Sorin-Jayaweera/Panthalassa-Clinic-Team/review/README.md

# Review notes

Marks and comments that people made on the website. Each one is a GitHub issue; this folder is rebuilt from the
issues by `tools/build_review.py` (GitHub Action "Review notes") every time an issue changes. Do not edit these files by hand.

| File | What | Open |
|---|---|---|
| [validated.md](validated.md) | text a person has checked and confirmed | 0 |
| [under_question.md](under_question.md) | text a person doubts or wants checked | 0 |
| [comments.md](comments.md) | comments | 0 |
| [suggested_changes.md](suggested_changes.md) | wording or numbers a person wants changed | 0 |
| [resolved.md](resolved.md) | closed notes | 0 |

To add one: open https://sorin-jayaweera.github.io/Panthalassa-Clinic-Team/, press Edit, select text, choose a button, and submit
the issue that opens. To withdraw or resolve one, close its issue.
