Sorin-Jayaweera/Panthalassa-Clinic-Team/chaos_scope/BAD_ch2_contains_ch1_packets/chaos_aligned_3s2_125kSps_time_and_spectrum.png

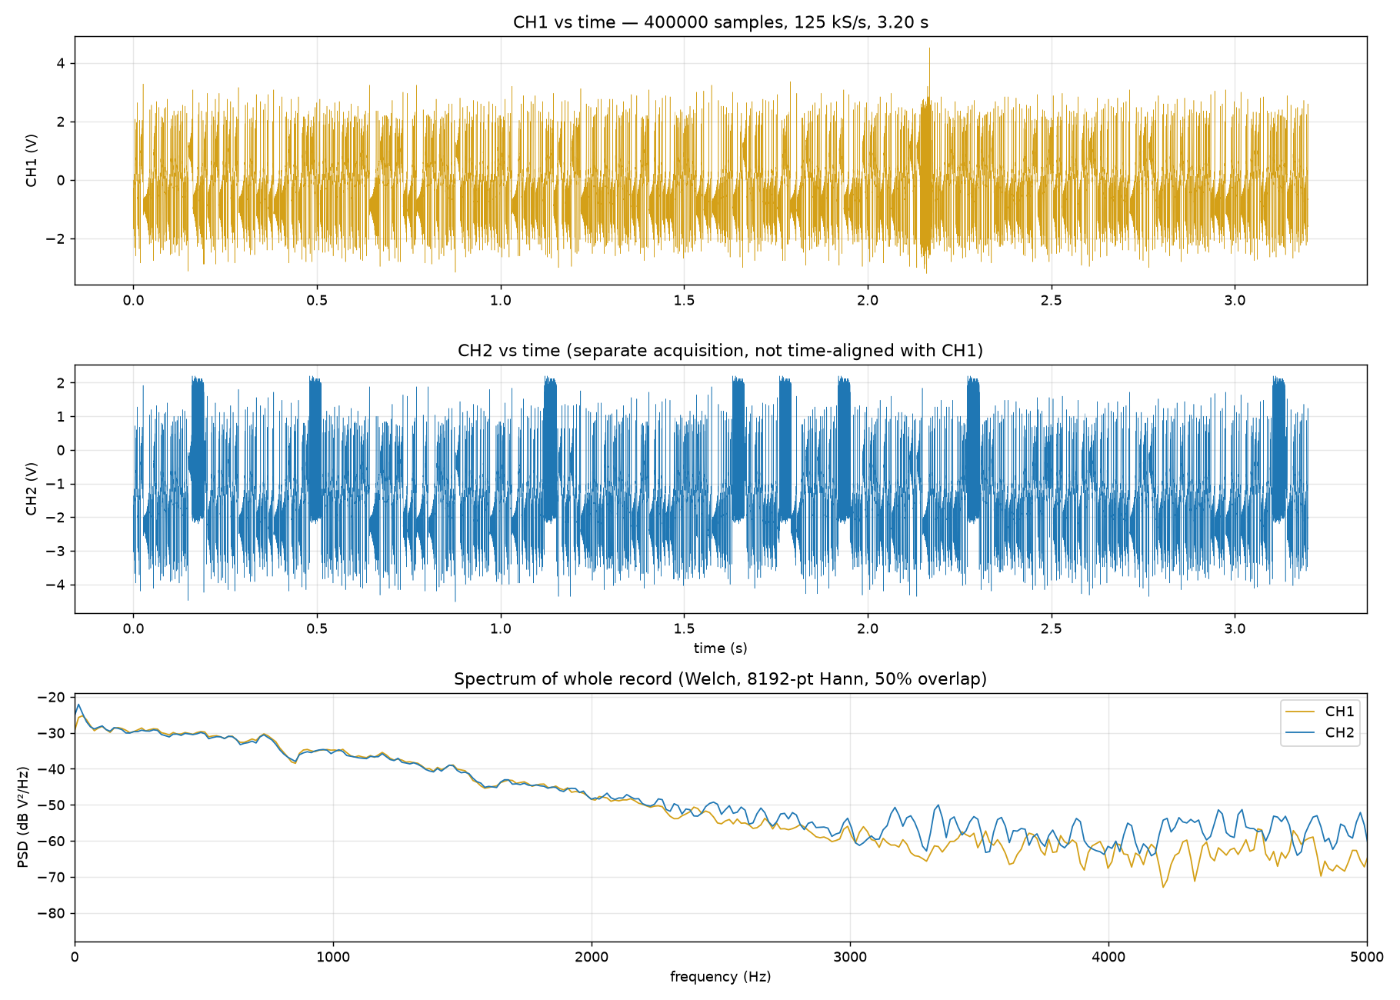
chaos_scope/BAD_ch2_contains_ch1_packets/chaos_aligned_3s2_125kSps_time_and_spectrum.png
