Sorin-Jayaweera/Panthalassa-Clinic-Team/docs/img/pluto_scale_spectra.png

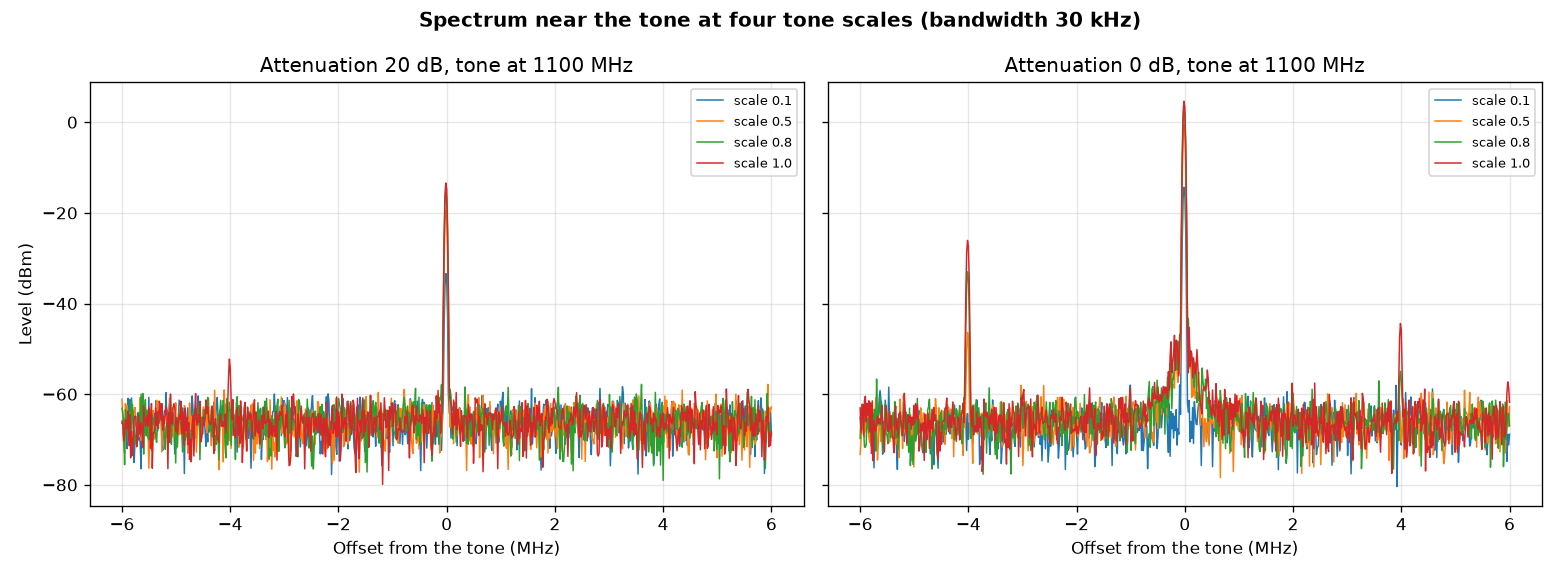
docs/img/pluto_scale_spectra.png
