Sorin-Jayaweera/Panthalassa-Clinic-Team/docs/img/pluto_spectra.png

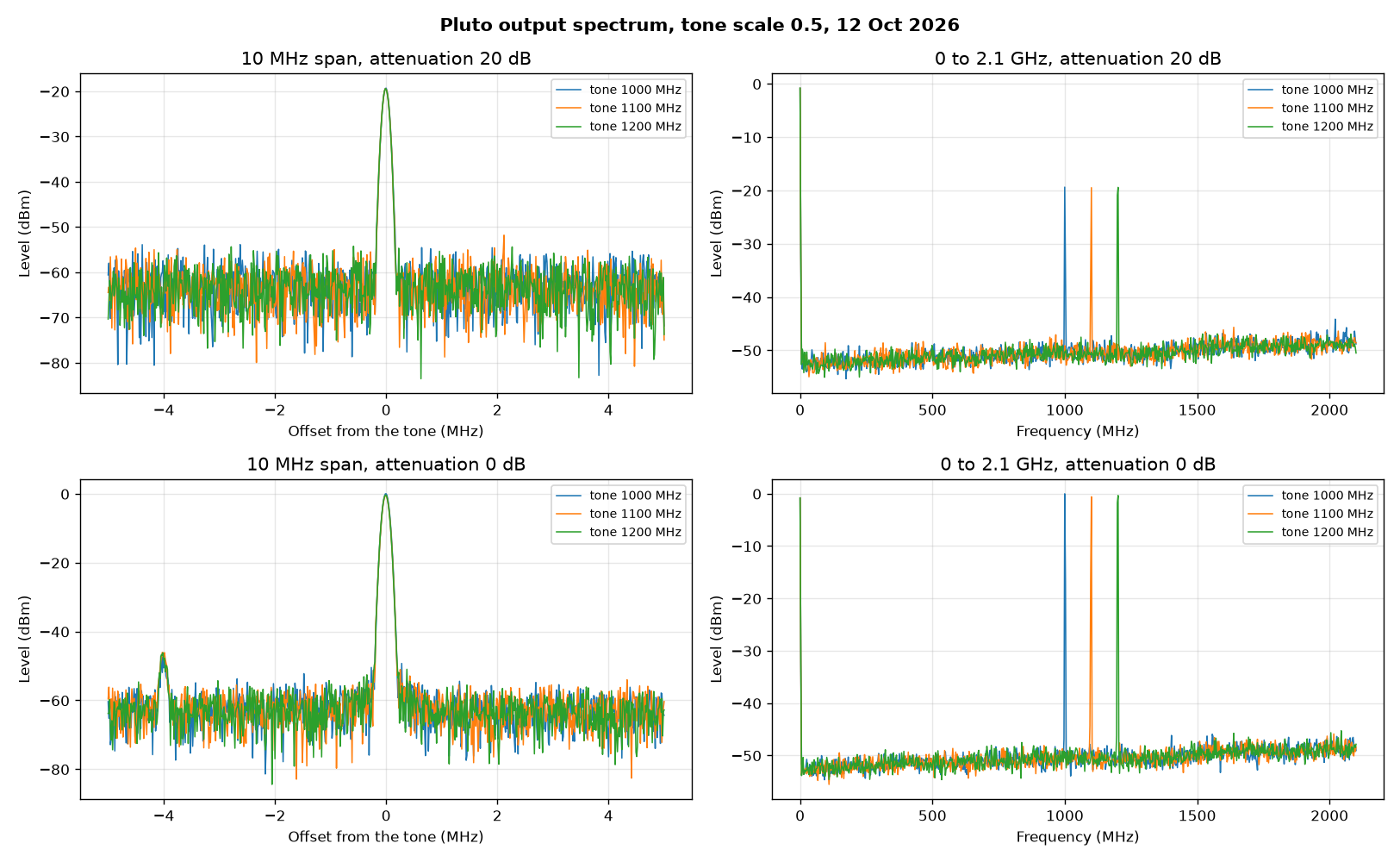
docs/img/pluto_spectra.png
