Sorin-Jayaweera/Panthalassa-Clinic-Team/docs/img/radar_train_spectrogram.png

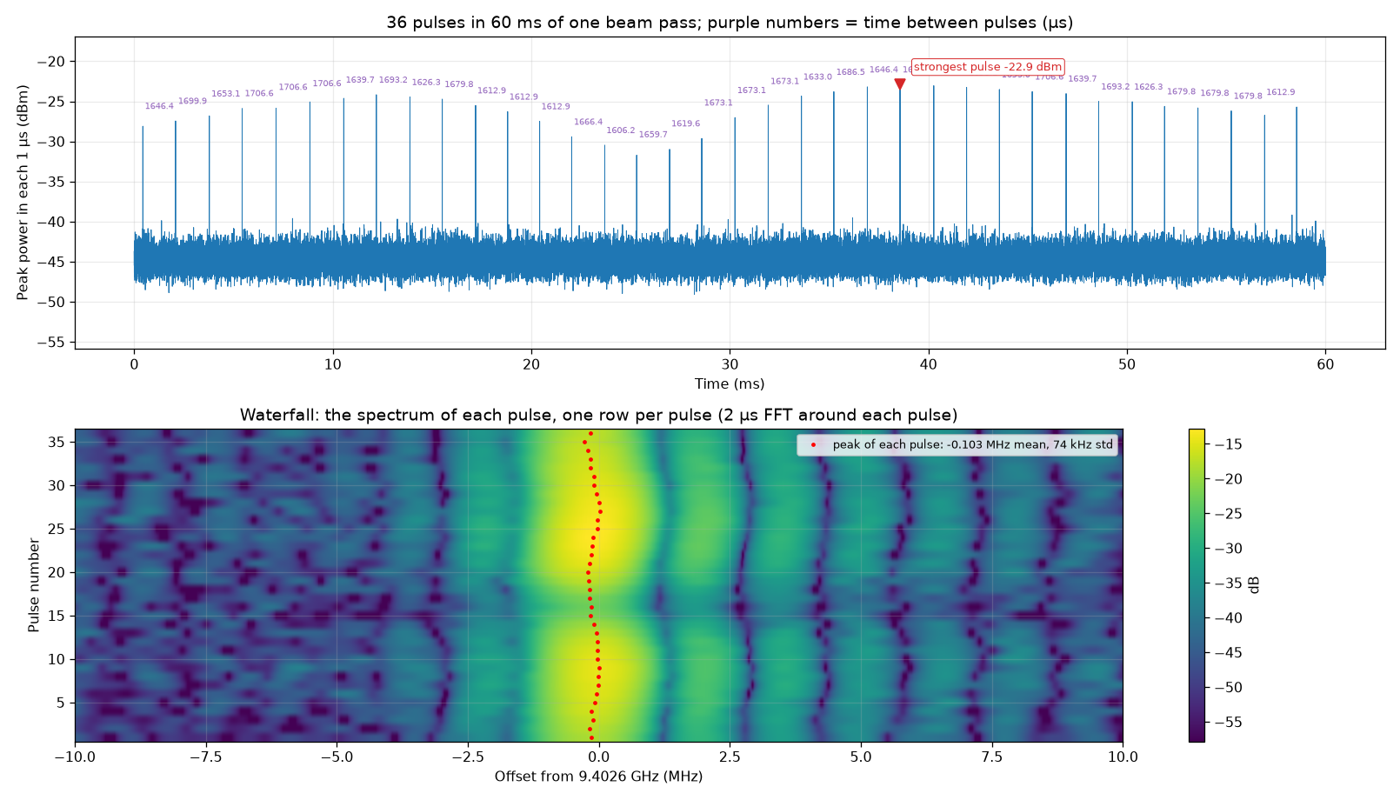
docs/img/radar_train_spectrogram.png
