Sorin-Jayaweera/Panthalassa-Clinic-Team/pluto_characterization/pluto_pulse_spectrum.png

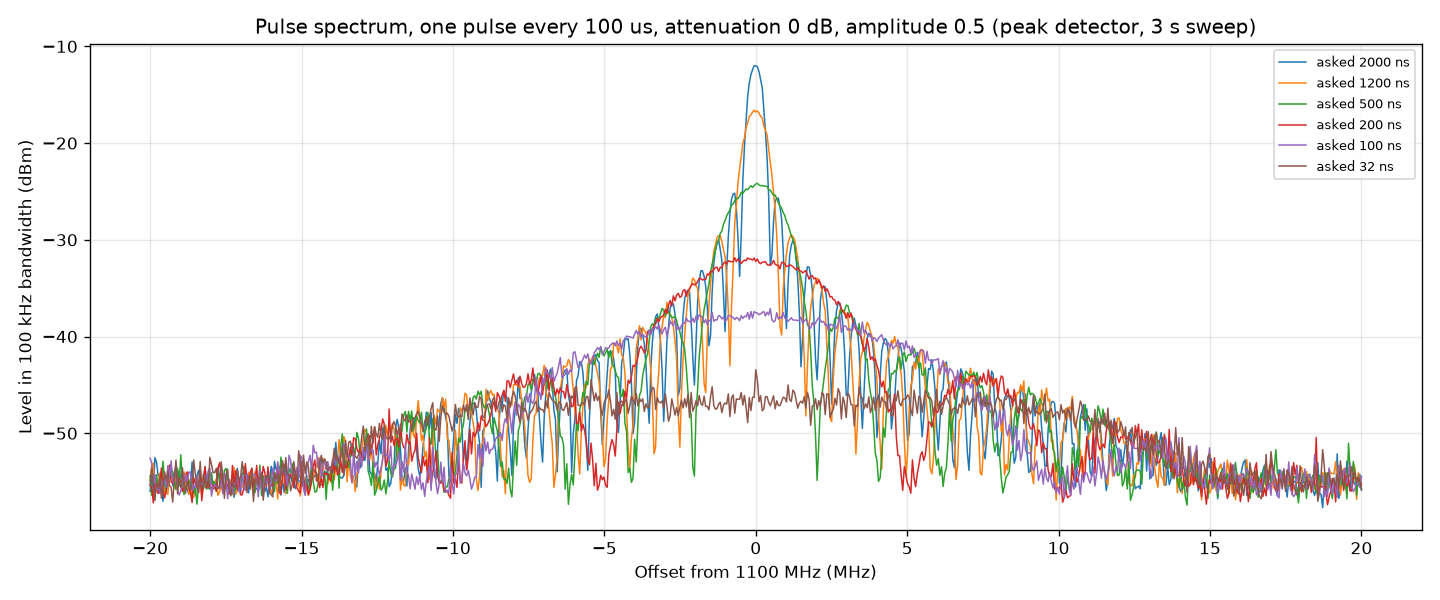
pluto_characterization/pluto_pulse_spectrum.png
