Sorin-Jayaweera/Panthalassa-Clinic-Team/radar_test/plots/pulse_spectrogram.png

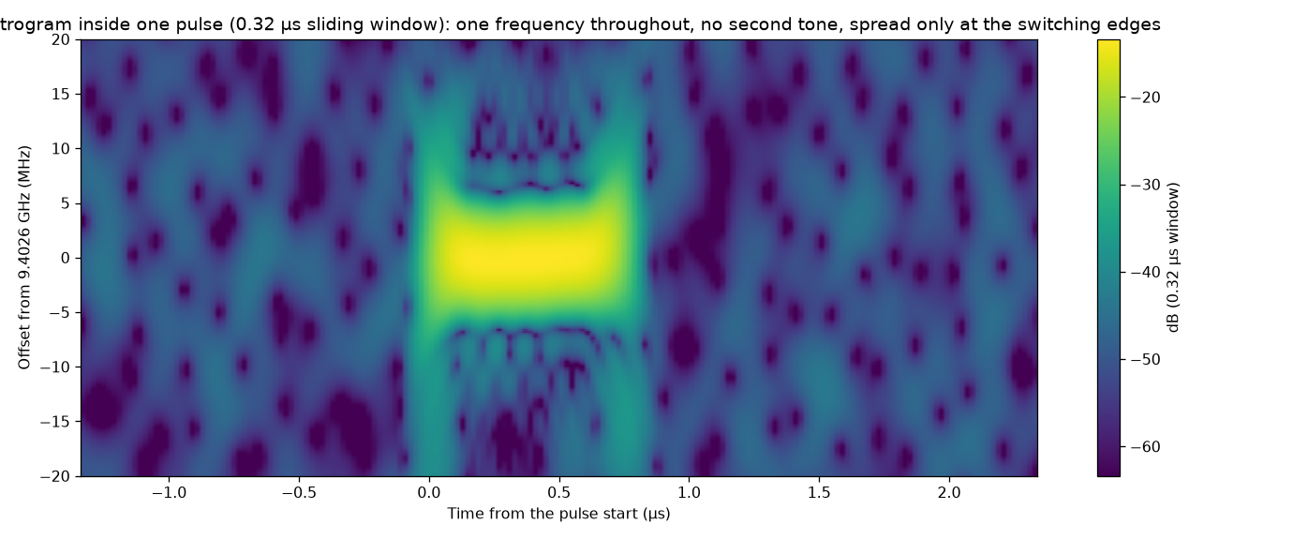
radar_test/plots/pulse_spectrogram.png
