Sorin-Jayaweera/Panthalassa-Clinic-Team/radar_test/spectra_20261025_130335/spectra.png

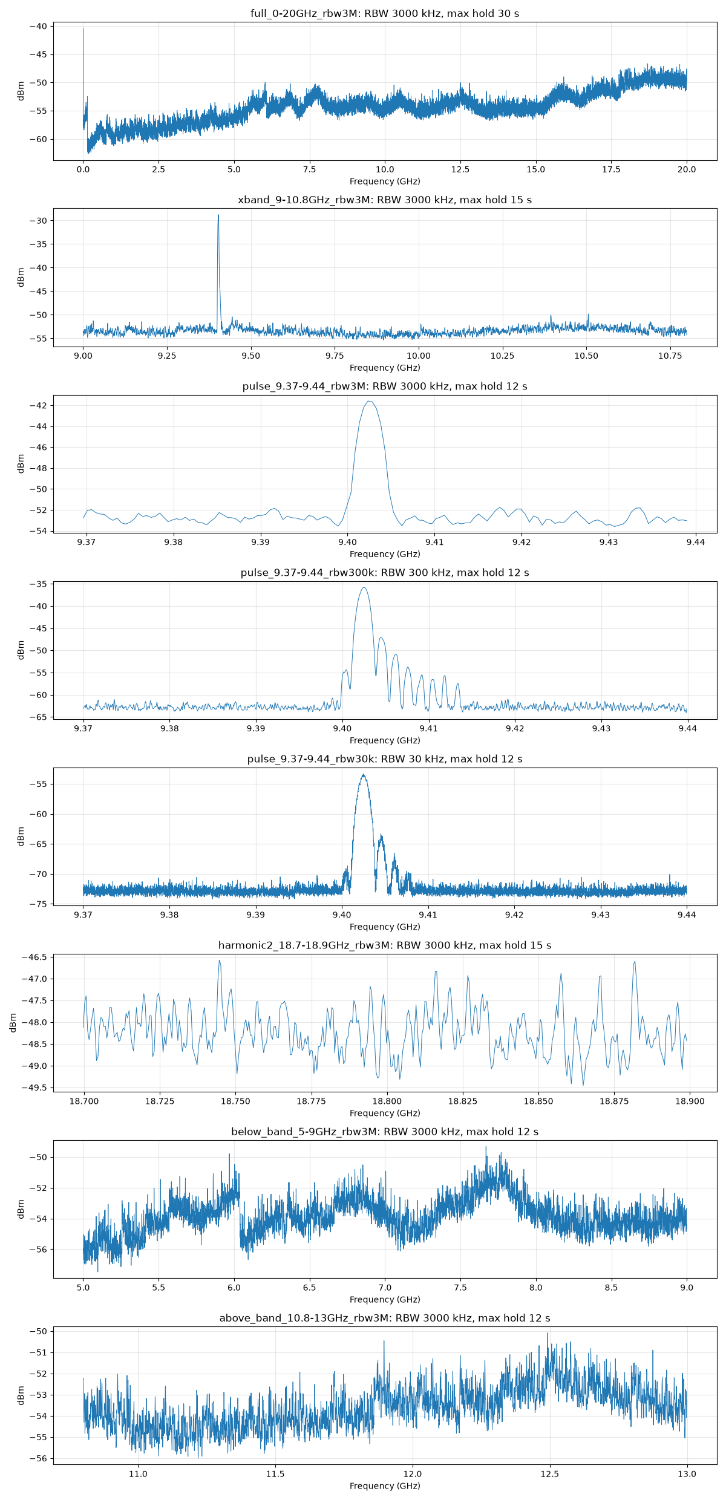
radar_test/spectra_20261025_130335/spectra.png
