Sorin-Jayaweera/Panthalassa-Clinic-Team/simulations/claude/02_delay_line_discriminator/plots/01_sweep_sim_vs_theory.png

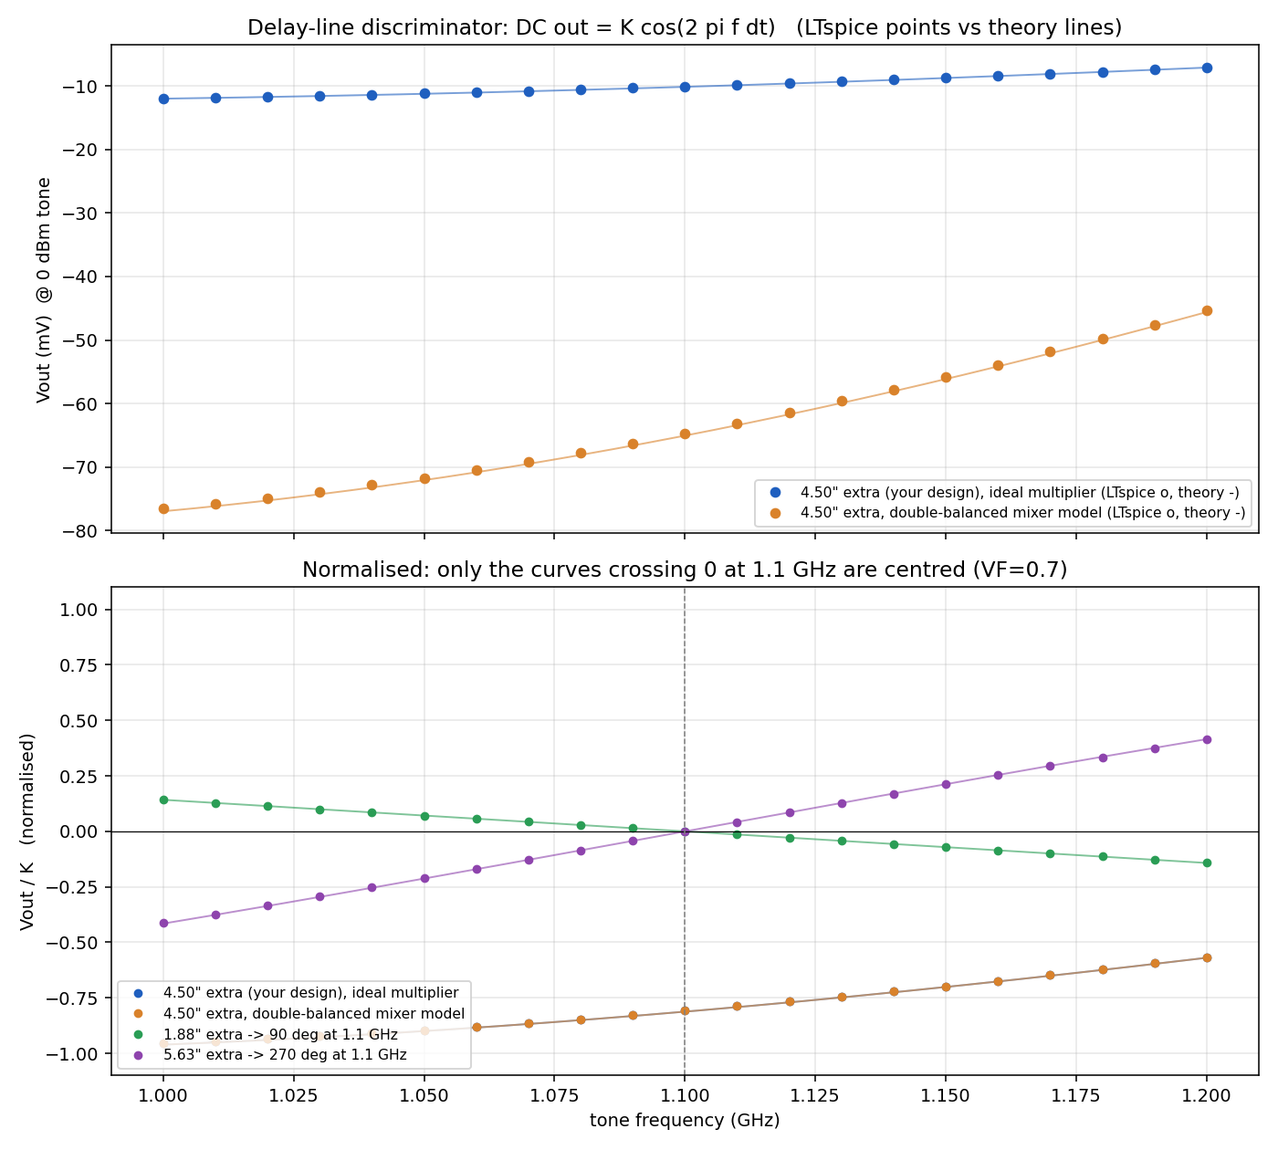
simulations/claude/02_delay_line_discriminator/plots/01_sweep_sim_vs_theory.png
