Sorin-Jayaweera/Panthalassa-Clinic-Team/simulations/claude/02_delay_line_discriminator/plots/04_design_map_cable_length.png

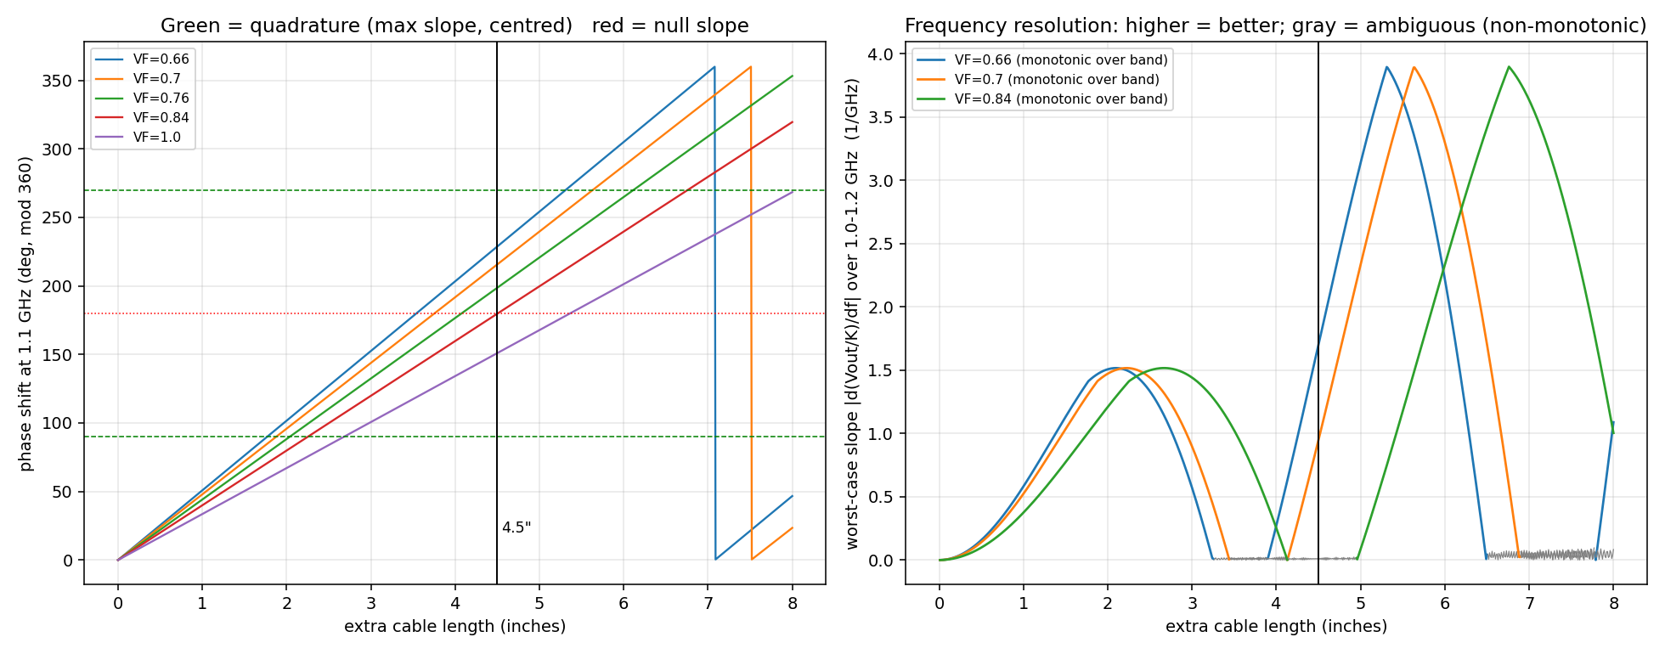
simulations/claude/02_delay_line_discriminator/plots/04_design_map_cable_length.png
