Sorin-Jayaweera/Panthalassa-Clinic-Team/documentation/JACON_component_specs.xlsx

Sheet: Components
Part number | Role | JACON block | Datasheet band | Frequency seen in JACON | Gain / loss at that frequency | Damage limit (as printed on datasheet) | Damage limit (dBm) | Damage limit (mW) | P1dB / compression (dBm) | P1dB (mW) | Notes | Datasheet page | Mini-Circuits PDF | Local PDF copy | Product page | Evidence screenshot
ZX60-5123LN+ | RX LNA | [1] RX front end | 5.5 - 12.5 GHz | 9.3 - 9.5 GHz | +22.0 dB typ (19.0 min), 5.5-12.5 GHz | RF Input Power (CW) +15 dBm | +15.00 | 31.623 | +17.0 | 50.1 | Total power dissipation 1.2 W; DC +12 V | p.3 | ZX60-5123LN+.pdf (https://www.minicircuits.com/pdfs/ZX60-5123LN%2B.pdf) | datasheets/ZX60-5123LN+.pdf | minicircuits.com (https://www.minicircuits.com/WebStore/dashboard.html?model=ZX60-5123LN%2B) | evidence/ZX60-5123LNplus_ratings_p3.png
ZX05-14LH-S+ | RX down-mixer / TX up-mixer | [1] RX mixer, [8] TX mixer | RF+LO 3.7 - 10 GHz, IF DC - 4 GHz | RF 9.3-9.5 GHz, LO 8.3 GHz, IF 1.0-1.2 GHz | conv. loss 7.72 dB typ at RF 9400 MHz (6.7 dB band typ), LO +10 dBm | RF Power 50 mW | +16.99 | 50.003 | +5.0 | 3.2 | Level 10 mixer: LO drive +10 dBm | p.1 | ZX05-14LH-S+.pdf (https://www.minicircuits.com/pdfs/ZX05-14LH-S%2B.pdf) | datasheets/ZX05-14LH-S+.pdf | minicircuits.com (https://www.minicircuits.com/WebStore/dashboard.html?model=ZX05-14LH-S%2B) | evidence/ZX05-14LH-Splus_ratings_p1.png
ZX60-14012L-S+ | LO buffer amplifier | [2] LO chain | 0.3 MHz - 14 GHz | 8.3 GHz | 12.55 dB at 8.0 GHz, 11.85 dB at 9.0 GHz -> approx 12.3 dB at 8.3 GHz | Input Power (no Damage) 10 dBm | +10.00 | 10.000 | +11.0 | 12.6 | Band-wide spec is +12 dB typ / 9 dB min; the page 2 table gives 12.55 dB at 8 GHz. NF 5.35 dB at 8 GHz | p.1 | ZX60-14012L-S+.pdf (https://www.minicircuits.com/pdfs/ZX60-14012L-S%2B.pdf) | datasheets/ZX60-14012L-S+.pdf | minicircuits.com (https://www.minicircuits.com/WebStore/dashboard.html?model=ZX60-14012L-S%2B) | evidence/ZX60-14012L-Splus_ratings_p1.png
ZX10-2-1252-S+ | LO 2-way splitter (DC pass) | [2] LO split to both mixers | 1800 - 12500 MHz | 8.3 GHz | -3.0 dB split + 0.7 dB typ insertion loss | Power Input (as a splitter) 1.85 W | +32.67 | 1849.269 | passive - n/a | n/a | Internal dissipation 0.85 W max; DC current 0.4 A max | p.2 | ZX10-2-1252-S+.pdf (https://www.minicircuits.com/pdfs/ZX10-2-1252-S%2B.pdf) | datasheets/ZX10-2-1252-S+.pdf | minicircuits.com (https://www.minicircuits.com/WebStore/dashboard.html?model=ZX10-2-1252-S%2B) | evidence/ZX10-2-1252-Splus_ratings_p2.png
ZX60-P162LN+ | IF amplifier (preferred for 1.0-1.2 GHz) | [3] IF chain | 0.7 - 1.6 GHz | 1.0 - 1.2 GHz | 21.81 dB at 1.1 GHz (22.49 at 1.0, 21.12 at 1.2 GHz) | Input RF Power (No Damage) VD=+4 V: +25 dBm | +25.00 | 316.228 | +19.9 | 97.7 | Noise figure 0.52 dB typ at 1.0 GHz; power consumption 0.55 W | p.2 | ZX60-P162LN+.pdf (https://www.minicircuits.com/pdfs/ZX60-P162LN%2B.pdf) | datasheets/ZX60-P162LN+.pdf | minicircuits.com (https://www.minicircuits.com/WebStore/dashboard.html?model=ZX60-P162LN%2B) | evidence/ZX60-P162LNplus_ratings_p2.png
ZX60-P103LN+ | IF amplifier (wideband alternate) | [3] IF chain (alternate) | 50 - 3000 MHz | 1.0 - 1.2 GHz | +15.6 dB typ at 1000 MHz (13.5 min) | Input RF Power (no damage): 21 dBm (50-2000 MHz), 26 dBm (2000-3000 MHz) | +21.00 | 125.893 | +22.4 | 173.8 | Noise figure 0.5 dB typ at 1000 MHz; power consumption 0.66 W | p.3 | ZX60-P103LN+.pdf (https://www.minicircuits.com/pdfs/ZX60-P103LN%2B.pdf) | datasheets/ZX60-P103LN+.pdf | minicircuits.com (https://www.minicircuits.com/WebStore/dashboard.html?model=ZX60-P103LN%2B) | evidence/ZX60-P103LNplus_ratings_p3.png
ZX60-2534MA-S+ | IF amplifier (high gain alternate) | [3] IF chain (alternate) | 0.5 - 2.5 GHz | 1.0 - 1.2 GHz | +43.5 dB typ at 1.0 GHz (at VD = 5 V) | Input Power (no damage) -15 dBm | -+15.00 | 0.032 | +19.0 | 79.4 | LOWEST damage limit of any part here. Power dissipation 0.5 W; DC 5 V | p.1 | ZX60-2534MA-S+.pdf (https://www.minicircuits.com/pdfs/ZX60-2534MA-S%2B.pdf) | datasheets/ZX60-2534MA-S+.pdf | minicircuits.com (https://www.minicircuits.com/WebStore/dashboard.html?model=ZX60-2534MA-S%2B) | evidence/ZX60-2534MA-Splus_ratings_p1.png
ZFRSC-42-S+ | Resistive 2-way splitter (IF split and delay-line split) | [3] IF split, [6] delay-line split | DC - 4200 MHz | 1.0 - 1.2 GHz | -6.0 dB total loss (5.99 / 6.02 dB at 1000 MHz) | Power Input (as a splitter) 0.75 W | +28.75 | 749.894 | passive - n/a | n/a | Internal dissipation 0.375 W max. Resistive: isolation equals insertion loss (~6 dB) | p.1 | ZFRSC-42-S+.pdf (https://www.minicircuits.com/pdfs/ZFRSC-42-S%2B.pdf) | datasheets/ZFRSC-42-S+.pdf | minicircuits.com (https://www.minicircuits.com/WebStore/dashboard.html?model=ZFRSC-42-S%2B) | evidence/ZFRSC-42-Splus_ratings_p1.png
ZX05-30W-S+ | Phase detector (delay-line mixer) | [6] phase detector | RF+LO 300 - 4000 MHz, IF DC - 950 MHz | RF+LO 1.0-1.2 GHz, IF = DC | conv. loss 6.22 dB typ at RF 944 MHz (6.8 dB band typ), LO +7 dBm | RF Power 50 mW | +16.99 | 50.003 | +1.0 | 1.3 | Level 7 mixer: LO drive +7 dBm. IF current 40 mA max | p.1 | ZX05-30W-S+.pdf (https://www.minicircuits.com/pdfs/ZX05-30W-S%2B.pdf) | datasheets/ZX05-30W-S+.pdf | minicircuits.com (https://www.minicircuits.com/WebStore/dashboard.html?model=ZX05-30W-S%2B) | evidence/ZX05-30W-Splus_ratings_p1.png
Damage limit = the level that destroys the part (absolute maximum rating). P1dB = where it stops being linear, well below damage. mW columns are formulas: =10^(dBm/10).
Every value was extracted from the PDF in datasheets/ at the page in column M. Orange row = lowest damage limit in the set; see the Headroom tab.

Sheet: Headroom
Part | Expected worst-case input | Expected level (dBm) | Damage limit (dBm) | Margin (dB) | Verdict | Action
ZX60-5123LN+ (LNA) | limiter output while the limiter clamps | +16.3 | +15.0 | -+1.3 | OVER LIMIT | Keep the in-line attenuator the drawing calls for.
ZX05-14LH-S+ (RX mixer) | LNA saturated output at close range | +17.5 | +17.0 | -+0.5 | OVER LIMIT | Marginal at close range; the same pad fixes this.
ZX60-P162LN+ (IF amp) | mixer IF output, worst case | +11.0 | +25.0 | +14.0 | OK | Fine.
ZX60-P103LN+ (IF amp) | mixer IF output, worst case | +11.0 | +21.0 | +10.0 | OK | Fine.
ZX60-2534MA-S+ (IF amp) | mixer IF output, worst case | +11.0 | -+15.0 | -+26.0 | OVER LIMIT | Do not put this straight after the mixer.
ZFRSC-42-S+ (both units) | IF amp output, saturated | +20.0 | +28.8 | +8.8 | OK | Fine.
ZX05-30W-S+ (phase detector) | limiting-amp chain, per port | +8.0 | +17.0 | +9.0 | OK | Above the +1 dBm compression point, which is intended here.
ZX60-14012L-S+ (LO buffer) | PLL output (assumed +3 dBm) | +3.0 | +10.0 | +7.0 | OK | Confirm your ADF5355 output level.
ZX10-2-1252-S+ (LO splitter) | LO buffer output | +14.0 | +32.7 | +18.7 | OK | Fine.
Expected levels are simulated (LTspice, simulations/claude/01_jacon_system), not measured. Margin and verdict are formulas, so edit column C with your own measured levels and the verdicts update.

Sheet: Evidence
Part number | What it proves | Datasheet page | Screenshot file | Source PDF (online) | Local PDF copy
ZX60-5123LN+ | ABSOLUTE MAXIMUM RATINGS: RF Input Power (CW) = +15 dBm | 3 | evidence/ZX60-5123LNplus_ratings_p3.png | ZX60-5123LN+.pdf (https://www.minicircuits.com/pdfs/ZX60-5123LN%2B.pdf) | datasheets/ZX60-5123LN+.pdf
ZX60-5123LN+ | ELECTRICAL SPECIFICATIONS: gain 22.0 dB typ, P1dB +17.0 dBm typ | 1 | evidence/ZX60-5123LNplus_compression_p1.png | ZX60-5123LN+.pdf (https://www.minicircuits.com/pdfs/ZX60-5123LN%2B.pdf) | datasheets/ZX60-5123LN+.pdf
ZX05-14LH-S+ | Maximum Ratings: RF Power = 50 mW | 1 | evidence/ZX05-14LH-Splus_ratings_p1.png | ZX05-14LH-S+.pdf (https://www.minicircuits.com/pdfs/ZX05-14LH-S%2B.pdf) | datasheets/ZX05-14LH-S+.pdf
ZX05-14LH-S+ | 1 dB COMPR.: +5 dBm typ (LO +10 dBm) | 1 | evidence/ZX05-14LH-Splus_compression_p1.png | ZX05-14LH-S+.pdf (https://www.minicircuits.com/pdfs/ZX05-14LH-S%2B.pdf) | datasheets/ZX05-14LH-S+.pdf
ZX05-14LH-S+ | Typical Performance Data: conversion loss 7.72 dB at RF 9400 MHz (band typ is 6.7 dB) | 1 | evidence/ZX05-14LH-Splus_typperf_p1.png | ZX05-14LH-S+.pdf (https://www.minicircuits.com/pdfs/ZX05-14LH-S%2B.pdf) | datasheets/ZX05-14LH-S+.pdf
ZX60-14012L-S+ | Maximum Ratings: Input Power (no Damage) = 10 dBm | 1 | evidence/ZX60-14012L-Splus_ratings_p1.png | ZX60-14012L-S+.pdf (https://www.minicircuits.com/pdfs/ZX60-14012L-S%2B.pdf) | datasheets/ZX60-14012L-S+.pdf
ZX60-14012L-S+ | Electrical Specifications: gain 12 dB typ, output P1dB +11 dBm typ | 1 | evidence/ZX60-14012L-Splus_compression_p1.png | ZX60-14012L-S+.pdf (https://www.minicircuits.com/pdfs/ZX60-14012L-S%2B.pdf) | datasheets/ZX60-14012L-S+.pdf
ZX60-14012L-S+ | Typical Performance Data: 12.55 dB gain at 8000 MHz, 11.85 dB at 9000 MHz (8.3 GHz falls between) | 2 | evidence/ZX60-14012L-Splus_typperf_p2.png | ZX60-14012L-S+.pdf (https://www.minicircuits.com/pdfs/ZX60-14012L-S%2B.pdf) | datasheets/ZX60-14012L-S+.pdf
ZX10-2-1252-S+ | Maximum Ratings: Power Input (as a splitter) = 1.85 W | 2 | evidence/ZX10-2-1252-Splus_ratings_p2.png | ZX10-2-1252-S+.pdf (https://www.minicircuits.com/pdfs/ZX10-2-1252-S%2B.pdf) | datasheets/ZX10-2-1252-S+.pdf
ZX60-P162LN+ | ABSOLUTE MAXIMUM RATINGS: Input RF Power (No Damage) = +25 dBm | 2 | evidence/ZX60-P162LNplus_ratings_p2.png | ZX60-P162LN+.pdf (https://www.minicircuits.com/pdfs/ZX60-P162LN%2B.pdf) | datasheets/ZX60-P162LN+.pdf
ZX60-P162LN+ | ELECTRICAL SPECIFICATIONS: gain and output P1dB vs frequency | 2 | evidence/ZX60-P162LNplus_compression_p2.png | ZX60-P162LN+.pdf (https://www.minicircuits.com/pdfs/ZX60-P162LN%2B.pdf) | datasheets/ZX60-P162LN+.pdf
ZX60-P162LN+ | Typical Performance Data: 21.81 dB gain and +19.9 dBm P1dB at 1100 MHz | 4 | evidence/ZX60-P162LNplus_typperf_p4.png | ZX60-P162LN+.pdf (https://www.minicircuits.com/pdfs/ZX60-P162LN%2B.pdf) | datasheets/ZX60-P162LN+.pdf
ZX60-P103LN+ | ABSOLUTE MAXIMUM RATINGS: Input RF Power (no damage) = 21 dBm at 50-2000 MHz | 3 | evidence/ZX60-P103LNplus_ratings_p3.png | ZX60-P103LN+.pdf (https://www.minicircuits.com/pdfs/ZX60-P103LN%2B.pdf) | datasheets/ZX60-P103LN+.pdf
ZX60-P103LN+ | ELECTRICAL SPECIFICATIONS: gain 15.6 dB typ and P1dB +22.4 dBm typ at 1000 MHz | 2 | evidence/ZX60-P103LNplus_compression_p2.png | ZX60-P103LN+.pdf (https://www.minicircuits.com/pdfs/ZX60-P103LN%2B.pdf) | datasheets/ZX60-P103LN+.pdf
ZX60-2534MA-S+ | Maximum Ratings: Input Power (no damage) = -15 dBm | 1 | evidence/ZX60-2534MA-Splus_ratings_p1.png | ZX60-2534MA-S+.pdf (https://www.minicircuits.com/pdfs/ZX60-2534MA-S%2B.pdf) | datasheets/ZX60-2534MA-S+.pdf
ZX60-2534MA-S+ | Electrical Specifications: gain over frequency, output P1dB | 1 | evidence/ZX60-2534MA-Splus_compression_p1.png | ZX60-2534MA-S+.pdf (https://www.minicircuits.com/pdfs/ZX60-2534MA-S%2B.pdf) | datasheets/ZX60-2534MA-S+.pdf
ZFRSC-42-S+ | Maximum Ratings: Power Input (as a splitter) = 0.75 W, internal dissipation 0.375 W | 1 | evidence/ZFRSC-42-Splus_ratings_p1.png | ZFRSC-42-S+.pdf (https://www.minicircuits.com/pdfs/ZFRSC-42-S%2B.pdf) | datasheets/ZFRSC-42-S+.pdf
ZX05-30W-S+ | Maximum Ratings: RF Power = 50 mW, IF Current = 40 mA | 1 | evidence/ZX05-30W-Splus_ratings_p1.png | ZX05-30W-S+.pdf (https://www.minicircuits.com/pdfs/ZX05-30W-S%2B.pdf) | datasheets/ZX05-30W-S+.pdf
ZX05-30W-S+ | 1 dB COMP.: +1 dBm typ; conversion loss 6.8 dB typ at LO +7 dBm | 1 | evidence/ZX05-30W-Splus_compression_p1.png | ZX05-30W-S+.pdf (https://www.minicircuits.com/pdfs/ZX05-30W-S%2B.pdf) | datasheets/ZX05-30W-S+.pdf
ZX05-30W-S+ | Typical Performance Data: conversion loss 6.22 dB at RF 944 MHz, closest tabulated point to our 1.0-1.2 GHz | 1 | evidence/ZX05-30W-Splus_typperf_p1.png | ZX05-30W-S+.pdf (https://www.minicircuits.com/pdfs/ZX05-30W-S%2B.pdf) | datasheets/ZX05-30W-S+.pdf
Each screenshot was cropped directly from the PDF in datasheets/ at the listed page. Open the PDF at that page to check the value yourself.
