Sorin-Jayaweera/Panthalassa-Clinic-Team/radar_test/racon/plots/seg_radar_20261109_190354_parts.png

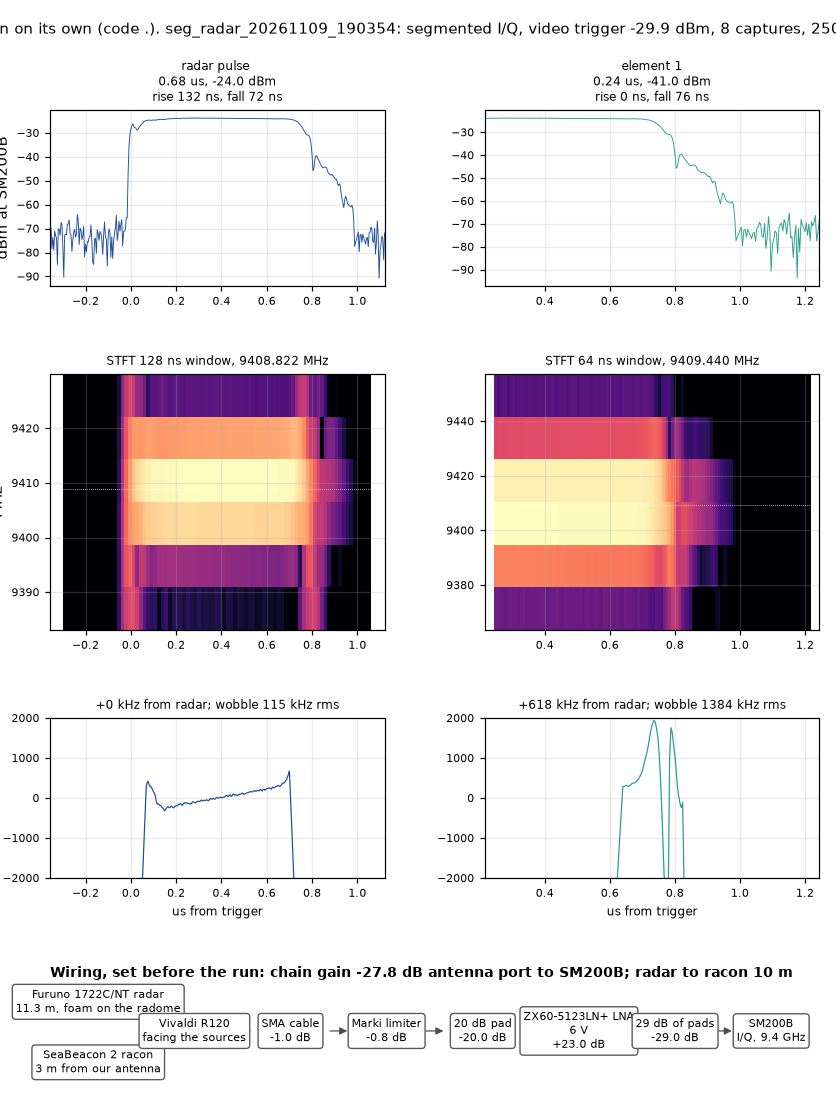
radar_test/racon/plots/seg_radar_20261109_190354_parts.png
