Sorin-Jayaweera/Panthalassa-Clinic-Team/cad/foam_enclosure/foam_enclosure.SLDPRT

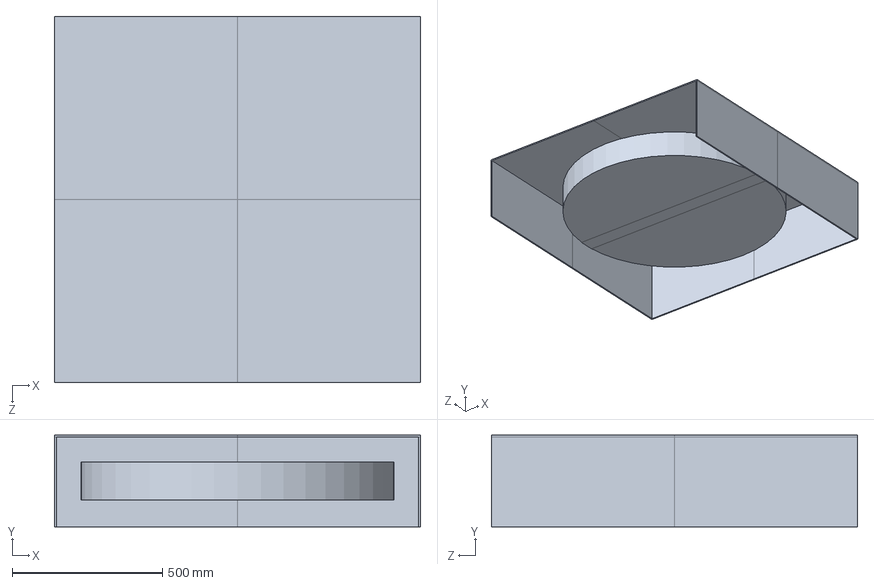
[picture p40: CAD file, 2026-10-25]
cad/foam_enclosure/foam_enclosure.SLDPRT
1219.2 x 304.8 x 1219.2 mm
