Sorin-Jayaweera/Panthalassa-Clinic-Team/phase_detector_calibration/deconvolution/deconvolved_step_response.csv

time_ns | deconvolved_step | ideal_step_through_7MHz_band
-298 | -0.00058757 | -3.6493e-17
-296 | -0.00071437 | -3.6274e-17
-294 | -0.00084246 | -3.6691e-17
-292 | -0.00097034 | -3.6675e-17
-290 | -0.0010964 | -3.6491e-17
-288 | -0.0012189 | -3.6615e-17
-286 | -0.001336 | -3.6837e-17
-284 | -0.001446 | -3.7177e-17
-282 | -0.0015468 | -3.7026e-17
-280 | -0.0016367 | -3.7854e-17
-278 | -0.0017135 | -3.8212e-17
-276 | -0.0017755 | -3.8564e-17
-274 | -0.0018209 | -3.913e-17
-272 | -0.0018477 | -3.9112e-17
-270 | -0.0018545 | -3.8587e-17
-268 | -0.0018396 | -3.8633e-17
-266 | -0.0018019 | -3.9413e-17
-264 | -0.0017403 | -3.902e-17
-262 | -0.0016538 | -3.9443e-17
-260 | -0.0015419 | -3.8863e-17
-258 | -0.0014044 | -3.951e-17
-256 | -0.0012414 | -3.9672e-17
-254 | -0.0010532 | -4.0015e-17
-252 | -0.00084071 | -4.0249e-17
-250 | -0.00060508 | -3.9848e-17
-248 | -0.00034791 | -4.0567e-17
-246 | -7.1179e-05 | -4.0416e-17
-244 | 0.00022272 | -4.0877e-17
-242 | 0.000531 | -4.1314e-17
-240 | 0.00085052 | -4.2271e-17
-238 | 0.0011778 | -4.2655e-17
-236 | 0.0015089 | -4.224e-17
-234 | 0.0018397 | -4.0727e-17
-232 | 0.0021658 | -3.8545e-17
-230 | 0.0024827 | -3.5801e-17
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
