Sorin-Jayaweera/Panthalassa-Clinic-Team/cad/foam_enclosure/sheet2_assembly.png

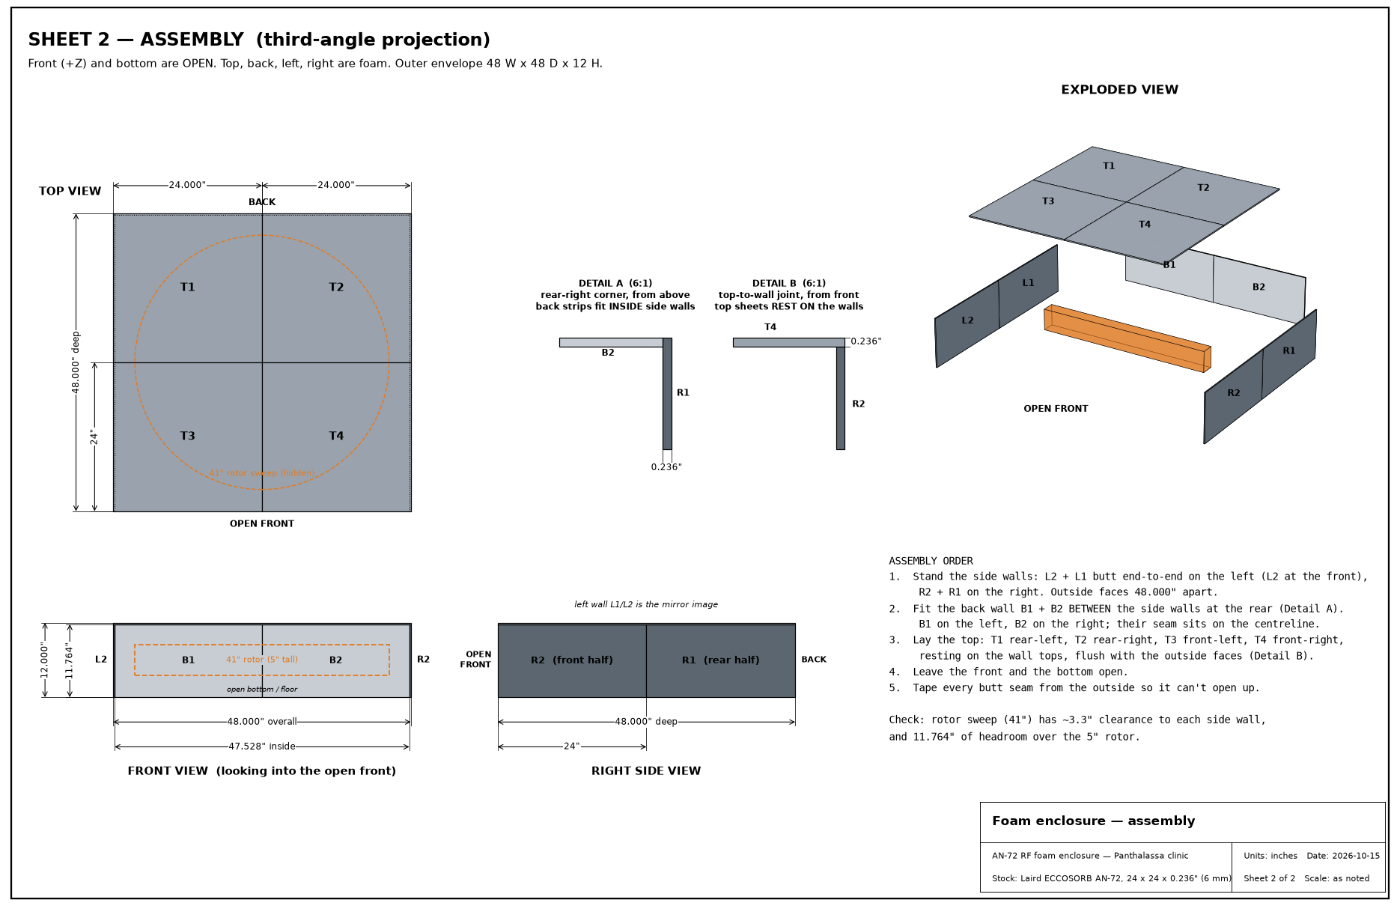
cad/foam_enclosure/sheet2_assembly.png
