Sorin-Jayaweera/Panthalassa-Clinic-Team/docs/img/vna_mixer30W_IFport1_RFport2_LOopen_setup.png

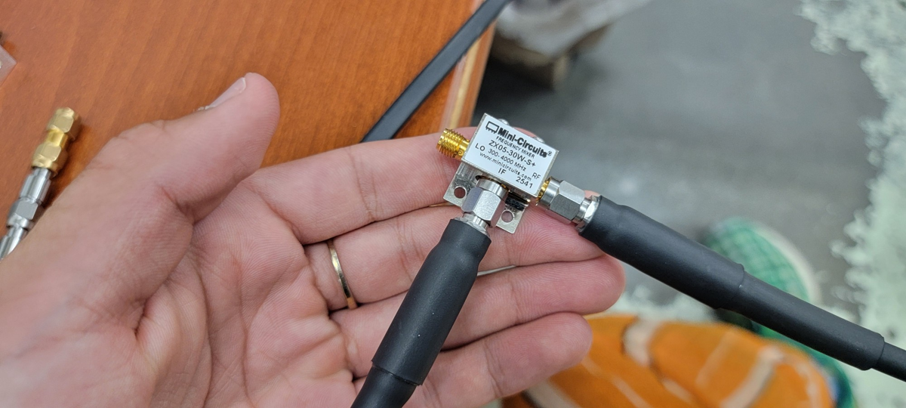
docs/img/vna_mixer30W_IFport1_RFport2_LOopen_setup.png
