Sorin-Jayaweera/Panthalassa-Clinic-Team/docs/img/vna_mixer30W_LOport1_RFport2_setup.png

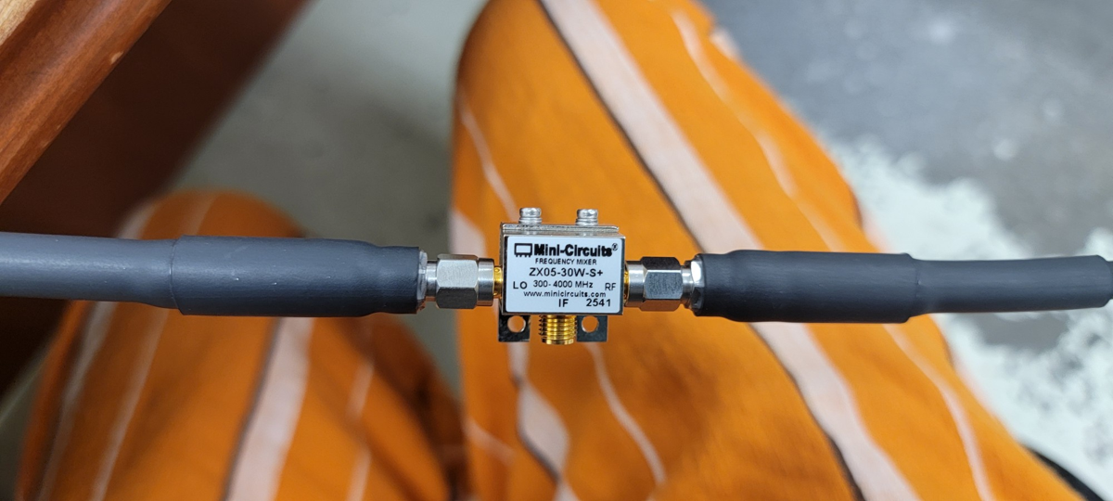
docs/img/vna_mixer30W_LOport1_RFport2_setup.png
