Sorin-Jayaweera/Panthalassa-Clinic-Team/docs/racon_iq/wiring.png

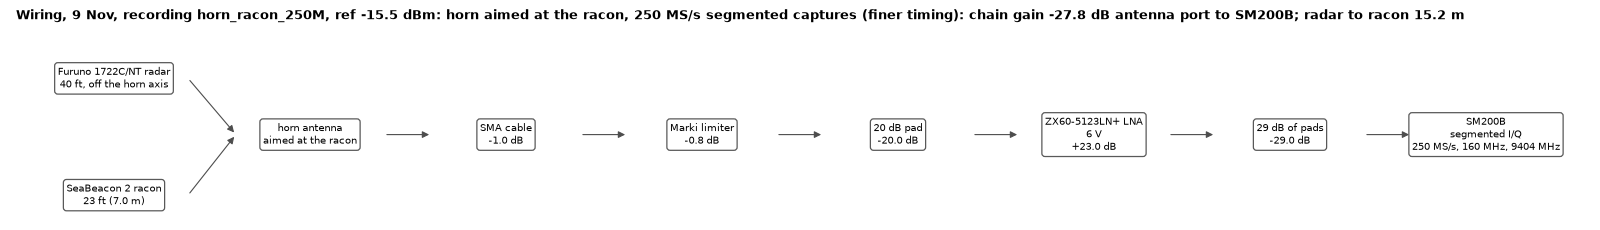
docs/racon_iq/wiring.png
