Sorin-Jayaweera/Panthalassa-Clinic-Team/phase_detector_calibration/COMPARISON_good_vs_bad_setup.png

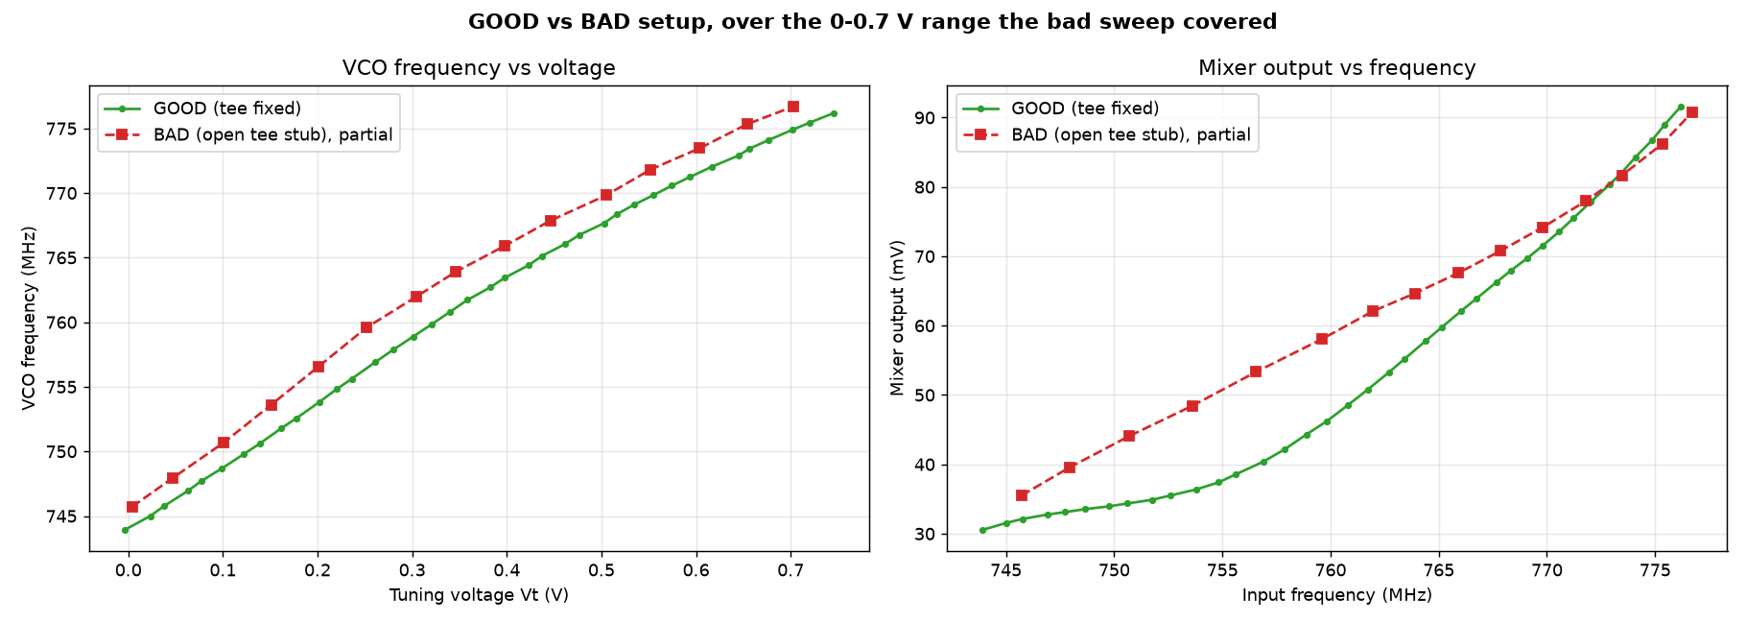
phase_detector_calibration/COMPARISON_good_vs_bad_setup.png
