Sorin-Jayaweera/Panthalassa-Clinic-Team/phase_detector_calibration/step_response/20261010_182707/step_response_fall.png

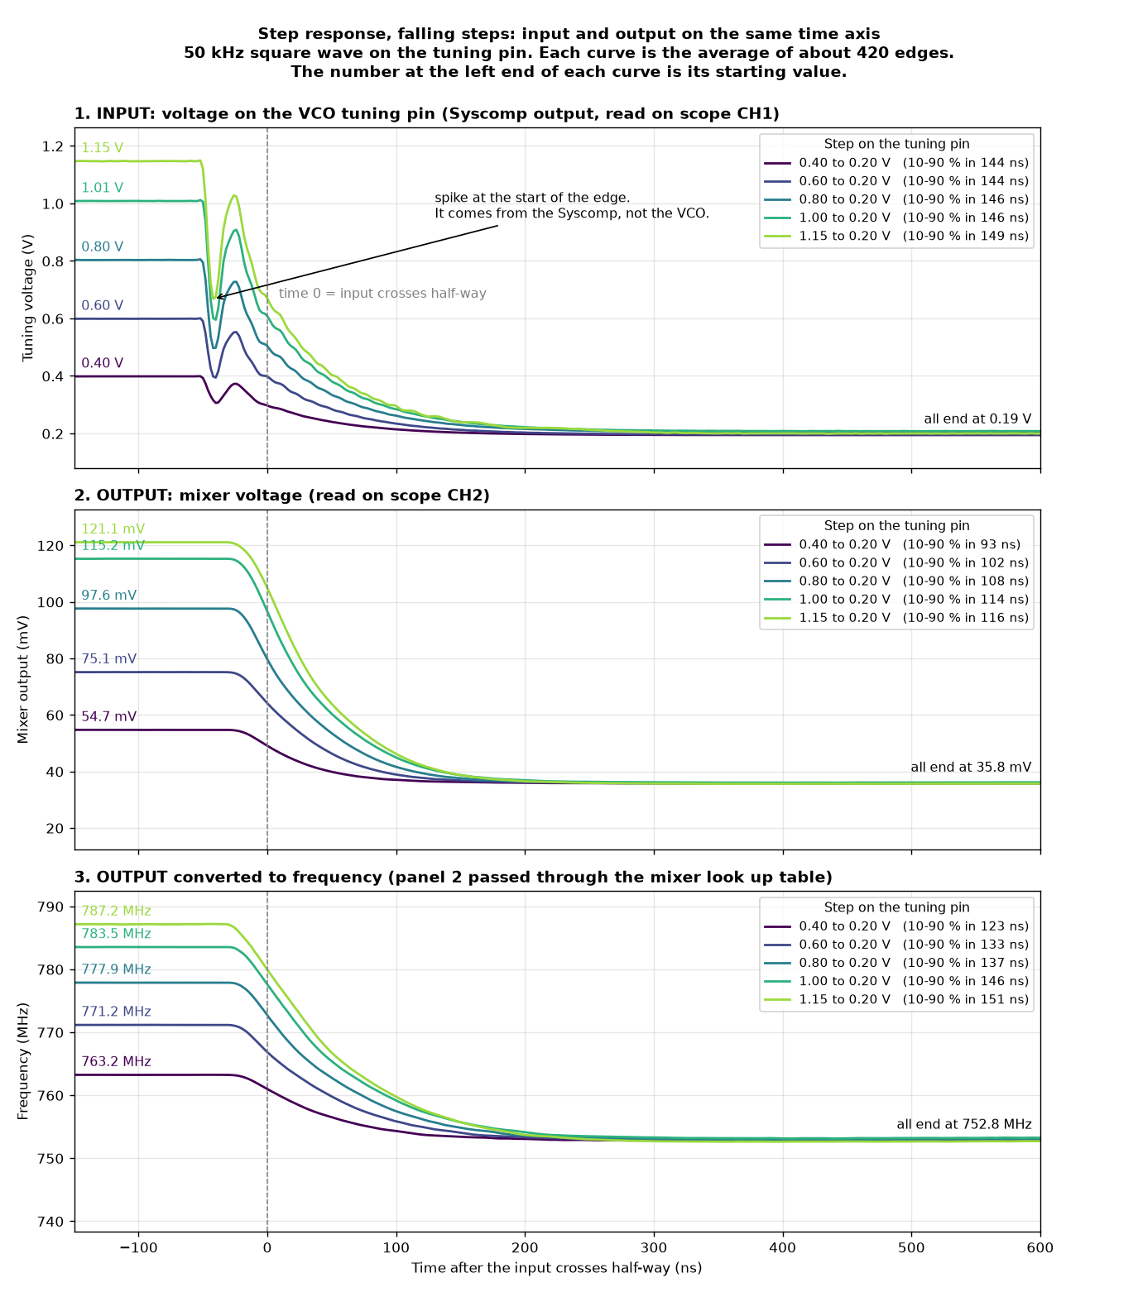
phase_detector_calibration/step_response/20261010_182707/step_response_fall.png
