Sorin-Jayaweera/Panthalassa-Clinic-Team/radar_test/spike_screens/step1_no_limiter_foam_off_29dB_pads_11m_rbw3MHz.jpg

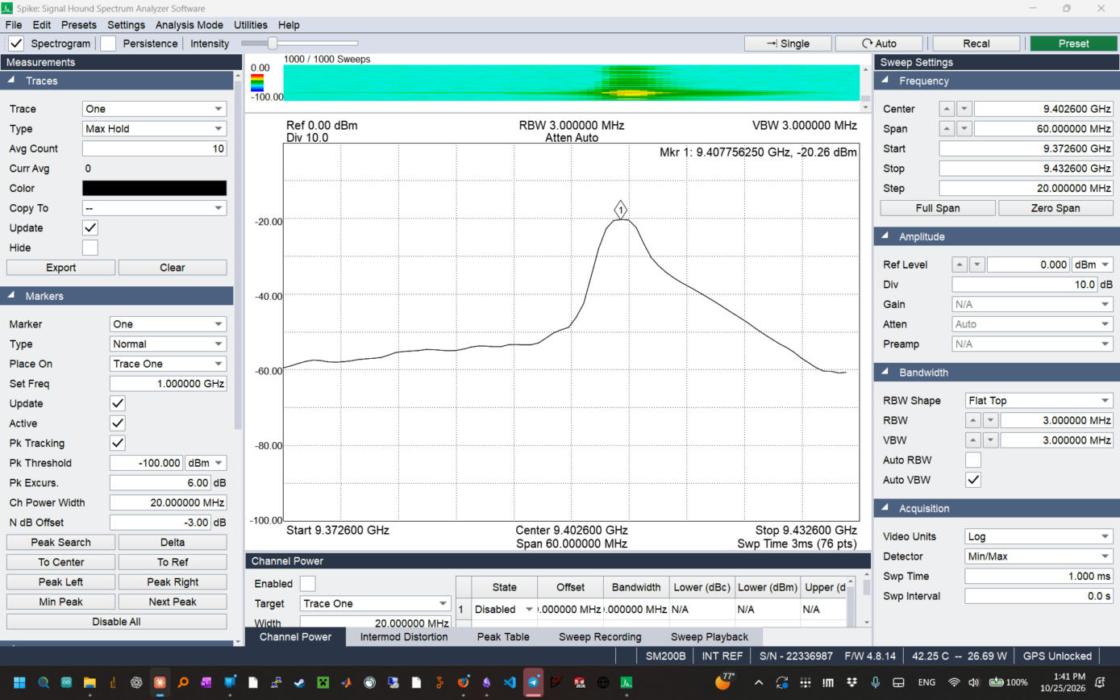
radar_test/spike_screens/step1_no_limiter_foam_off_29dB_pads_11m_rbw3MHz.jpg
