Sorin-Jayaweera/Panthalassa-Clinic-Team/radar_test/test_log.md

# Furuno radar tests: log

Every test run on 25 and 26 Oct 2026, in order. Repeated readings of one setup are one test (old 5 and 6 are in 4, 14 in 13, 19 in 20); numbers were not reused. Readings are the peak at the SM200B input unless stated.
Times are Pacific (UTC−7), taken from the time stamps of Sorin's messages; "≈" means worked out from the messages around it.
"Sorin" = Sorin read it or said it; "Spike" = Claude read a Spike screenshot; "I/Q" = Claude's own Python capture.
The same tests grouped by wiring, with Sorin's exact words: Radar tab → "Power readings by test".
"3 MHz" means Spike or I/Q at a bandwidth wide enough to hold the 0.68 µs pulse (close to the true pulse peak);
"100 kHz" readings are 15 to 25 dB lower than the true peak for this pulse.

Radar: Furuno 1722C, long pulse (24 nm range), 2.2 kW peak rating. Supply 12 V 4.64 A on standby (Sorin, 11:59), 12.15 V 4.5 A setting (Sorin, 13:38), 12.1 V 6.35 A transmitting.
Distances are radar to Vivaldi. 11.3 m = 37 ft (Sorin); on 26 Oct Sorin gave the same spot as 11 to 11.5 m. "Pads" are the fixed 8 GHz attenuators in front of the SM200B.

## 25 Oct

| # | Time | Distance | Path to the SM200B | Pads | Foam on radar | Reading | Notes |
|---|---|---|---|---|---|---|---|
| 1 | 11:44 | — | Vivaldi, radar off (background) | 14 dB + manual 50 dB | — | noise −66 dBm (100 kHz) | safe-start reference |
| 2 | 12:15 | 11.3 m (37 ft) | Vivaldi pointed away, whiteboard between, manual attenuator 50 dB | 14 dB | on | −38.8 dBm (I/Q, 10 MHz, one pulse caught); −47.7 dBm (100 kHz). Sorin on Spike (12:26): peak −80, sometimes −70 on Power/Average; −60 to −50 on Log, Min/Max | first sight of the radar, 9.407 GHz |
| 3 | 12:20 | 11.3 m | Vivaldi facing the radar, whiteboard in | 14 dB + manual 50 dB | on | about −44 dBm (Spike 100 kHz, from the grid) | |
| 4 | 12:45–13:15 | 11.3 m | Whiteboard out, manual attenuator 0 dB (Sorin, 12:44); Sorin: "we're measuring about -20 dBm" | 14 dB | on | −40.7 dBm (Spike 100 kHz); **−21.5 dBm (Spike 3 MHz)**; −22.2 dBm (I/Q, 50 MS/s) | manual attenuator (rated to 2.5 GHz) gives almost nothing at 9.4 GHz; same setup also read as −20.5 dBm (3 MHz) / −44.7 dBm (100 kHz) in your Spike exports, and gave all the pulse and timing figures (I/Q, 12:58–13:10) |
| 7 | 13:41 | 11.3 m | Vivaldi → pads, manual attenuator removed | 29 dB (3+6+10+10) | **off** | **−20.3 dBm** (Spike 3 MHz) at 9.4078 GHz | foam was worth about 17 dB (later shown to be mixed with leakage) |
| 8 | ≈14:15 | 11.3 m | Vivaldi → limiter → pads | 29 dB | off | **−20 dBm (Sorin)**; −22.9 dBm (Spike 3 MHz screenshot); −46.7 dBm (Spike 100 kHz) | limiter output +9 dBm (Sorin) / +6.1 dBm; within 0.3–2.6 dB of test 7 |
| 9 | ≈14:50 | 11.3 m | bare SMA cable, no Vivaldi, no limiter → pads | 29 dB | off | about −17 dBm (your reading) | **first sign of leakage**: the cable alone picked up more than the antenna |
| 10 | ≈14:55 | 11.3 m | cable → LNA ZX60-5123LN+ (6 V, 0.08 A) → pads | 29 dB | off | nothing seen | Spike had lost the SM200B (USB dropout), not a fault in the LNA |
| 11 | 16:29 | 11.3 m | Vivaldi → pads | 29 dB | off | −29.4 dBm (I/Q) | 9 dB below test 7; cause not found |
| 12 | ≈16:35 | 11.3 m | Vivaldi → limiter → pads | 29 dB | off | −30.2 dBm (I/Q) | **limiter loss 0.8 dB** vs test 11 (datasheet 0.5 typ, 1.5 max) |
| 13 | 16:44 | **3.96 m (13 ft)** | Vivaldi → limiter → pads | 29 dB | off | **−12.9 dBm** (I/Q 6 s), −12.6 dBm (I/Q 50 MS/s); −15.27 dBm (your Spike screenshot, ref −20 dBm, may be compressed) | limiter output +16.2 dBm (datasheet flat leakage +13 to +17); no leading-edge spike at 20 ns resolution |
| 15 | 16:49 | 3.96 m | Vivaldi → pads, limiter out | 29 dB | off | −25.9 dBm (Spike 3 MHz) | lower than WITH the limiter: impossible unless something other than the antenna dominates |
| 16 | 16:52 | 3.96 m | **50 Ω load → pads** (no Vivaldi, no cable) | 29 dB | off | **−20.5 dBm** (Spike 3 MHz) | **leak confirmed**: more than with the antenna |
| 17 | 16:55 | 3.96 m | **50 Ω load directly on the SM200B input**, pads removed | 0 | off | **−15.7 dBm** (Spike 3 MHz) | only 5 dB above test 16: most of the leak enters the SM200B itself. Same wiring as test 21 the next day |

## 26 Oct

| # | Time | Distance | Path to the SM200B | Pads | Foam on radar | Reading | Notes |
|---|---|---|---|---|---|---|---|
| 18 | 17:37 | 3.96 m | Vivaldi (short cable) → limiter → LNA **unpowered** → pads | 29 dB | off | about −10 dBm (your reading) | not safe to power the LNA as wired: limiter output up to +17 dBm vs LNA max input +15 dBm; plan: add a 10 dB pad before the LNA |
| 20 | 18:13–18:16 | 3.96 m | 50 Ω load (Mini-Circuits ANNE-50L+, s/n 3-1909) → pads | 29 dB | off | **−22.9 dBm** (Spike 3 MHz, Min/Max, Max Hold) | first read on Spike's Average detector (about −90 / −78 dBm), which hides pulse peaks. Same wiring as test 16 the day before |
| 21 | 18:19 | 3.96 m | **50 Ω load directly on the SM200B input** | 0 | off | **−22.5 dBm** | leak enters the SM200B itself, not only the pads |
| 22 | 18:22 | 3.96 m | load directly on input, **SM200B wrapped in AN-72** (front exposed) | 0 | off | −25.7 dBm (Spike Max Hold); "around -30" (Sorin, live trace) | foam on the box helps about 3 dB |
| 23 | 18:26 | 3.96 m | load directly on input, wrapped, **whiteboard between radar and SM200B** | 0 | off | −19.43 dBm (Sorin) | metal sheet in a reflective room does not shadow reliably |
| 24 | 18:33 | 3.96 m | test 23's setup with the **29 dB pads put back**: load → pads → SM200B, SM200B wrapped, whiteboard between | 29 dB | off | **−25 dBm** (your reading; −19 dBm without the pads = test 23) | adding 29 dB took off only 6 dB: about −25 dBm enters the SM200B whatever is on its input |
| 25a | 18:40 | **11.5 m** | 50 Ω load → pads (no antenna), whiteboard between | 29 dB | off | −34 to −32 dBm (your reading) | leak floor at the long distance, whiteboard in |
| 25b | 18:40 | 11.5 m | 50 Ω load → pads, **whiteboard out** | 29 dB | off | **−31.2 dBm** (Spike 3 MHz, Min/Max, Max Hold) | whiteboard changes the leak by only about 1–3 dB here. Test 7 (−20.3) was 11 dB above this; tests 11 (−29.4) and 12 (−30.2) were AT it, so the 0.8 dB limiter loss is not trustworthy |
| 26a | 18:43 | 11.5 m | 50 Ω load → limiter → 10 dB pad → LNA **unpowered** → 29 dB pads (10+10+6+3), whiteboard out | 10 before LNA + 29 after | off | **about −31 dBm** (your reading) | same as the load alone (25b): the limiter and LNA add no pickup of their own |
| 26b | 18:43 | 11.5 m | same, LNA **powered** (6 V) | 10 + 29 dB | off | **−28 dBm** (your reading) | +3 dB over 26a: pickup between the load and the LNA input (limiter, 10 dB pad, joints), amplified 22 dB, about equals the leak entering after the LNA. Leak floor for test 27 is −28 dBm |
| 26c | 18:48 | 11.5 m | 50 Ω load → limiter → 20 dB (10+10) → LNA powered → 19 dB (10+6+3) | 20 + 19 dB | off | **−24.06 dBm** (your reading) | leak floor for the test-27 wiring; 4 dB above 26b because 10 dB less padding after the LNA |
| 27 | 18:50 | 11.5 m | Vivaldi → limiter → 20 dB → LNA (6 V) → 19 dB → SM200B, whiteboard out | 20 + 19 dB | off | **−7.94 dBm** at 9.4047 GHz (Spike 3 MHz, Min/Max, Max Hold 20 s, ref +10 dBm); −11.4 dBm at ref −20 was clipped | 16 dB above the 26c floor (−24.06). LNA output about +11.1 dBm; with the input estimated from test 7 (+8.7 − 0.8 − 20 = −12.1 dBm) the LNA gain is about 23 dB (datasheet about 22) |
| 28 | 18:52 | 11.5 m | same as 27, LNA **unpowered** | 20 + 19 dB | off | **−25.85 dBm** at 9.4047 GHz (Spike 3 MHz, ref +10) | 17.9 dB below 27. This is near the leak floor (−24 to −31), so it is leak plus whatever leaks through the off LNA, not a clean off-state loss; on/off difference is a lower bound on the gain |
| 29 | 31 Oct | not stated | Vivaldi → limiter → 10+10 → LNA **unpowered** (Sorin forgot the amp power) → 10+6+3 → SM200B (same pads as 28) | 20 + 19 dB | off | **−19.12 dBm** at 9.408594 GHz (Spike 3 MHz, Min/Max, Max Hold, ref 0; Sorin's screenshot) | Not an LNA-on reading, so not comparable to test 27. 6.7 dB above test 28 (LNA off, −25.85) and 4.9 dB above the 26c floor (−24.06). Hold time, position and aim not recorded |
| 30 | 31 Oct | not stated | Furuno → limiter → 20 dB → LNA powered on → 10+6+3+10 → SM200B | 20 + 29 dB | off | **−32.83 dBm** at 9.40625 GHz (Spike 3 MHz, Min/Max, Max Hold, ref +10; Sorin's screenshot) | About 15 dB below the −18 dBm expected from test 27 plus 10 dB. Scaled to 19 dB after the LNA it is −22.83, which is 3.7 dB below test 29 with the LNA off, so the LNA shows no gain here. Cause not known; supply current not recorded |
| 30b | 31 Oct | not stated | same as 30, ref −20 dBm | 20 + 29 dB | off | about **−33 dBm** near 9.405 GHz, read by eye from the trace (marker was off the peak at 9.385156 GHz, −65.48 dBm) | Same peak as 30. Floor about −82 dBm instead of −50, about 30 dB lower, which shows the skirts that ref +10 hid. The lower ref did not change the peak level, so the low reading stands |
| 31 | 31 Oct | not stated | same as 30, ref −20 dBm, RBW 100 kHz | 20 + 29 dB | off | **−49.46 dBm** at 9.405664 GHz (Max Hold screenshot). Sorin: 6 V supply off to on moves it from −54 to −52 | Only 2 dB on/off change, where test 27/28 showed 17.9 dB. Either the LNA is not amplifying or this signal bypasses it. Sinc lobes about 1.5 MHz apart by eye, about 0.65 µs pulse |
| 32 | 31 Oct | not stated | 50 Ω load directly on limiter input (antenna had been on a meter of cable) → 20 dB → LNA on, 0.08 A (Sorin) → 29 dB → SM200B | 20 + 29 dB | off | **−23.15 dBm** at 9.40625 GHz at 3 MHz RBW; **−45.04 dBm** at 100 kHz RBW (ref −20, Max Hold) | Load reads higher than the antenna (tests 30, 31) by 9.7 and 4.4 dB, so those readings are leak, not signal through the chain. LNA gain not shown by them. The antenna path gave well under the −18 dBm expected; cause not known |
| 33 | 31 Oct | not stated | Vivaldi directly on limiter (no meter of cable) → 20 dB → LNA on → 29 dB → SM200B | 20 + 29 dB | off | **−18.94 dBm** at 9.405469 GHz at 3 MHz RBW (ref −20, Max Hold) | Near the −18 dBm expected. 13.9 dB above test 30 with the meter of cable, which points at that cable or its connection. Only 4.2 dB above the test 32 load reading. Peak is above the −20 dBm ref, so it may read low; recheck at a higher ref |
| 34 | 31 Oct | not stated | Vivaldi → limiter → 20 dB → amp (LNA) → 29 dB → SM200B; no PLL, no mixer | 20 + 29 dB | off | **−16.46 dBm with amp on, −27.39 dBm with amp off** (Sorin's readings; no screenshot; Spike settings not stated) | 10.93 dB on/off difference, under the 22 to 23 dB gain, so a lower bound. On is 6.69 dB above the test 32 load reading (−23.15), if the settings match |
| 35 | 31 Oct | not stated | Radar **off**. Vivaldi → limiter → 20 dB → LNA (6 V) → 6+10 → ZX05-14LH-S+ RF; ADF 8.3 GHz → buffer (12 V) → ZX10 S, port 2 on 50 Ω, port 1 → mixer LO; IF → 3 dB → SM200B | 20 + 16 + 3 dB | n/a | LO at the IF port: **−30.62 dBm** at 8.300002 GHz (full span, RBW 300 kHz, ref +10). By eye, about −32 dBm near 4.15 GHz and −52 dBm near 16.6 GHz | Baseline before radar on. Nothing else stands out above the noise (−60 dBm or so) |
| 36 | 31 Oct | not stated | Same as 35, screenshots taken with radar on (radar state not stated by Sorin; a signal shows at 9.4 GHz) | 20 + 16 + 3 dB | n/a | **IF about −37.5 dBm near 1.1058 GHz**, by eye, RBW 3 MHz, no marker. RF feedthrough about −39 dBm near 9.4055 GHz, by eye, RBW 200 kHz. LO feedthrough −30.19 dBm at 8.299951 GHz, RBW 100 kHz | 9.4055 − 8.3 = 1.1055 GHz matches the IF peak. About 20 dB above the IF floor. Apparent conversion loss about 30 dB (RF about −4 dBm from test 34; IF −34.5 dBm before the 3 dB pad), against 7.72 dB datasheet at +10 dBm LO; LO is about −6 dBm. No LO-off control yet |
| 36b | 31 Oct | not stated | Same as 36, second look: power on, splitter in, PLL on (Sorin) | 20 + 16 + 3 dB | n/a | **IF −38.57 dBm at 1.105469 GHz; −19.82 dBm at 9.404688 GHz**, both RBW 3 MHz, ref +10, Max Hold | Same RBW, so 18.75 dB apart. The 9.4 GHz reading is close to the test 32 leak (−23.15), so it is not a clean mixer feedthrough number. IF frequency is one sweep bin (0.78 MHz) from 9.404688 − 8.3. Apparent conversion loss about 31.6 dB with RF about −4 dBm from test 34 |
| 36c | 31 Oct | not stated | Same as 36b, PLL off | 20 + 16 + 3 dB | n/a | **No 1.1 GHz signal seen** (Sorin; no screenshot) | Control passes: the 1.1 GHz peak depends on the PLL, so it is the mixing product |
| 37 | 31 Oct | not stated | Vivaldi/limiter/LNA/mixer chain as 36, IF → SDS1104X-E and SSA3021X; how they are joined not stated; radar and PLL state not stated | 20 + 16 dB | n/a | SSA at 1.105 GHz: swept 100 MHz span, RBW 1 MHz, atten 20 dB, 30 s Max Hold: no peak, −55.79 dBm max, median −58.2. Zero span, RBW 1 MHz, atten 0, 30 s Max Hold: **max −50.86 dBm, median −66.06 dBm**. Scope: flat trace, RMS 2.41 mV at CH1 120 mV/div, 1 ms/div | Not confirmed as the IF; needs a PLL-off control. SSA RBW tops out at 1 MHz, which is narrow for this pulse and swept mode can miss it. The SDS1104X-E is a 1 MΩ, 100 MHz scope, so it cannot show 1.1 GHz |
| 38 | 31 Oct | not stated | Same chain as 37, IF → 3 dB → SM200B; nothing else changed (Sorin) | 20 + 16 + 3 dB | n/a | **IF about −37 dBm near 1.104 GHz**, by eye, no marker (Spike RBW 3 MHz, ref −20, Max Hold) | Agrees with 36b (−38.57), so the chain still works and test 37's weak reading comes from the scope/SSA path or the SSA's narrower RBW |
| 39 | 31 Oct | not stated | Same chain, IF directly → SSA3021X, no pad, no scope (Sorin) | 20 + 16 dB | n/a | Zero span 1.105 GHz, RBW 1 MHz, atten 0, 30 s Max Hold: **−50.88 and −54.76 dBm max** (medians −62.92, −64.83). Swept 100 MHz, 1 s sweep, 60 s Max Hold: **−61.54 dBm at 1.1056 GHz** (median −77.24). `radar_test/vna/ssa3021x_IF_direct_31oct.csv` | Frequency agrees with Spike. Same as test 37 with the scope in, so the scope was not the loss. About 15 dB below the −35.6 dBm Spike implies without the pad. The SSA's 1 MHz RBW against a 0.65 µs pulse should explain about 9.5 dB (from 3 MHz); the rest is not explained. No PLL-off control on the SSA |
| 39b | 31 Oct | not stated | Retake of 39, radar and PLL on (Sorin) | 20 + 16 dB | n/a | Zero span 1.105 GHz, 30 s: **−54.73 dBm max**, median −66.23. Swept 100 MHz, 60 s: **−58.52 dBm at 1.1031 GHz**, median −77.2. Traces and screens in `radar_test/spike_screens/ssa3021x_IF_*` | Swept peak is sparse spikes: the sweep catches pulses only now and then, so the peak moved 2.5 MHz from test 39 and the level varies. Screen markers are not on the peak; the numbers come from the trace data |
| 40 | 31 Oct | not stated | Mixer IF → ZFRSC-42-S+ → two cables (one 4.5 in longer) → ZX05-30W-S+ LO and RF; its IF → SDS1104X-E; radar on (Sorin) | 20 + 16 dB | n/a | Scope flat at its old settings: CH1 120 mV/div, 1 ms/div, 5 MSa/s, RMS 3.84 mV; channel used not stated | Not a valid test of the detector yet. Each detector port gets about −42 dBm (−35.6 less 6 dB; the ZFRSC-42-S+ is resistive), about 49 dB under its +7 dBm LO spec, so expect little or no output until the limiting amp is in. 1 ms/div at 5 MSa/s can also miss a 0.65 µs pulse |
| 41 | 1 Nov | bench | Pluto −36 dBm (table) → 3 × ZX60-P103LN+ → ZFRSC-42-S+ → two cables, one 4.5 in longer → ZX05-30W-S+; IF → scope CH1 and SSA3021X (Sorin). 1000–1200 MHz, 1 MHz steps, two runs. `phase_detector_calibration/pluto_calibration_1nov_-36dBm*.csv` | none | n/a | Run 2: **about 187 mV at 1008 MHz, rising to about 250 mV at 1080 MHz, about 235 mV at 1134 MHz, about 244 mV at 1184 MHz, 242 mV at 1200 MHz. 243.2 mV at 1105 MHz** | Single-valued only from about 1010 to 1080 MHz, about 0.9 mV/MHz. At 1105 MHz the slope is about −0.7 mV/MHz and 243 mV recurs above 1170 MHz. Runs agree from 1014 MHz up: mean 0.31 mV, max 2.8 mV. Run 1 was bad below 1014 MHz, cause not known. Tone-off offset before these runs about 43 mV with 12 mV rms, cause not known; oscillation not ruled out. Not yet tested against other levels |
| 41b | 1 Nov | bench | Same as 41, 800–999 MHz, Pluto −36 dBm from the map table. Scope is 1 MΩ, the only input it has | none | n/a | **191 mV at 800 MHz, falling to 99.4 mV near 886 MHz, rising to about 190 mV near 990 MHz.** `phase_detector_calibration/pluto_calibration_1nov_-36dBm_800to999.csv`, joined plot `..._800to1200.png` | Steepest long run about 950–985 MHz, about 1.6 mV/MHz by eye. Valid only for this load: a 50 Ω load at DC would change the voltages |
| 42 | 1 Nov | not stated | Full chain, Furuno as source, PLL on: Vivaldi → limiter → 20 dB → LNA → 16 dB → ZX05-14LH-S+; IF → 3 × P103LN → ZFRSC-42-S+ → 4.5 in delay → ZX05-30W-S+ → scope and SSA. Single shots, 1 µs/div | none | on | **Pulses with a flat top near 195 mV (peaks 200–204), about 0.8 µs wide**, baseline 8–15 mV. `phase_detector_calibration/furuno_detector_1nov_pll_on` | Below the 243 mV expected from the Pluto curve. Triggered at 200 mV; none at 250 mV in 12 s. An earlier PLL-off capture is marked bad by Sorin (`BAD_furuno_detector_1nov_pll_off`). SSA: up to about −2 dBm near DC, rolling off by about 2 MHz, nothing clear above about −48 dBm floor to 2.1 GHz (RBW 1 MHz, 30 dB atten) |
| 43 | 1 Nov | not stated | Same, detector output → 23 dB → SM200B | none + 23 dB | on | **−68.06 dBm at 1.104688 GHz** (Sorin's Spike screenshot, RBW 3 MHz, ref −20), about −45 dBm before the pad | Detector was Power/Average, so a pulsed signal reads low; not a peak level. Frequency matches the IF |
| 44 | 1 Nov | not stated | Same as 43, raw I/Q, Spike closed, 50 MS/s, 41.5 MHz bandwidth, 4 s stream, centres 21 MHz and 1.105 GHz, PLL on | none + 23 dB | on | Before the pad: **+3.07 dBm near DC (centre 21 MHz), −15.92 dBm at 1104.27 MHz**. Width within 10 dB 0.74 and 0.64 µs; pulse spacing about 1650 and 1680 µs. `iq_*.npz` in `furuno_detector_1nov_pll_on` | Near-DC pulse about 19 dB above the leftover 1.1 GHz. Near-DC capture shows a slow tail after each pulse (about −8 to −14 dBm over 2.5 µs) that the scope did not show; cause not known |
| 45 | 1 Nov | not stated | Same as 44, PLL off deliberately (Sorin). Then scope single shots at triggers 400 down to 100 mV, 12 s each | none + 23 dB | on | Before the pad: **−7.90 dBm near DC (centre 21 MHz), −29.47 dBm in the 1.105 GHz capture.** Scope: no trigger at any level down to 100 mV (0 captures). `furuno_detector_1nov_pll_off_deliberate` | 11 dB and 13.6 dB below PLL on. Whether the scope was still connected during this run was not stated. Some radar output still reaches the detector with the PLL off; path not known. Antenna hand-held in the same orientation for PLL on and off (Sorin). No line at 1105 MHz with the PLL off: spectrum of the strongest pulse peaks at −73.8 dB at 1111.35 MHz, against −59.4 dB at 1104.27 MHz with the PLL on. In the saved 60 ms the PLL on near DC capture has 37 pulses 1.6 to 1.7 ms apart, while PLL off has no train at that spacing, only 20 to 80 ns spikes (highest −7.9 dBm) with the strongest clusters about 6 ms apart. Weaker spikes of about −14 dBm also appear between pulses with the PLL on, so the PLL does not create them; cause unknown, and a radar off capture has not been taken |
| 46 | 1 Nov | bench | Pluto 1105 MHz, −36 dBm (table) → 3 × ZX60-P103LN+ → ZFRSC-42-S+ → 4.5 in delay → ZX05-30W-S+ IF → SM200B, I/Q 0.2 s each at centres 21 MHz and 1.105 GHz, tone off then on. 23 dB pads assumed still in place, not restated. `phase_detector_calibration/capture_pluto_leak.py`, `pluto_leak_1nov.npz` | none | n/a | **Pluto leaks through the detector: −30.2 dBm at 1105 MHz tone on; strongest line −90.2 dBm tone off** (before pads). Near DC no change (−37.7 to −38.9 dBm at 0 MHz); this SM200B capture does not show the detector's DC voltage | Calibration read DC on the 100 MHz scope, so could not show the leak. Radar leak of −15.9 dBm is 14 dB higher, although earlier levels estimate both near +5 dBm at the detector ports; not explained. Radar is pulsed, Pluto is CW |
| 47 | 1 Nov | bench | Pluto → 3 × ZX60-P103LN+ → ZFRSC-42-S+ → 4.5 in delay → ZX05-30W-S+ IF → scope CH1 (1 MΩ, DC, BW limit) and SM200B (Sorin). 50–2890 MHz, 10 MHz steps; Pluto set for about +2.7 dBm at the detector from datasheet gain, limited to −28 dBm with a 31 dB attenuation floor, 39 dB outside the table above 2090 MHz. `phase_detector_calibration/run_pluto_full_range.py`, `pluto_full_range_1nov.csv/.png` | none | n/a | **Stopped at 2890 MHz when the scope left USB; 2900–6000 MHz not measured.** 1105 MHz check 169 mV against 243.2 mV in the 1 MΩ calibration. Peak 189.5 mV near 1250 MHz. Long smooth falling run 1450–1650 MHz; about 4 mV and flat above 2100 MHz | Level is not constant above about 1250 MHz (attenuation floor) or above 2090 MHz, so slopes there include power change. Shape differs from test 41: peak moved from about 1080 to about 1250 MHz. Cause not tested; level and the SM200B load both changed. Tone confirmed off |
| 47b | 1 Nov | bench | Same as 47, retaken from scratch (Sorin asked). `phase_detector_calibration/pluto_full_range_1nov_run2.csv`, both runs in `pluto_full_range_1nov.png` | none | n/a | **Stopped at 2850 MHz, scope left USB again; above that not measured.** Agrees with run 1 within 4.2 mV, mean 2.3 mV higher 300–2090 MHz. 1105 MHz check 164 mV. Tone off 3.8 mV. Rising 950–1090 MHz: 82 to 170 mV; falling 1400–1700 MHz: 172 to 4 mV | Above 2100 MHz reads about 4 mV, same as tone off, so drive was too low to show the detector's response. Scope dropped both runs near 2.9 GHz at different elapsed times (about 7.6 and 6.4 min); link to frequency not tested. Chosen so far: PLL 8.35 GHz, Furuno near 1054 MHz |
| 48 | 1 Nov | bench | Pluto → 3 × P103 → ZFRSC-42-S+ → 4.5 in delay → ZX05-30W-S+ → scope and SM200B through 23 dB (Sorin). Fine map 900–1200 MHz, levels at five frequencies, 1400–1700 MHz. `pluto_map_runs_1nov.csv/.png` | none | n/a | **Voltage depends strongly on power: about 15 mV/dB near −36 dBm at 1054 MHz.** 1400–1700 MHz fall is real at fixed −36 dBm | A 1 dB change looks like about 30 MHz on the 950–1090 MHz slope |
| 49 | 1 Nov | bench | Same wiring. 400–1700 MHz, 10 MHz steps, −31 to −61 dBm, one curve per level; detector input capped at +12.8 dBm from datasheet gain, so curves start at different frequencies. `pluto_explore_1nov.csv`, `pluto_power_freq_map_1nov.png`, SM200B leak `pluto_leak_during_map_1nov.csv` | none | n/a | Power changes both height and shape of the curves. Negative output below about 600 MHz. Curves bunch near 880–920 MHz | −61 dBm stopped at 1390 MHz for the amp swap. SM200B USB dropped several times; one program ended by it, restarted without her in the loop |
| 50 | 1 Nov | bench | Amps swapped to 4 × ZX60-P162LN+ at 4.01 V, 0.216 A (Sorin). Tone off check, power ramp at 1054, 1000, 1090 MHz, then 700–1600 MHz, 5 MHz steps, −45 to −85 dBm. `p162x4_ramp_1nov.csv`, `tone_off_p162x4.csv`, `p162x4_map_1nov.csv`, `p162x4_power_freq_map_1nov.png` | none | n/a | **No oscillation line (strongest −48.8 dBm, tone off). Tone off about 77 mV, 15 mV rms from chain noise. 900 to about 1020 MHz: curves nearly overlap from −70 to −45 dBm, about 80 to 230 mV.** At 1054 MHz flat 287 mV from −68 dBm up | About 54 mA per amp, datasheet max 52 mA. Above about 1060 MHz weak levels show sharp dips, cause not known. −60 dBm and −50 dBm to 1395 MHz at 100 mV/div, rest 200 mV/div. Laptop standby 17:48–19:32. 1320 MHz at −65 dBm hit by my tone off command, left out of the plot, not yet remeasured. Not yet tested with the radar |
| 51 | 1 Nov, 20:09 to 20:56 | bench | 4 x ZX60-P162LN+, amps moved at about 20:08 to the Agilent E3630A, 3.94 V, about 0.25 A (KUAIQU 4.01 V, 0.216 A before). Tone off, 1054 MHz hold, top levels, repeat sweeps at -60 dBm | none | n/a | Tone off 113 mV just after the swap, back to 79 mV by 20:17, 77.5 mV sd 1.3 at 20:37. Hold 1054 MHz -60 dBm 284.2 mV sd 0.5 over 5 min. Repeats match the KUAIQU map to about 3 mV rms. Top levels -40 to -30 dBm added, points under the 31 dB floor left out. SM200B on the dongle dropped about every 20 s; Pluto and scope stayed. |  |
| 52 | 1 Nov, 21:36 to 22:21 | bench | Same chain, Agilent supply, 900 to 1200 MHz, 1 MHz steps, -50, -40, -70, -65, -36, -60 dBm. `p162x4_fine_1nov.csv` | none | n/a | 960 to 1010 MHz: -65 to -36 dBm differ by 10.8 mV mean, 16.7 mV max (about 4 and 6.5 MHz). -70 dBm has left the rail from about 985 MHz. Last -60 dBm sweep 1.8 mV above the first repeat. p162x4_fine_1nov.csv |  |
| 53 | 9 Nov, 21:19 to 21:23 | radar 15 m, racon about 18 m | Vivaldi → SMA → Marki limiter → 20 dB → ZX60-5123LN+ 6 V → 29 dB → SM200B, raw I/Q every sample, 50 MS/s, 9408.5 MHz (`C:\racon_raw\20261109_2119*`, `_2120*`, `_2121*`) | 49 dB | not stated | radar about −22 to −27 dBm | Racon on but no replies picked up at this spot; 0.1 MHz RBW sweep 9–10 GHz at 21:23 |
| 54 | 9 Nov, 21:32 to 21:47 | triangle: radar 12.2 m, racon 7.0 m, radar to racon 15.2 m | Same chain, ref 0 then −25 dBm (`20261109_213227`, `_213542`, `_213625`, `_213716`, `_214452`) | 49 dB | not stated | radar −16 dBm; racon about −67 to −73 dBm | **Racon Morse R decoded thousands of times.** Ref 0 hid it; −25 dBm shows it. See the Racon tab |
| 55 | 9 Nov, 21:51 to 21:56 | triangle | Horn aimed at the radar, racon off; partway through 21:51 the horn was turned to the right polarisation (SMA to the right) (`20261109_215120`, `_215332`) | 49 dB | not stated | radar −12.6 dBm at the SM200B | Polarisation matters: about 14 dB jump when turned |
| 56 | 9 Nov, 21:57 to 22:00 | triangle | Horn aimed at the racon, SMA to the right, both on, 179 s (`20261109_215716`) | 49 dB | not stated | racon about −52 dBm | **3934 complete R: long R (dot 8.50, gap 8.57, dash 25.65 us) and short R (x 0.75).** Statistics on the Racon tab |
| 57 | 9 Nov, 22:10 to 22:21 | triangle | Horn at the radar, then at the racon, both on: sweeps 9–10 GHz, 18.6–19.0 GHz, 0.1–20 GHz, 60 s each, 100 kHz RBW | 49 dB | not stated | 2nd harmonic 18806.8 MHz −63.0 dBm (horn at radar) | Chain loss at 18.8 GHz unknown. Wide sweep finds only phones and Wi-Fi besides the radar |
| 58 | 9 Nov, 22:24 to 22:28 | triangle | Horn at the racon, SM200B segmented I/Q 250 MS/s, 160 MHz wide, 9404 MHz, 11 captures (`racon/data/seg_horn_racon_250M_20261109_222441`) | 49 dB | not stated | racon about −58 dBm in 160 MHz | 468 complete R; racon edges about 30 ns 10–90 % |

## What the tests show

1. **Radar signal (test 4):** fully characterized; leakage does not change these figures.
2. **SM200B safety:** the highest reading in any test was −7.94 dBm (test 27), 28 dB under the +20 dBm limit.
3. **Leakage (tests 9, 15–24):** the radar gets into the SM200B directly at about −20 to −25 dBm at 13 ft. Power levels in tests 8–18 are mixed with it and are not reliable as antenna levels; test 7 is 11 dB above the 11.5 m floor and mostly signal.
4. **Limiter:** the 0.8 dB loss from tests 11–12 was measured at the leak floor (test 25b) and is not trustworthy. Output +16.2 dBm at 13 ft (test 13), within its rated clamping level, but the input level for that test is not known, so clamping is not yet shown.
5. **Leak floor at 11.5 m (tests 25–26):** −31 dBm with a load on the pads, whiteboard in or out; −28 dBm with the LNA powered and a load on the limiter input; −24 dBm with 20 dB before and 19 dB after the LNA.
6. **LNA (tests 27–28):** Vivaldi → limiter → 20 dB → LNA → 19 dB read −7.94 dBm with the LNA on, 16 dB above the floor, and −25.85 dBm with it off. With the LNA input estimated from test 7 (about −12 dBm), the gain is about 23 dB (datasheet about 22). The on/off difference (17.9 dB) is limited by the leak.

## Lessons

- The JFW manual attenuator is rated DC–2.5 GHz and does almost nothing at 9.4 GHz.
- Spike's Average detector reads far below a radar pulse peak; use Min/Max, Log, 3 MHz RBW, Max Hold.
- Spike resets to defaults after every SM200B reconnect; check settings each time.
- Only one Spike window at a time.
- Repeat the load test at the start of every setup: the leak must be 20 dB below the reading being trusted.
