Sorin-Jayaweera/Panthalassa-Clinic-Team/radar_test/user_messages_log.md

# Sorin's messages during the radar tests

Every message Sorin sends during bench work, in order, so each test can be worked out from the instructions.
Entries before 26 Oct 18:35 are rebuilt from the session summary and are close paraphrases, not exact quotes; entries after that are verbatim.

## 25 Oct (paraphrased)

- Radar setup questions: draw the setup; is it safe; tee removal; foam; power supply 12 V at 4.64 A; range settings; 37 ft; added 2 dB; Spike usage; RBW; "How much time is between each of the pulses?"; "How do I place a trace in a delta trace?"
- "spike is closed, measure this all yourself"; "also check temperature"; "take all the data and measurements you can, and write them to the github page"
- Asked for spectrograms, FFT slices, marker labels, what each pulse looks like, what to expect for the limiter, LNA and mix-down.
- Asked for the power table: dBm and mW, whiteboard in/out, minus 14 dB, EIRP, centre frequency, span, pulses per second, revolutions per second, pulses per cycle, peak and average, as CSV.
- "plot my furino CSVs and put them on the radar tab."
- "I put a 10, 10, and 3 dB 8G attenuator." Foam off, 3 + 10 + 10 to the Vivaldi. Later: "I made it 3 dB, then 6 dB, and then 2 10 dBs." "I turned on persistance".
- Limiter connected (3, 6, 10, 10 dB, then limiter, long cable to the Vivaldi). "I'm turning on the radar. Give me the go/nogo." "transmitting". "the sm200b disconnected, I just reconnected".
- About −20 dBm; about −17 dBm from just the SMA cable; plugged in the LNA at 6 V, 0.08 A, no longer read anything. "Help me debug this. I am scared."
- "right now I only have the vivaldi to the 10+10+3+6 db attenuators. Turning on the radar"; "radar is on"; "try again, radar is on and transmitting".
- "radar on standby, i put in just the power limiter. Is the EVAL HLM 20 P directional?"; "radar is back on with the power limiter in"; "it should be around 30 dBm".
- "the radar is 13 feet from the antenna, and about 26 from me." "I moved it closer to test the power limiter like you said. Can I turn on the radar?" "on".
- Spike at −15.27 dBm. "can I turn off the radar? Do we have enough close range data?" "so I should remove the limiter and just have the vivaldi into the attenuators, right?" "it is connected. Transmitting now."
- "I unplugged the vivaldi and long cable... put a 50 ohm termination." "terminator is on the signal hound input now, no pads..."

## 26 Oct (paraphrased up to 18:35)

- "I have -10 dBm measured (vivaldi with much less cable, close distance, power limiter, amplifier but not powered on, 29 db)... is it safe to power on the amplifier?" "I'll just add in another 10..."
- "I don't really see an effect from having the antenna plugged in versus not... test where we just have the SM200B capped off." "I'll put a 50 ohm termination?"
- "spike is open, radar is on. Look at the screen. This is with the 29 dB attenuators and then the 50 ohm load."
- "Is the 50 ohm load going directly into the +20 dBm max port? Is it okay for me to turn on the radar?" "I just turned it off."
- "I just wrapped most of the outside of the signal hound in the AN72 foam board..." "Radar is now on. It is at around -30."
- "I put the whiteboard in between... -19.43 dBm... Is the whiteboard acting like a transmitting antenna?" "I forgot that we don't have the attenuators on right now." "when I put in the attenuators, I go from -19 dBm to -25 dBm..."
- "My main goal with this was to understand the quality of the power limiter and the amplifier, and also just what the spectrum of the radar actually looked like."
- "I'm going to move the radar back to the original position. That's about 11.3 meters. And then leaving the 50 ohm and then the 29 dB attenuators, I'll measure, and then I'll add on the antenna."

## 26 Oct (verbatim from here)

- ~18:38 "The radar is now 11 meters away. The whiteboard is still in the way. It's just the 50 ohm and then attenuators. I'm turning it on."
- ~18:39 "Also keep a list of every message that I send so that you can figure out any test that I do from my instructions to you."
- ~18:40 "Right now it's transmitting the direct path from radar at 11.5 meters away to the SM200B with just the 50 ohm load and attenuators."
- ~18:43 "I measure a background of negative 34 to negative 32 dBm. I'm now moving the whiteboard out of the way to measure."
- ~18:46 "with the whiteboard out of hte way I got the -31.2 dBm"
- ~18:48 "And now adding on to the end, instead of the 50 ohm load, I'm going to have the amplifier and the power limiter. So it's power limiter, then amplifier, then attenuators. And I think I'm going to put the 50 ohm load at the end of the power amplifier, just so that we see what we read here for random coupling stuff."
- ~18:52 "Okay, it's now 50 ohm load, then power limiter, then the amplifier, which is currently turned off, and then the attenuators to the signal mount. I'm going to turn on the radar with the amplifier off. We'll take data, and then we'll turn the amplifier on, and then we can go to having the antenna."
- ~18:53 "Yes, you can. Bye. Bye."
- ~18:56 "We got the same negative 31 dBm. I'm going to turn on the amplifier. Amplifier is on."
- ~18:58 "With the amplifier on, we get -28 dBm."
- ~19:00 "I forgot to say, for this setup, it is the power limiter, then 10 dB of HE attenuation, then the amplifier, and then the rest of the attenuators. This is how it has been every time in the past couple of messages that I've tested with the amplifier."
- ~19:01 "You don't need to give such long responses. Just say okay or next test or suggest something or say something is wrong."
- ~19:02 "The setup as it is right now is power limiter, then 10 dB, then amplifier, and then 10 dB, then 10 dB, then 6 dB, then 3 dB attenuators. This is how it has been"
- ~19:04 "Instead of this now, the 50 ohm load, then the power limiter, then 2 10 dB attenuators, then the amplifier, and then 10 dB, 6 dB, 3 dB, then signal hound."
- ~19:06 "I'm turning on the amplifier and turning on the radar. I read -24.06 dBm at the peak."
- ~19:08 "Vivaldi is in, radar transmitting"
- ~19:10 "look at the screen yourself, I'm holding the radar. Give me a \"done\" message when you are done collecting data"
- ~19:12 "amplifier is off now, radar transmitting"
- ~19:14 "radar is off, update the github page"
- ~19:20 (with racon_draft_design01b_drawing.pdf) "look at the JCon specs. What is the next thing that I should test? We've seen that we can receive, we know the frequency spectrum, we know the pulses, we know characterizations of the radar itself, we know the amplification from this amplifier and the power limiter. I'm assuming that you have good data from. I want you to explain that to me. We've used the signal spectrum analyzer. I'm curious about using the spectrum analyzer as a SDR, but I think maybe we can go to PLL and shifting down frequency and then doing frequency identification at the same time."
- ~19:25 "the LNA has 6V in on the datasheet"
- ~19:30 "I have plugged you into the ADF5355 through the USB port and I've applied power. I want you to teach me how I would normally program and use the ADF5355."
- ~19:08 PC clock "I have connected out B, which is 6.8 to 13.6 gigahertz through an SMA cable to the attenuators. I right now have a 10 dB attenuator, a 6 dB attenuator, and a 3 dB attenuator. Is this safe? Show me documentation."
- ~19:20 PC clock: asked to reorganise the Radar section: power levels by condition, grouped 50 ohm load vs antenna, then by signal chain; each test a one-sentence summary that expands; top line = max power at the spectrum analyzer and the power at the farthest point of the chain; every number Sorin said must appear; other analysis hidden as "AI analysis"; amplifier results under ZX60-5123LN+, limiter results under its part; documented for a year from now.
- ~19:30 PC clock "I have plugged in the ADF five-three-five-five only and not the spectrum analyzer. It is not plugged in. It's just what you have, so make sure you don't transmit because it would destroy the thing. But you can program it."
- ~19:33 PC clock "keep writing the documentation at the same time that you're working on this ADF 5355."
- ~19:34 PC clock "I just plugged in the spectrum analyzer in addition to the ADF."
- ~19:36 PC clock "it's connected to the SignalHound SM200B."
- ~19:40 PC clock "It is a black box with three output ports, out A plus, out A minus, out B, from AliExpress."
- ~19:44 PC clock "try this: https://github.com/analogdevicesinc/no-OS/blob/main/drivers/frequency/adf5355/adf5355.c. I also just plugged the ADF 5355 into the 10+6+3 db attenuators in the SM200B."
- ~19:50 PC clock "the sticker is hand written from someone in my lab, it says 2021-05 microwave synthesizer 5+MHZ - 13.66 Hz, 180 bucks ali express with the Out A+ and out A- at 54 M-6.8 GHz, and out B at 13.smth GHz"
- ~19:55 PC clock "check https://github.com/gallicchio/"
- ~19:58 PC clock "the SM200B is plugged in"
- ~20:05 PC clock "the spectrum analyzer was getting hot, I just unplugged it. Do what you can with the ADF5355."
- ~20:20 PC clock "The adf and signal hound are both pluggedin."
- (reading) ADF5355 Out B at power-up: 8.000002 GHz, -26.98 dBm at the SM200B through 19 dB
- ~20:30 PC clock "you can program it, just show me what you are doing"
- ~20:45 PC clock "I see an 8 GHz signal?"
- ~20:47 PC clock "https://github.com/analogdevicesinc/no-OS/blob/main/drivers/frequency/adf5355/adf5355.h https://www.analog.com/en/products/adf5355.html#software-resources Keep trying"
- ~20:58 PC clock "spike is open"
- ~21:00 PC clock "spike opening" + photo of the ADF5355 box (saved as adf5355/box_photo_2026-10-26.jpg)
- ~21:15 PC clock asked for numbers and a chart: SM200B reading with the 50 ohm load directly on the SM200B, the load into the attenuators, and the antenna into the attenuators
- ~21:25 PC clock "the tests sometimes show two of the same thing. Also, I never had just the load in a cable into the SM200B. Reread over the messages to figure out what each of the tests were."
- ~21:30 PC clock "also put that chart on the github pages."
- ~21:45 PC clock "I'm measuring the attenuators on a VNA before I go back to the PLL mix down thing (which because I can manually push buttons to set the frequency, we don't need to care about usb control). I have the Agilent 8720ES S-Parameter network analyzer. +30 dBm RF 40 VDC MAX. Walk me through calibrating it and then measuring the S parameters of the 3 dB 8G attenuator."
- 27 Oct "how many dB per division?"
- 27 Oct four 8720ES photos (S22, S12, S11, S21, 10 dB/div, REF 0 dB, 50 MHz-20.05 GHz, 3 dB "8G" pad in) "put these on the website, and read them" (saved in radar_test/vna/)
- 29 Oct four 8720ES photos with markers (S22, S12, S21, S11; markers at 50 MHz, 880 MHz, 9.502, 10.284, 20.05 GHz), no text (saved as radar_test/vna/pad3dB_sweep2_*)
- 31 Oct four 8720ES photos with markers (saved as radar_test/vna/pad3dB_sweep3_*) "I remeasured the 3 dB attenuator using a different cable that is much better. This is for 8G."
- 31 Oct four 8720ES photos (saved as radar_test/vna/pad6dB_*) "YES I recalibrated the data, all I'm asking you to do right now is to just read these four photographs and write down the numbers for each of my markers that I have it in a good table. Here are photos for, instead of the 3 dB, this is now for a 6 dB attenuator."
- 31 Oct "yes, record this data as we go. Do you have the 3db and 6db done?"
- 31 Oct four 8720ES photos (saved as radar_test/vna/pad10dB_delta_*, screens in delta-marker mode) "This is for 10dB. Next I want to measure the vivaldi antenna - it only has one port. Walk me through how to measure this on the S parameter network analyzer"
- 31 Oct two 8720ES photos (saved as radar_test/vna/vivaldi_S11_*) "With the vivaldi plugged in to port 1, I measured S11. I see minor change if i turn it around. I don't have the broadband load on port 2, because it isn't measured at all for S11, which is the only thing that makes sense here. I also just changed number of points to 1601. It was at 201 or something low like that."
- 31 Oct four 8720ES photos (saved as radar_test/vna/limiter_delta_*, delta markers, C2-delta) "next I'm measuring the power limiter:"
- 31 Oct "The vivaldi antenna photo does have numbers: 13.436 dB at -19.998 GHz (what is that negative sign?), 8.770 dB at -10.6479 GHz, 5.5430 dB at -10.0479 GHz, and 5.705 dB at -12.0399 GHz, and 5 measures 8.6880 dB although the top shows 0.0 GHz when located at the very far right end - i think that i'm showing a delta frequency from the top 20 GHz. I just turned that off, and now I see marker 5 at 20.046 GHz so it should be good now."
- 31 Oct one 8720ES photo (saved as radar_test/vna/vivaldi_S11_absolute.jpg) "This is the remeasured Vivaldi."
- 31 Oct four 8720ES photos (saved as radar_test/vna/limiter_abs_*) "This is from the remeasured power limiter"
- 31 Oct "Now I want to measure the ZX05-30W-S+ frequency mixer. This has three ports. Can I measure each combination of two ports? i.e. RF + LO, RF + IF, and LO + RF for all 4 s parameters to get the parameters for this 3 port network?"
- 31 Oct five photos (saved as radar_test/vna/mixer30W_*: S22, S12, S21, S11, setup) "I want to measure everything about this mixer, and then everything about the other mixer. Port 1 is LO, Port 2 is RF:"
- 31 Oct "the next is LO port 1 IF port 2" + five photos (S22, S12, S21, S11, setup with RF open). Photos were not saved to disk by the app, only values transcribed.
- 31 Oct five photos (saved as radar_test/vna/mixer30W_IFport1_RFport2_LOopen_*) "now it is  IF (port 1) and RF (port 2). I didn't have the load on. I'm redoing them."
- 31 Oct "the numbers look the same when I put the broadband load on the LO port while having the RF and IF ports connected."
- 31 Oct "I also want to measure the IF amplifier ZX60-2534MA-S+. I want to go step by step through each of these components. I am worried about puttin the amplifier onto the S parameter network powered though. I can put attenuators and recalibrate?"
- 31 Oct "is it worth actually doing this?"
- 31 Oct "I want to move to testing how well we can mix down from 9.4 GHz to 1-1.2 GHz. It'll be the Vivaldi, power limiter, the LNA, and then 10+10 + 10+10 +6+3 dB of 8G attenuators. I will turn on the furuno and measure through the antenna what we have on this setup in spike (with the SM200B - nickname kitty). Then I will put in the PLL oscillator at 8.3 (or 8.4? what?) GHz (to make our range 1-1.2 GHz), and measure what we read from that through an LO Buffer Amp, then a splitter (where one side has a 50 ohm load, and the other goes to the mixer which is right after the LNA on the RX antenna side). What do you think of this plan?"
- 31 Oct "the LO amplifier (ZX60-14012L-S+) has 10 dBm max at the input. Shouldn't I do ADF5355 -> 10 dB attenuator -> the LO buffer amp -> kitty to see what we see out, and then I'll put in the mixer and cap an end, see what we see, and then put it aside and measure the antenna stuff and then put in the mixer and measure after that?"
- 31 Oct "step 1: ADF out B to 10 db to buffer to 20 db to kitty. Good?"
- 31 Oct "This has LO buffer amp has + 12 VDC. Is it safe? Show me the datasheet with max amplificatoin"
- 31 Oct "The ADF5355 has 5 buttons - I can easily control FA to set its frequency, but I can't figure out how to change FB from 8 GHz. Help."
- 31 Oct "I have 8.3 GHz on OUT B, to 10 db to the amp to 20 db to kitty. Open spike and measure"
- 31 Oct Spike screenshot, -33.57 dBm at 8.29995 GHz: "This picture is without the splitter. I'm now putting in the splitter at the end. There are three sides - S, 1, and 2. I'm putting S to come from the amplifier, capping 2, and measuring at 1."
- 31 Oct Spike screenshot, -59.92 dBm at 8.29995 GHz: "And this is with the splitter"
- 31 Oct "The splitter is the ZFRSC-42-S+"
- 31 Oct "I'm going to change it to the ZX10-2-1252-S+"
- 31 Oct Spike screenshot, -53.96 dBm at 8.29995 GHz: "Now I measure with the ZX10-1252-S+ in"
- 31 Oct "The setup for that measurement was ADF to 10 dB to ZX60-14012L-S+ to 20 dB attenuators to the splitter to kitty."
- 31 Oct "With the splitter in I measured -57 dB, and with it out I measure -53 dB. I had forgotten to turn on the amplifier. With it on, I now measure -31 dB without the splitter and -36 with it. Now on to the radar. I have 10 + 6 + 3 + 10 dB to the ZX60-5123LN+ (6V dc in) to the power limiter to the vivaldi, with the furuno. Am I good to turn the furuno on?"
- 31 Oct "it is my goal for the LNA to saturate - that way i have a constant voltage for the frequency mixer (phase detector circuit later)."
- 31 Oct "I have on off keying from the envelope, and phase detection. will the lna break? or will it just rail out?"
- 31 Oct "I forgot about the RF limiting amp, that is where I actually want to saturate."
- 31 Oct "I'm going to measure with Vivaldi -> limiter -> 10 + 10 -> LNA -> 10 + 6 + 3 -> kitty. Turning on the radar now, I'll send you a screenshot."
- 31 Oct Spike screenshot (noise only) "are these settings good?"
- 31 Oct "take control to fix this measurement"
- 31 Oct Spike screenshot, no text (radar at 9.408594 GHz, -19.12 dBm, ref 0, RBW 3 MHz)
- 31 Oct "why does this look so different than before?"
- 31 Oct "I forgot to turn on the poewr for the amp."
- 31 Oct "Look at my screen. You don't have to open a new spike, doing so will crash the usb port. I can also close and let you open the only one. Only one instance of spike can be running. The setup is furuno (currently active) to the power limiter, 20 db, amplifier poewred on, 10+6+3+10 db to kitty"
- 31 Oct Spike screenshot, no text (9.40625 GHz, -32.83 dBm, ref +10, RBW 3 MHz, span 100 MHz)
- 31 Oct Spike screenshot (ref -20) "with ref -20 it looks much closer to what we used to see"
- 31 Oct Spike screenshot (RBW 100 kHz) "it goes from -54 to -52 when I turn on the 6V power supply when looking at smaller RBW"
- 31 Oct two Spike screenshots "1: yes 0.08 A. 2: I put the load directly on the power limiter (not after a meter of cable)."
- 31 Oct Spike screenshot "vivaldi directly on the limiter"
- 31 Oct "I can leave this as it is, I want to test the frequency mixing with the PLL. That is my end goal. As long as I have that frequency content going in, I'm happy."
- 31 Oct "-16.46 with amp on, -27.39 with amp off."
- 31 Oct "you misread. I hadn't put in the PLL yet. This is with vivaldi to power limiter to 20 db to amp to 29 db to kitty. "-16.46 with amp on, -27.39 with amp off.""
- 31 Oct "I have the ZX05-14LH-S+ mixer. The antenna to power limiter to 20 db to 10+6 db to the mixer RF. on the LO port I have the 8.3 GHz to 10 db the 12 v buffer to the splitter s. One side of the S is capped, the other (port 1) goes to mixer LO. The IF port is going to a 3 dB attenuator into kitty. Good setup?"
- 31 Oct "side 1: vivaldi to power limiter to 20 db to the 6v amp to 6 + 10 db to the RF of the mixer. Side 2: adf to the 12 v amplifier to S of the splitter, port 2 capped at 50 and port 1 to the LO port of the mixer. IF of the mixer goes to 3db to kitty."
- 31 Oct Spike screenshot "I have the 12V and 6 V amp powered. furuno is off. the PLL is driving at 8.3 Ghz, and I see it. is it safe to turn on the furuno?"
- 31 Oct three Spike screenshots, no text (IF near 1.1 GHz, 9.4 GHz, 8.3 GHz)
- 31 Oct two Spike screenshots "-38 at the lower when -19 at the higher frequencies. This is with power on, the splitter still there, and pll still on. I was just looking a second time."
- 31 Oct "with the PLL off I don't see the lower frequency (1.1 GHz) at all."
- 31 Oct "I'm leaving the splitter, since it'll need to be there for the other half (transmit convert up in frequency).,"
- 31 Oct "why would I need that? I can tune the envelope detector reference voltage and have the RF limiting amplifier on the frequency part."
- 31 Oct "in simple words. Are you saying that there is not enough power coming out of the PLL, so the mixer isn't working properly?"
- 31 Oct "so you want a second ZX60-14912L-S+ after the PLL. y/n"
- 31 Oct "save all this to the website. Now that we have a low frequency, I'm going to measure it on the oscilloscope and the SSA 3021X spectrum analyzer to compare. Then I'll put in the frequency identification."
- 31 Oct "The setup: I have the furuno to the power limiter to 20 db to the 6v amp to 16 db to the RF port of the mixer. I have the 8.3 GHz adf to the 12v amp to the splitter (one side 50 ohm) to the LO port. The IF port goes to the oscope (yippie)  and then to the SSA 3021x ( call it  maxxie). You are plugged in to the usb of maxxie and yippie."
- 31 Oct Spike screenshot "I plugged it back into kitty with the 3db as the only new thing (if to 3db to kitty). Nothing else changed."
- 31 Oct "it's connected to maxxie, I took out the 3db attenuator but that is it."
- 31 Oct "show me what you saw on maxxie?"
- 31 Oct "USB is back, radar and PLL are on, retake it."
- 31 Oct "The peak is at 1.103 GHz at -58.52 dBm."
- 31 Oct "I'm putting in the mini circuits splitter ZFRSC-42-S plus, going through two lengths of cable, one which has an extra 4.5 inches that we already tested before, going to the ZX05-30W-S plus with LO and RF connected to the both sides of the splitter so that IF out is just a voltage. the output of the splitter, or the IF out of the mixer, is going to the oscilloscope. Radar is on"
- 31 Oct "nothing is plugged in to the SSA 3021X and yet it is still showing the frequency spectrum from before"
- 31 Oct "I have the ZX60-P103LN+ (three of them)."
- 1 Nov "I have the pluto sdr plugged in to the three amplifiers to the splitter and mixer to get a voltage out. I want to do the calibration from 1 GHz to 1.2 GHz. Then I'll take out the pluto and put in the rest of the chain that we built to see the voltage from the furuno mixed down as the source."
- 1 Nov "you are plgged in to maxxie and yippee"
- 1 Nov "I don't expect to see any frequency spectrum on maxxie, since we just have a steady voltage out of the phase detector. The signal is going in to it and it is on though."
- 1 Nov "the system right now is the pluto to three of the 5V amplifiers zx60-P103LN+ to the ZFRSC-42-S+ splitter to two lengths of cabel to the ZX05-30W-S+ mixer, with the IF port going to the oscilloscope and the SSA 3021. Because the frequency is the same on both RF and LO ports of the mixer, we should just see a voltage that depends on the phase difference between the signals - one side has 4.5 in longer than the other. We tested this before, look at the calibration curves on the website to re familiarize with it."
- 1 Nov "make a plot of frequency from the pluto vs voltage out on the phase detector"
- 1 Nov "take data again from scratch, 1 - 1.2 GHz."
- 1 Nov "show me the plot of the new run"
- 1 Nov "status"
- 1 Nov "look over a wider range, go down to 800 Mhz"
- 1 Nov "so 800 Mhz to 1 Ghz, and add it to the plot"
- 1 Nov "I just realized - should I set the oscilloscope to 50 ohms?"
- 1 Nov "the chain is back in with the furuno on, read yippie"
- 1 Nov "I had forgotten to turn on the PLL. try again"
- 1 Nov "the pll and furuno are on"
- 1 Nov "save the oscope data and plot"
- 1 Nov "time and frequency - use the SSA only use the PLL on data"
- 1 Nov "I can turn off the PLL and deliberately see that, but call the PLL off data from before bad"
- 1 Nov "show me the time and frequency plots. I can also use kitty. should i"
- 1 Nov "I'm put 23 dB attenuators on kitty. You are plugged in. Take data with kitty. The PLL and radar are on."
- 1 Nov "give me settings. Frequency span"
- 1 Nov Spike screenshot (detector output 1.104688 GHz, -68.06 dBm)
- 1 Nov "don't use spike, record the IQ data yourself"
- 1 Nov "spike is closed"
- 1 Nov "now I'll turn off the PLL. After this, save everything to the website. PLL is off."
- 1 Nov "say done when done for any test where you are recording data"
- 1 Nov "and an eta"
- 1 Nov "status"
- 1 Nov "do i need to keep holding the antenna up?"
- 1 Nov "and we don't expect to have any 1 Ghz with the PLL off. Show me the plots from all this data we just took. the main thing I want is the voltage out of the phase detector over time (as the radar is spinning at about 1 rev / 2 seconds)."
- 1 Nov "it was hand held in the same orientation."
- 1 Nov "label PLL off for ones where it is off. Why would we see anything when the PLL is off?"
- 1 Nov "are you applying a filter around 1.105 GHz and then showing what that looks like? I don't understand the 1st vs 3rd row, and second vs 4th row."
- 1 Nov "why did we not see this leaking through with the pluto? I'm plugging it back in for you to control. it is before the three amplifiers and then the phase detector. go"
- 1 Nov "The Pluto's plugged in."
- 1 Nov "Kitty and the Pluto are both on the same USB dongle."
- 1 Nov "moved the pluto, kitty power cycled, go"
- 1 Nov "kitty plugged directly into USB 3, go"
- 1 Nov "try to do this yourself, you have 10 minutes"
- 1 Nov "The Pluto's in. I can see it as drive D, and I can open the kitty in spike."
- 1 Nov "show me plots"
- 1 Nov "what frequency would the VCO spit out if we put in the 240 (what was it?) mV what we read when it was the whole chain from the furuno?"
- 1 Nov "I probably need an FPGA with a look up table of voltage in to voltage out to control the FPGA to reproduce the tone from after the mix down."
- 1 Nov "because of this I want to put the PLL to get our map between 900 Mhz to 1100 MHz, instead of 1 Ghz to 1.2 GHz. What freq for the PLL?" (with screenshot of the 800 to 1200 MHz Pluto calibration plot)
- 1 Nov "Right now, you are plugged into the Pluto, which is going into the three amplifiers and the phase detector, which is going to the digital oscilloscope and to Kitty. You are plugged into the Pluto, Kitty, and the oscilloscope, although the USB connections keep joining and disconnecting. I want to test over the entire range of the Pluto what we get out as a voltage from the phase detector so that I can find the best range that we should map onto using the PLL."
- 1 Nov "I unplugged, continue where you left off"
- 1 Nov "it is plugged in now"
- 1 Nov "retake all data"
- 1 Nov "status update"
- 1 Nov "I just came back"
- 1 Nov "the pluto is plugged in to the amps -> detector. Do you need any more data?"
- 1 Nov "both are in"
- 1 Nov "do you have anything from kitty? she is plugged in"
- 1 Nov "while this test is running, check if you can read from kitty."
- 1 Nov "I want to be able to leave for a while while you take data and explore"
- 1 Nov "kitty replugged into USB 3, go ahead"
- 1 Nov "take two hours to measure what you want"
- 1 Nov "checking in"
- 1 Nov "show plots as you get them, and upload them to the website"
- 1 Nov "I want the plot of input power and frequency vs output voltage from the phase detector mainly."
- 1 Nov "kitty is back in"
- 1 Nov "i accidentally very briefly unplugged the oscilloscope when I did kitty, but only for a second. Did it cause any problems? this was a minute or so ago"
- 1 Nov "the bottom color plot here is meaningless. Just have curves for each power level, with output mv and input frequency as the axis."
- 1 Nov "are there different allowed frequency ranges that the pluto can transmit depending on the power? Why are the frequency axis different?"
- 1 Nov "also send only when the whole plot is done."
- 1 Nov "also make sure that you are staying safe with Kitty's allowed power in"
- 1 Nov "knowing that we have the attenuators. What attenuators do I have on there?"
- 1 Nov "it is 23 db on kitty"
- 1 Nov "show the plot so far"
- 1 Nov "what are your other tests"
- 1 Nov "kitty is plugged in right now, try reading again"
- 1 Nov "I can put in a zx60-P162LN+ amplifier (i have four). Would that help the power input dependence?"
- 1 Nov "What if i replaced the three amplifiers that are currently in (the P103) with these P162?"
- 1 Nov "and I think I should be safe with four of them. What is the +12.8 dB, cap? is that the recieved power at kitty, or the power before the attenuators?"
- 1 Nov "explain again, where is the cap from?"
- 1 Nov "I want to put in four amplifiers as long as I won't damage any circuitry. The pluto is driving them and won't be damaged. Recalculate, measure, and then adjust and measure - stay safe to not damage anything but explore the space as well as you can. Y/N should I put in the 4 amps?"
- 1 Nov "i just unplugged stuff, turn off the pluto"
- 1 Nov "four amps are in at 4 V, everything plugged back in, go"
- 1 Nov "the oscilloscope is turning on. Give it 5 seconds"
- 1 Nov "its on"
- 1 Nov "drawing 0.216 A at 4.01 V for the amplifiers"
- 1 Nov "You have an hour. I am about to leave again. Do you need anything physical?"
- 1 Nov "The supply is right now 4.01 V, 2.17 (but fluctuating to 2.83 rarely - mostly staying at 2.16 - 2.23 ish amps). This is a the KUAIQU dc power supply."
- 1 Nov "0.216"
- 1 Nov "dont stop working and taking data until i tell you or there is nothing else feasibly useful to measure with the super expensive equipment you have"
- 1 Nov "status upsate"
- 1 Nov "the computer turned off, check what is good and working. kitty is unplugged, but plugging back in"
- 1 Nov "she is connected"
- 1 Nov "i unplugged since I can't have power and enough USB cabels at once. Keep going. I know about the charge"
- 1 Nov "show the plot so far"
- 1 Nov "kitty is plugged in and working"
- 1 Nov "at higher power levels, things would break - yes? what is the maximum power that we are allowed to put in to the splitter and the mixer? am I allowed to put in a 5th amplifier?"
- 1 Nov "so if we were getting power from the furuno, what dBm range would we expect it to land at? We are amplifying and mixing it down. If we are railing out the signal no matter the power, shouldn't we be on a single dBm curve? What is the maximum power that we could receive through the vivaldi before something breaks? What distance from the radar would that correspond to?"
- 1 Nov "whoops, I had turned off the amps for a second."
- 1 Nov "now try"
- 1 Nov "i see 0.22 amps"
- 1 Nov "I changed to a new power supply when I had turned off the amps, this is an Agilent E3630A at 3.94V and about 0.25A. Maybe the better / less noisy power supply did it?"
- 1 Nov "the computer is getting to low battery. I am going to move kitty to the dongle."
- 1 Nov "still all good?"
- 1 Nov "it is plugged in. Kitty is in. something keeps connecting and disconnecting, making a sound on the computer. Why?"
- 1 Nov "I accidentally briefly unplugged the oscilloscope when I meant to unplug kitty"
- 1 Nov "it is all good now though"
- 1 Nov "show me plots"
- 1 Nov "also put a zoomed in plot with pluto level from 900 to 1200"
- 1 Nov "actually from wherever the minimum around 900 is -  850 or 900 or smth"
