Sorin-Jayaweera/Panthalassa-Clinic-Team/phase_detector_calibration/site/index.html

# JACON engineering notes

Read onlyEdit Expand all Collapse all Download backup (.html) validated under question Loading

SchematicPart infoLimiterLNARX mixerIF ampLO bufferImage filterSplitterPhase detectorEnvelope detectorComparatorVCOPlutoRadarRaconTest gearLook up tablesTests to runErrorsReview notes

## Schematic

Click a block to open that part.

Green, every test in its plan done: 0Yellow, some tests done: 12Grey, on hand, not tested: 7Dashed, not on hand or not chosen: 4

Show in each block:SpecsData taken

### What has been tested

Block | Part | Status | Done | Not done
RX antenna | Vivaldi R120 on test | Some tests done | Vivaldi: S11 on the VNA, and over the air from the Furuno | Antenna gain (8 dBi is assumed). The horn
Power limiter | HLM-20PSM | Some tests done | VNA sweep: 1.7 dB loss at 9.4 GHz. Over the air: +16.1 dBm out at 3.96 m | Clamp curve with a clean leak floor, leading edge
LNA | ZX60-5123LN+ | Some tests done | Supply current. Gain about 23 dB at 9.4 GHz, over the air | Gain vs frequency, compression, noise figure, stray signals
RX mixer | ZX05-14LH-S+ | Some tests done | Mix-down of the radar to about 1.105 GHz, IF about -36 dBm, with about -6 dBm of LO | Conversion loss vs frequency and LO power, compression, leakage, image
RF limiting amp | 4 x ZX60-P162LN+ on test | Some tests done | 3 x ZX60-P103LN+ and 4 x ZX60-P162LN+ with the Pluto: detector voltage vs frequency and power, 700 to 1600 MHz. 3 x P103 with the radar | 4 x P162 with the radar, pulses rather than a steady tone. Part not chosen
Delay-line splitter | ZFRSC-42-S+ | Some tests done | Loss 6.70 and 6.72 dB at 1.04 GHz. In the detector chain in every test above | Loss vs frequency, isolation
Phase detector | ZX05-30W-S+ | Some tests done | Voltage vs frequency alone and after the amps, step response, noise, drift, VNA of the ports | Different delay cables, 4 x P162 chain with the radar, one sweep on its own from 900 to 1200 MHz
Envelope detector | ADL5511 | Some tests done | Voltage vs input power at 1.0, 1.1 and 1.2 GHz (flat within 0.1 dB). Pulse height at 10 and 100 us equals CW within 1-3 % | Its 4 ns rise and 50 ns-1.2 us pulses (needs the scope). Absolute power check of the Pluto on the spectrum analyzer
LO splitter | ZX10-2-1252-S+ | Some tests done | In the LO path for the radar mix-down, tests 35 to 42 | Its own loss
LO buffer amp | ZX60-14012L-S+ | Some tests done | Gain and compression at 1.0 to 1.2 GHz. In the LO path for the mix-down | Gain and compression at 8.3 GHz, power at the mixers, harmonics
PLL LO | ADF5355 | Some tests done | Set to 8.3 GHz. 8.300 GHz seen at the mixer IF port | Power at the mixers (about -6 dBm against +10 wanted), control from the FPGA
VCO | CVCO55BE-0800-1600 | Some tests done | Frequency vs voltage, output power, step response, drift | Computer-run sweep over 4.8 to 7.8 V
IF amp | P103LN / 2534MA | Not tested | Nothing in this position. The ZX60-P103LN+ was tested as the limiting amp | All tests in the plan. ZX60-2534MA-S+ not used
IF splitter | ZFRSC-42-S+ | Not tested | Nothing in this position. Same part as the delay-line splitter | All tests in the plan
Comparator | ADCMP604 | Not tested | Nothing | All tests in the plan
FPGA | Icepi Zero (ECP5) | Not tested | Nothing | All of it
TX antenna | horn | Not tested | Nothing | All of it
Image filter | VHF-8400+ | Not tested | Nothing | All tests in the plan
TX mixer | ZX05-14LH-S+ | Not tested | Nothing in this position. Same part as the RX mixer | All tests in the plan
Sample and hold | ADG1211 + ADA4622 | Not on hand | Nothing | Not on hand
DAC | nanoDAC | Not on hand | Nothing | Not on hand. CGR-201 output for now
Power amp | not chosen | Not on hand | Nothing | Not chosen
Keying switch | ADG901 | Not on hand | Nothing | Not on hand

## Part info

One row per part. The datasheet link is under the part name. V rms is into 50 Ω. “Band” for the worst case is 1.0–1.2 GHz for IF parts and 9.3–9.5 GHz for RF parts. Negative dB is loss, positive is gain. “Not looked up” means the number is in the datasheet but has not been copied here yet.

Part | Band | Max in dBm | Max in mW | Max in V rms | Typical dB | Worst dB in band | Measured | Other specs | Source
VCO Crystek CVCO55BE-0800-1600 DigiKey (https://www.digikey.com/en/products/detail/crystek-corporation/CVCO55BE-0800-1600/1643988) | 800–1600 MHz | no RF input | — | tuning 0.5–19 V | output +6 dBm (4.0 mW, 0.45 V rms) | output +4 dBm (2.5 mW, 0.35 V rms) | +4.8 to +7.4 dBm, 1.0–1.2 GHz | Vcc 11.5 V used; 30 mA max; pushing 2 MHz/V; 2nd harmonic −10 dBc | DigiKey listing
Splitter (delay line, and IF) Mini-Circuits ZFRSC-42-S+ PDF (https://sorin-jayaweera.github.io/Panthalassa-Clinic-Team/datasheets/ZFRSC-42.pdf) | DC–4200 MHz | 28.8 | 750 | 6.12 | −6.0 per output | −6.5 per output | −6.7 at 1.04 GHz, with connectors | isolation 6.5 dB typ; amplitude unbalance 0.2 dB max; phase unbalance 3° max; internal dissipation 0.375 W max | datasheet
Mixer (phase detector), RF port Mini-Circuits ZX05-30W-S+ PDF (https://sorin-jayaweera.github.io/Panthalassa-Clinic-Team/datasheets/ZX05-30W-S.pdf) | 300–4000 MHz, IF DC–950 MHz | 17.0 | 50 | 1.58 | −6.4 conversion loss at 1.1 GHz | −9.0 conversion loss | as phase detector: 30 to 146 mV DC out | LO level +7 dBm (5.0 mW, 0.50 V rms); IF current 40 mA max; LO–RF isolation 35 typ / 17 min; LO–IF isolation 16 typ / 7 min; 1 dB compression +1 dBm; RF VSWR 2.8–3.5 near 1 GHz | datasheet
SMA cables — | — | — | — | — | — | — | −0.04, −0.09, −0.21 at 1.04 GHz | extra delay cable 4.5 in = 0.55 ns | measured 6 Oct
Pluto SDR (test source) ADALM-PLUTO ADI wiki (https://wiki.analog.com/university/tools/pluto/users/transmit) | used at 1.0–1.2 GHz | no RF input used | — | — | output max +11 dBm (12.6 mW, 0.79 V rms) | — | — | — | team notes
RX antenna horn planned; Vivaldi R120 (5–13 GHz) used for tests | 8.2–12.4 GHz | — | — | — | +10 to +15 dBi | — | horn not tested; Vivaldi S11 and over the air on the Radar tab | — | design drawing
Power limiter Marki EVAL-HLM-20P (HLM-20PSM chip) Marki datasheet (https://markimicrowave.com/products/surface-mount/limiters/hlm-20psm/datasheet/) | DC–20 GHz | +37.0 (5 W average; 50 W peak) | 5000 | 15.8 | −0.5 loss (0.7 at 10 GHz) | −1.5 loss (max) | partly: over the air, 25 Oct (Limiter tab) | flat leakage +17 dBm at 1 GHz, +13 dBm at 20 GHz; input P1dB +15 dBm; recovery 8 ns; spike leakage 0.1 erg; return loss 15 dB. Input side faces the antenna | datasheet
LNA Mini-Circuits ZX60-5123LN+ PDF (https://sorin-jayaweera.github.io/Panthalassa-Clinic-Team/datasheets/ZX60-5123LN.pdf) | 5.5–12.5 GHz | 15.0 | 31.6 | 1.26 | +22.0 | +19.0 (min gain) | partly: 0.08 A at 6 V; ≈ 23 dB over the air (LNA tab) | supply 6 V typ (5–10 V; 12 V abs max), 80 mA (95 max); noise figure 1.4 dB; P1dB out +17 dBm; OIP3 +29.5 dBm | datasheet
RX mixer and TX mixer Mini-Circuits ZX05-14LH-S+ PDF (https://sorin-jayaweera.github.io/Panthalassa-Clinic-Team/datasheets/ZX05-14LH-S.pdf) | RF/LO 3.7–10 GHz, IF DC–4 GHz | 17.0 | 50 | 1.58 | −6.7 conversion loss (−7.7 at 9.4 GHz) | −9.5 conversion loss | not tested | LO level +10 dBm (10 mW, 0.71 V rms); 1 dB compression +5 dBm in; LO–RF isolation 35 typ / 25 min; LO–IF 17 typ / 9 min; RF VSWR 4.0 at 9.4 GHz | datasheet
IF amp Mini-Circuits ZX60-P103LN+ PDF (https://sorin-jayaweera.github.io/Panthalassa-Clinic-Team/datasheets/ZX60-P103LN.pdf) | 50–3000 MHz | 21.0 | 126 | 2.51 | +15.6 at 1 GHz | +13.5 (min gain at 1 GHz) | not tested | supply 5.0 V (5.5 V abs max), 95 mA (120 max); noise figure 0.5 dB; P1dB out +22.4 dBm | datasheet
IF amp (alternative) Mini-Circuits ZX60-2534MA-S+ PDF (https://sorin-jayaweera.github.io/Panthalassa-Clinic-Team/datasheets/ZX60-2534MA.pdf) | 500–2500 MHz | −15.0 | 0.032 | 0.040 | +43.5 at 1 GHz | +38 (min gain at 2 GHz) | not tested | supply 5.0 V (7 V abs max), 170 mA (190 max); noise figure 2.3 dB; P1dB out +19.2 dBm | datasheet
IF amp (alternative) Mini-Circuits ZX60-P162LN+ PDF (https://sorin-jayaweera.github.io/Panthalassa-Clinic-Team/datasheets/ZX60-P162LN.pdf) | 700–1600 MHz | 25.0 | 316 | 3.98 | +22.5 at 1 GHz | +20.9 (min gain at 1 GHz) | not tested | supply 4.0 V (3.8–4.2; 5.5 V abs max), 52 mA; noise figure 0.52 dB; P1dB out +19.9 dBm | datasheet
RF limiting amp not chosen; 3 x ZX60-P103LN+ and 4 x ZX60-P162LN+ tried | 1.0–1.2 GHz | — | — | — | — | — | partly: Radar tab and Look up tables | output must stay under +23.5 dBm (mixer limit +17 dBm plus 6.5 dB splitter loss) | design drawing
Envelope detector Analog Devices ADL5511 (ADL5511-EVALZ) PDF (https://www.analog.com/media/en/technical-documentation/data-sheets/adl5511.pdf) | DC–6 GHz | +19 (+17 top of the ±1 dB range) | 79 | 2.0 | VENV 1.47 V per V rms at 1.1 GHz | — | 1.47–1.51 V/V at 1.1 GHz; floor −30 dBm; flat 1.0–1.2 GHz within 0.1 dB; pulse height = CW within 1–3 %; 26 Oct and 1 Nov (Envelope detector tab) | supply 5 V (4.75–5.25; 5.5 abs max), 21.5 mA; EREF 1.1 V; VENV load ≥ 500 Ω, ≤ 10 pF, never 50 Ω; 130 MHz, 4 ns rise; VRMS 1.91 V/V | datasheet
Comparator Analog Devices ADCMP604 on hand (EVAL-ADCMP604BKSZ); the drawing says ADCMP600 PDF (https://www.analog.com/media/en/technical-documentation/data-sheets/ADCMP604_605.pdf) | DC input, 500 MHz input bandwidth | — | — | VCC + 0.5 V (DC) | — | — | not tested | supply 2.5–5.0 V, 15 mA; inputs −0.5 to VCC + 0.5 V; 1.6 ns delay; hysteresis under 0.1 mV; LVDS output, 350 mV into 100 Ω | datasheet
DAC Analog Devices nanoDAC | — | — | — | — | — | — | not tested | sets the comparator threshold; for now the CGR-201 output (DC) through 1 kΩ | design drawing
FPGA PYNQ-Z2 or ECP5; Icepi Zero (ECP5) on hand, with an AD9280/AD9708 ADC/DAC board | — | — | — | — | — | — | not tested | comparator LVDS output needs an ECP5 differential input or an LVDS receiver | design drawing
Sample and hold ADG1211 switch, 100 pF, ADA4622-1 op-amp | — | — | — | — | — | — | not tested | must output 4.8–7.8 V for the VCO | design drawing
PLL local oscillator Analog Devices ADF5355 module | set to 8.3 GHz | — | — | — | — | — | partly: used for the mix-down, Radar tab tests 35 to 42 | — | design drawing
LO buffer amp Mini-Circuits ZX60-14012L-S+ PDF (https://sorin-jayaweera.github.io/Panthalassa-Clinic-Team/datasheets/ZX60-14012L-S.pdf) | 0.3 MHz–14 GHz | 10.0 | 10 | 0.71 | +12 (+12.5 at 8 GHz) | +9 (min gain) | not tested | supply 12 V (10.5–20 V), 62 mA (68 max); P1dB out +11 dBm (+12.2 at 8 GHz); noise figure 5.5 dB | datasheet
LO splitter Mini-Circuits ZX10-2-1252-S+ PDF (https://sorin-jayaweera.github.io/Panthalassa-Clinic-Team/datasheets/ZX10-2-1252-S.pdf) | 1.8–12.5 GHz | 32.7 | 1850 | 9.62 | −4.1 per output at 8.3 GHz (3.0 split + 1.1) | −4.4 per output (3.0 + 1.4) | partly: in the LO path, Radar tab tests 35 to 42; own loss not measured | isolation 19.9 dB typ, 13 min; phase unbalance 8.1° typ; passes DC up to 0.4 A; the 0.7 dB on the drawing is the 1.8–3.8 GHz value | datasheet
Keying switch Analog Devices ADG901 (EVAL-ADG901EBZ) PDF (https://www.analog.com/media/en/technical-documentation/data-sheets/ADG901_902.pdf) | DC–2.5 GHz (−1 dB), −3 dB at 4.5 GHz | +7 at 0 V DC bias (+16 with 0.5 V bias; +18 abs max) | 5.0 | 0.50 | −0.8 loss at 1 GHz; isolation 37–40 dB | −1.25 loss at 1 GHz | not tested | supply 1.65–2.75 V (4 V abs max); CTRL must stay at or under VDD, so 3.3 V and 5 V logic need a divider; on 3.6 ns, off 5.8 ns; ESD 1 kV | datasheet
Image reject filter Mini-Circuits VHF-8400+ PDF (https://sorin-jayaweera.github.io/Panthalassa-Clinic-Team/datasheets/VHF-8400.pdf) | passband 9.0–13.0 GHz | 38.5 | 7000 | 18.7 | −1.4 to −1.6 at 9.3–9.5 GHz (drawing estimate) | −3.0 at 9.0–9.5 GHz | not tested | 3 dB point 8.4 GHz; rejection 30 dB typ below 5.7 GHz, 20 dB min below 6.0 GHz; not specified at 7.1–7.3 GHz (drawing estimate 24–28 dB) | datasheet
Power amp not chosen | 9.3–9.5 GHz | — | — | — | — | — | not tested | output about 1 W (30 dBm, 1000 mW, 7.07 V rms) | design drawing
TX antenna horn, same as RX | 8.2–12.4 GHz | — | — | — | +10 to +15 dBi | — | not tested | — | design drawing

Power measured on the bench

Point | dBm | mW | V rms (50 Ω) | Note
VCO output at 1.04 GHz | +7.3 | 5.4 | 0.52 | measured 6 Oct
Each splitter output | +0.6 | 1.15 | 0.24 | measured 6 Oct
Mixer RF damage limit | +17.0 | 50 | 1.58 | margin 16.4 dB
Mixer LO level wanted | +7.0 | 5.0 | 0.50 | bench level was 6.4 dB lower

The largest power the mixer has received is about 3 mW (Pluto at 12.6 mW, minus 6 dB in the splitter). Its limit is 50 mW.

Expected power through the RX chain

After | Gain or loss (dB) | Weak radar (dBm) | Strong radar (dBm) | Limit at this point
Antenna | — | −50 | −10
LNA ZX60-5123LN+ | +22 | −28 | +12 | LNA input max +15 dBm; output compresses at +17 dBm
RX mixer ZX05-14LH-S+ | −7.7 | −35.7 | +4.3 or less | mixer input max +17 dBm; compresses above +5 dBm in. +12 dBm in is compressed
IF amp ZX60-P103LN+ | +15.6 | −20.1 | +19.9 or less | amp input max +21 dBm; output compresses at +22.4 dBm
IF splitter ZFRSC-42-S+ | −6.0 | −26.1 | +13.9 or less | splitter input max +28.8 dBm

Antenna levels are from the design drawing. Limiter loss is not included because no limiter is chosen. Gains are datasheet typical values at 9.4 GHz and 1 GHz.

With the ZX60-2534MA-S+ in place of the P103LN the strong-radar input of +4 dBm is 19 dB over its −15 dBm damage limit.

Unit conversions used

\[ P_\text{dBm} = 10\log_{10}\!\left(\frac{P_\text{mW}}{1\ \text{mW}}\right) \qquad P_\text{mW} = 10^{P_\text{dBm}/10} \qquad V_\text{rms} = \sqrt{P \times 50\ \Omega} \]

Example: 50 mW = 0.050 W. V rms = √(0.050 × 50) = 1.58 V. In dBm: 10 log10(50) = 17.0 dBm.

Worst case for the splitter: 6.0 dB split loss + 0.5 dB maximum insertion loss (100–2100 MHz) = 6.5 dB.

Numbers still missing

- Filter rejection at 7.1–7.3 GHz. The datasheet does not give it. It has to be measured.
- PLL output power at 8.3 GHz.
- Crystek’s own datasheet for the VCO. The listed VCO numbers are from the DigiKey page.
- All rows marked “design drawing” are copied from the JACON drawing and have not been checked against datasheets.

Other documents

- Marki mixer basics primer (https://markimicrowave.com/technical-resources/white-papers/mixer-basics-primer/)
- RF Wireless World mixer basics (https://www.rfwireless-world.com/tutorials/rf-mixer-basics)
- Syscomp CGR-201 datasheet (https://sorin-jayaweera.github.io/Panthalassa-Clinic-Team/datasheets/CGR201-Datasheet.pdf)
- Furuno radar installation manual (https://www.psicompany.com/man-prod-info/furuno/Gp1920C/18X4C_19X4C_GP1920C%20Installation%20Manual%20K.pdf)
- Furuno radar operator manual (https://www.instructionsmanuals.com/sites/default/files/2019-06/Furuno-1944CBB-en.pdf)
- Signal Hound SM API documentation (https://signalhound.com/sigdownloads/SDK/online_docs/sm_api/index.html)

Racon requirements: reply within 0.7 µs. Reply frequency within ±3.5 MHz of the radar for pulses shorter than 0.2 µs, ±1.5 MHz for longer pulses. No reply for 100 µs after the previous reply ends.

## Limiter

Marki Microwave EVAL-HLM-20P: the HLM-20PSM limiter chip on an SMA evaluation board. Between the RX antenna and the LNA. Keeps strong radar pulses from damaging the LNA.

Specs

Quantity | Min | Typical | Max | Unit
Frequency range | DC | — | 20 | GHz
Insertion loss, DC–20 GHz | — | 0.5 | 1.5 | dB
Insertion loss at 10 GHz (features list) | — | 0.7 | — | dB
Return loss | — | 15 | — | dB
Input power at 1 dB compression | — | +15 | — | dBm
Flat leakage (output while clamping), at 1 GHz | — | +17 | — | dBm
Flat leakage, at 20 GHz | — | +13 | — | dBm
Flat leakage at 9.4 GHz (straight line between the two) | — | ≈ +15 | — | dBm
Spike leakage (energy let through at a pulse’s leading edge) | — | 0.1 | — | erg
Recovery time after a pulse | — | 8 | — | ns
RF power, average, absolute max | — | — | 5 (+37.0 dBm) | W
RF power, peak (pulsed), absolute max | — | — | 50 (+47.0 dBm) | W

Source: HLM-20PSM datasheet, Rev A (https://markimicrowave.com/products/surface-mount/limiters/hlm-20psm/datasheet/) (electrical specifications, page 4; absolute maximum ratings, page 3) and the EVAL-HLM-20P page (https://markimicrowave.com/products/evaluation-board/limiters/eval-hlm-20p/). No local PDF: Marki’s site refuses scripted downloads, so open the link in a browser.

The board is marked with an input and an output side. The input side goes toward the antenna. Passive: no power supply.

Expected behavior

- Below about +10 dBm in, it is a short piece of line: about 0.5–0.7 dB loss at 9.4 GHz.
- Around +15 dBm in, its diodes start to conduct and the output stops following the input (1 dB compression at +15 dBm in).
- Well above that, the output stays near the flat leakage, about +15 dBm at 9.4 GHz (+13 to +17 dBm across its band), whatever the input, up to 5 W average and 50 W peak.
- For each pulse the leading edge gets through before the diodes turn on (spike leakage, 0.1 erg). After the pulse it recovers in about 8 ns.
- What this means for the LNA (ZX60-5123LN+, absolute max input +15 dBm): the limiter alone does not keep the LNA safe. Put at least 10 dB of pad between them for testing.

\[ P_\text{out} \approx P_\text{in} - 0.5\ \text{dB} \quad (P_\text{in} \ll +15\ \text{dBm}) \qquad P_\text{out} \approx +15\ \text{dBm} \quad (P_\text{in} \gg +15\ \text{dBm at 9.4 GHz}) \]

Test plan

Every step starts with a leak check: the same wiring with a 50 Ω load in place of the antenna. A reading only counts if it is at least 20 dB above that.

# | Test | Wiring | You do | Computer does | Expected | Pass if

1 | Leak floor | 50 Ω load → limiter → pads → SM200B, radar at the test distance | transmit | read the Max Hold peak | below −45 dBm | 20 dB under the readings in 2–4
2 | Loss at low level | Vivaldi → pads → SM200B, then Vivaldi → limiter → pads, radar at 11.3 m | swap the limiter in and out without moving the cable | difference of the two peaks | 0.5–0.7 dB | under 1.5 dB
3 | Clamp curve | same as 2, radar at 11.3, 8, 6, 4, 3 m (or more pads in front of the limiter at one distance) | move the radar or change the front pads | limiter output (reading + pads) vs input (reading without the limiter) | follows the input to about +10 dBm, then flattens near +15 dBm | never above +17 dBm out
4 | Leading edge | as 3 at the closest distance | transmit | I/Q capture at 50 MS/s or faster; look at the first 50 ns of each pulse | a short overshoot | overshoot under the LNA’s +15 dBm

Keep 29 dB of pads after the limiter whenever the SM200B is on it: the limiter can pass up to +17 dBm, and the SM200B’s limit is +20 dBm.

Results

Test (Radar tab number) | Setup | Result | Expected | Trust | Date
Direction | board markings | input side faces the antenna | — | yes | 25 Oct
Radar 8: low level | Vivaldi → limiter → 29 dB, 11.3 m, foam off | −20 dBm (Sorin) / −22.9 dBm (Spike) at the SM200B → +9 / +6.1 dBm out of the limiter | passes, under 1.5 dB loss | fair: about 10 dB above the leak | 25 Oct
Radar 12 vs 11: loss | same, with and without the limiter, 11.3 m | −30.2 vs −29.4 dBm: 0.8 dB | 0.5–0.7 dB | no: both at the leak floor (−31.2 dBm) | 25 Oct
Radar 13: strong signal | same, radar at 3.96 m (13 ft) | −12.9 dBm at the SM200B → +16.1 dBm out of the limiter; no leading-edge spike at 20 ns resolution | +13 to +17 dBm when clamping | partly: the input was not measured, and the leak (−21 to −23 dBm) is only 8–10 dB below | 25 Oct
Radar 14: strong signal, Spike | same as 13 | −15.27 dBm (Sorin’s Spike screenshot; reference level −20 dBm, may be compressed) → +13.7 dBm out | as 13 | low | 25 Oct
Radar 26a: pickup | 50 Ω load → limiter → 10 dB → LNA (off) → 29 dB, 11.5 m | −31 dBm, same as the load alone | — | yes | 26 Oct
Radar 27: in the chain | Vivaldi → limiter → 20 dB → LNA → 19 dB, 11.5 m | chain consistent with 0.8 dB limiter loss and 22–23 dB LNA gain | — | fair | 26 Oct

#### VNA small-signal sweep (8720ES, 31 Oct): EVAL-HLM-20P board, use these

Delta markers off, cal not interpolated (C2 on screen). Includes the evaluation board’s connectors and traces.

Marker | Frequency | S21 (loss) | S12 | S11 (in match) | S22 (out match)
1 | 50 MHz | −0.099 dB | −0.067 dB | −36.16 dB | −39.13 dB
4 | 8.008 GHz | −1.617 dB | −1.166 dB | −12.29 dB | −15.04 dB
2 | 9.400 GHz (radar band) | −1.759 dB | −1.670 dB | −14.40 dB | −13.14 dB
3 | 10.000 GHz | −1.697 dB | −1.943 dB | −13.40 dB | −11.36 dB
5 | 20.046 GHz | −2.237 dB | −2.216 dB | −18.05 dB | −23.64 dB

- Loss at 9.4 GHz is about 1.7 dB, against the datasheet’s 0.5 dB typical, 0.7 dB at 10 GHz and 1.5 dB max. The datasheet figures are for the limiter; how much of the extra is the evaluation board was not measured. This replaces the over-the-air 0.8 dB, which was already marked untrustworthy.
- Match at 9.4 GHz is 13–14 dB return loss (datasheet 15 dB typical).
- S21 and S12 agree within 0.09 dB at 9.4 GHz, but differ by up to 0.45 dB at 8 GHz. The S11 trace is noticeably noisier than S22, so the port 1 connection is worth checking.
- This is a low-level measurement. It says nothing about clamping.

8720ES: limiter S21, absolute markers

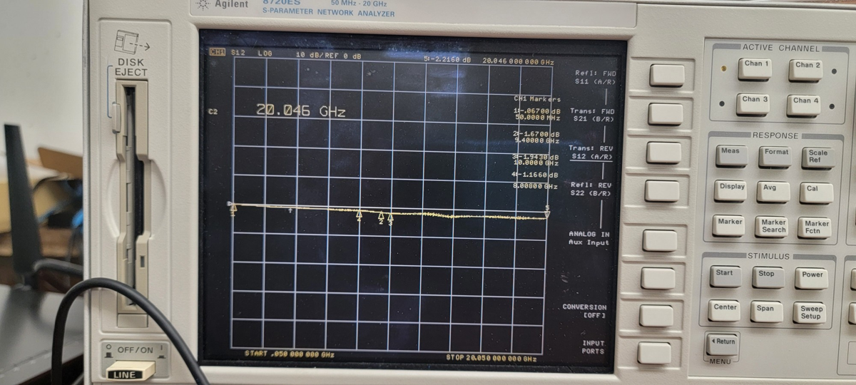
[picture p60: phase_detector_calibration/site/img/vna_limiter_abs_S12.png]
8720ES: limiter S12, absolute markers


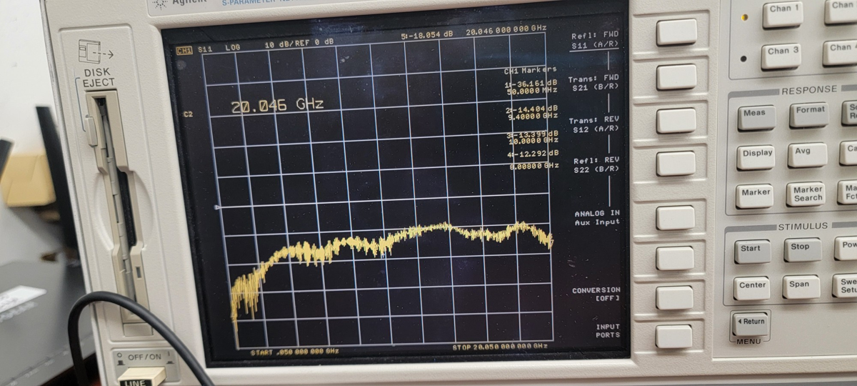
[picture p61: phase_detector_calibration/site/img/vna_limiter_abs_S11.png]
8720ES: limiter S11, absolute markers


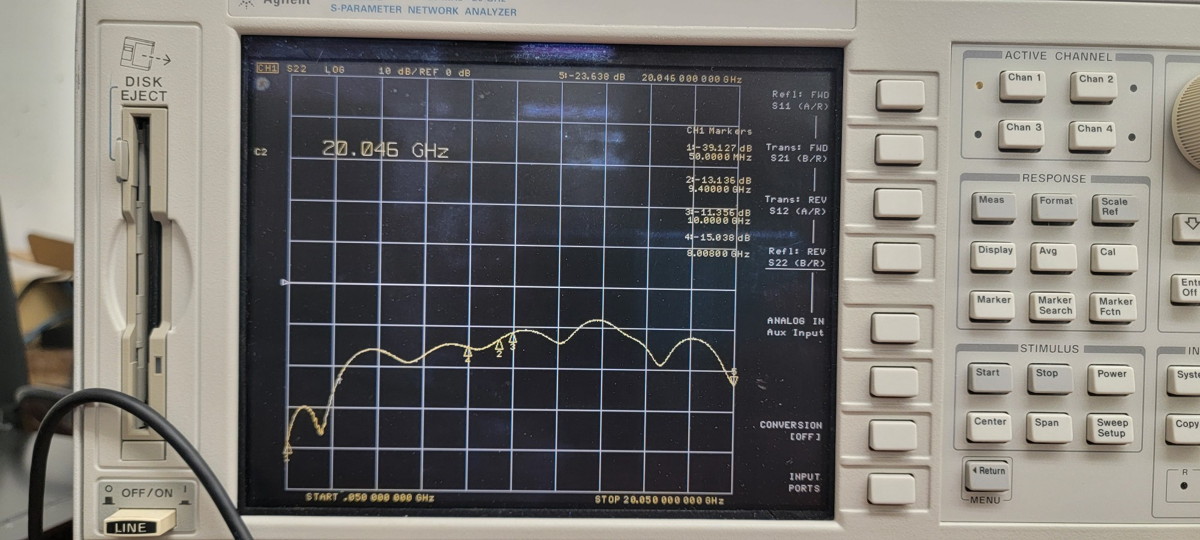
[picture p62: phase_detector_calibration/site/img/vna_limiter_abs_S22.png]
8720ES: limiter S22, absolute markers


#### Earlier VNA sweep: relative readings, superseded

Screens were in delta-marker mode with an interpolated cal (C2Δ, 1601 points), so these are dB relative to a fixed marker whose value is not on screen. Do not read them as loss. Differences within a column are valid: S21 falls 1.7 dB from 50 MHz to 9.4 GHz. S21 and S12 differ by 0.6–1.1 dB at every marker, more than a reciprocal part should; the 10 dB pad, taken on the same setup, shows the same offset, so suspect the setup. This low-level sweep says nothing about clamping.

Marker | Frequency | S21 rel. | S12 rel. | S11 rel. | S22 rel.
1 | 50 MHz | +14.025 | +13.259 | −22.463 | −26.329
4 | 8.008 GHz | +12.646 | +11.839 | +0.181 | −0.705
2 | 9.400 GHz | +12.329 | +11.742 | −1.191 | +4.604
3 | 10.000 GHz | +12.428 | +11.709 | +1.582 | −1.274
5 | 20.048 GHz | +11.860 | +10.800 | −3.543 | −0.131

8720ES: limiter S21, delta markers

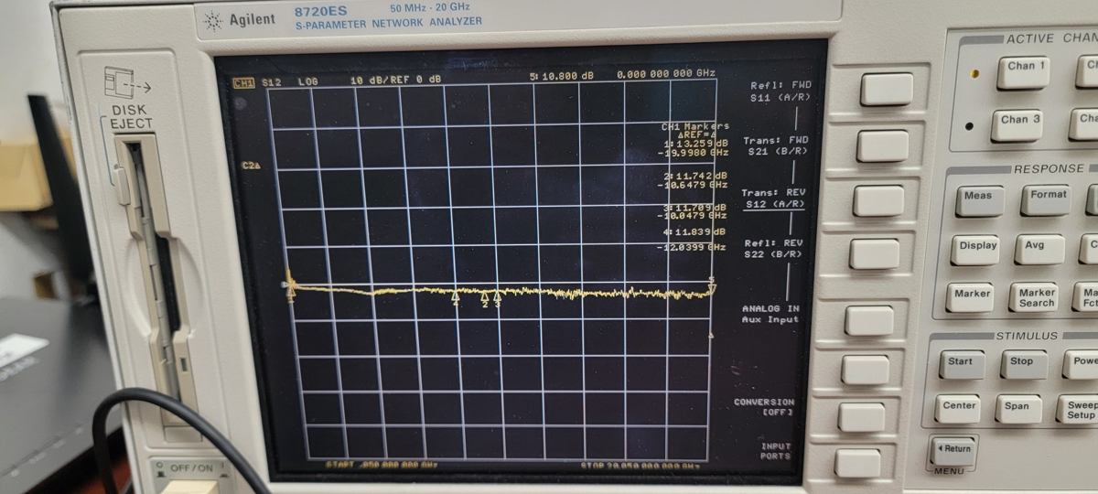
[picture p63: phase_detector_calibration/site/img/vna_limiter_delta_S12.png]
8720ES: limiter S12, delta markers


8720ES: limiter S11, delta markers

8720ES: limiter S22, delta markers

Not yet shown: that it clamps. That needs test 3 with a leak floor at least 20 dB below the readings. Every reading is on the Radar tab, section “Power readings by test”.

## LNA

Mini-Circuits ZX60-5123LN+. First amplifier after the antenna and limiter. 9.3–9.5 GHz.

Specs

Quantity | Min | Typical | Max | Unit
Frequency range | 5.5 | — | 12.5 | GHz
Gain | 19.0 | 22.0 | — | dB
Gain flatness | — | ±0.6 | — | dB
Noise figure | — | 1.4 | — | dB
Output power at 1 dB compression | — | +17.0 | — | dBm
Output IP3 | — | +29.5 | — | dBm
Input return loss | — | 10.5 | — | dB
Output return loss | — | 14.0 | — | dB
Supply voltage | +5 | +6 | +10 | V
Supply current | — | 80 | 95 | mA
RF input power, absolute max | — | — | +15 (31.6 mW, 1.26 V rms) | dBm
Supply voltage, absolute max | — | — | +12.0 | V
Power dissipation, absolute max | — | — | 1.2 | W

The design drawing says “12 V DC operating voltage”. The datasheet operating range is 5 to 10 V, typical 6 V. 12 V is the absolute maximum. Run it at 6 V.

Datasheet (https://sorin-jayaweera.github.io/Panthalassa-Clinic-Team/datasheets/ZX60-5123LN.pdf). Connectors: SMA female in and out. Internal regulator, reverse-voltage protected.

Expected behavior

- Draws about 80 mA at 6 V.
- Adds 22 dB at 9.3–9.5 GHz, flat within ±0.6 dB.
- Weak radar: −50 dBm in gives −28 dBm out.
- Strong radar: −10 dBm in gives +12 dBm out. This is below the +17 dBm compression point.
- Gain starts to drop when the output reaches +17 dBm, which is an input of about −4 dBm.
- With the input terminated in 50 Ω, output noise is about −150.6 dBm/Hz.

\[ P_\text{out} = P_\text{in} + G \qquad N_\text{out} = -174\ \text{dBm/Hz} + NF + G = -174 + 1.4 + 22 = -150.6\ \text{dBm/Hz} \]

Test plan

Needs a 9.3–9.5 GHz source, the SM200B, fixed attenuators good to 10 GHz, and a supply set to 6.0 V with a 120 mA current limit.

# | Test | Wiring | You do | Computer does | Expected | Pass if

1 | Supply current | LNA powered, input and output on 50 Ω loads | set 6.0 V; read the current | nothing | 80 mA | under 95 mA
2 | Gain vs frequency | source → attenuators (so input is −30 dBm) → LNA → 20 dB attenuator → SM200B | connect; then remove the LNA for the reference run | sweep 9.3–9.5 GHz with and without the LNA; subtract | 22 dB | 19 dB or more; flat within ±1 dB
3 | Compression | same | swap attenuators so the input steps from −30 to −2 dBm | read output at each step; find where gain is 1 dB below its low-power value | +17 dBm out | +15 dBm or more
4 | Noise figure | 50 Ω load → LNA → SM200B, no attenuator | connect | read noise density at 9.4 GHz with the LNA on and off | 1.4 dB (−150.6 dBm/Hz out) | under 2.5 dB. Only valid if the SM200B floor is well below −150 dBm/Hz
5 | Stray signals | same as 4 | nothing | sweep 1–20 GHz | noise only | no lines above the noise

Never put more than +15 dBm into the LNA. In test 3 stop at 0 dBm input. Keep the 20 dB attenuator on the output whenever the SM200B is connected.

Results

Test | Result | Expected | Pass? | Date
1. Supply current | 0.08 A at 6.0 V | 80 mA, max 95 mA | pass | 12 Oct
2. Gain vs frequency | partial: one frequency (9.4047 GHz), over the air from the radar: ≈ 23 dB (±2 dB) | 22 dB | pass at 9.4 GHz | 26 Oct
3. Compression | not run | +17 dBm out
4. Noise figure | not run | 1.4 dB
5. Stray signals | not run | none

Test 1: read from the display of an Agilent E3630A supply, 6 V output. Input and output each had a 50 Ω termination. The display reads to 0.01 A, so the current is between 75 and 85 mA.

#### Over the air with the Furuno radar, 25 and 26 Oct (Radar tab test numbers)

Test | Chain | Distance | SM200B (max) | Result | Date
10 | open cable → LNA (6 V, 0.08 A) → 29 dB | 11.3 m | nothing on screen | USB dropout of the SM200B, not the LNA. Current 0.08 A matched the datasheet. No damage. | 25 Oct
18 | Vivaldi → limiter → LNA unpowered → 29 dB | 3.96 m | −10 dBm (Sorin) | Not powered: the limiter can pass +17 dBm, above the LNA’s +15 dBm absolute max input. A 10 dB pad was added before the LNA. | 26 Oct
26a | 50 Ω load → limiter → 10 dB → LNA off → 29 dB | 11.5 m | −31 dBm (Sorin) | leak floor, same as the load alone | 26 Oct
26b | same, LNA on | 11.5 m | −28 dBm (Sorin) | +3 dB: radar pickup before the LNA, amplified, about equals the leak after it. No oscillation. | 26 Oct
26c | 50 Ω load → limiter → 20 dB → LNA on → 19 dB | 11.5 m | −24.06 dBm (Sorin) | leak floor for tests 27 and 28 | 26 Oct
27 | Vivaldi → limiter → 20 dB → LNA on → 19 dB | 11.5 m | −7.94 dBm (Spike) | LNA output +11.1 dBm. Input ≈ −12.1 dBm (antenna +8.7 dBm from test 7, −0.8 dB limiter, −20 dB pad). Gain ≈ 23 dB (datasheet 22). 16 dB over the leak floor. Linear: input 7 dB under the compression point. | 26 Oct
28 | same, LNA off | 11.5 m | −25.85 dBm (Spike) | 17.9 dB below test 27. At the leak floor, so 17.9 dB is only a lower bound on the on/off difference. | 26 Oct

Rules learned: at least 10 dB of pad between the limiter and the LNA (limiter output up to +17 dBm, LNA absolute max input +15 dBm). At 11.5 m from this radar, 20 dB before the LNA keeps it linear. Always measure the leak floor (a 50 Ω load in place of the antenna) for the same wiring first.

## RX mixer

Mini-Circuits ZX05-14LH-S+. Converts 9.3–9.5 GHz to 1.0–1.2 GHz with an 8.3 GHz LO. The TX mixer is the same part.

Specs

Quantity | Min | Typical | Max | Unit
LO and RF frequency | 3700 | — | 10000 | MHz
IF frequency | DC | — | 4000 | MHz
LO power | — | +10 (10 mW, 0.71 V rms) | — | dBm
Conversion loss, 6200–10000 MHz | — | 6.7 | 9.5 | dB
Conversion loss at RF 9.0 GHz (typical data) | — | 6.88 | — | dB
Conversion loss at RF 9.4 GHz (typical data) | — | 7.72 | — | dB
LO–RF isolation, 6200–10000 MHz | 25 | 35 | — | dB
LO–IF isolation, 6200–10000 MHz | 9 | 17 | — | dB
RF input at 1 dB compression | — | +5 | — | dBm
IP3 | — | 14 | — | dBm
RF port VSWR at 9.4 GHz (typical data) | — | 4.01 | — | :1
LO port VSWR at 8.2 GHz (typical data) | — | 2.18 | — | :1
RF power, absolute max | — | — | 50 mW (+17 dBm, 1.58 V rms)

Datasheet (https://sorin-jayaweera.github.io/Panthalassa-Clinic-Team/datasheets/ZX05-14LH-S.pdf). Ports: LO = 2, RF = 3, IF = 1. The datasheet conversion loss is measured at a 30 MHz IF. Ours is 1.0–1.2 GHz, so expect some difference.

Expected behavior

- IF frequency = RF − 8.3 GHz. 9.3 GHz gives 1.0 GHz. 9.5 GHz gives 1.2 GHz.
- Output is about 7 to 8 dB below the RF input.
- Weak radar: −28 dBm in gives about −36 dBm out.
- Strong radar: +12 dBm in. This is above the +5 dBm compression point, so the output will be less than +4 dBm and distorted. It is below the +17 dBm damage limit.
- LO leaks to the IF port 17 dB down: +10 − 17 = −7 dBm at 8.3 GHz. For a weak radar this is 29 dB stronger than the wanted signal.
- LO leaks to the RF port 35 dB down: −25 dBm at 8.3 GHz going back toward the LNA.
- A signal at 7.1–7.3 GHz gives the same IF as 9.3–9.5 GHz. The drawing has no filter before this mixer.

\[ f_\text{IF} = f_\text{RF} - f_\text{LO} \qquad P_\text{IF} = P_\text{RF} - L_c \qquad f_\text{image} = 2 f_\text{LO} - f_\text{RF} \]

Test plan

Needs the 8.3 GHz LO at +10 dBm (measure it first), a 9.3–9.5 GHz source, and the SM200B.

# | Test | Wiring | You do | Computer does | Expected | Pass if

1 | LO level | LO chain → SM200B | set the PLL to 8.3 GHz | read frequency and power | +10 dBm at 8.300 GHz | +7 to +13 dBm
2 | Conversion loss vs frequency | source at −20 dBm → RF port 3; LO → port 2; IF port 1 → SM200B | connect | step RF 9.3–9.5 GHz; read the IF at 1.0–1.2 GHz; subtract from the RF level | 7 to 8 dB | under 9.5 dB
3 | Conversion loss vs LO power | same, attenuators in the LO line | swap LO attenuators: +4, +7, +10, +13 dBm | repeat test 2 at 9.4 GHz | lowest loss near +10 dBm | loss changes less than 1 dB from +7 to +13
4 | Compression | same as 2 | swap RF attenuators: −20 to +5 dBm | read IF at each step | 1 dB compression at +5 dBm RF | +3 dBm or more
5 | LO leakage | same as 2 | nothing | read 8.3 GHz at the IF port; move the SM200B to the RF port and read again | −7 dBm at IF; −25 dBm at RF | IF under +1 dBm; RF under −15 dBm
6 | Image | same as 2, source at 7.1–7.3 GHz | retune the source | read the IF | same level as test 2 | recorded; decides if an RX filter is needed

RF input limit is +17 dBm. Stay at +5 dBm or below.

Results

None of the tests above has been run as a test of this mixer on its own. It has been used to mix the radar down, Radar tab tests 35 to 39: IF about −36 to −38 dBm near 1.105 GHz, apparent conversion loss about 30 dB with about −6 dBm of LO, against 7.72 dB in the datasheet at +10 dBm LO. With the PLL off there was no 1.1 GHz signal (test 36c).

## IF amp

Amplifies the 1.0–1.2 GHz signal after the RX mixer. Three candidates.

Specs

Quantity | ZX60-P103LN+ | ZX60-2534MA-S+ | ZX60-P162LN+
Frequency range | 50–3000 MHz | 500–2500 MHz | 700–1600 MHz
Gain at 1.0 GHz, typical | 15.6 dB (min 13.5) | 43.5 dB | 22.5 dB (min 20.9, max 24.5)
Gain at 1.1–1.3 GHz | between 15.6 (1 GHz) and 10.0 (2 GHz) | 43.7 to 43.8 dB | 20.5 dB at 1.3 GHz
Noise figure at 1 GHz | 0.5 dB | 2.3 dB | 0.52 dB (max 0.95)
Output at 1 dB compression, 1 GHz | +22.4 dBm | +19.2 dBm | +19.9 dBm (min +17.5)
Output IP3 at 1 GHz | +39.4 dBm | +16 dBm | +29.9 dBm
Input VSWR at 1 GHz | 1.65 | 1.71 | 1.19
Output VSWR at 1 GHz | 1.47 | 1.20 | 1.38
Supply voltage | 5.0 V | 5.0 V (or 2.8 V) | 4.0 V (3.8 to 4.2)
Supply current | 95 mA (max 120) | 170 mA (max 190) | 52 mA (44 to 60)
Supply voltage, absolute max | 5.5 V | 7 V | 5.5 V
RF input, absolute max | +21 dBm (126 mW, 2.51 V rms) | −15 dBm (0.032 mW, 0.040 V rms) | +25 dBm (316 mW, 3.98 V rms)
Power dissipation, absolute max | — | 0.5 W | —
Datasheet | PDF (https://sorin-jayaweera.github.io/Panthalassa-Clinic-Team/datasheets/ZX60-P103LN.pdf) | PDF (https://sorin-jayaweera.github.io/Panthalassa-Clinic-Team/datasheets/ZX60-2534MA.pdf) | PDF (https://sorin-jayaweera.github.io/Panthalassa-Clinic-Team/datasheets/ZX60-P162LN.pdf)

The ZX60-2534MA-S+ is damaged by more than −15 dBm at its input. The design drawing gives the IF level as −37 to +3 dBm. A strong radar would destroy it. It also compresses once its input passes about −24 dBm.

Expected behavior

| ZX60-P103LN+ | ZX60-2534MA-S+
Weak radar, −36 dBm in | −20 dBm out | +7.5 dBm out
Strong radar, +3 dBm in | +18.6 dBm out, below compression | input is 18 dB over the damage limit
Input where output compresses 1 dB | +7.8 dBm | −23.3 dBm
After the IF splitter (−6 dB), strong radar | +12.6 dBm at each output | —

\[ P_\text{in,1dB} = P_\text{out,1dB} - (G - 1) \qquad \text{P103LN: } 22.4 - 14.6 = +7.8\ \text{dBm} \qquad \text{2534MA: } 19.2 - 42.5 = -23.3\ \text{dBm} \]

- The P103LN handles the whole −37 to +3 dBm range without damage or compression.
- The 2534MA can only be used where the input is always below −24 dBm.
- The drawing lists the P103LN gain as 13 dB. The datasheet gives 15.6 dB typical at 1 GHz, 13.5 dB minimum.

Test plan

Needs the Pluto as a 1.0–1.2 GHz source, the SSA3021X or SM200B, and fixed attenuators. Measure the Pluto output level first with nothing else connected.

#### ZX60-P103LN+

# | Test | Wiring | You do | Computer does | Expected | Pass if

1 | Supply current | amp powered, input and output on 50 Ω loads | set 5.0 V, limit 150 mA; read the current | nothing | 95 mA | under 120 mA
2 | Gain vs frequency | Pluto → 30 dB attenuator → amp → 20 dB attenuator → analyzer | connect; then remove the amp for the reference run | step 1.0–1.2 GHz with and without the amp; subtract | 15.6 dB at 1.0 GHz, about 14.5 dB at 1.2 GHz | 13.5 dB or more at 1.0 GHz
3 | Compression | Pluto → attenuator → amp → 20 dB attenuator → analyzer | swap input attenuators so the input steps from −20 to +9 dBm | read output at each step | +22.4 dBm out, at +7.8 dBm in | +20 dBm or more

#### ZX60-2534MA-S+

Keep at least 40 dB of attenuation between the Pluto and this amp at all times. Its input limit is −15 dBm and the Pluto can put out +11 dBm.

# | Test | Wiring | You do | Computer does | Expected | Pass if

1 | Supply current | amp powered, input and output on 50 Ω loads | set 5.0 V, limit 220 mA; read the current | nothing | 170 mA | under 190 mA
2 | Gain vs frequency | Pluto → 60 dB attenuation (input −50 dBm) → amp → 30 dB attenuator → analyzer | connect; then remove the amp for the reference run | step 1.0–1.2 GHz with and without the amp; subtract | 43.5 to 43.7 dB | 38 dB or more
3 | Compression | same, less input attenuation | swap attenuators so the input steps from −50 to −20 dBm. Do not go above −20 dBm. | read output at each step | +19 dBm out, at about −23 dBm in | +17 dBm or more

Results

None of the tests above has been run on a single amp. In the detector chain, in the RF limiting amp position: 3 x ZX60-P103LN+ (Radar tab, test 41 on) and 4 x ZX60-P162LN+ (test 50 on). See Look up tables.

## LO buffer

Mini-Circuits ZX60-14012L-S+. Amplifies the 8.3 GHz LO from the PLL before the LO splitter.

Specs

Quantity | Min | Typical | Max | Unit
Frequency range | 0.0003 | — | 14 | GHz
Gain | 9 | 12 | — | dB
Gain at 8 GHz (typical data) | — | 12.55 | — | dB
Gain flatness | — | ±1.0 | ±2.0 | dB
Output power at 1 dB compression | 9 | 11 | — | dBm
Output at 1 dB compression, 8 GHz (typical data) | — | 12.25 | — | dBm
Output at 1 dB compression, 9 GHz (typical data) | — | 11.18 | — | dBm
Noise figure | — | 5.5 | 7.5 | dB
Output IP3 | — | 20 (17.8 at 8 GHz) | — | dBm
Input VSWR / output VSWR at 8 GHz | — | 1.34 / 1.65 | — | :1
Supply voltage | 10.5 | 12 | 20 | V
Supply current | — | 62 | 68 | mA
RF input, absolute max | — | — | +10 (10 mW, 0.71 V rms) | dBm
Supply voltage, absolute max | — | — | 20 | V

Datasheet (https://sorin-jayaweera.github.io/Panthalassa-Clinic-Team/datasheets/ZX60-14012L-S.pdf). Internally regulated. Reverse-voltage protected.

Expected behavior

- Draws about 62 mA at 12 V.
- Adds about 12.5 dB at 8.3 GHz.
- The most it can put out at 8.3 GHz is about +12 dBm (1 dB compressed).
- The LO splitter after it loses 4.1 dB per output at 8.3 GHz (3.0 dB split + 1.1 dB typical, 1.4 dB max).
- So each mixer gets at most about +8 dBm. The mixers are specified for +10 dBm.

\[ P_\text{mixer} = P_\text{amp out} - 3.0 - 1.1 = 12.2 - 4.1 = +8.1\ \text{dBm} \]

One ZX60-14012L-S+ cannot give +10 dBm to both mixers. It is about 2 dB short even when driven into compression. The drawing shows +10 dBm at each mixer. RX mixer test 3 (conversion loss vs LO power) will show how much the shortfall costs.

Test plan

Needs the PLL at 8.3 GHz, the SM200B, fixed attenuators, and a supply at 12.0 V with a 100 mA limit. Measure the PLL output level alone first.

# | Test | Wiring | You do | Computer does | Expected | Pass if

1 | Supply current | amp powered, input and output on 50 Ω loads | set 12.0 V; read the current | nothing | 62 mA | under 68 mA
2 | PLL level | PLL → SM200B | set the PLL to 8.3 GHz | read frequency and power | not known | recorded; must be under +10 dBm before it goes to the amp
3 | Gain | PLL → attenuators (so input is −15 dBm) → amp → 20 dB attenuator → SM200B | connect; then remove the amp for the reference run | read 8.3 GHz with and without the amp; subtract | 12.5 dB | 9 dB or more
4 | Compression | same | swap input attenuators: −15 to +5 dBm | read output at each step | +12 dBm out, at about 0 dBm in | +9 dBm or more
5 | Power at the mixers | PLL → amp → LO splitter; one output → 20 dB attenuator → SM200B, other → 50 Ω load. Then swap. | connect; swap outputs | read 8.3 GHz at each output | about +8 dBm at most | recorded; the mixers want +10 dBm
6 | Harmonics | same as 5 | nothing | read 16.6 GHz | not specified | recorded

Input limit is +10 dBm. Check the PLL level (test 2) before connecting it to the amp without attenuators.

Results

Test | Result | Expected | Pass? | Date
1. Supply current | 0.06 A at 12.0 V | 62 mA, max 68 mA | pass | 12 Oct
2. PLL level at 8.3 GHz, through the buffer | ADF5355 Out B → 10 dB → buffer → 20 dB → SM200B: −33.57 dBm at 8.29995 GHz. With 12.5 dB buffer gain and pads at nominal, Out B ≈ −16 dBm. Spike: LO through buffer, -33.57 dBm | −25.5 dBm (from Out B −8 dBm at 8.000 GHz) | 8 dB low; cause not known | 31 Oct
5. Splitter added, first look | same chain with splitter at the end, S from buffer, output 2 on 50 Ω, output 1 to SM200B: −59.92 dBm. 26.35 dB lower than without the splitter. Spike: LO through splitter, -59.92 dBm | 4.1 dB drop | That splitter was the ZFRSC-42-S+, rated only to 4.2 GHz. The buffer may also have been off in this reading, so do not use it | 31 Oct
5. ZX10-2-1252-S+ in place of it | same chain and wiring: −53.96 dBm. 20.39 dB lower than without a splitter. Spike: LO through ZX10-2-1252-S+, -53.96 dBm | 4.1 dB drop | Not valid: the buffer amp was off (Sorin found this). The drop was not the splitter | 31 Oct
5. ZX10-2-1252-S+, buffer on | ADF5355 Out B → 10 dB → buffer → 20 dB → SM200B: −31 dBm without the splitter, −36 dBm with it (S in, output 1 out, output 2 on 50 Ω). Buffer off: −53 and −57 dBm. Read by Sorin; no screens. | 4.1 dB drop | 5 dB drop: consistent | 31 Oct
3. Gain, at 1.1 GHz | 11.5 dB (four levels: 11.8, 11.0, 11.7, 11.7) | 11 dB at 1 GHz; min 9 dB | pass | 12 Oct
3. Gain, 1.0 to 1.2 GHz | 10.0 to 11.4 dB (mean 10.7) | about 11 dB; min 9 dB | pass | 12 Oct
3. Gain, at 8.3 GHz | not run | 12.5 dB
4. Compression, 1.0 to 1.2 GHz | gain 1 dB down at +8.2 dBm (1000 MHz), +8.4 dBm (1100 MHz), about +9 dBm (1200 MHz) | +11 dBm typ, +9 min (+11.5 at 1 GHz) | 0.6 to 0.8 dB under the minimum at 1000 and 1100 MHz | 12 Oct
4. Compression, at 8.3 GHz | not run | +12 dBm out
Repeatability, 1.1 GHz | 0.28 dB spread over 5 readings | | | 12 Oct
Output with no input | no lines; nothing more than 6 dB above the noise from 30 MHz to 2.1 GHz | noise only | pass | 12 Oct
Second harmonic, 1.0 GHz drive at +9.1 dBm out | −13.1 dBm at 2.0 GHz (−22 dBc), Pluto harmonic included | not specified | recorded | 12 Oct
5. Power at the mixers | not run | about +8 dBm
6. Harmonics | not run

Test 1: read from the display of an Agilent E3630A supply. Input and output each had a 50 Ω termination. The display reads to 0.01 A, so the current is between 55 and 65 mA. With a signal applied in test 3 it also read 0.06 A.

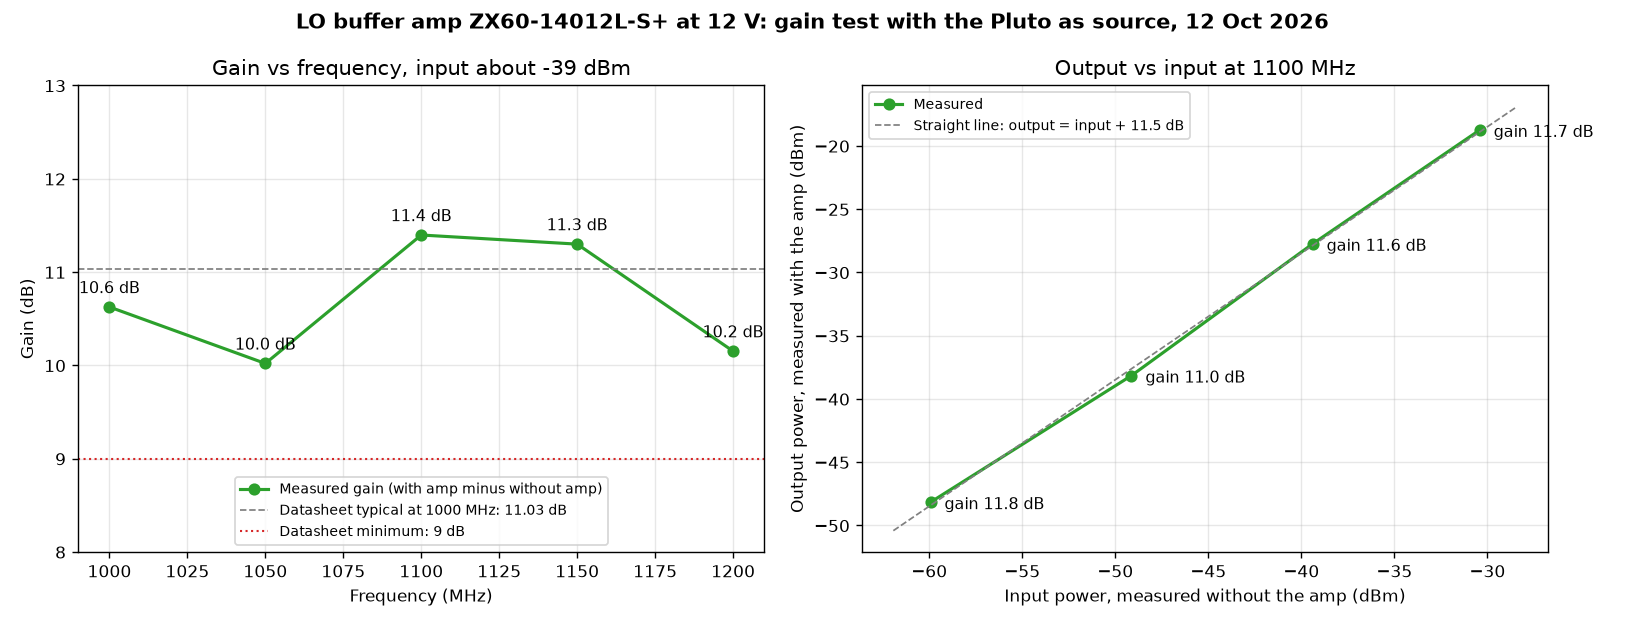
[picture p64: phase_detector_calibration/site/img/lobuf_gain.png]
LO buffer amp gain against frequency, and output against input at 1100 MHz


#### Test 3 at 1.1 GHz, 12 Oct

Pluto attenuation (dB) | Without amp (dBm) | With amp (dBm) | Gain (dB)
60 | −59.93 | −48.17 | 11.76
50 | −49.13 | −38.16 | 10.97
40 | −39.39 | −27.74 | 11.65
31 | −30.41 | −18.74 | 11.67

1. Source: the Pluto, set to a tone at 1099.99 MHz. Its attenuation was never set below 31 dB.
2. Run A: Pluto TX connected straight to the spectrum analyzer (Siglent SSA3021X). The peak level was read at four Pluto attenuation settings.
3. Run B: Pluto TX to the amp input, amp output to the spectrum analyzer, amp at 12 V. The same four settings were read.
4. Gain is run B minus run A at the same setting.
5. The gain is the same at all four levels, so the amp was not compressing. The 60 dB row is only a few dB above the analyzer noise.

\[ G = P_\text{with amp} - P_\text{without amp} = -18.74 - (-30.41) = 11.67\ \text{dB} \]

#### Test 3 from 1.0 to 1.2 GHz, 12 Oct

Frequency (MHz) | Without amp (dBm) | With amp (dBm) | Gain (dB)
1000 | −39.00 | −28.37 | 10.63
1050 | −38.74 | −28.72 | 10.02
1100 | −39.14 | −27.74 | 11.40
1150 | −39.62 | −28.32 | 11.30
1200 | −39.03 | −28.88 | 10.15

- Pluto attenuation 40 dB for every row.
- The with-amp readings were taken first. The amp was then removed and the without-amp readings taken.
- Gain varies by 1.4 dB across the band. The cables were unplugged and reconnected between the two runs, and the 1100 MHz without-amp reading changed by 0.25 dB between the first and second run, so part of the variation is the measurement.
- The datasheet gives 11.03 dB at 1000 MHz and a flatness of ±1 dB.

#### Test 4, compression, 12 Oct

LO buffer amp output against input, and gain against output power, at 1000, 1100 and 1200 MHz

Frequency (MHz) | Gain at low power (dB) | Output where gain is 1 dB lower (dBm) | Highest output reached (dBm)
1000 | 10.37 | +6.4 | +9.10
1100 | 11.09 | +6.3 | +9.39
1200 | 9.80 | +7.1 | +8.90

1. Wiring: Pluto TX to amp input, amp output to the spectrum analyzer. Amp at 12 V.
2. The Pluto attenuation was stepped from 40 dB down to 0 dB, 16 steps, at each of three frequencies. The output power was read at each step.
3. The input power was not measured at each step. It was calculated: the Pluto level measured at 40 dB without the amp, plus the change in the attenuation setting.
4. Gain is output minus calculated input. The low-power gain is the average of the steps below −18 dBm input.
5. The compression point is the output power where the gain is 1 dB below the low-power gain.
- The output powers are measured directly: the amp put out up to +9.4 dBm.
- The input power in this first calculation was not measured. The numbers in the table above are wrong for that reason. See the corrected result below.

#### Test 4 corrected with the measured Pluto level, 12 Oct

LO buffer amp output against measured input, and gain against output power

Frequency (MHz) | Gain at low power (dB) | Output where gain is 1 dB lower (dBm) | Gain drop at the highest output (dB) | Highest output (dBm) | Input at the highest output (dBm)
1000 | 10.62 | +8.16 | 1.66 | +9.10 | +0.14
1100 | 11.33 | +8.37 | 1.57 | +9.39 | −0.36
1200 | 10.09 | not reached; about +9 | 0.96 | +8.90 | −0.23

1. Later on 12 Oct the Pluto was connected straight to the spectrum analyzer and its output read at every attenuation setting from 0 to 40 dB, at the same three frequencies and the same tone scale. See the Pluto tab.
2. The input power at each step is now that measured Pluto level, not the setting.
3. Gain is the amp output minus the measured Pluto level at the same setting. The low-power gain is the average of the steps below −18 dBm input.
4. The compression point is the output power where the gain is 1 dB below the low-power gain, found by a straight line between the two nearest steps.

\[ G(A) = P_\text{with amp}(A) - P_\text{Pluto alone}(A) \qquad P_{1\,\text{dB}} = P_\text{out}\ \text{where}\ G = G_\text{low} - 1 \]

- The Pluto puts out 0.6 to 1.0 dB less than its setting says at 0 dB attenuation. That accounts for about half of the early gain drop seen in the first calculation.
- With the correction the gain is flat within 0.2 dB up to +3 dBm output at 1000 and 1100 MHz, then falls.
- 1 dB compression is at +8.2 dBm (1000 MHz) and +8.4 dBm (1100 MHz). The datasheet gives +11 dBm typical and +9 dBm minimum, and +11.5 dBm in its typical data at 1000 MHz.
- At 1200 MHz the low-power gain itself rises by 0.4 dB between −29 and −5 dBm output, so the reference gain is less certain there.
- The amp and the Pluto-alone readings were taken with different cable connections. Repeat readings changed by up to 0.3 dB after reconnecting, so the compression points are good to about ±0.5 dB.
- This is at 1.0 to 1.2 GHz. The design uses the amp at 8.3 GHz, where the typical data gives +12.25 dBm. That is still to be measured.

Files in clinic\claude\lo_buffer_test\: runA_direct_20261012.csv, runA_direct_freq_20261012.csv, runB_amp_20261012.csv, compression_20261012.csv, compression_corrected_20261012.csv, amp_output_no_signal_20261012.csv.

## Image filter

Mini-Circuits VHF-8400+ high-pass filter. Goes after the TX mixer. Passes 9.3–9.5 GHz and reduces the 7.1–7.3 GHz image.

Specs

Quantity | Min | Typical | Max | Unit
Passband | 9000 | — | 13000 | MHz
Loss, 9000–9500 MHz | — | — | 3 | dB
Loss, 9500–12500 MHz | — | — | 2.5 | dB
Frequency where loss is 3 dB | — | 8400 | — | MHz
Rejection, DC–5700 MHz | — | 30 | — | dB
Rejection, DC–6000 MHz | 20 | — | — | dB
Rejection, 6000–8400 MHz | not specified | not specified | not specified | dB
Return loss, 9000–13000 MHz | — | 14 | — | dB
RF input power, max at 25 °C | — | — | 7 W (+38.5 dBm, 18.7 V rms)
Sections | — | 5 | —

Datasheet (https://sorin-jayaweera.github.io/Panthalassa-Clinic-Team/datasheets/VHF-8400.pdf). No supply needed. DC blocked at both ports.

Expected behavior

- Wanted signal, 9.3–9.5 GHz: loses up to 3 dB. The drawing estimates 1.4 to 1.6 dB.
- Image, 7.1–7.3 GHz: the datasheet gives no number between 6.0 and 8.4 GHz. The drawing estimates 24 to 28 dB by reading the curve.
- LO leakage, 8.3 GHz: this is 100 MHz below the 3 dB point, so it is reduced by only about 3 to 5 dB.
- The TX mixer leaks LO to its RF port 35 dB down (25 dB minimum): +8 − 35 = −27 dBm. After the filter about −31 dBm of 8.3 GHz reaches the power amp.

\[ f_\text{image} = f_\text{LO} - f_\text{IF} = 8.3 - (1.0\ \text{to}\ 1.2) = 7.1\ \text{to}\ 7.3\ \text{GHz} \]

This filter does little to the 8.3 GHz LO. Whether that matters depends on the power amp and on emission limits. Test 3 measures it.

Test plan

Needs a source that can be set from 5.5 to 10 GHz (the ADF5355 PLL can, if we can retune it) and the SM200B. Each test is one run with the filter and one without; the difference is the loss.

# | Test | Wiring | You do | Computer does | Expected | Pass if

1 | Passband loss | source → filter → SM200B | connect; then replace the filter with a through adaptor | step 9.0–10.0 GHz with and without the filter; subtract | 1.4 to 1.6 dB at 9.3–9.5 GHz | under 3 dB
2 | Image rejection | same | nothing | step 7.0–7.4 GHz | 24 to 28 dB (drawing estimate) | recorded; 20 dB or more wanted
3 | LO rejection | same | nothing | read 8.3 GHz | 3 to 5 dB | recorded
4 | Stopband | same | nothing | step 5.5–6.0 GHz | 30 dB | 20 dB or more
5 | Full curve | same | nothing | step 5.5–10 GHz in 50 MHz steps | 3 dB point at 8.4 GHz | recorded as a plot
6 | After the TX mixer | Pluto 1.0–1.2 GHz → TX mixer IF; LO → mixer LO; mixer RF → filter → SM200B | connect; then remove the filter | read 9.3–9.5, 8.3 and 7.1–7.3 GHz with and without the filter | wanted signal down under 3 dB; image down 24 to 28 dB | recorded

Results

Not run yet.

## Splitter

Mini-Circuits ZFRSC-42-S+. Resistive 2-way. Used twice: after the IF amp, and as the delay-line split before the phase detector.

Specs

Quantity | Typical | Max | Unit
Frequency range | DC to 4200 | — | MHz
Loss per output (6 dB split + insertion loss) | 6.0 | 6.5 (100–2100 MHz) | dB
Loss per output at 1000 MHz (typical data) | 5.99 and 6.02 | — | dB
Isolation between outputs | 6.5 (5.94 at 1000 MHz) | — | dB
Amplitude unbalance | 0.02 | 0.2 | dB
Phase unbalance | 0.63 at 1000 MHz | 3 | degrees
VSWR at 1000 MHz | 1.02 to 1.03 | — | :1
Input power, absolute max | — | 0.75 W (+28.8 dBm, 6.12 V rms)
Internal dissipation, absolute max | — | 0.375 W

Datasheet (https://sorin-jayaweera.github.io/Panthalassa-Clinic-Team/datasheets/ZFRSC-42.pdf). No supply needed. Ports: sum = 3, outputs = 1 and 2.

Expected behavior

- Each output is 6.0 dB below the input, the same at 1.0 and 1.2 GHz.
- The two outputs match within 0.2 dB.
- A signal put into one output appears at the other output 6 dB lower.
- After the IF amp with a strong radar: +18.6 dBm in gives +12.6 dBm at each output. This is far below the 0.75 W limit.

Test plan

Needs the Pluto, an analyzer and one 50 Ω load.

# | Test | Wiring | You do | Computer does | Expected | Pass if

1 | Loss at one frequency | source → splitter port 3; port 1 → analyzer; port 2 → 50 Ω load. Then swap ports 1 and 2. | connect; swap | read power with and without the splitter | 6.0 dB | under 6.5 dB. Done 6 Oct at 1.04 GHz
2 | Loss vs frequency | same | swap outputs | step 1.0–1.2 GHz; read both outputs | 6.0 dB, flat | under 6.5 dB; outputs within 0.2 dB
3 | Isolation | source → port 1; port 2 → analyzer; port 3 → 50 Ω load | connect | step 1.0–1.2 GHz | 6 dB | recorded

Results

Test | Result | Expected | Date
1. Loss, right output, 1.0388 GHz | 6.70 dB | 6.0 typical, 6.5 max | 6 Oct
1. Loss, left output, 1.0388 GHz | 6.72 dB | 6.0 typical, 6.5 max | 6 Oct
2. Loss vs frequency | not run
3. Isolation | not run

The measured loss is 0.2 dB over the datasheet maximum. The measurement includes the connectors and was made with the VCO as the source.

Loss measurement

#### Result

Path | Power at analyzer (dBm) | Loss of the added part (dB)
VCO → cable A → analyzer | 7.30 | —
+ splitter, right output | 0.60 | 6.70
+ splitter, left output | 0.58 | 6.72
+ cable B | 0.54 | 0.04
+ cable C | 0.33 | 0.21
+ cable D | 0.51 | 0.09

#### How it was made

1. 6 Oct. VCO at 5.38 V, 1.0388 GHz.
2. The VCO was connected to the analyzer through cable A and the power was read.
3. The splitter was added. The unused output had a 50 Ω load. The power was read again.
4. Loss = power before minus power after.
5. Each extra cable was added one at a time and measured the same way.

Delay calculation

\[ \tau = \frac{\Delta L}{v} = \frac{0.114\ \text{m}}{0.7 \times 3\times10^{8}\ \text{m/s}} = 0.55\ \text{ns} \]

\[ \Delta\phi = 360^\circ \times f\tau = 360^\circ \times 1.1\times10^{9} \times 0.55\times10^{-9} = 216^\circ \]

- 4.5 in = 0.114 m. Signal speed in the cable is taken as 0.7 times the speed of light.
- From 1.0 to 1.2 GHz the phase goes from 196° to 236°.
- The design drawing asks for 0.2 ns (3 to 4 cm), which gives 90° at 1.1 GHz.

Notes

- A resistive splitter loses 6 dB per output, not 3 dB. The 6.7 dB measurement is correct. The earlier 1.5 dB reading on 5 Oct was a measurement error.
- 0.75 W is the maximum rating, not the power flowing. The note of 15 Sep (“750 → 188 → 50 mW”) used the rating as the signal power.
- Isolation between the outputs is about 6 dB. A reflection from one mixer port reaches the other mixer port 6 dB lower.
- Not tested: the mixer curve has more turning points than a 0.55 ns delay gives. One possible cause is reflections between the mixer ports through the splitter. A splitter with higher isolation, or attenuators on the mixer ports, would test this.

## Phase detector

Mini-Circuits ZX05-30W-S+ mixer, fed by the delay-line splitter. Turns frequency into a DC voltage.

Specs

Quantity | Typical | Min / Max | Unit
LO and RF frequency | 300 to 4000 | — | MHz
IF frequency | DC to 950 | — | MHz
LO power | +7 (5.0 mW, 0.50 V rms) | — | dBm
Conversion loss, 600–2000 MHz | 6.8 | max 9.0 | dB
Conversion loss at 1106 MHz (typical data) | 6.36 | — | dB
LO–RF isolation | 35 | min 17 | dB
LO–IF isolation | 16 | min 7 | dB
RF input at 1 dB compression | +1 | — | dBm
RF port VSWR at 944 / 1106 MHz | 3.48 / 2.77 | — | :1
LO port VSWR at 914 / 1076 MHz | 1.97 / 1.70 | — | :1
RF power, absolute max | — | 50 mW (+17 dBm, 1.58 V rms)
IF current, absolute max | — | 40 | mA

Datasheet (https://sorin-jayaweera.github.io/Panthalassa-Clinic-Team/datasheets/ZX05-30W-S.pdf). Ports: LO = 1, RF = 2, IF = 3. No supply needed. The datasheet does not specify DC output when used as a phase detector.

Expected behavior

- Both inputs are the same frequency, so the IF output is a DC voltage.
- The voltage follows a cosine of the phase difference between the two inputs.
- With a 0.55 ns cable difference the phase is 196° at 1.0 GHz and 236° at 1.2 GHz. The voltage should change smoothly in one direction across the band.
- The voltage also scales with input power. It is only a frequency reading if the power is held fixed.

\[ V_\text{out} \approx V_0 + A(P)\cos(2\pi f\tau) \qquad \tau = 0.55\ \text{ns} \]

Test plan

1. Output vs frequency with the Pluto at four power levels, by hand. Done in September.
2. Output vs frequency with the VCO as source, by computer, 744 to 920 MHz. Done 10 Oct.
3. Step response, noise and drift. Done 10 Oct.
4. Not done: the same in 1.0–1.2 GHz, with fixed power, and with different delay cables. See Tests to run, PD1 to PD5.

Results

Quantity | Value | Date
Output range, VCO source | 30.3 to 145.7 mV over 744–920 MHz | 10 Oct
Range where one voltage = one frequency | 744 to 788 MHz | 10 Oct
Slope in that range | 2.66 mV/MHz mean | 10 Oct
Power at each input | +0.6 dBm (wanted: +7 on LO) | 6 Oct
Noise | 84 to 142 µV rms = 38 to 66 kHz | 10 Oct
10–90 % time after a step | 89 to 140 ns (input edge is 145 ns) | 10 Oct
Delay, input to output | 26 ns | 10 Oct

The measured curve does not match the expected smooth cosine. It has turning points 14 to 34 MHz apart. The cause is not known.

#### VNA, LO and RF ports, mixer not driven (8720ES, 31 Oct)

Port 1 = LO, port 2 = RF. No LO drive, so the diodes are off and these are not operating values: do not compare them with the datasheet’s +7 dBm figures. The setup photo shows the IF port open, not loaded; repeat with 50 Ω on IF. S22, S21 and S12 screens show Cor and * rather than C2, so a sweep may not have finished.

Marker | Frequency | S11 (LO match) | S21 (LO to RF) | S12 (RF to LO) | S22 (RF match)
1 | 50 MHz | −0.046 dB | −57.91 dB | −66.02 dB | −0.131 dB
2 | 500 MHz | −9.830 dB | −34.91 dB | −37.46 dB | −29.54 dB
3 | 1.002 GHz | −11.94 dB | −31.89 dB | −32.15 dB | −11.10 dB
4 | 1.500 GHz | −13.75 dB | −30.18 dB | −31.10 dB | −6.09 dB
5 | 2.002 GHz | −4.823 dB | −26.16 dB | −26.24 dB | −3.86 dB

ZX05-30W-S+ with LO and RF on cables, IF open

8720ES: mixer S11, LO port

8720ES: mixer S21, LO to RF

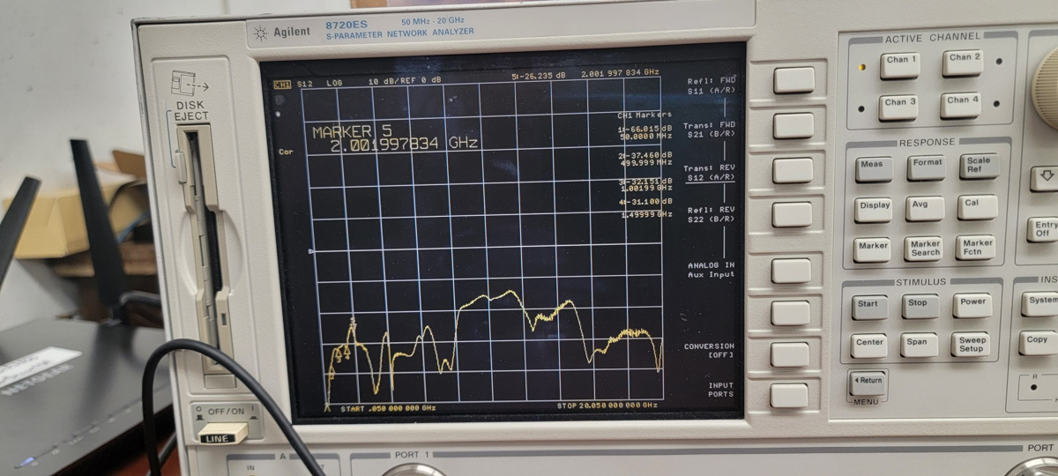
[picture p65: phase_detector_calibration/site/img/vna_mixer30W_LOport1_RFport2_S12.png]
8720ES: mixer S12, RF to LO


8720ES: mixer S22, RF port

#### VNA, LO and IF ports, mixer not driven (8720ES, 31 Oct)

Port 1 = LO, port 2 = IF, RF port open, no LO drive. Same limits as above. Photos not stored; values read from them at the time. The LO match agrees with the LO and RF sweep within 0.05 dB at every marker. At 50 MHz S21 and S12 differ by 18 dB, so that marker is not a real isolation value.

Marker | Frequency | S11 (LO match) | S21 (LO to IF) | S12 (IF to LO) | S22 (IF match)
1 | 50 MHz | −0.030 dB | −66.11 dB | −47.64 dB | −9.39 dB
2 | 500 MHz | −9.840 dB | −29.97 dB | −30.60 dB | −24.35 dB
3 | 1.002 GHz | −11.94 dB | −24.19 dB | −23.82 dB | −19.42 dB
4 | 1.500 GHz | −13.70 dB | −22.16 dB | −21.94 dB | −11.46 dB
5 | 2.002 GHz | −4.793 dB | −14.84 dB | −14.37 dB | −4.94 dB

#### VNA, IF and RF ports, mixer not driven, LO open (8720ES, 31 Oct)

Port 1 = IF, port 2 = RF, no load on LO. Sorin repeated it with the broadband load on LO and the numbers looked the same (by eye; that screen was not recorded). S21 and S12 differ by up to 7 dB at 1 GHz and 23 dB at 50 MHz, so treat these isolation values as unconfirmed.

Marker | Frequency | S11 (IF match) | S21 (IF to RF) | S12 (RF to IF) | S22 (RF match)
1 | 50 MHz | −10.22 dB | −30.41 dB | −53.15 dB | −0.107 dB
2 | 500 MHz | −23.57 dB | −26.53 dB | −24.07 dB | −26.80 dB
3 | 1.002 GHz | −18.94 dB | −26.17 dB | −33.59 dB | −11.17 dB
4 | 1.500 GHz | −11.78 dB | −24.35 dB | −26.99 dB | −6.23 dB
5 | 2.002 GHz | −4.517 dB | −27.80 dB | −30.98 dB | −4.09 dB

ZX05-30W-S+ with IF and RF on cables, LO open

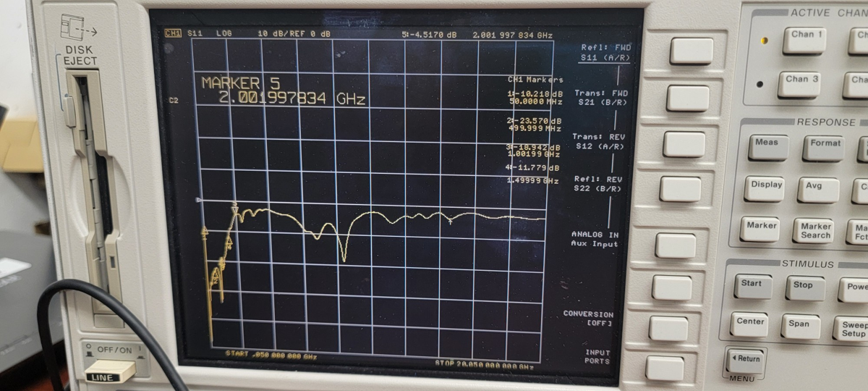
[picture p66: phase_detector_calibration/site/img/vna_mixer30W_IFport1_RFport2_LOopen_S11.png]
8720ES: mixer S11, IF port, LO open


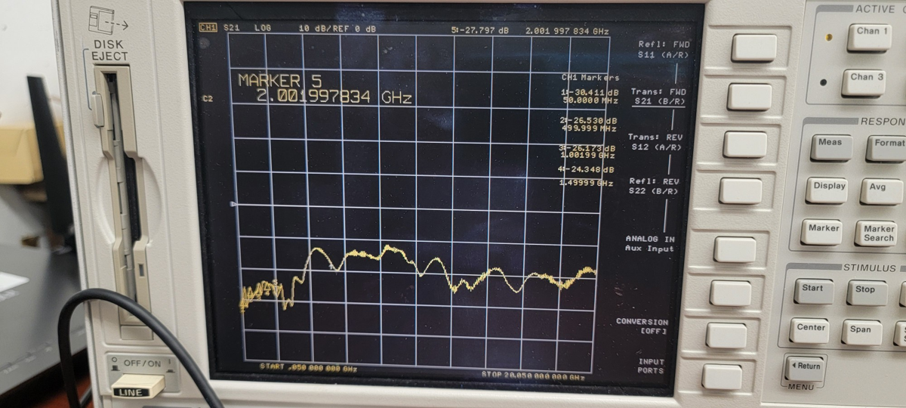
[picture p67: phase_detector_calibration/site/img/vna_mixer30W_IFport1_RFport2_LOopen_S21.png]
8720ES: mixer S21, IF to RF, LO open


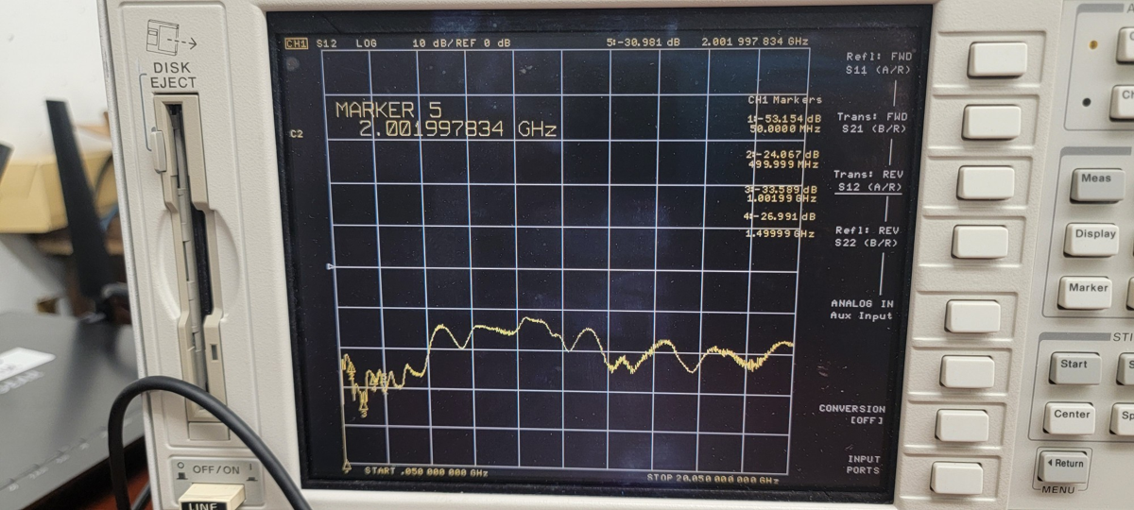
[picture p68: phase_detector_calibration/site/img/vna_mixer30W_IFport1_RFport2_LOopen_S12.png]
8720ES: mixer S12, RF to IF, LO open


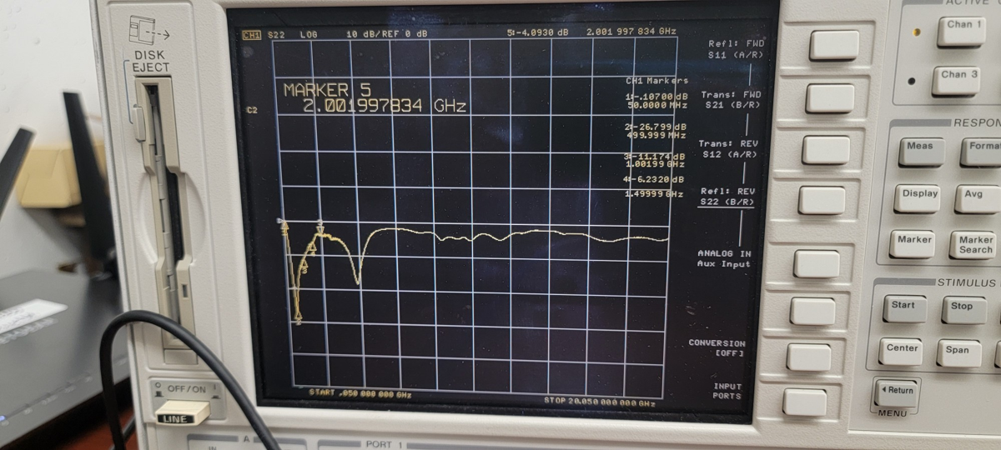
[picture p69: phase_detector_calibration/site/img/vna_mixer30W_IFport1_RFport2_LOopen_S22.png]
8720ES: mixer S22, RF port, LO open


Output voltage vs frequency, VCO source

Mixer output voltage against frequency

#### Result

- Rises from 30.3 mV at 743.6 MHz to 121.3 mV at 788.4 MHz.
- Then: minimum 111.4 mV at 802.2 MHz, maximum 145.7 mV at 834.2 MHz, minimum 136.0 mV at 868.0 MHz, maximum 142.1 mV at 886.0 MHz.
- Above 788 MHz one voltage matches more than one frequency.

#### How it was made

1. Same sweep as the VCO frequency measurement. At each of 176 tuning voltages:
2. the analyzer read the VCO frequency,
3. scope CH2 read the mixer output. Three records of 14 ms each were averaged.
4. The mixer voltage is plotted against the frequency from the analyzer.

#### Expected shape

\[ V_\text{out} \approx V_0 + A\cos(2\pi f\tau) \]

With τ = 0.55 ns this is one slow curve with turning points 900 MHz apart. The measured curve has turning points 14 to 34 MHz apart. The cause was not found.

Output voltage vs frequency, Pluto source, four power levels

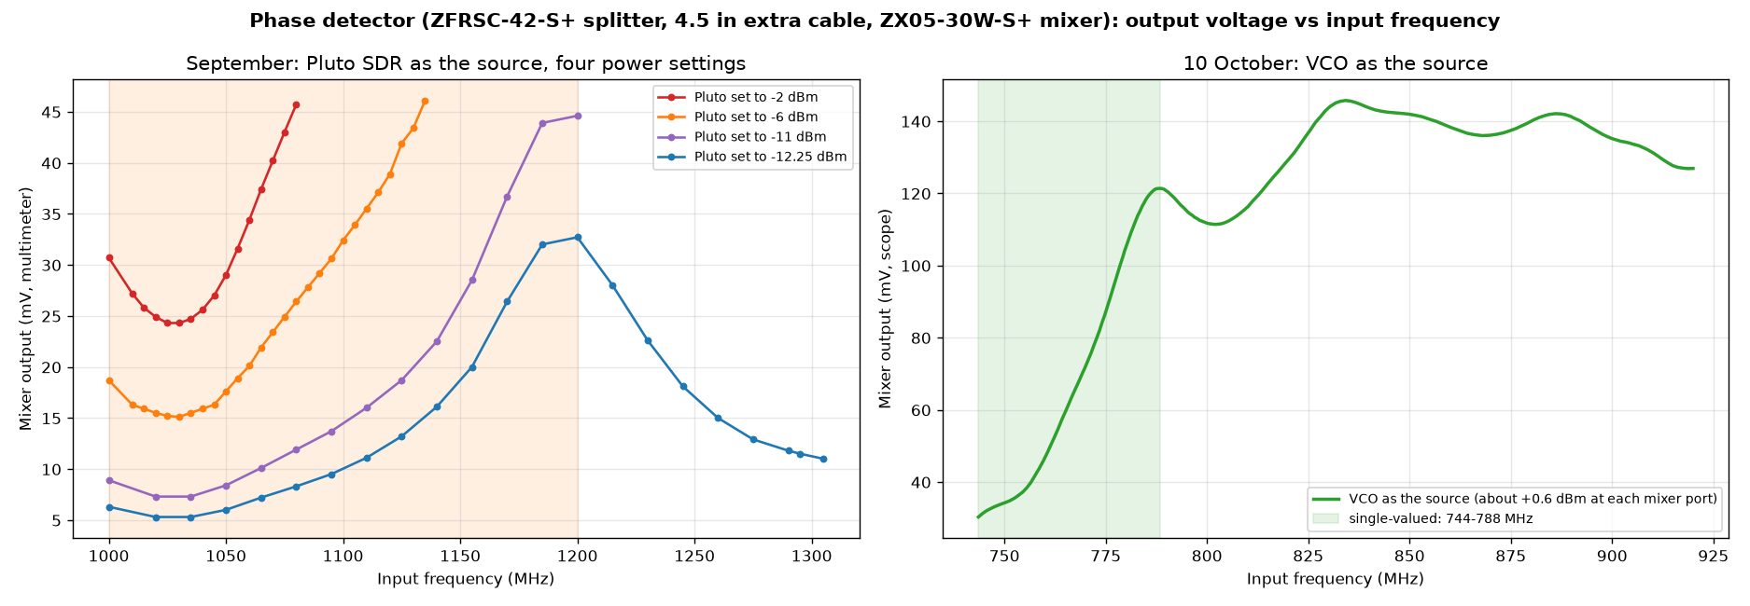
[picture p70: phase_detector_calibration/site/img/comp_phase_detector.png]
Phase detector output against frequency, Pluto and VCO sources


#### Result

Pluto setting (dBm) | Frequency range (MHz) | Output range (mV) | Output at 1.08 GHz (mV)
−2 | 1000–1080 | 24.3–45.7 | 45.7
−6 | 1000–1135 | 15.1–46.1 | 26.4
−11 | 1000–1200 | 7.3–44.6 | 11.9
−12.25 | 1000–1305 | 5.3–32.7 | 8.3

- The output voltage depends on input power. At 1.08 GHz it changes from 45.7 mV to 8.3 mV over 10 dB.
- At −12.25 dBm: minimum near 1.03 GHz, maximum at 1.20 GHz.

#### How it was made

1. September. Pluto SDR → splitter → two cables → mixer → multimeter.
2. The Pluto frequency was stepped by hand in 5 MHz steps and the multimeter read at each.
3. This was repeated at four Pluto power settings.

#### Right plot, 10 October

- This is the computer-run sweep. The Syscomp stepped the VCO tuning pin from 0 to 3.5 V in 0.02 V steps, 176 points.
- At each step the spectrum analyzer read the VCO frequency (x axis). Scope CH2 read the mixer IF output into 1 MΩ, averaged over three 14 ms records (y axis).
- The Syscomp reaches 3.52 V at most, so the sweep covers 744 to 920 MHz. That is below the 1.0 to 1.2 GHz band the JACON uses.
- Green band, 744 to 788 MHz: the output only rises, 30 to 121 mV, so each voltage matches one frequency. Above 788 MHz it turns at 802, 834, 868 and 886 MHz, so one voltage matches several frequencies.
- A 0.55 ns delay alone gives turning points 900 MHz apart, not 14 to 34 MHz apart. The cause is not known.
- The +0.6 dBm per mixer port in the legend was measured after the splitter on 6 Oct at 1.04 GHz. It was not measured again during this sweep.
- The two plots are different bands, sources and powers. They are not the same curve.

Output voltage vs tuning voltage

Mixer output against tuning voltage

#### How it was made

The same data as the frequency plot, plotted against the tuning voltage instead of the frequency.

Mixer look up table

Mixer output voltage against VCO frequency as measured, the same points used as a look up, and the slope

#### Result

- Valid from 743.6 to 788.4 MHz, 30.3 to 121.3 mV.
- Point-to-point roughness 0.084 mV = 40 kHz.
- Slope 0.05 to 3.73 mV/MHz. Below 755 MHz and above 785 MHz the slope is small, so a small voltage error is a large frequency error.

#### How it was made

1. Take the 61 calibration points with tuning voltage 0 to 1.2 V. In this range the mixer voltage only rises with frequency.
2. Left panel: these points, frequency on the x axis, voltage on the y axis.
3. Middle panel: the same points with the axes swapped.
4. To convert a voltage, find the two points on either side of it and draw a straight line between them.
5. Right panel: the slope between neighbouring points.

\[ f(V) = f_i + (V - V_i)\,\frac{f_{i+1} - f_i}{V_{i+1} - V_i} \qquad \delta f = \frac{\delta V}{dV/df} \]

Code

use = cal[cal["vt_meas_v"] <= 1.2]             # the part where voltage only rises with frequency
mhz, mv = use["vco_freq_hz"] / 1e6, use["mixer_out_v"] * 1e3
order = np.argsort(mv)

def mv_to_mhz(x):
    return np.interp(x, mv[order], mhz[order])

Full table: see the Look up tables tab.

Step response

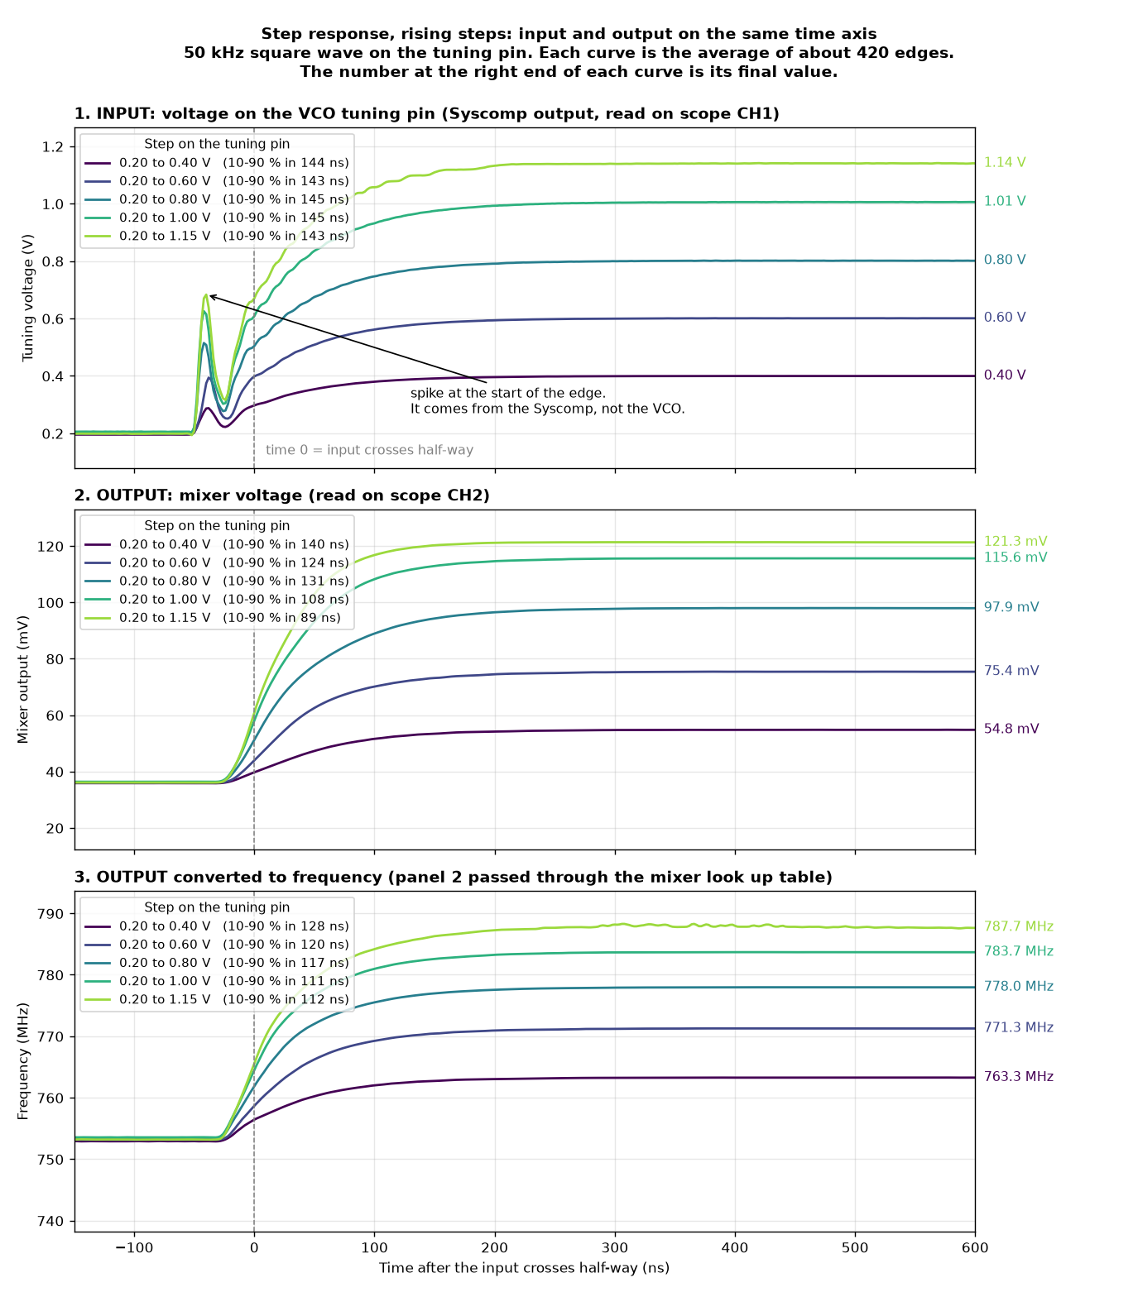
[picture p71: phase_detector_calibration/site/img/step_rise.png]
Rising steps: drive, mixer output, frequency


Falling steps: drive, mixer output, frequency

#### Result

- The mixer output follows each step. 10–90 % time 89 to 140 ns rising, 93 to 128 ns falling.
- The drive voltage takes 145 ns and has a spike at the start. The mixer is responding to that shape.

#### How it was made

1. The Syscomp drove the VCO tuning pin with a 50 kHz square wave. Low level 0.2 V. High level 0.4, 0.6, 0.8, 1.0 or 1.15 V.
2. The scope recorded the drive (CH1) and the mixer output (CH2) for 2.8 ms. That holds about 140 rising and 140 falling edges. Three recordings per step.
3. The time of each edge was found from where the drive crossed half-way between its low and high levels.
4. All the edges were shifted to the same time zero and stacked on top of each other, then averaged. About 420 edges per curve. Averaging reduces the noise by about 20 times.
5. Top panel: average drive voltage. Middle panel: average mixer voltage. Bottom panel: the mixer voltage converted to frequency with the look up table.
6. These are the recorded signals. Nothing has been divided out.

\[ \bar{y}(\tau) = \frac{1}{N}\sum_{k=1}^{N} y(t_k + \tau) \qquad N \approx 420 \]

Code

dlo, dhi = levels(vd)                          # low and high level of the drive
edges = rising_edges(t, vd, dlo, dhi)          # time of each 50 % crossing

def stack_edges(t, y, edges, grid):            # grid = times relative to an edge
    acc, n = np.zeros(len(grid)), 0
    for e in edges:
        acc += np.interp(grid + e, t, y)       # this edge, shifted to time zero
        n += 1
    return acc / n                             # average of all edges

Time to within 2 MHz of the final frequency

Rising steps with a 2 MHz band, voltage and frequency

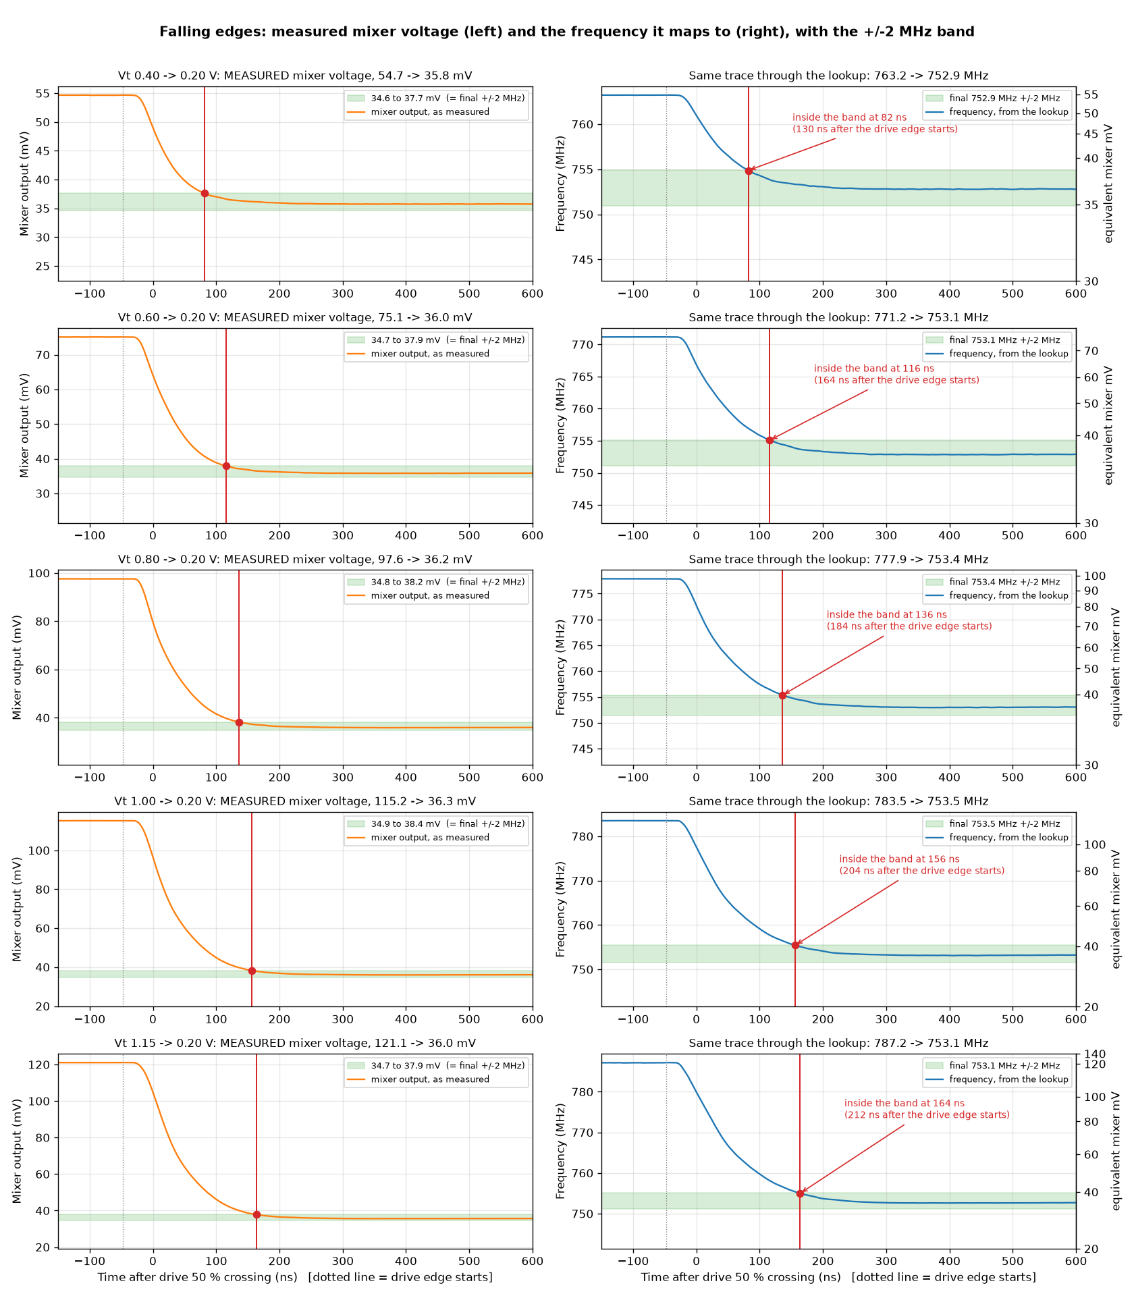
[picture p72: phase_detector_calibration/site/img/settle_fall.png]
Falling steps with a 2 MHz band


#### Result

Step on Vt (V) | Mixer (mV) | Frequency (MHz) | Within 2 MHz, after drive 50 % (ns) | Within 2 MHz, after drive starts (ns)
0.20 → 0.40 | 35.8 → 54.7 | 752.9 → 763.2 | 74 | 122
0.20 → 0.60 | 36.0 → 75.2 | 753.1 → 771.2 | 100 | 148
0.20 → 0.80 | 36.2 → 97.7 | 753.4 → 777.9 | 110 | 158
0.20 → 1.00 | 36.4 → 115.3 | 753.6 → 783.6 | 114 | 162
0.20 → 1.15 | 36.1 → 121.1 | 753.2 → 787.2 | 122 | 170

- Falling steps: 82 to 164 ns after the drive 50 % point.
- After entering the band the frequency stays inside it. There is no overshoot.

#### How it was made

1. Start from the averaged step traces.
2. Left column: the measured mixer voltage. Right column: the same trace converted to frequency with the look up table.
3. The final frequency is the median of the trace from 3 to 4.5 µs after the edge.
4. The green band is the final frequency ±2 MHz. On the left it is converted back to mV with the look up table.
5. The red dot is the first sample inside the band.

\[ t_\text{in} = \min\{\, t : |f(t) - f_\text{final}| \le 2\ \text{MHz} \,\} \]

Code

fr = mv_to_mhz(mixer_mv)                       # mixer trace converted to frequency
f_final = np.median(fr[(t > 3000) & (t < 4500)])   # ns after the edge
inside = np.abs(fr - f_final) <= 2.0           # MHz
t_first = t[np.nonzero(inside & (t > -150))[0][0]]

10–90 % time vs step size

Transition times against step size

#### How it was made

1. For each averaged trace, take the start level and the end level.
2. Find the time it reaches 10 % of the way and the time it reaches 90 % of the way. The difference is the 10–90 % time.
3. This was done for the drive voltage, the mixer voltage and the converted frequency.
4. The mixer and frequency times differ because the look up table is curved.

\[ s(t) = \frac{y(t) - y_0}{y_1 - y_0} \qquad t_r = t(s{=}0.9) - t(s{=}0.1) \]

Deconvolution

Transfer function magnitude and phase, valid range, and step responses

#### Result

- Gain is within 1 dB of flat up to 3 MHz.
- Delay 26 ns.
- The step response of the part alone rises in 68 ns. A perfect part measured the same way also gives 68 ns. So the part is faster than this measurement can show.
- Valid only up to 7 MHz. The drive edge has almost no content near 10 MHz, so the division gives a false peak there (grey area).

#### How it was made

1. The recorded mixer output is the response of the part to the Syscomp edge, which is slow and has a spike. The aim is the response to a perfect step.
2. First remove the curve of the look up table: convert each mixer trace back to the tuning voltage that gives that mixer voltage. Now input and output are both in volts and the gain is 1.
3. Differentiate the drive and the output. A step becomes a pulse.
4. Take the Fourier transform of both.
5. Divide the output transform by the drive transform. This undoes the convolution and gives the transfer function of the part. All 20 steps are combined in the division.
6. Multiply by a 7 MHz low-pass filter, inverse transform, and integrate. This gives the step response of the part alone.
7. Bottom right panel: grey is the recorded drive, blue is the recorded output (the raw system response), red is the step response of the part with the drive divided out, dotted is a perfect part through the same 7 MHz filter.

\[ H(f) = \frac{\sum_i X_i'^{*}(f)\, Y_i'(f)}{\sum_i |X_i'(f)|^2} \qquad s(t) = \int_{-\infty}^{t} \mathcal{F}^{-1}\!\left\{ \frac{\sum_i X_i'^{*} Y_i'}{\sum_i |X_i'|^2 + \lambda}\, G(f) \right\} dt' \]

X′ and Y′ are the transforms of the differentiated drive and output. λ is 2 % of the value at zero frequency. G is the 7 MHz low-pass. Delay is the slope of the phase below 5 MHz.

\[ \tau = -\frac{1}{2\pi}\frac{d\phi}{df} \]

Scope CH1 was connected part-way along the cable to the VCO, so the recorded drive is not exactly the voltage at the tuning pin. This may be why the gain rises above 0 dB between 3 and 7 MHz.

Code

xn = normalise(drive)                          # drive, scaled 0 to 1
yn = normalise(mixer_to_vt(mixer_mv))          # mixer output converted back to tuning volts, scaled 0 to 1
DX = np.fft.rfft(np.gradient(xn) * win)        # differentiate, then Fourier transform
DY = np.fft.rfft(np.gradient(yn) * win)
Sxx = mean over the 20 steps of |DX|^2
Sxy = mean over the 20 steps of conj(DX) * DY
H = Sxy / Sxx                                  # output divided by input
H_reg = Sxy / (Sxx + 0.02 * Sxx[0])            # same, with a small number added so it cannot divide by zero
step = np.cumsum(np.fft.irfft(H_reg * G))      # G = low-pass at 7 MHz; cumsum integrates the impulse response

Noise

#### Result

Frequency (MHz) | Slope (mV/MHz) | Mixer noise (µV rms) | Scope alone (µV rms) | Freq. noise, full bandwidth (kHz) | 1 MHz bandwidth (kHz) | 100 kHz bandwidth (kHz)
753.5 | 0.85 | 91 | 62 | 107 | 71 | 37
763.3 | 2.66 | 138 | 62 | 52 | 42 | 17
771.4 | 2.90 | 129 | 62 | 45 | 35 | 18
778.0 | 3.64 | 137 | 63 | 38 | 31 | 15
783.4 | 2.32 | 101 | 65 | 44 | 31 | 14
785.9 | 1.27 | 84 | 63 | 66 | 40 | 21

The values include the scope noise, so the part itself is quieter.

#### How it was made

1. The tuning voltage was held fixed, waveform off.
2. Scope CH2 was set to AC coupling, 1 mV/div, and recorded 1.4 ms.
3. The rms of the record is the voltage noise.
4. CH3 with nothing connected was recorded with the same settings. That is the scope noise.
5. Voltage noise divided by the look up table slope at that frequency gives frequency noise.
6. For the 1 MHz and 100 kHz columns the record was low-pass filtered first.

\[ \sigma_f = \frac{\sigma_V}{dV/df} \qquad \text{example: } \frac{137\ \mu\text{V}}{3.64\ \text{mV/MHz}} = 38\ \text{kHz} \]

Drift over 74 minutes

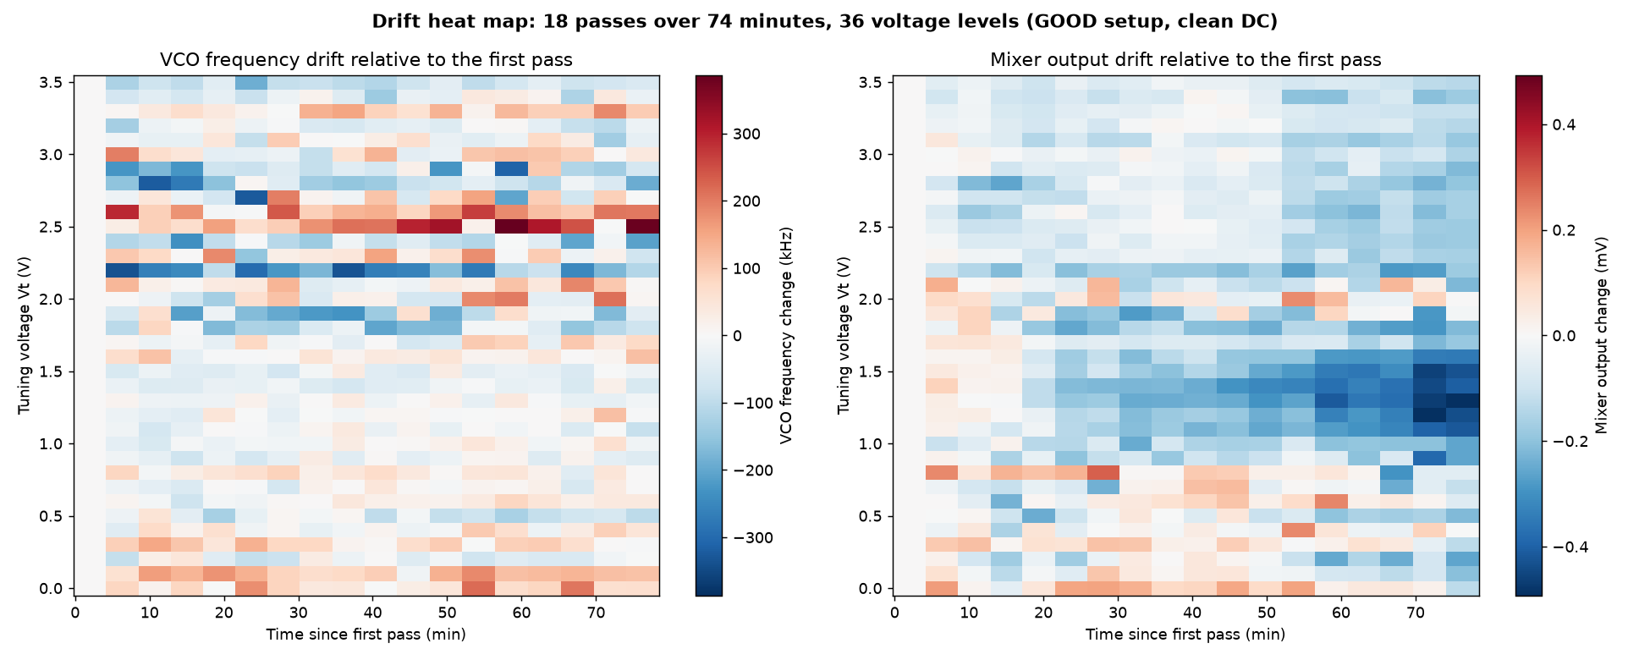
[picture p73: phase_detector_calibration/drift/drift_heatmap.png]
Heat maps of frequency, mixer output and power deviation over 74 minutes


#### Result

- Middle panel. At 1.0 to 1.6 V the mixer output fell steadily, by 0.4 mV per hour at most.
- At a fixed frequency in the 744–788 MHz range the output changed by at most 0.37 mV. 0.37 mV / 2.66 mV/MHz = 140 kHz.

#### How it was made

Same 18 sweeps and same method as the VCO drift plot. Each cell is one reading minus the median for that voltage.

Notes

#### Measured

- The output depends on input power as well as frequency. The look up table is valid only at the power it was measured at.
- The LO port had +0.6 dBm. The datasheet level is +7 dBm.
- All scope readings were into 1 MΩ. A 50 Ω load on the IF port will give a different voltage.

#### From the datasheet

- RF port VSWR 2.8 to 3.5 near 1 GHz. LO port 1.7 to 2.0.
- LO–IF isolation 7 dB minimum, so some RF appears on the output.

#### Consequences

- The RF limiting amp in the design keeps the power fixed. Without it a strong and a weak radar give different voltages at the same frequency.
- The limiting amp output must be under +23.5 dBm: mixer limit +17 dBm plus 6.5 dB splitter loss.
- The mixer has never received more than about 3 mW. Its limit is 50 mW.

## Envelope detector

Analog Devices ADL5511 on the ADL5511-EVALZ board. Takes one output of the IF splitter (1.0–1.2 GHz) and gives a voltage that follows the size of the IF signal. The comparator after it decides “radar pulse present”.

Specs

Quantity | Min | Typical | Max | Unit
Frequency range | DC | — | 6 | GHz
Supply VPOS | 4.75 | 5.0 | 5.25 (5.5 absolute max) | V
Supply current, no RF / at +15 dBm in | — | 21.5 / 43.8 | — | mA
Input range, ±1 dB error (100 MHz–1.9 GHz) | −29 | — | +17 | dBm
RF input, absolute max | — | — | +19 (79 mW, 2.0 V rms; 5.6 V pk-pk) | dBm
Input on the eval board | — | ≈ 50 Ω (75 Ω shunt R5 with the chip’s 250 Ω), 100 pF AC coupling | —
EREF, envelope reference | — | 1.1 | — | V
VENV − EREF gain (100 MHz / 900 MHz / 1.9 GHz) | — | 1.42 / 1.46 / 1.50 | — | V per V rms
VENV max output; load | — | — | 3.5; load ≥ 500 Ω and ≤ 10 pF; 15 mA drive | V
Envelope bandwidth / 10–90 % response / delay | — | 130 MHz / 4 ns / 2 ns | —
VRMS gain (100 MHz / 900 MHz / 1.9 GHz) | — | 1.92 / 1.90 / 1.96 | — | V per V rms
VRMS max output; load; offset with no signal | — | offset 23 mV | 3.8; load ≥ 10 kΩ | V
ENBL high (device on) | 3.6 | — | — | V

Datasheet (https://www.analog.com/media/en/technical-documentation/data-sheets/adl5511.pdf) (Rev. E): Table 1 specifications, Table 2 absolute maximum ratings, eval board section. Eval board: VPOS and GND pins; RFIN and VENV on SMA; EREF, VRMS and GND on clip-on test points (their SMA pads are empty); SW1 toward its label = enabled.

VENV sits at about 1.1 V with no signal. Into 50 Ω that is 22 mA, more than its 15 mA drive. Never terminate VENV in 50 Ω: scope inputs at 1 MΩ, short cable.

Expected behavior

- The output follows the RF voltage, not the power: 5 dB more input = ×1.78 more output.
- At about 1.1 GHz the gains are 1.47 V/V (VENV) and 1.91 V/V (VRMS), interpolated between the 900 MHz and 1.9 GHz datasheet columns. Across 1.0–1.2 GHz they change by about 0.1 dB, so the detector is flat over the IF band.
- VENV follows each pulse (4 ns rise). VRMS is averaged and gives the mean power.

\[ V_\text{ENV} - V_\text{EREF} = 1.47\,V_\text{in,rms} \qquad V_\text{RMS} = 1.91\,V_\text{in,rms} + V_\text{offset} \qquad V_\text{in,rms} = \sqrt{10^{P_\text{dBm}/10}\cdot 1\,\text{mW}\cdot 50\,\Omega} \]

Input (dBm) | −30 | −20 | −10 | 0 | +10 | +17
VENV − EREF (mV) | 10 | 33 | 103 | 327 | 1030 | 2310
VENV (V), EREF = 1.1 V | 1.11 | 1.13 | 1.20 | 1.43 | 2.13 | 3.41

#### Level at the detector in the JACON

- The drawing gives −36 to +4 dBm at the IF amp input. With the ZX60-P103LN+ (+15.6 dB) and the IF splitter (6.0–6.5 dB loss) the detector sees about −27 to +14 dBm.
- The weakest radar is then only about 3 dB above the detector’s floor (−30 dBm, measured), and the strongest is 3 dB under its +17 dBm limit.
- At +14 dBm VENV is about 2.7 V. The comparator (ADCMP604) needs its supply at 3.3 V or more to accept that (input max VCC + 0.5 V).

\[ P_\text{det} = P_\text{IF amp in} + 15.6 - (6.0\ \text{to}\ 6.5) = -36 + 15.6 - 6.5 = -26.9\ \text{dBm} \quad\text{to}\quad +4 + 15.6 - 6.0 = +13.6\ \text{dBm} \]

Test plan

Bench: Pluto TX (1.0–1.2 GHz tone, up to about 0 dBm) straight into RFIN. Supply 5.00 V with a 60 mA limit. VENV to Syscomp CGR-201 input A. VRMS to a multimeter (26 Oct) or CGR-201 input B (1 Nov). EREF on a multimeter. Procedure with fill-in tables: envelope_detector/ED-TEST-PROCEDURE.md.

# | Test | Wiring | You do | Computer does | Expected | Pass if

1 | Power and DC levels | supply only, nothing on the SMAs | set 5.00 V, 60 mA limit; read current, EREF, VENV, VRMS | nothing | 21.5 mA; EREF ≈ 1.1 V; VENV ≈ EREF; VRMS ≈ 23 mV | all close to expected
2 | CW curve at 1.1 GHz | Pluto TX → RFIN; VENV → CGR-201 A; meter on VRMS | type the VRMS reading at each step | step the Pluto 89 → 0 dB attenuation; average 3 CGR-201 captures per step; save a CSV | VENV − EREF = 1.47 × Vin; VRMS = 1.91 × Vin + offset | gain within the datasheet; the two outputs agree
3 | Band edges | same | nothing | same sweep at 1.0, 1.1 and 1.2 GHz, 14 levels each | same as 1.1 GHz within 0.5 dB | ratio of the two outputs the same at all three
4 | Pulse response | Pluto pulsed → RFIN; VENV → CGR-201 A, or a 1 MΩ scope for edges | set the pulse width | capture pulses | pulse top equals the CW value; 4 ns rise (scope only) | pulse height within 5 % of CW

The Pluto alone cannot hurt the detector: its highest output (about 0 to +5 dBm) is 14 dB or more under the +19 dBm limit.

Results

Test | Result | Expected | Pass? | Date
1. Supply current | 0.017 A (85 mW) with no RF; 0.020 A with RF | 21.5 mA typ | pass | 26 Oct
1. EREF | 1.148 V cold; 1.138 V after warm-up (start of sweep); 1.139 V at the end | 1.1 V nominal | pass | 26 Oct
1. VENV, no RF | 1.139 V on the meter; 1.141 to 1.144 V on the CGR-201 | ≈ EREF | pass | 26 Oct
1. VRMS, no RF | 31–32 mV (47 mV just after power-up) | 23 mV typ | pass; offset subtracted | 26 Oct
2. VENV gain, −10 to 0 dBm | 1.49, 1.51, 1.47 V/V | 1.47 V/V | pass | 26 Oct
2. VENV at −20 dBm | 25.6 mV above the no-RF level | 26 mV (datasheet table at −20 dBm) | pass | 26 Oct
2. VENV and VRMS agree | VENV rise ÷ (VRMS − offset) = 0.76–0.81 from −25 to 0 dBm | 0.77 | pass | 26 Oct
2. Floor | outputs sink into their offsets below about −30 dBm | −29 dBm (±1 dB range) | pass | 26 Oct
3. Band edges | VENV ÷ VRMS 0.773 / 0.768 / 0.766 at 1.0 / 1.1 / 1.2 GHz: +0.06 and −0.02 dB against the centre. Same floor | flat within about 0.1 dB | pass | 1 Nov
4. Pulse height, 100 µs | 0.985–1.000 × CW (mean 0.992); every pulse seen | 1.00 | pass | 1 Nov
4. Pulse height, 10 µs | 0.970–0.981 × CW (mean 0.975); every pulse seen. The shortfall is the Pluto’s ripple and edges (see 1 Nov checks) | 1.00 | pass | 1 Nov
4. Rise time | not measured: the Pluto’s 0.65 µs edges hide the detector’s 4 ns. Needs the scope | 4 ns

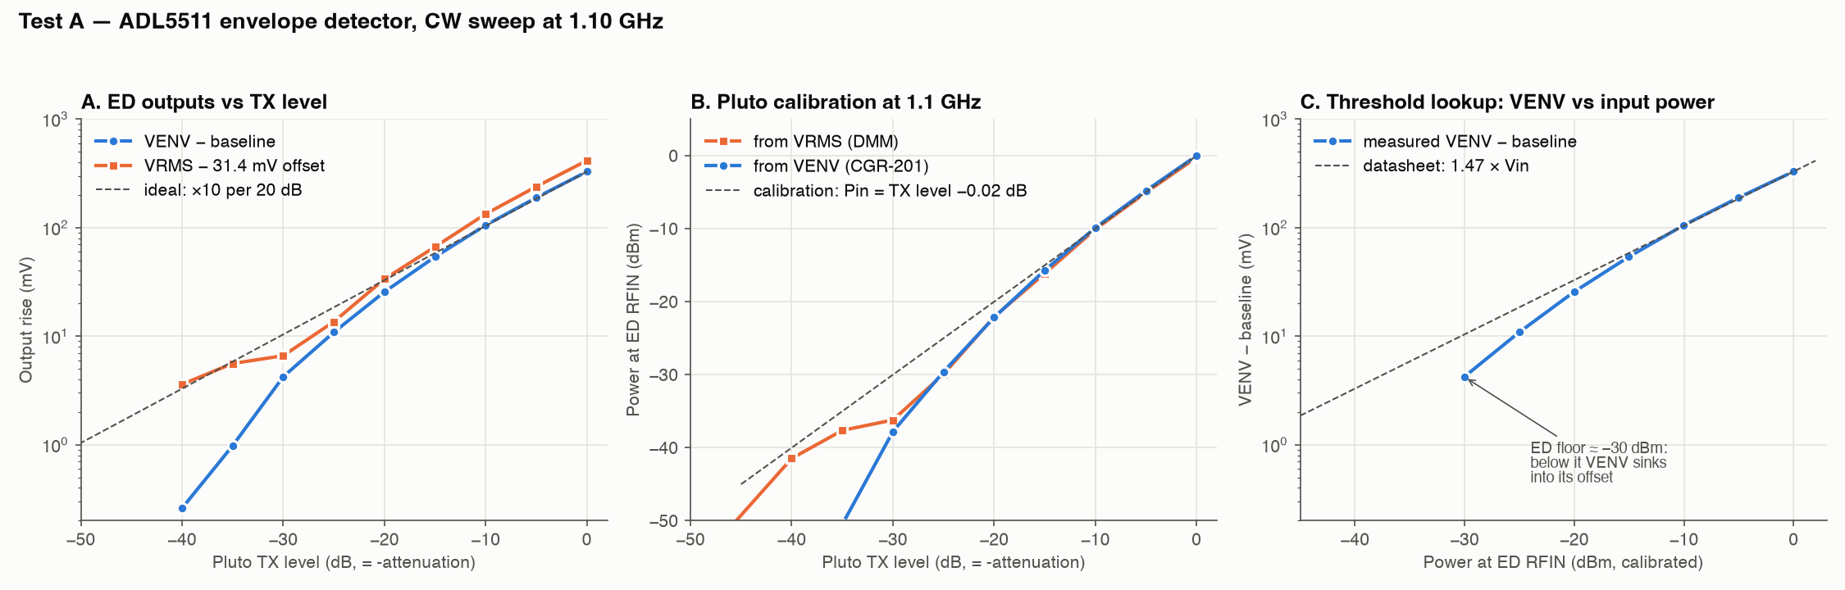
[picture p74: phase_detector_calibration/site/img/env_cw_sweep_1100MHz.png]
Envelope detector at 1100 MHz: both outputs against Pluto level, input power from each output, and VENV against calibrated input power


#### Test 2, CW at 1100 MHz, 26 Oct

Pluto attenuation (dB) | Power at RFIN (dBm) | VENV rise (mV) | VENV gain (V/V) | VRMS (V)
89 | none (floor) | −0.4 | — | 0.031
80 | none (floor) | −0.5 | — | 0.031
70 | none (floor) | −0.4 | — | 0.032
60 | none (floor) | −0.1 | — | 0.031
50 | none (floor) | −0.4 | — | 0.032
40 | −40 | 0.3 | — | 0.035
35 | −35 | 1.0 | — | 0.037
30 | −30 | 4.2 | 0.60 | 0.038
25 | −25 | 10.9 | 0.87 | 0.045
20 | −20 | 25.6 | 1.15 | 0.065
15 | −15 | 53.8 | 1.36 | 0.098
10 | −10 | 105.3 | 1.49 | 0.165
5 | −5 | 189.0 | 1.51 | 0.270
0 | −0 | 327.9 | 1.47 | 0.446

1. Pluto (Soapy sink, Homebrew GNU Radio) set to a tone 100 kHz above its LO, tone scale 0.7, at 1100 MHz. The script turned it on at 89 dB attenuation and stepped down to 0 dB.
2. At each step it waited 1 s, then averaged three CGR-201 captures (12 288 samples, 156 kHz sampling) of VENV on input A. VENV rise is the mean minus the mean before the Pluto was turned on (1.1412 V).
3. VRMS was read on a multimeter at each step and typed in. Its offset with no signal, 31.4 mV, is the mean of the 89 to 50 dB rows.
4. Power at RFIN: both outputs, at 10, 5 and 0 dB attenuation, with the datasheet gains, give the Pluto level. Every other row is that minus the attenuation (the AD9364 steps are exact: setting the gain and reading back the register gave −89.0, −79.0, 0.0 dB).
5. VENV gain is the VENV rise divided by the input voltage at that power.

\[ V_\text{in} = \frac{V_\text{RMS} - 31.4\ \text{mV}}{1.91} \;\text{or}\; \frac{V_\text{ENV,rise}}{1.47} \qquad P_\text{RFIN} = -A - 0.02\ \text{dBm} \quad (\text{worst disagreement } 0.24\ \text{dB}) \]

#### What it shows

- The detector meets its datasheet at 1.1 GHz: gain 1.47–1.51 V/V from −10 to 0 dBm; 25.6 mV at −20 dBm against the datasheet’s 26 mV.
- Below about −15 dBm VENV falls under the straight line 1.47 × Vin: 2 dB low at −20 dBm, 5 dB low at −30 dBm. Use the measured curve, not the formula, to set comparator thresholds.
- Usable range on this bench: −30 dBm (detector floor) to 0 dBm (the most this Pluto gives at tone scale 0.7).
- VENV scatter seen by the CGR-201: 2 mV rms with no signal, rising to 13.7 mV at 0 dBm (4 %). Checked on 1 Nov: a 400 kHz line from the Pluto, not the detector (see below). It averages out here, but the comparator sees it sample by sample.
- EREF and VENV fell 10 mV while the board warmed up, then held within 1–2.4 mV over the 10-minute sweep.

Under question: the detector puts the Pluto at 0.0 dBm (tone scale 0.7, 0 dB, 1100 MHz). The Pluto tab measured −0.36 dBm at tone scale 0.5 on the spectrum analyzer, which predicts +2.6 dBm at 0.7. The 2.6 dB difference is not explained: a different Pluto sample scaling in the Soapy driver (the Pluto tab used libiio), this detector’s gain being low, or the cable. Next check: run the same Soapy flowgraph into the spectrum analyzer.
1 Nov: the runs on 1 Nov used a different Pluto (serial …dfdb; 26 Oct …41f6), which reads 0.4 dB lower through the same detector, so part of the difference may be between Pluto units. Still open: every dBm on this tab rests on the detector’s datasheet gains until the spectrum analyzer check is done.

#### Comparator threshold from this curve

Threshold above the no-RF VENV | +10 mV | +20 mV | +50 mV | +100 mV | +200 mV
Trips at (dBm at RFIN) | −25.5 | −21.5 | −15.5 | −10.4 | −4.5

1. Let the detector run about 10 minutes.
2. With no RF, read VENV (CGR-201 or meter).
3. Set the comparator threshold to that value plus the margin. Start at +20 mV: ten times the drift once warm.

#### 1 Nov: band edges, pulse response, extra checks

- Different Pluto from 26 Oct: serial …dd1f84bfdb (26 Oct: …f3647c41f6). The same 1.1 GHz sweep read 0.44–0.49 dB lower at every level, and the ratio of the two detector outputs was unchanged, so the difference is the Pluto. The “TX level → dBm” calibration is per Pluto unit; ed_sweep.py now writes the serial into every CSV.
- Long RF cable Pluto → RFIN for the runs below, after a short cable gave intermittent RF at three steps (that run is kept as …_INTERMITTENT-RF_do-not-use.csv). Re-seating the SMA and repeating 0 and −10 dB gave the same readings within 0.03 dB.
- VRMS read on CGR-201 input B instead of the meter; EREF read on the meter before and after each run (1.137 → 1.136 V, 0.0 mV drift within each run).

Limitation, CGR-201 input B (VRMS): its absolute readings are only good to several mV. Against the meter it read 1.4–1.7 % low, and its offset drifted from −7.5 to −2.5 mV over 75 minutes. Hook on GND repeated within 1 mV, and swapping the leads showed the error stays with input B, so it is calibration, not wiring. Every VRMS value below is a rise (reading minus that run’s no-RF reading), which cancels the offset; the gain error is about 0.15 dB. Input A (VENV) read 4–8 mV above the meter’s EREF.

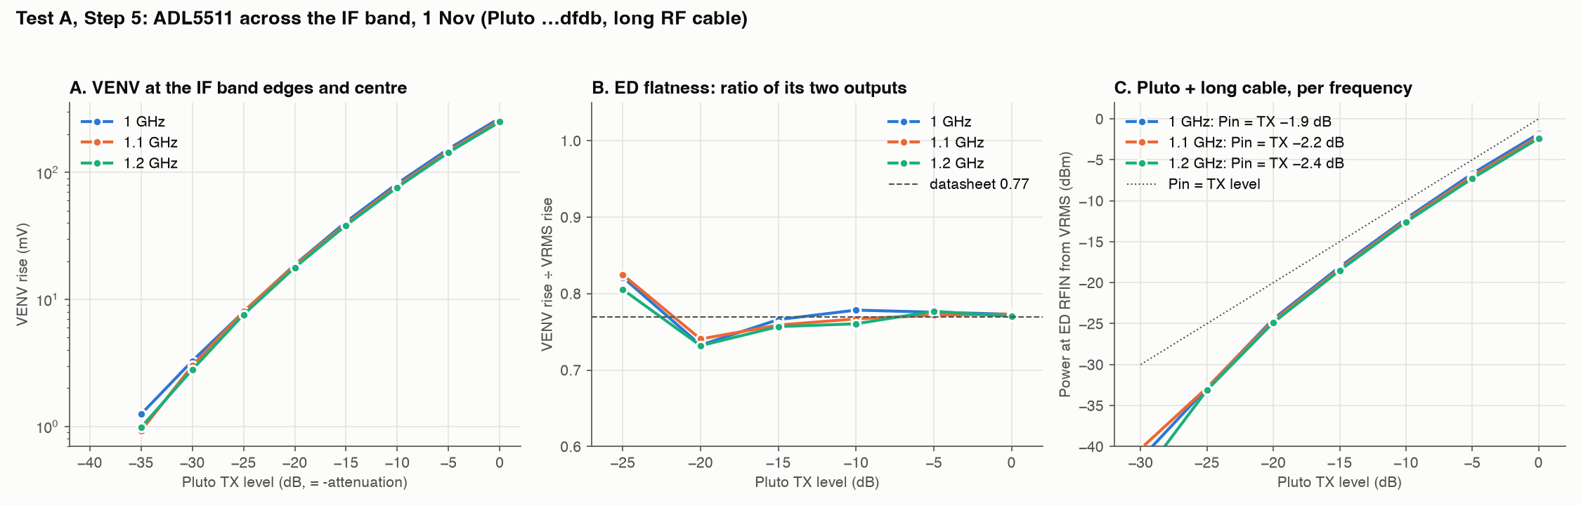
[picture p75: phase_detector_calibration/site/img/env_band_edges_20261101.png]
Envelope detector at 1.0, 1.1 and 1.2 GHz: VENV rise against Pluto level, ratio of its two outputs, and power at RFIN per frequency


Pluto TX level (dB) | VENV rise 1.0 GHz (mV) | 1.1 GHz | 1.2 GHz | VENV ÷ VRMS 1.0 GHz | 1.1 GHz | 1.2 GHz
−89 to −40 | ≤ 0.4 | ≤ 0.4 | ≤ 0.3 | — | — | —
−30 | 3.3 | 3.0 | 2.8 | — | — | —
−25 | 8.0 | 8.0 | 7.6 | 0.821 | 0.825 | 0.805
−20 | 18.8 | 18.6 | 17.8 | 0.733 | 0.741 | 0.732
−15 | 40.8 | 39.3 | 38.3 | 0.766 | 0.759 | 0.757
−10 | 81.8 | 78.7 | 76.2 | 0.778 | 0.767 | 0.760
−5 | 153.3 | 147.1 | 143.5 | 0.776 | 0.772 | 0.777
0 | 267.7 | 257.5 | 250.1 | 0.773 | 0.773 | 0.770

- Rises are against each sweep’s own floor rows (TX ≤ −50 dB). VRMS is divided by 0.986 for input B’s gain. No step was flagged unsteady.
- The detector is flat across the IF band: the ratio of its outputs at TX ≥ −15 dB averages 0.773 / 0.768 / 0.766, which is +0.06 and −0.02 dB against 1.1 GHz. One comparator threshold works for 9.3–9.5 GHz.
- Pluto (…dfdb) plus the long cable: power at RFIN = TX level − 1.9 / − 2.2 / − 2.4 dB at 1.0 / 1.1 / 1.2 GHz (from the detector’s datasheet gains; same caveat as above).

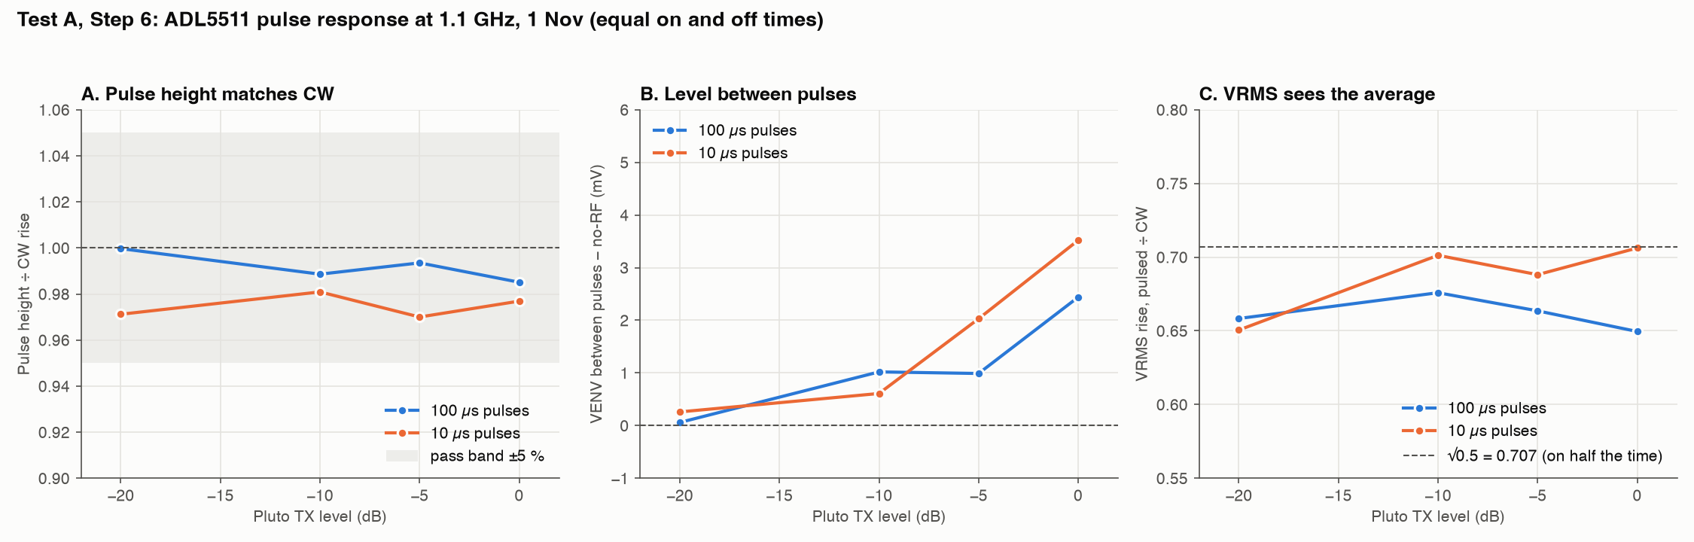
[picture p76: phase_detector_calibration/site/img/env_pulses_20261101.png]
Envelope detector pulse response at 1.1 GHz: pulse height against CW, level between pulses, and VRMS while pulsed


Pulse (equal gap) | TX level (dB) | CW rise (mV) | Pulse height (mV) | Height ÷ CW | Between pulses − no-RF (mV) | Pulses seen | VRMS rise pulsed ÷ CW
100 µs | −20 | 18.4 | 18.3 | 1.000 | +0.1 | 25 | 0.658
100 µs | −10 | 78.9 | 78.0 | 0.989 | +1.0 | 25 | 0.676
100 µs | −5 | 147.7 | 146.7 | 0.994 | +1.0 | 24 | 0.664
100 µs | 0 | 258.1 | 254.3 | 0.985 | +2.4 | 24 | 0.650
10 µs | −20 | 18.2 | 17.7 | 0.971 | +0.3 | 31 | 0.651
10 µs | −10 | 78.3 | 76.8 | 0.981 | +0.6 | 31 | 0.701
10 µs | −5 | 147.0 | 142.6 | 0.970 | +2.0 | 30 | 0.688
10 µs | 0 | 256.8 | 250.9 | 0.977 | +3.5 | 30 | 0.706

1. At each level the script measured CW, then switched the Pluto to pulses (2 MS/s, on and off for the same time) and the CGR-201 to 2.5 MS/s (100 µs) or 20 MS/s (10 µs).
2. Pulse height: mean of the flat top minus the mean between pulses, skipping the edges (edges found on a smoothed copy with hysteresis). Checked first on synthetic captures with known heights: within 0.3 mV.
- Pulse height equals CW within 1–3 %, so the CW threshold table holds for pulses.
- Between pulses VENV returns to within 0.1–3.5 mV of the no-RF level, well under a +20 mV threshold.
- VRMS reports the average power while pulsed (on half the time: √0.5 = 0.707). Use VENV for pulses.

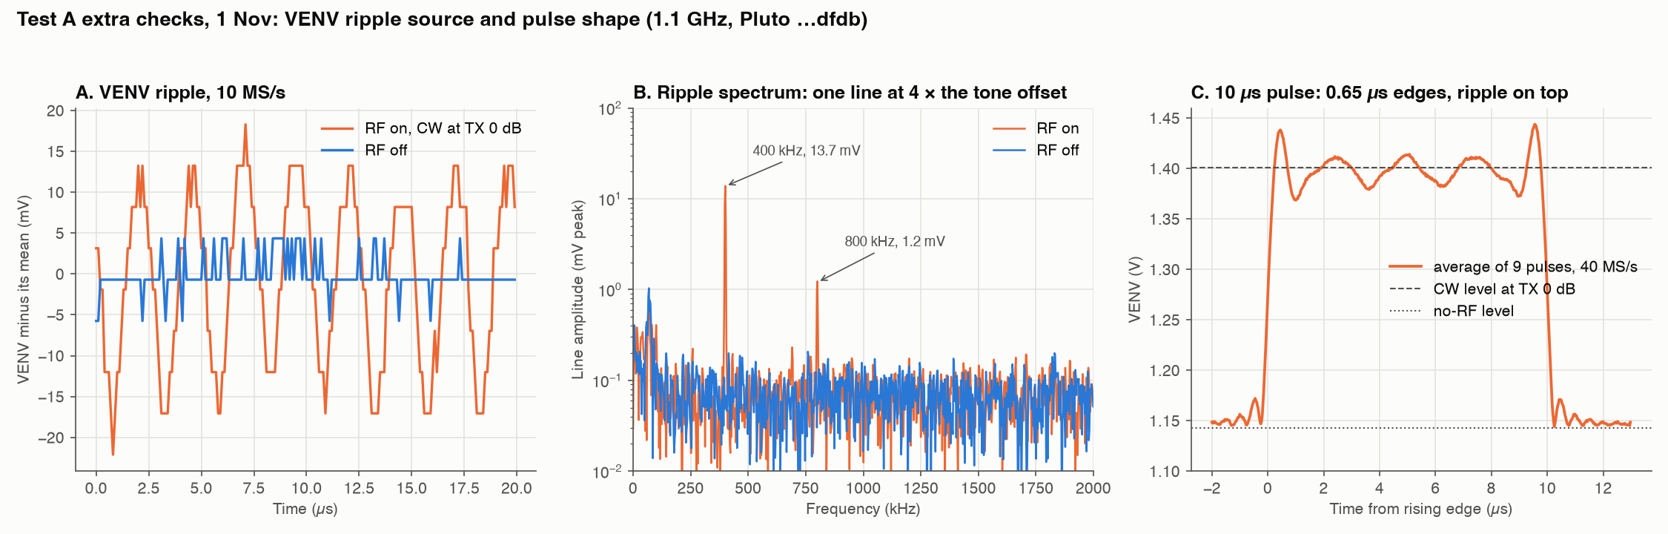
[picture p77: phase_detector_calibration/site/img/env_ripple_pulse_shape_20261101.png]
VENV ripple with RF on and off, its spectrum with a 400 kHz line, and the average 10 microsecond pulse


Check | Result
VENV ripple source (CW, TX 0 dB) | One line at 400 kHz, 13.7 mV peak, and 800 kHz (1.2 mV). Not there with RF off (only lines near 70 kHz under 1 mV). 400 kHz is 4 × the 100 kHz tone offset: the tone beating with a Pluto TX spur at −300 kHz, about −25 dBc. From the Pluto, not the detector.
10 µs pulse shape (40 MS/s, 9 pulses averaged) | 10–90 % edges 0.65 µs (the Pluto at 2 MS/s). Overshoot at both edges and ringing before each rising edge, which only a digital filter can do: the Pluto’s. The top wobbles ±2–3 % with the 400 kHz ripple, which is locked to the pulses. The 10 µs shortfall above is this, not the detector.
Input B: calibration or fault | Hook on GND −2.0 to −3.2 mV, repeatable within 1 mV; with the leads swapped the error stays with input B. Calibration.
RF connector re-seated | 0 dB: 258.2 mV (257.5–258.1 before); −10 dB: 79.0 mV (78.7–78.9). Within 0.03 dB

Unverified: that the 400 kHz ripple comes from the Pluto’s −3 × f spur. Its frequency is locked to the tone offset, which points that way; changing the offset to 150 kHz should move it to 600 kHz. Until then, treat the mechanism as likely, not shown. For the comparator test: at full Pluto output VENV carries ±14 mV of ripple and the pulses overshoot about 15 % at their edges. Keep the threshold well under the pulse top.

- Not done: the detector’s own 4 ns rise and 50 ns–1.2 µs pulses (needs the Pluto at a higher sample rate and the oscilloscope); an absolute power check of the Pluto and cable on the spectrum analyzer.

Files in envelope_detector/: data/ (26 Oct and 1 Nov CSVs and plots; each 1 Nov CSV names its Pluto), ed_sweep.py (Pluto + CGR-201 sweep, CW or pulses), ed_capture.py (raw captures), plot_ed_sweep.py, plot_band_and_pulses.py, plot_capture.py, ed_test_pluto_tx_soapy.grc, ED-TEST-RESULTS.md, ED-TEST-PROCEDURE.md, LIMITS-AND-TEST-PLAN.md, wiring drawings.

## Comparator

Analog Devices ADCMP604 on the EVAL-ADCMP604BKSZ board (on hand). The drawing calls for the ADCMP600. Output high while the envelope detector output is above the threshold.

Specs

Quantity | ADCMP604 (on hand) | ADCMP600 (drawing) | Unit
Supply | 2.5–5.0 (6.0 absolute max) | 2.5–5.5 (6.0 absolute max) | V
Supply current | 15 typ, 21 max | 3–4 | mA
Input range | −0.2 to VCC + 0.2 | −0.2 to VCC + 0.2 | V
Input absolute max | −0.5 to VCC + 0.5; ±50 mA | −0.5 to VCC + 0.5; ±50 mA | V
Offset | ±5 max | ±2 typ, ±5 max | mV
Hysteresis | under 0.1, fixed (ADCMP605 has a pin to set it) | 2, fixed | mV
Propagation delay (50 mV overdrive) | 1.6 | 3.5 at 2.5 V, 4.3 at 5.5 V | ns
Minimum pulse width | 1.3 | 3 to 4.5 | ns
Output | LVDS: 350 mV differential into 100 Ω, common mode 1.125–1.375 V | CMOS, 0 to VCC
Package | SC70-6: Q, VEE, VP, VN, VCC, Q-bar | SOT-23-5 / SC70-5

ADCMP604 datasheet (https://www.analog.com/media/en/technical-documentation/data-sheets/ADCMP604_605.pdf), ADCMP600 datasheet (https://www.analog.com/media/en/technical-documentation/data-sheets/ADCMP600_601_602.pdf). Eval board: SMA for IN+ (J1), IN− (J3), IN+FB (J2), IN−FB (J4), OUT+ (J7), OUT− (J8); banana jacks VCC, AGND, CGND/VEE. The back of the board has decoupling capacitors only, no resistors: the inputs are not terminated and there is no 100 Ω across the outputs.

LVDS output: it cannot drive the ADG901 control pin, a 3.3 V FPGA pin or the CGR-201 digital inputs directly. Put 100 Ω across OUT+ and OUT−. To the FPGA: an ECP5 differential input or an LVDS receiver (SN65LVDT2 at 3.3 V has the 100 Ω built in).

Expected behavior

- VP (IN+) = VENV from the detector, VN (IN−) = threshold. Q high while VENV is above the threshold.
- Supply 3.3 V: VENV can reach about 2.7 V in the JACON (−27 to +14 dBm at the detector), within VCC + 0.2 V.
- With almost no hysteresis, noise on VENV near the threshold makes the output toggle several times per pulse. Keep the threshold 10 mV or more above the no-RF VENV, or add positive feedback.
- Threshold for a given radar level: Envelope detector tab, “Comparator threshold from this curve”. +20 mV trips at −21.5 dBm at the detector.

Test plan

Wiring drawings: envelope_detector/bench_wiring.svg. Supply 3.3 V, 40 mA limit, CGND/VEE tied to AGND.

# | Test | Wiring | You do | Computer does | Expected | Pass if

1 | Supply | board only | set 3.3 V, 40 mA; inputs grounded | nothing | 15 mA | under 21 mA
2 | Trip point | CGR-201 output → 1 kΩ → IN+ (slow triangle 0.8–1.6 V, never negative); pot → IN− at 1.20 V; 100 Ω across OUT±; CGR-201 A on IN+, B on OUT+ | set the pot | capture A and B | OUT+ steps between ≈1.03 and 1.38 V where IN+ crosses 1.20 V | within ±5 mV
3 | Chatter | same, triangle slowed to 1–10 Hz | nothing | count extra edges | some | recorded
4 | Detector to comparator | VENV → IN+ (no termination); CGR-201 output (DC) → 1 kΩ → IN−; OUT+ → CGR-201 B | warm up 10 min; set IN− = no-RF VENV + 20 mV | pulse the Pluto; trigger on B; count pulses | one output pulse per RF pulse above −21.5 dBm | no missed or extra pulses
5 | Ripple vs threshold | as step 4 | Pluto CW at TX 0 dB, then TX −10 dB | step IN− up from the no-RF VENV past the CW VENV in the smallest steps available; note B at each step | B solid high, then toggling at ≈400 kHz, then solid low. Width of the toggling band = ripple peak to peak (≈27 mV at TX 0 dB) | band ≈±5 % of the VENV rise at both levels
6 | Edge chatter | as step 4, B on the Siglent scope instead (CGR-201 is 5 MHz and misses ns bursts) | pulsed, IN− = no-RF + 20 mV | zoom on each OUT+ edge | a single edge | count extra edges per pulse

For whoever runs the comparator tests: the Pluto puts a ripple on VENV. On 1 Nov, a steady Pluto tone gave a ±13.7 mV, 400 kHz ripple on VENV at TX 0 dB (Envelope detector tab, figure “ripple source and pulse shape”). It comes from a Pluto spur about 25 dB below the tone, not from the detector, so a real radar pulse should not have it. The ADCMP604 has almost no hysteresis (<0.1 mV) and a 1.6 ns delay, so it will follow this ripple wherever the ripple crosses the threshold.

- Threshold well below the pulse top (no higher than the middle of the VENV rise): the ripple never reaches it, one clean output pulse. This is the normal case.
- Threshold near the pulse top: the output toggles at 400 kHz during the pulse. Fix: lower the threshold.
- Pulse only just above the threshold (the weakest detectable level): ripple and noise cross the threshold whatever value is chosen, so the output chatters. The threshold cannot fix this; count it in the S-curve (step 2 of Test C) and plan for the FPGA to ignore “on” periods shorter than a minimum width.
- Slow Pluto edges (0.65 μs): noise during the rise can give a short burst of toggles at each edge. Ns-scale, so look with the Siglent scope (step 6).

Step 5 measures the ripple with the comparator itself; no separate ripple test is needed first. Unverified: that the ripple is a fixed ≈±5 % of the VENV rise at every level (predicted from the −25 dBc spur, measured only at TX 0 dB; below about −15 dBm it is under the CGR-201’s 5 mV steps). Step 5 at two levels checks it. Moving the Pluto tone offset from 100 kHz to 1 MHz should move the ripple to 4 MHz, which would confirm the source.

Set the CGR-201 output to DC before connecting it: it can swing to −3 V and the comparator input limit is −0.5 V. The 1 kΩ limits the current if it does.

Results

Not run yet.

## VCO

Crystek CVCO55BE-0800-1600 on CEVAL-055 board. Sends the reply at the frequency the phase detector measured.

Specs

Quantity | Value | Source
Frequency range | 800 to 1600 MHz | DigiKey listing
Tuning voltage | 0.5 to 19 V | DigiKey listing
Output power | +6 ± 2 dBm (2.5 to 6.3 mW, 0.35 to 0.56 V rms) | DigiKey listing
Supply voltage used | 11.5 V | design drawing
Supply current | 30 mA max | DigiKey listing
Pushing | 2 MHz per volt of supply | DigiKey listing
Second harmonic | −10 dBc | DigiKey listing
RF input | none

DigiKey listing (https://www.digikey.com/en/products/detail/crystek-corporation/CVCO55BE-0800-1600/1643988), Crystek datasheet (PDF) (https://sorin-jayaweera.github.io/Panthalassa-Clinic-Team/datasheets/CVCO55BE-0800-1600.pdf). The Crystek datasheet itself has not been read.

Expected behavior

- Frequency rises with tuning voltage. The drawing expects 1.0–1.2 GHz for about 6 to 9.5 V.
- Output about +6 dBm, steady across the band.
- It should follow a change in tuning voltage in well under the 0.7 µs reply time.

Test plan

1. Frequency vs tuning voltage, by hand, 0 to 10 V. Done 4 Oct.
2. Output power vs frequency. Done 6 Oct.
3. Frequency vs tuning voltage by computer, 0 to 3.5 V in 0.02 V steps. Done 10 Oct.
4. Response to a voltage step. Done 10 Oct, limited by the 145 ns edge of the Syscomp.
5. Drift over 74 minutes. Done 10 Oct.
6. Not done: the computer-run sweep over 4.8 to 7.8 V. The Syscomp stops at 3.52 V. See Tests to run, TX1.

Results

Quantity | Value | Date
Frequency range seen | 733 MHz at 0 V to 1360 MHz at 10.1 V | 4 Oct
Tuning voltage for 1.0–1.2 GHz | 4.8 to 7.8 V (drawing expected 6 to 9.5 V) | 4 Oct
Slope in 1.0–1.2 GHz | 68 MHz/V | 4 Oct
Output power in 1.0–1.2 GHz | +4.8 to +7.4 dBm | 6 Oct
Repeatability at a fixed voltage | 0.10 MHz | 10 Oct
Drift over 74 min | 59 kHz rms, no trend | 10 Oct
Delay, tuning pin to frequency | 26 ns | 10 Oct

Frequency vs voltage, 0 to 10 V

VCO frequency against tuning voltage 0 to 10 V

#### Result

- 1.0 GHz needs 4.83 V. 1.2 GHz needs 7.75 V.
- The line 0.8 GHz + 60 MHz/V is 48 to 97 MHz higher than the measurement.
- The two data sets differ by up to 16 MHz at the same voltage. The VCO was connected to different things each time.

#### How it was made

1. Grey squares: on 4 Oct the tuning voltage was set by hand with a bench supply. The VCO was connected straight to the spectrum analyzer. The frequency was read after waiting 10 s.
2. Green line: on 10 Oct the computer set the voltage and read the analyzer, 176 points. The VCO was connected to the tee, splitter and mixer.
3. The orange band marks 1.0–1.2 GHz. The voltages for the band edges were found by interpolating the grey points.

Frequency vs voltage, 0 to 3.5 V

VCO output frequency against tuning voltage Vt, 0 to 3.5 V

#### Result

- 743.6 MHz at 0 V. 920.0 MHz at 3.50 V.
- 14 points repeated on the way down agree within 0.10 MHz.

#### How it was made

1. The Syscomp output is set to a voltage, with its waveform switched off.
2. Scope CH1 reads the voltage. The Syscomp is adjusted until CH1 is within 3 mV of the target.
3. The spectrum analyzer does one sweep over 600–1100 MHz and finds the peak.
4. It does a second sweep 2 MHz wide centred on that peak and reads the peak frequency and power. The marker step is 2 MHz / 751 = 2.7 kHz.
5. The voltage is raised 0.02 V and the steps repeat. 176 voltages in total.
6. Then 14 voltages are measured again going down, to check repeatability.

\[ c_{n+1} = c_n + \frac{V_\text{target} - V_\text{CH1}}{1.875\ \text{mV per code}} \]

Code

def set_vt(g, s, target, code):
    s.write(f"C1:OFST {-target:.3f}V")      # centre scope CH1 on the target
    for _ in range(4):
        g.set_offset_raw(code)              # Syscomp output code
        time.sleep(0.6)
        v, _ = scope_mean(s, 1, n=2)        # read Vt on the scope
        if abs(v - target) < 0.003:
            break
        code += (target - v) / OFFSET_V_PER_CODE   # 1.875 mV per code
    return v, code

def measure(self):                          # spectrum analyzer
    f, _ = self._peak(850e6, 500e6)         # wide span: find the peak
    f, p = self._peak(f, 2e6)               # 2 MHz span: read it
    return f, p

Data file: phase_detector_calibration_run3_cleanDC_0p02V_steps.csv. Table: see the Look up tables tab.

Output power vs frequency

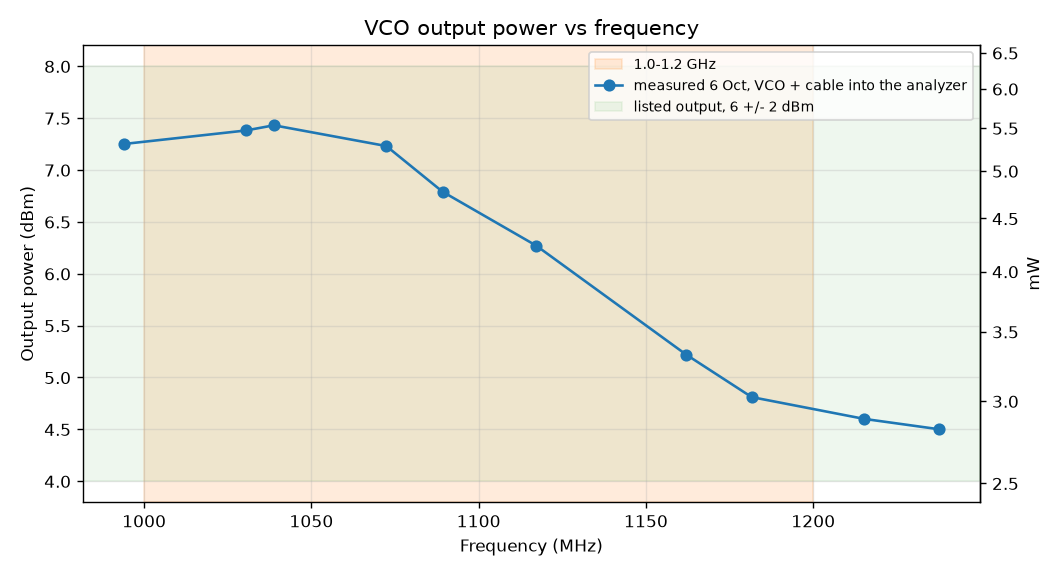
[picture p78: phase_detector_calibration/site/img/comp_vco_power.png]
VCO output power against frequency


#### Result

- +7.4 dBm at 1.04 GHz. +4.8 dBm at 1.18 GHz. +4.5 dBm at 1.24 GHz.

#### How it was made

1. 6 Oct. VCO connected to the spectrum analyzer through one cable.
2. The tuning voltage was set by hand to ten values.
3. Frequency and peak power were read from the analyzer at each.

Analyzer power reading, 744 to 920 MHz

Analyzer power against frequency, one sweep

Analyzer power, one sweep against 18 repeats

#### Result

- 15 of 648 readings were more than 2 dB below the median for their voltage. They occurred at random voltages and times.
- During those readings the mixer output changed by 0.23 mV at most. The mixer output changes strongly with power. So the VCO power did not really drop.
- From 850 to 890 MHz the reading is 4 to 7 dB low in every pass.
- Correlation between the power reading and the VCO tuning slope: −0.89.

#### Explanation (not tested)

The peak was read through a 30 kHz filter. Noise on the tuning voltage moves the VCO frequency. If it moves by more than 30 kHz during the sweep, part of the signal falls outside the filter and the peak reads low. This is worst where the tuning slope is steepest.

\[ \Delta f_\text{rms} = K_v \cdot \sigma_{V_t} \qquad K_v = 33\ \text{to}\ 90\ \text{MHz/V} \]

With 1 mV of noise this is 33 to 90 kHz. To check: repeat with a 1 MHz filter and averaging.

#### How it was made

1. First plot: the peak power from the 2 MHz sweep in the calibration run. One reading per voltage.
2. Second plot: the same reading taken in each of the 18 drift passes. Dots are the mean. Bars run from the lowest to the highest reading.

Drift over 74 minutes

Heat maps of frequency, mixer output and power deviation over 74 minutes

#### Result

- Left panel, VCO frequency: 59 kHz rms scatter. Largest single deviation 324 kHz. No trend with time.
- The scatter is larger above 2 V. The tuning slope is steeper there, so a 1 mV error in setting the voltage changes the frequency more. The voltage setting repeats to 1.7 mV.

#### How it was made

1. The 0 to 3.5 V sweep was run 18 times in a row, in 0.1 V steps (36 voltages). This took 74 minutes.
2. For each voltage, the median of its 18 readings was calculated.
3. Each cell is one reading minus the median for that voltage. Red is above the median, blue is below.
4. Time runs left to right. Voltage runs bottom to top.

\[ \Delta_{ij} = x_{ij} - \operatorname{median}_i(x_{ij}) \]

Code

F = np.array([p["vco_freq_hz"] for p in passes]) / 1e6      # 18 passes x 36 voltages
dF = (F - np.median(F, axis=0)) * 1e3                        # kHz away from the median of that voltage
ax.pcolormesh(minutes, vt, dF.T, cmap="RdBu_r", vmin=-lim, vmax=lim)

Response to a voltage step, VCO alone

VCO frequency against time for ten step sizes

Rise time against step size

Settled frequency against voltage

#### Result

- Frequency 10–90 % rise time: 100 to 176 ns. The drive voltage rise time is 145 ns.
- The frequency follows the drive voltage with 0 to 12 ns of lag. The measurement is limited by the drive, not the VCO.
- The “static DC” curve in the third plot is wrong by up to 1.7 MHz. See the Errors tab.

#### How it was made

1. The VCO output was connected to the scope. The mixer was not used.
2. The scope samples at 500 MSa/s. A 765–875 MHz signal appears in the samples as a lower frequency, 235–125 MHz. This lower frequency is called the alias.
3. The alias moves by 1 MHz when the real frequency moves by 1 MHz. So the real frequency is 1000 MHz minus the alias.
4. The Syscomp drove a 50 kHz square wave from 0.5 V to a high level. Ten high levels from 0.75 to 3.0 V.
5. The signal at the scope was tens of microvolts, smaller than the scope noise. One edge is not enough to see it.
6. The VCO phase is different on every edge, so the waveforms cannot be averaged directly. Instead, each waveform is multiplied by a copy of itself a few samples earlier. The phase cancels in this product and the frequency remains.
7. The product was averaged over 1112 edges per step. The angle of the average gives the alias frequency at each instant.
8. Rise time is the time for the frequency to go from 10 % to 90 % of the step.

\[ f_\text{alias} = |f - k f_s| \qquad f = 2 f_s - f_\text{alias} \quad (750\text{-}1000\ \text{MHz},\ f_s = 500\ \text{MSa/s}) \]

\[ p[n] = z[n+m]\, z^{*}[n] \qquad f_\text{alias} = \frac{f_s}{2\pi m}\arg\langle p[n] \rangle_\text{edges} \]

Code

z = np.fft.ifft(2 * spec * w)                 # keep only the alias band, positive frequencies
p = z[lag:] * np.conj(z[:-lag])               # product of the signal with itself, lag samples earlier
# average p over all edges, then:
f_alias = band_start + np.mod(np.angle(p_avg * np.exp(-2j*np.pi*band_start*lag/fs)), 2*np.pi) * fs / (2*np.pi*lag)
f_true = 1000e6 - f_alias                     # for 750-1000 MHz sampled at 500 MSa/s

Notes

#### Measured

- The tuning curve is not a straight line. Use the look up table.
- The frequency depends on what the output is connected to. Calibrate in the final wiring.
- The 4 Oct note that the VCO looked slow (seconds) was the bench supply and the analyzer sweep. The VCO responds in under 0.2 µs.
- The 4 Oct note of two discrete frequency values within 3 MHz was the analyzer marker step (2.67 MHz at a 2 GHz span).

#### Consequences

- 1.0–1.2 GHz needs 4.8–7.8 V. The Syscomp reaches 3.52 V. All computer-run tests so far were at 744–920 MHz.
- Racon tolerance ±1.5 to ±3.5 MHz at 68 MHz/V is ±22 to ±51 mV on the tuning pin.

#### Not known

- Change with temperature and supply voltage.
- Response above 7 MHz. This needs a faster edge than the Syscomp gives.

## Pluto

Analog Devices ADALM-Pluto SDR. Test source for 1.0–1.2 GHz. Not part of the JACON design.

Specs

Quantity | Min | Typical | Max | Unit
Tuning range (stock) | 325 | — | 3800 | MHz
TX output power (ADI figure) | — | — | +7 | dBm
TX output power, this unit, 1100 MHz, measured | — | — | +4.7 | dBm
TX attenuation setting | 0 | — | 89.75 | dB
TX attenuation step | — | 0.25 | — | dB
Bandwidth | 0.2 | — | 20 | MHz
Converter resolution | — | 12 | — | bits
Frequency accuracy | — | — | ±25 | ppm
Connectors | — | SMA, 50 Ω | —
Supply | — | USB, 5 V | —

ADI wiki (https://wiki.analog.com/university/tools/pluto). The team notes give a maximum output of +11 dBm. The measured output at attenuation 0 dB is about 0 dBm at tone scale 0.5 and +4.7 dBm at tone scale 1.0 (1100 MHz).

Settings found on this unit: sample rate 30.72 MS/s, RF bandwidth 18 MHz. It dropped off USB once during the first run (21:26, 12 Oct) and needed the USB cable replugged.

#### How the computer controls it

- Address ip:192.168.2.1 over USB. Program iio_attr.exe. Script clinic\claude\sdr\pluto_cw.py.
- The tone is made inside the Pluto, 1 MHz above the LO. The LO is set to the wanted frequency minus 1 MHz.
- Level is set two ways: the attenuation setting (0 to 89.75 dB) and the tone scale (0 to 1, a digital amplitude).
- pluto_cw.py refuses any attenuation below 31 dB unless the limit is changed in the file. 31 dB keeps the output under −20 dBm. For this test the limit was set to 0 dB, because only the spectrum analyzer (safe to +30 dBm) was connected. It was set back to 31 dB afterwards.

Expected behavior

- Output falls 1 dB for each 1 dB of attenuation setting.
- Output changes by 20 log10 of the tone scale.
- Output is flat within a few dB from 325 MHz to 2.1 GHz.
- Frequency is within 25 ppm: 27.5 kHz at 1.1 GHz.
- Besides the tone there is a line at the LO (1 MHz below) and one at the other sideband (2 MHz below). Their levels are not specified.
- A harmonic at twice the tone frequency. Level not specified.

\[ P_\text{out} = P_0(f) - A + 20\log_{10}\!\left(\frac{s}{0.5}\right) \]

\(P_0(f)\) = output at attenuation 0 dB and tone scale 0.5. \(A\) = attenuation setting in dB. \(s\) = tone scale.

Test plan

One wiring for every test: Pluto TX to the spectrum analyzer input. Pluto on USB. No wiring changes.

# | Test | Wiring | You do | Computer does | Expected | Pass if

A | Output against attenuation | Pluto TX → spectrum analyzer | nothing | step attenuation 0–40 dB in 1 dB steps, then to 70 dB, at 1000, 1100, 1200 MHz; ten settings at ten other frequencies, 400–2000 MHz | 1 dB per dB | recorded as a table
B | Output against frequency | same | nothing | step 350–2100 MHz in 25 MHz steps (10 MHz inside 1.0–1.2 GHz) at 20 dB and 0 dB | flat within a few dB | recorded
C | Output against tone scale | same | nothing | step tone scale 0.05–1.0 at 1100 MHz, at 20 dB and 0 dB | 20 log10(scale) | recorded
D | Frequency error | same | nothing | read the tone in a 20 kHz span at eight frequencies, 400–2000 MHz | within 25 ppm | recorded
E | Spectrum | same | nothing | save traces at 10 MHz span, 200 MHz span and 0–2.1 GHz, at 1000, 1100, 1200 MHz, at 20 dB and 0 dB; read 2000 MHz with the tone at 1000 MHz | lines at the LO and the other sideband; a second harmonic | recorded
F | Stability | same | nothing | read level and frequency 40 times over about 3 minutes | not specified | recorded
G | Analyzer check and repeat | same | nothing | read one tone at reference levels −10, 0, +10, +20 dBm; then repeat attenuation 40, 20, 0, 20, 40 dB | same reading each time | recorded
H | Tone off | same | nothing | set tone scale 0; read the largest line near the LO at 0, 10, 31 dB | not specified | recorded

Results

#### What was learned

Subject | Finding | What to do
Highest output | Tone scale 1.0, attenuation 0 dB: 6.7 dBm at 400 MHz, 5.7 dBm at 1000 MHz, 4.7 dBm at 1100 MHz, 5.1 dBm at 1200 MHz, 1.5 dBm at 2000 MHz. The team notes say +11 dBm; this unit does not reach it. | Plan tests around +5 dBm at most. Add an amplifier if a part needs more.
Level against attenuation setting | Follows the setting within 0.6 dB from 20 dB down to 89.75 dB (−89.5 dBm at 1100 MHz). Reads 0.6 to 1.0 dB low at 0 dB. | Use the look up table for 0 to 20 dB. From 20 dB up, output = (20 dB reading) + 20 − setting.
0.25 dB steps | Average step 0.24 dB, but single steps range from 0.09 to 0.41 dB. The same setting gives the same level from above or below (within 0.02 dB). | Do not count steps to set a level. Read the level, or use whole-dB settings from the table.
Tone scale | Follows 20 log10(scale) within 0.25 dB at 20 dB attenuation, from scale 0.02 to 1.0. | Use the scale as a fine level control when the attenuation is 20 dB or more.
Distortion at high scale | At scale 1.0 and 0 dB attenuation a line 4 MHz below the tone is only 31 dB under it. At scale 0.5 it is 46 dB under; at scale 0.3, 52 dB under. | Keep the tone scale at 0.3 or below when a clean tone matters.
Third harmonic of the LO | A line near three times the tone frequency, 10 to 16 dB under the tone. Measured for tones of 350 to 700 MHz. For a 1.0 to 1.2 GHz tone it is at 3.0 to 3.6 GHz, above the spectrum analyzer's range, so not measured there. | Assume it is present at 1.0 to 1.2 GHz. Parts that work at 3 GHz (the amplifiers, mixers) receive it. Add a low-pass filter after the Pluto for compression or harmonic tests, and check with the SM200B.
Second and third harmonic of the tone | 50 to 60 dB under the tone at scale 0.5, 0 dB attenuation. 40 to 60 dB under at scale 1.0. | Small enough to ignore next to the line above.
LO leakage and other sideband | At 1100 MHz, 0 dB attenuation: LO leakage 61 to 67 dB under the tone, other sideband 67 to 72 dB under. | No action needed.
Tone offset from the LO | Level is flat within 0.4 dB out to 8 MHz from the LO, 1.3 dB down at 10 MHz, 7.8 dB down at 14 MHz. | Keep the tone within 8 MHz of the LO. The scripts use 1 MHz.
Two tones | At 0 dB attenuation with each tone at scale 0.5, the third-order products are 30 dB under the tones. At 5 dB attenuation with each tone at scale 0.25 to 0.5 they are over 50 dB under. | For two-tone tests use 5 dB attenuation or more and each tone at scale 0.4 or less.
Frequency | 12.6 to 13.1 ppm low against the spectrum analyzer, the same at every frequency. | Set the Pluto 12.8 ppm high (14.1 kHz at 1100 MHz) to land on a wanted frequency.
Repeatability | Leaving 1100 MHz and returning 30 times: level spread 0.03 dB. Setting 0 dB 30 times: 0.01 dB. | One reading is enough.
Settling | After a retune or an attenuation change the level is at its final value within one 5.3 ms sample. | A 0.1 s wait after each change is ample.
Flatness | At 0 dB: +1.2 dBm at 350 MHz falling to −6.3 dBm near 1600 MHz. 1.1 dB spread inside 1.0 to 1.2 GHz. | Use the per-frequency table, not one number, when a test covers more than one frequency. Part of the dip near 1600 MHz moved when the cable was disturbed on 13 Oct, so it is at least partly the cable.
USB, first dropout | Dropped off USB at 21:26 on 12 Oct, 5 minutes into the first run. Needed the cable replugged. | Scripts should save each reading as it is taken and be able to resume.
LO leakage at low levels | The LO leakage is about −60 dBm at 0 and 10 dB attenuation whatever the tone scale, −68 dBm at 20 dB, −78 dBm at 30 and 40 dB, then falls 1 dB per dB. With a small tone scale it is close to the tone: at 0 dB attenuation and scale 0.02 the tone is −28 dBm and the LO leakage only 31 dB under it. | To get a low level, raise the attenuation and keep the tone scale at 0.2 to 0.5. Do not use a small tone scale at low attenuation.
IF band table | 1000 to 1200 MHz in 1 MHz steps, attenuation 0 to 40 dB in 2 dB steps (4221 readings). At 0 dB the output is −1.14 to 0.28 dBm. It changes by at most 0.09 dB from one MHz to the next. | Use pluto_if_band_table.csv to turn a setting into dBm for any IF-band test.
Tuning step | A request for 5 Hz more moves the tone by about 5 to 7 Hz; 1 kHz more moves it 1001 Hz. During the test the tone was also drifting by 2 to 8 Hz per second. | Frequency can be set to a few Hz. Drift, not step size, limits how well the frequency is known.
Noise close to the tone | 30 to 45 kHz from the tone the noise is about −96 dBc/Hz, and 300 to 450 kHz away about −107 dBc/Hz. One pair of lines 1.4 kHz either side of the 1000 MHz tone, 59 dB under it; none at 1100 or 1200 MHz. | This is near what the spectrum analyzer itself contributes, so the Pluto is at least this good. It is not a limit for the planned tests.
Pulsed output | Works. Level during a pulse equals the continuous-tone level. Width and spacing are correct for pulses from 100 µs down to 300 ns (checked from the spectrum nulls). Below about 100 ns the pulse comes out wider and lower than asked, because the RF bandwidth setting is 18 MHz. Between pulses only the LO leakage remains (about 60 dB under the pulse at 0 dB attenuation). | Use sdr\pluto_pulse.py for pulse tests of 300 ns and longer. For 50 ns pulses the sample rate and bandwidth must be raised and rechecked. The spectrum analyzer cannot show pulse shape under 10 µs; use a detector and the oscilloscope.
Warm-up | Two cold starts were logged. From 27 °C the level fell 0.11 dB in 28 minutes. From 25 °C it fell 0.20 dB in 34 minutes and was still falling slowly at 31.6 °C. Frequency error went from about −10.3 ppm cold to −12.4 ppm after 35 minutes and −12.6 ppm after 2 hours. | Let it run 45 minutes before a level-critical test and an hour before a frequency-critical one. A cold Pluto reads up to 0.4 dB higher than the tables, which were taken warm (33 °C).
The RF connection | On 13 Oct after replugging, every level read 0.3 to 0.5 dB higher than the night before, and 1 to 3.5 dB higher from 1250 to 1750 MHz. At 11:31 the computer was moved; the level stepped down 0.45 dB and the whole table then matched the night before within 0.06 dB below 1400 MHz. The Pluto had not changed. The cable or a connector had. | Tighten the SMA connectors and do not move the cable during a test. Take the without-part reference with the same cable, in the same position, on the same day. The dip near 1450 to 1700 MHz in the frequency sweep may be the cable, not the Pluto.
Look up function | sdr\pluto_level.py: pluto_dbm(freq, att, scale) gives the output in dBm from the measured 1.0 to 1.2 GHz table; pluto_setting(freq, want_dbm) gives the attenuation setting for a wanted level. | Use it to turn settings into power when analysing a chain test. Good to about 0.5 dB across days.
Not measured | Pulse rise time (the spectrum analyzer cannot resolve under 10 µs). The line near 3 × LO for 1.0 to 1.2 GHz tones (3.0 to 3.6 GHz is above the analyzer's range). | Rise time: a detector on the oscilloscope, or the SM200B. 3 × LO: the SM200B.
USB, second dropout | Dropped off USB a second time at 23:51 on 12 Oct, after 2 h 20 min of continuous use. Both times it stopped answering during a frequency change and then disappeared from Windows. | Any long run needs someone able to replug it, or a powered USB hub that can be switched from the computer.

#### First run, tests A to H

Test | Result | Date
A. Output against attenuation | 0.14, −0.36, −0.23 dBm at 0 dB (1000, 1100, 1200 MHz). 1 dB per dB within 0.2 dB from 20 to 40 dB. Reads 0.6 to 1.0 dB low at 0 dB. | 12 Oct
A. Other frequencies | 10 of 10 frequencies done: 400, 600, 800, 900, 1050, 1150, 1400, 1600, 1800, 2000 MHz | 12 Oct
B. Output against frequency | spread 1.08 dB inside 1000 to 1200 MHz; 6.5 dB over 350 to 2100 MHz | 12 Oct
C. Output against tone scale | follows 20 log10(scale) within 0.25 dB at 20 dB attenuation; 0.8 dB low at scale 1.0 and 0 dB attenuation. Highest output +4.7 dBm | 12 Oct
D. Frequency error | tone is 12.7 to 13.1 ppm low at all eight frequencies (14.1 kHz low at 1100 MHz) | 12 Oct
E. Spectrum | no line above the analyzer noise: LO leakage and other sideband more than 54 dB under the tone at 0 dB attenuation | 12 Oct
F. Stability | level spread 0.03 dB and frequency spread 186 Hz over 139 s | 12 Oct
G. Analyzer check and repeat | analyzer reads the same within 0.08 dB at four reference levels; repeat readings within 0.14 dB | 12 Oct
H. Tone off | nothing above the analyzer noise (−54 dBm) | 12 Oct

#### Test A: output against attenuation setting, 12 Oct

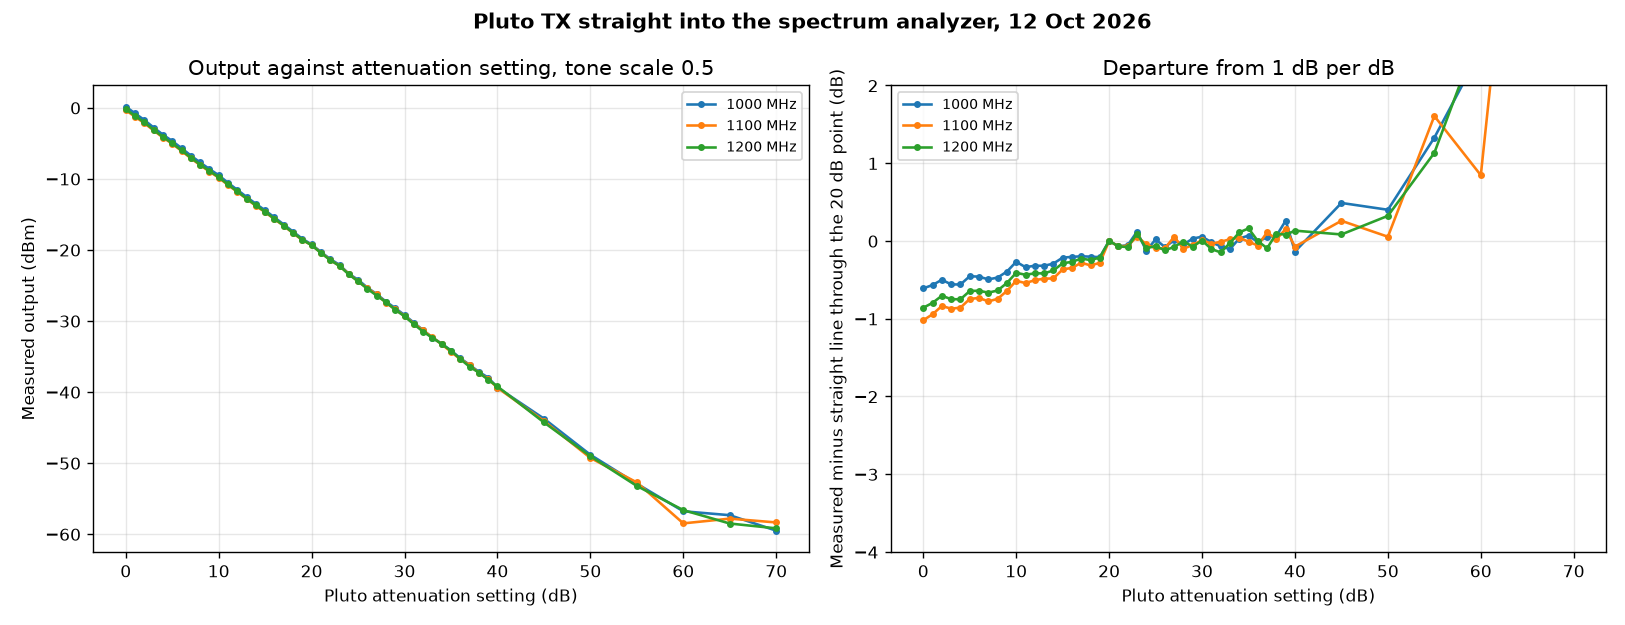
[picture p79: phase_detector_calibration/site/img/pluto_att.png]
Pluto output against attenuation setting at 1000, 1100 and 1200 MHz, and the departure from 1 dB per dB


1. Wiring: Pluto TX to the spectrum analyzer (Siglent SSA3021X) input. Nothing else connected.
2. Pluto: one tone, 1 MHz above the LO, tone scale 0.5. The attenuation setting was stepped 0 to 40 dB in 1 dB steps, then 45 to 70 dB in 5 dB steps.
3. Analyzer: reference level +10 dBm, span 2 MHz centred on the tone, one sweep per reading, peak marker.
4. Repeated at 1000, 1100 and 1200 MHz. 47 settings at each, 141 readings.

Attenuation setting (dB) | 1000 MHz (dB) | 1100 MHz (dB) | 1200 MHz (dB)
0 | −0.61 | −1.02 | −0.86
1 | −0.57 | −0.94 | −0.80
2 | −0.50 | −0.84 | −0.71
3 | −0.56 | −0.87 | −0.75
5 | −0.45 | −0.75 | −0.64
10 | −0.27 | −0.51 | −0.41
30 | 0.05 | 0.01 | 0.00
40 | −0.14 | −0.07 | 0.13
50 | 0.40 | 0.05 | 0.32
60 | 2.45 | 0.84 | 2.73
70 | 9.72 | 10.98 | 10.17

The table above is the measured level minus a straight line of 1 dB per dB drawn through the 20 dB reading.

\[ \text{departure}(A) = P(A) - \left[P(20) + 20 - A\right] \]

- From 20 to 40 dB the output follows the setting within 0.2 dB.
- Below 20 dB the output is lower than the setting says: 0.3 to 0.5 dB low at 10 dB, 0.6 to 1.0 dB low at 0 dB. There is a step of about 0.2 dB between 19 and 20 dB.
- Test G: the analyzer reads the same tone within 0.08 dB at reference levels from −10 to +20 dBm, so the analyzer is not the cause.
- Test C: at 0 dB the output rises 0.2 dB less than it should between tone scale 0.05 and 0.5. So about 0.2 dB of the shortfall is the output stage compressing. The rest is the attenuator steps not being exact.
- At 55 dB and above the reading stops falling. The tone is then at the analyzer noise level for this reference level (about −58 dBm). The rows at 55 to 70 dB are not valid Pluto levels.
- The output at 0 dB and tone scale 0.5 is about 0 dBm (1 mW). At tone scale 1.0 it is +4.7 dBm (3.0 mW) at 1100 MHz. The team notes give a maximum of +11 dBm; this Pluto does not reach that.

#### Look up table: attenuation setting to output power

Setting (dB) | 1000 MHz (dBm) | 1100 MHz (dBm) | 1200 MHz (dBm)
0 | 0.14 | −0.36 | −0.23
1 | −0.81 | −1.29 | −1.17
2 | −1.75 | −2.18 | −2.07
3 | −2.81 | −3.22 | −3.12
4 | −3.81 | −4.20 | −4.12
5 | −4.70 | −5.09 | −5.01
6 | −5.71 | −6.08 | −6.01
7 | −6.74 | −7.12 | −7.03
8 | −7.72 | −8.09 | −8.01
9 | −8.64 | −8.99 | −8.91
10 | −9.52 | −9.86 | −9.78
11 | −10.58 | −10.89 | −10.80
12 | −11.57 | −11.85 | −11.79
13 | −12.57 | −12.83 | −12.79
14 | −13.54 | −13.83 | −13.75
15 | −14.46 | −14.71 | −14.66
16 | −15.45 | −15.69 | −15.64
17 | −16.44 | −16.62 | −16.60
18 | −17.45 | −17.66 | −17.62
19 | −18.46 | −18.63 | −18.58
20 | −19.25 | −19.34 | −19.37
21 | −20.32 | −20.41 | −20.44
22 | −21.30 | −21.41 | −21.45
23 | −22.13 | −22.29 | −22.27
24 | −23.37 | −23.39 | −23.47
25 | −24.23 | −24.44 | −24.43
26 | −25.33 | −25.44 | −25.49
27 | −26.24 | −26.29 | −26.44
28 | −27.29 | −27.44 | −27.38
29 | −28.22 | −28.40 | −28.44
30 | −29.19 | −29.33 | −29.36
31 | −30.26 | −30.38 | −30.47
32 | −31.32 | −31.36 | −31.52
33 | −32.35 | −32.32 | −32.40
34 | −33.22 | −33.30 | −33.26
35 | −34.18 | −34.35 | −34.21
36 | −35.26 | −35.40 | −35.37
37 | −36.19 | −36.23 | −36.46
38 | −37.18 | −37.32 | −37.27
39 | −37.99 | −38.19 | −38.29
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

Tone scale 0.5. Files: pluto_tx_calibration.csv and pluto_tx_calibration.json.

#### Test A at other frequencies

Frequency (MHz) | 0 dB | 2 dB | 4 dB | 6 dB | 8 dB | 10 dB | 15 dB | 20 dB | 30 dB | 40 dB
400 | 0.92 | −0.95 | −3.01 | −4.92 | −6.95 | −8.79 | −13.87 | −18.72 | −28.75 | −38.59
600 | 0.58 | −1.27 | −3.30 | −5.22 | −7.25 | −9.08 | −14.12 | −18.92 | −29.02 | −38.82
800 | 0.07 | −1.79 | −3.83 | −5.74 | −7.76 | −9.57 | −14.56 | −19.31 | −29.41 | −39.30
900 | 0.39 | −1.43 | −3.46 | −5.36 | −7.38 | −9.17 | −14.12 | −18.85 | −29.02 | −38.73
1050 | 0.23 | −1.62 | −3.67 | −5.57 | −7.59 | −9.38 | −14.33 | −19.02 | −29.15 | −38.65
1150 | −1.01 | −2.85 | −4.88 | −6.76 | −8.73 | −10.50 | −15.35 | −20.07 | −30.03 | −40.02
1400 | −1.71 | −3.55 | −5.55 | −7.43 | −9.39 | −11.14 | −15.97 | −20.59 | −30.53 | −40.71
1600 | −5.18 | −6.98 | −8.95 | −10.80 | −12.74 | −14.38 | −19.26 | −23.80 | −33.92 | −43.62
1800 | −3.33 | −5.18 | −7.19 | −9.02 | −10.94 | −12.68 | −17.50 | −22.15 | −32.02 | −41.94
2000 | −4.06 | −5.90 | −7.88 | −9.69 | −11.59 | −13.33 | −18.09 | −22.87 | −32.77 | −42.46

Output in dBm at each attenuation setting. Tone scale 0.5.

#### Test B: output against frequency

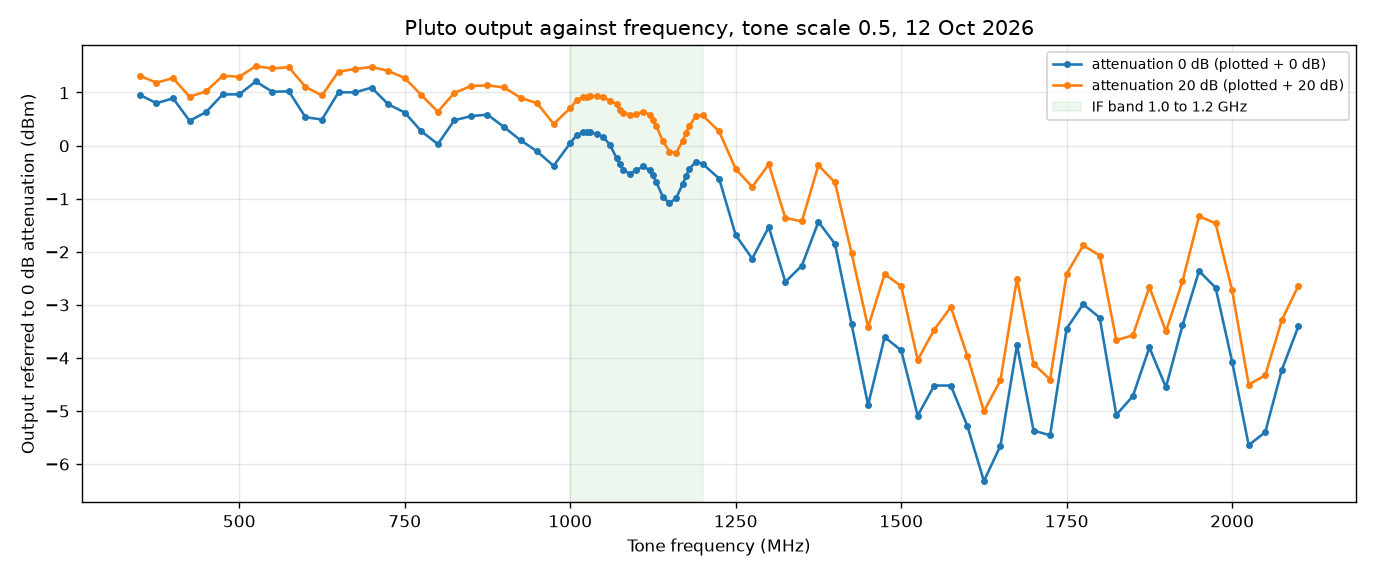
[picture p80: phase_detector_calibration/site/img/pluto_freq.png]
Pluto output against frequency from 350 to 2100 MHz


Attenuation 0 dB: −6.33 to 1.21 dBm over 350 to 2100 MHz (87 points). Inside 1000 to 1200 MHz: −1.09 to 0.26 dBm, a spread of 1.35 dB.

Attenuation 20 dB: −25.01 to −18.50 dBm over 350 to 2100 MHz (87 points). Inside 1000 to 1200 MHz: −20.14 to −19.06 dBm, a spread of 1.08 dB.

Frequency (MHz) | At 20 dB (dBm) | At 0 dB (dBm)
350 | −18.68 | 0.95
375 | −18.82 | 0.80
400 | −18.73 | 0.89
425 | −19.08 | 0.47
450 | −18.98 | 0.63
475 | −18.68 | 0.96
500 | −18.70 | 0.96
525 | −18.50 | 1.21
550 | −18.55 | 1.01
575 | −18.52 | 1.02
600 | −18.89 | 0.53
625 | −19.06 | 0.49
650 | −18.61 | 1.00
675 | −18.56 | 1.00
700 | −18.52 | 1.09
725 | −18.59 | 0.78
750 | −18.73 | 0.62
775 | −19.05 | 0.27
800 | −19.36 | 0.03
825 | −19.01 | 0.48
850 | −18.88 | 0.55
875 | −18.87 | 0.58
900 | −18.90 | 0.35
925 | −19.10 | 0.10
950 | −19.20 | −0.11
975 | −19.59 | −0.38
1000 | −19.30 | 0.05
1010 | −19.14 | 0.20
1020 | −19.09 | 0.25
1025 | −19.09 | 0.26
1030 | −19.06 | 0.26
1040 | −19.08 | 0.22
1050 | −19.08 | 0.16
1060 | −19.16 | 0.02
1070 | −19.22 | −0.24
1075 | −19.33 | −0.35
1080 | −19.38 | −0.46
1090 | −19.42 | −0.53
1100 | −19.41 | −0.47
1110 | −19.36 | −0.39
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

#### Test C: output against tone scale

Departure of the output from 20 log10 of the tone scale

Attenuation (dB) | Tone scale | Output (dBm) | Output minus ideal (dB)
20 | 0.05 | −39.20 | 0.23
20 | 0.1 | −33.48 | −0.07
20 | 0.2 | −27.38 | 0.01
20 | 0.3 | −23.83 | 0.04
20 | 0.4 | −21.39 | −0.01
20 | 0.5 | −19.43 | 0.00
20 | 0.6 | −17.85 | −0.01
20 | 0.7 | −16.52 | −0.01
20 | 0.8 | −15.31 | 0.04
20 | 0.9 | −14.24 | 0.08
20 | 1.0 | −13.29 | 0.12
0 | 0.05 | −20.22 | 0.24
0 | 0.1 | −14.23 | 0.21
0 | 0.2 | −8.22 | 0.20
0 | 0.3 | −4.76 | 0.14
0 | 0.4 | −2.32 | 0.08
0 | 0.5 | −0.46 | 0.00
0 | 0.6 | 1.02 | −0.10
0 | 0.7 | 2.25 | −0.21
0 | 0.8 | 3.26 | −0.36
0 | 0.9 | 4.08 | −0.56
0 | 1.0 | 4.74 | −0.82

\[ P_\text{ideal}(s) = P(0.5) + 20\log_{10}\!\left(\frac{s}{0.5}\right) \]

- At attenuation 20 dB the output follows the tone scale within 0.25 dB from 0.05 to 1.0.
- At attenuation 0 dB the output falls behind above scale 0.5: 0.8 dB low at scale 1.0. The output stage is compressing.
- The tone scale can be used as a fine level control when the attenuation is 20 dB or more.

#### Test D: frequency error

Set (MHz) | Error (Hz) | Error (ppm)
400 | −5227 | −13.07
700 | −9013 | −12.88
1000 | −12800 | −12.80
1100 | −14054 | −12.78
1200 | −15307 | −12.76
1500 | −19120 | −12.75
1800 | −22880 | −12.71
2000 | −25414 | −12.71

Read with a 20 kHz span. The tone is 12.7 to 13.1 ppm low at every frequency, inside the 25 ppm specification. The error includes the analyzer's own reference error; the two cannot be separated without a third reference. To put a tone exactly on a wanted frequency, set the Pluto 12.8 ppm higher: 14.1 kHz higher at 1100 MHz.

\[ f_\text{set} = f_\text{wanted}\,(1 + 12.8\times10^{-6}) \]

#### Test F: stability

- 40 readings over 139 s at 1100 MHz, attenuation 20 dB.
- Level: mean −19.37 dBm, spread 0.03 dB, standard deviation 0.007 dB.
- Frequency: mean error −13983 Hz, spread 186 Hz.

#### Test E: spectrum

Pluto output spectrum close to the tone and from 0 to 2.1 GHz

- At attenuation 0 dB no line stands out of the analyzer noise within 5 MHz of the tone. The LO leakage (1 MHz below) and the other sideband (2 MHz below) are both under −54 dB relative to the tone.
- At attenuation 20 dB the analyzer noise is only 36 dB under the tone with these settings, so that trace gives no better limit.
- From 30 MHz to 2.1 GHz at attenuation 0 dB, nothing else is above the noise, 45 dB under the tone.
- These are limits set by the analyzer settings (reference level +10 dBm, automatic bandwidth). The overnight run repeats this with a narrower bandwidth to find the actual levels.

Second harmonic of the 1000 MHz tone, read at 2000 MHz: −57.50 dBm at attenuation 20 dB; −49.08 dBm at attenuation 0 dB.

#### Test G: analyzer check and repeat

Analyzer reference level (dBm) | Reading of the same tone (dBm)
−10 | −19.44
0 | −19.48
10 | −19.42
20 | −19.50
10 | −19.42

Attenuation (dB), in the order read | Output (dBm)
40 | −39.23
20 | −19.43
0 | −0.47
20 | −19.46
40 | −39.37

#### Test H: tone off

Attenuation (dB) | Largest point, frequency (MHz) | Level (dBm)
0 | 1099.013 | −54.64
10 | 1098.973 | −52.63
31 | 1097.72 | −53.93

With the tone scale at 0 nothing is above the analyzer noise (about −54 dBm with these settings) at any attenuation. The frequencies in the table are noise peaks, not lines.

#### Files

Folder clinic\claude\pluto_characterization\: readings.csv (every reading, with time, settings, measured frequency and level), characterize_pluto.py (takes the readings), analyze_pluto.py (tables and plots), summary.json, pluto_tx_calibration.csv, spectrum_*.csv (traces, test E), run_log.txt.

#### Overnight run, 12 to 13 Oct

Started 21:44 on 12 Oct. Same wiring: Pluto TX straight into the spectrum analyzer. 11643 readings and 227 saved traces so far (last reading 2026-10-13 16:08:08). Script overnight.py, readings overnight_readings.csv, traces in traces\, analysis analyze_overnight.py, numbers overnight_summary.json.

#### Low level: output down to the 89.75 dB setting

Pluto output against attenuation setting from 0 to 89.75 dB at five frequencies

1. One analyzer setting cannot cover 0 to −90 dBm. Four were used: reference level +10 dBm; −10 dBm; −30 dBm with the preamp, 1 kHz bandwidth; the same with 100 Hz bandwidth.
2. Each setting was read at five attenuation settings shared with the one before. The average difference over those five is the correction that ties it to the one before.
3. The +10 dBm setting is used for 0 to 40 dB, the −10 dBm setting to 60 dB, the preamp settings above that.

\[ c_2 = \overline{P_1(A) - P_2(A)}\ \text{over the shared}\ A \qquad P(A) = P_2(A) + c_2 \]

Frequency (MHz) | Corrections between settings (dB) | Largest departure from 1 dB per dB, 20 to 89.75 dB (dB) | Output at 89.75 dB (dBm)
400 | −0.06, −0.15, −0.11 | 0.59 | −88.82
1000 | 0.01, 0.09, 0.11 | 0.57 | −89.39
1100 | −0.02, 0.29, 0.31 | 0.56 | −89.50
1200 | −0.09, 0.26, 0.26 | 0.52 | −89.45
2000 | −0.13, −0.42, −0.42 | 0.52 | −92.62

Analyzer noise at the lowest setting (preamp, 100 Hz bandwidth): about −119 dBm, 29 dB under the lowest Pluto level.

Setting (dB) | Output at 1100 MHz (dBm)
40 | −39.52
42.50 | −42.26
45 | −44.77
47.50 | −47.27
50 | −49.75
52.50 | −52.28
55 | −54.74
57.50 | −57.24
60 | −59.92
62.50 | −62.35
65 | −64.85
67.50 | −67.45
70 | −69.90
72.50 | −72.30
75 | −74.85
77.50 | −77.38
80 | −79.81
82.50 | −82.32
85 | −84.65
87.50 | −87.11
89.75 | −89.50

#### Fine steps: 0.25 dB attenuation steps, 0 to 12 dB

Size of each 0.25 dB attenuation step and difference between going up and going down

Frequency (MHz) | Mean step (dB) | Smallest (dB) | Largest (dB) | Standard deviation (dB) | Up minus down, largest (dB)
1000 | 0.244 | 0.098 | 0.415 | 0.058 | 0.020
1100 | 0.239 | 0.088 | 0.410 | 0.059 | 0.020
1200 | 0.240 | 0.092 | 0.411 | 0.059 | 0.010

- Each setting was read going down from 12 to 0 dB, then going up. Analyzer bandwidth 3 kHz, span 200 kHz.
- The steps are uneven: the same pattern appears at all three frequencies and in both directions, so it is the Pluto, not noise.
- Going up and going down agree within 0.02 dB. There is no memory of the direction.

#### Tone scale at five frequencies

Departure of the output from 20 log10 of the tone scale at five frequencies

Frequency (MHz) | Attenuation (dB) | Output at scale 1.0 (dBm) | Departure at scale 1.0 (dB) | Departure at scale 0.1 (dB) | Departure at scale 0.02 (dB)
400 | 20 | −12.62 | 0.11 | −0.05 | −0.02
1000 | 20 | −13.21 | 0.09 | −0.00 | 0.13
1100 | 20 | −13.32 | 0.10 | −0.12 | 0.06
1200 | 20 | −13.33 | 0.12 | 0.00 | −0.10
2000 | 20 | −16.63 | 0.10 | −0.10 | −0.17
400 | 0 | 6.65 | −0.24 | 0.08 | 0.00
1000 | 0 | 5.67 | −0.35 | 0.10 | 0.02
1100 | 0 | 4.71 | −0.82 | 0.22 | 0.12
1200 | 0 | 5.07 | −0.61 | 0.18 | 0.13
2000 | 0 | 1.51 | −0.46 | 0.16 | 0.15

Departure = measured level minus the level predicted from the scale 0.5 reading.

Spectrum near the 1100 MHz tone at tone scales 0.1, 0.5, 0.8 and 1.0

Attenuation (dB) | Tone scale | Tone (dBm) | 1 MHz below (LO) | 2 MHz below (other sideband) | 4 MHz below | 1 MHz above | 2 MHz above | Median of trace (noise)
0 | 0.02 | −28.40 | −30.5 | −32.8 | −33.0 | −35.1 | −32.7 | −37.8
0 | 0.05 | −20.36 | −38.1 | −42.4 | −39.4 | −40.4 | −40.3 | −45.6
0 | 0.1 | −14.34 | −43.6 | −48.7 | −48.1 | −49.0 | −45.1 | −52.1
0 | 0.15 | −10.84 | −48.2 | −51.2 | −51.6 | −52.4 | −50.5 | −55.2
0 | 0.2 | −8.35 | −48.8 | −52.2 | −50.2 | −52.6 | −52.5 | −57.6
0 | 0.3 | −4.87 | −53.5 | −55.3 | −51.7 | −55.3 | −58.2 | −60.9
0 | 0.4 | −2.45 | −57.1 | −58.2 | −48.9 | −58.0 | −56.4 | −63.2
0 | 0.5 | −0.57 | −59.9 | −61.4 | −45.8 | −59.7 | −59.8 | −65.3
0 | 0.6 | 0.92 | −60.4 | −63.5 | −42.7 | −60.0 | −62.2 | −66.7
0 | 0.7 | 2.13 | −62.6 | −64.6 | −39.1 | −62.5 | −64.2 | −67.6
0 | 0.8 | 3.15 | −62.4 | −63.8 | −36.2 | −63.0 | −62.9 | −68.7
0 | 0.9 | 3.96 | −61.6 | −61.9 | −33.0 | −65.8 | −64.2 | −69.4
0 | 0.95 | 4.31 | −63.5 | −61.0 | −31.7 | −64.4 | −65.2 | −69.3
0 | 1.0 | 4.62 | −63.3 | −66.8 | −30.7 | −64.6 | −62.2 | −70.1

- Levels in dB relative to the tone. Attenuation 0 dB, tone at 1100 MHz, bandwidth 30 kHz.
- The line 4 MHz below the tone grows as the scale goes up: 46 dB under at scale 0.5, 31 dB under at scale 1.0. It is three times the 1 MHz offset on the other side of the LO, which is what the third harmonic of the tone generator's 1 MHz signal produces.
- The other columns stay near the noise of this measurement. The tone offset test below measures the LO leakage and the other sideband with a narrower bandwidth.

#### Tone offset from the LO

Tone level against offset from the LO, and LO leakage and other sideband relative to the tone

Attenuation (dB) | Offset (MHz) | Tone (dBm) | Relative to 1 MHz offset (dB) | LO leakage (dB rel. tone) | Other sideband (dB rel. tone)
0 | −9.0 | −1.34 | −0.87 | −63.7 | −71.1
0 | −5.0 | −0.68 | −0.21 | −64.0 | −70.2
0 | −2.0 | −0.45 | 0.03 | −63.9 | −67.2
0 | −1.0 | −0.48 | −0.01 | −66.5 | −69.6
0 | −0.5 | −0.46 | 0.02 | −66.9 | −68.0
0 | 0.1 | −0.41 | 0.07 | −60.7 | −66.5
0 | 0.2 | −0.40 | 0.08 | −63.5 | −71.1
0 | 0.5 | −0.41 | 0.07 | −63.7 | −70.0
0 | 1.0 | −0.47 | 0.00 | −63.1 | −70.4
0 | 2.0 | −0.46 | 0.02 | −64.8 | −70.2
0 | 3.0 | −0.45 | 0.03 | −63.0 | −68.6
0 | 4.0 | −0.52 | −0.05 | −64.4 | −66.4
0 | 5.0 | −0.60 | −0.13 | −65.6 | −70.1
0 | 6.0 | −0.64 | −0.17 | −63.0 | −69.8
0 | 7.0 | −0.72 | −0.24 | −65.6 | −69.2
0 | 8.0 | −0.84 | −0.36 | −62.5 | −67.2
0 | 9.0 | −1.20 | −0.72 | −65.4 | −69.3
0 | 10.0 | −1.75 | −1.28 | −67.7 | −65.9
0 | 12.0 | −3.89 | −3.42 | −57.3 | −65.8
0 | 14.0 | −8.23 | −7.76 | −53.7 | −58.8

- LO fixed at 1100 MHz. The tone was moved from 0.1 to 14 MHz above it, and 0.5 to 9 MHz below it. Bandwidth 3 kHz.
- Sample rate 30.72 MS/s, RF bandwidth setting 18 MHz (9 MHz either side). The fall above 8 MHz is that filter.
- LO leakage and other sideband readings at 20 dB attenuation are at the analyzer noise and are not listed.

#### Two tones

Third-order products of two tones 1 MHz apart against attenuation setting

Frequency (MHz) | Scale of each tone | Attenuation (dB) | Each tone (dBm) | Larger third-order product (dB rel. one tone) | LO leakage (dB rel. one tone)
1100 | 0.1 | 0 | −14.25 | −60.0 | −44.1
1100 | 0.1 | 5 | −19.18 | −53.9 | −41.6
1100 | 0.1 | 10 | −23.84 | −48.7 | −36.8
1100 | 0.1 | 20 | −33.45 | −38.6 | −37.8
1100 | 0.25 | 0 | −6.44 | −44.1 | −57.4
1100 | 0.25 | 5 | −11.20 | −54.5 | −48.6
1100 | 0.25 | 10 | −15.94 | −52.4 | −43.4
1100 | 0.25 | 20 | −25.46 | −46.0 | −44.0
1100 | 0.4 | 0 | −2.61 | −35.3 | −55.5
1100 | 0.4 | 5 | −7.13 | −64.5 | −51.8
1100 | 0.4 | 10 | −11.88 | −58.1 | −47.7
1100 | 0.4 | 20 | −21.35 | −51.2 | −46.8
1100 | 0.5 | 0 | −0.98 | −29.6 | −49.6
1100 | 0.5 | 5 | −5.18 | −53.1 | −53.6
1100 | 0.5 | 10 | −9.92 | −54.1 | −49.1
1100 | 0.5 | 20 | −19.37 | −45.7 | −48.4

1. Tone 1 is 2 MHz above the LO, tone 2 is 3 MHz above. Both the same scale.
2. The third-order products fall at 2×2 − 3 = 1 MHz and 2×3 − 2 = 4 MHz above the LO. Each was read with a 1 kHz bandwidth.
3. Products under about −72 dBm are analyzer noise, so the rows at 20 dB attenuation are limits, not levels.

\[ f_\text{IM3} = 2f_1 - f_2 \quad\text{and}\quad 2f_2 - f_1 \]

At 0 dB attenuation the products grow fast with scale (60 dB under at scale 0.1, 30 dB under at scale 0.5). At 5 dB attenuation and scale 0.5 they are 53 dB under. The output stage is the cause.

#### Lines close to the tone, 350 to 2050 MHz

Lines within 4 MHz of the tone against tone frequency

Line | Median (dB rel. tone) | Largest (dB rel. tone) | At (MHz)
LO, 1 MHz below | −58.6 | −52.4 | 1650
other sideband, 2 MHz below | −58.9 | −50.9 | 400
4 MHz below | −46.8 | −42.3 | 1250
1 MHz above | −58.8 | −52.7 | 1600
2 MHz above | −57.9 | −53.0 | 1700
3 MHz below | −58.5 | −53.4 | 1500

Attenuation 0 dB, tone scale 0.5, bandwidth 30 kHz. All lines except “4 MHz below” are at the analyzer noise for this bandwidth, so they are limits. The 2100 MHz point is left out: it is at the edge of the analyzer's range.

#### Harmonics

Harmonics of the tone relative to the tone, against tone frequency

Tone (MHz) | Tone (dBm) | Line near 3 × LO (dBm) | Relative to the tone (dB)
350 | 0.90 | −8.84 | −9.7
400 | 0.83 | −9.44 | −10.3
450 | 0.59 | −11.61 | −12.2
500 | 0.92 | −12.61 | −13.5
550 | 0.95 | −14.86 | −15.8
600 | 0.48 | −12.10 | −12.6
650 | 0.95 | −11.48 | −12.4

- Attenuation 0 dB, tone scale 0.5. The line is at 3 × LO − 1 MHz (for a 400 MHz tone: 3 × 399 − 1 = 1196 MHz).
- It is 10 to 16 dB under the tone and does not change with the attenuation setting or the tone scale. The Pluto's mixer is driven by a square-wave LO, which has a third harmonic; the same is expected at every LO frequency.
- It can only be seen here for tones up to 700 MHz, because the analyzer stops at 2.1 GHz. For 1.0 to 1.2 GHz tones it falls at 3.0 to 3.6 GHz.

\[ f_\text{line} = 3 f_\text{LO} - f_\text{offset} = 3\,(f_\text{tone} - 1\ \text{MHz}) - 1\ \text{MHz} \]

Tone (MHz) | Tone scale | 2 × tone (dB rel. tone) | 3 × tone (dB rel. tone)
350 | 0.5 | −60.5 | −59.4
400 | 0.5 | −58.5 | −56.4
450 | 0.5 | −59.5 | −55.5
500 | 0.5 | −58.8 | −57.4
550 | 0.5 | −53.9 | −54.8
600 | 0.5 | −50.1 | −51.7
650 | 0.5 | −53.4 | −52.4
700 | 0.5 | −51.2 | —
750 | 0.5 | −51.6 | —
800 | 0.5 | −53.5 | —
850 | 0.5 | −54.0 | —
900 | 0.5 | −45.7 | —
950 | 0.5 | −56.5 | —
1000 | 0.5 | −48.6 | —
350 | 1.0 | −58.9 | −50.1
400 | 1.0 | −60.3 | −48.7
450 | 1.0 | −59.5 | −49.4
500 | 1.0 | −60.5 | −51.8
550 | 1.0 | −47.5 | −44.6
600 | 1.0 | −45.1 | −40.6
650 | 1.0 | −49.3 | −42.1
700 | 1.0 | −44.5 | —
750 | 1.0 | −45.9 | —
800 | 1.0 | −49.2 | —
850 | 1.0 | −48.2 | —
900 | 1.0 | −39.9 | —
950 | 1.0 | −42.2 | —
1000 | 1.0 | −43.4 | —

Attenuation 0 dB. A dash means the harmonic is above 2.1 GHz or under the analyzer noise.

Any earlier or later test that measures total power after the Pluto (a power meter, a detector, or an amplifier driven near compression) includes the line near 3 × LO. The LO buffer amp compression test of 12 Oct read the output at the tone frequency only, so its output powers are not affected, but the amp was also amplifying a 3.0 to 3.6 GHz signal about 10 to 16 dB smaller.

#### Wide search, 0 to 2.1 GHz

Spectrum from 0 to 2.1 GHz with the tone at five frequencies and with the tone off

Tone (MHz) | Tone (dBm) | Largest other line at (MHz) | Level (dBm) | Relative to the tone (dB)
400 | 0.85 | 1196 | −9.3 | −10.2
500 | 0.66 | 1495 | −12.7 | −13.4
600 | 0.44 | 1795 | −12.3 | −12.7
700 | 0.98 | 2097 | −12.8 | −13.8
800 | −0.24 | 1635 | −50.5 | −50.3
900 | 0.30 | 1801 | −45.2 | −45.5
1000 | −0.20 | 1999 | −49.9 | −49.7
1100 | −0.59 | 2094 | −50.5 | −49.9
1200 | −0.42 | 1638 | −50.4 | −50.0
1300 | −1.87 | 2010 | −50.6 | −48.7
1400 | −1.88 | 1700 | −50.1 | −48.2
1500 | −4.13 | 2100 | −50.1 | −46.0
1600 | −5.51 | 2047 | −48.6 | −43.1
1700 | −5.38 | 1809 | −49.9 | −44.5
1800 | −3.55 | 1711 | −49.5 | −45.9
1900 | −4.60 | 2089 | −50.6 | −46.0
2000 | −4.22 | 2083 | −50.0 | −45.8

Attenuation 0 dB, bandwidth 100 kHz. For tones of 400 to 700 MHz the largest other line is the one near 3 × LO. For tones of 800 MHz and above nothing is above the analyzer noise (about −50 dBm at this bandwidth) below 2.1 GHz; the frequencies listed for those rows are noise peaks.

#### Retune and attenuation repeatability

What was repeated | Readings | Mean (dBm) | Spread (dB) | Standard deviation (dB)
Tune to another frequency (400 to 1900 MHz, random), return to 1100 MHz, 20 dB | 30 | −19.462 | 0.034 | 0.009
Set 0 dB (after 20 dB) | 30 | −0.505 | 0.009 | 0.002
Set 40 dB (after 0 dB) | 30 | −39.545 | 0.269 | 0.068
Set 20 dB (after 40 dB) | 30 | −19.465 | 0.034 | 0.009

The larger spread at 40 dB is analyzer noise: the tone is 31 dB above the noise with this bandwidth (3 kHz) instead of 51 dB or more.

#### Settling

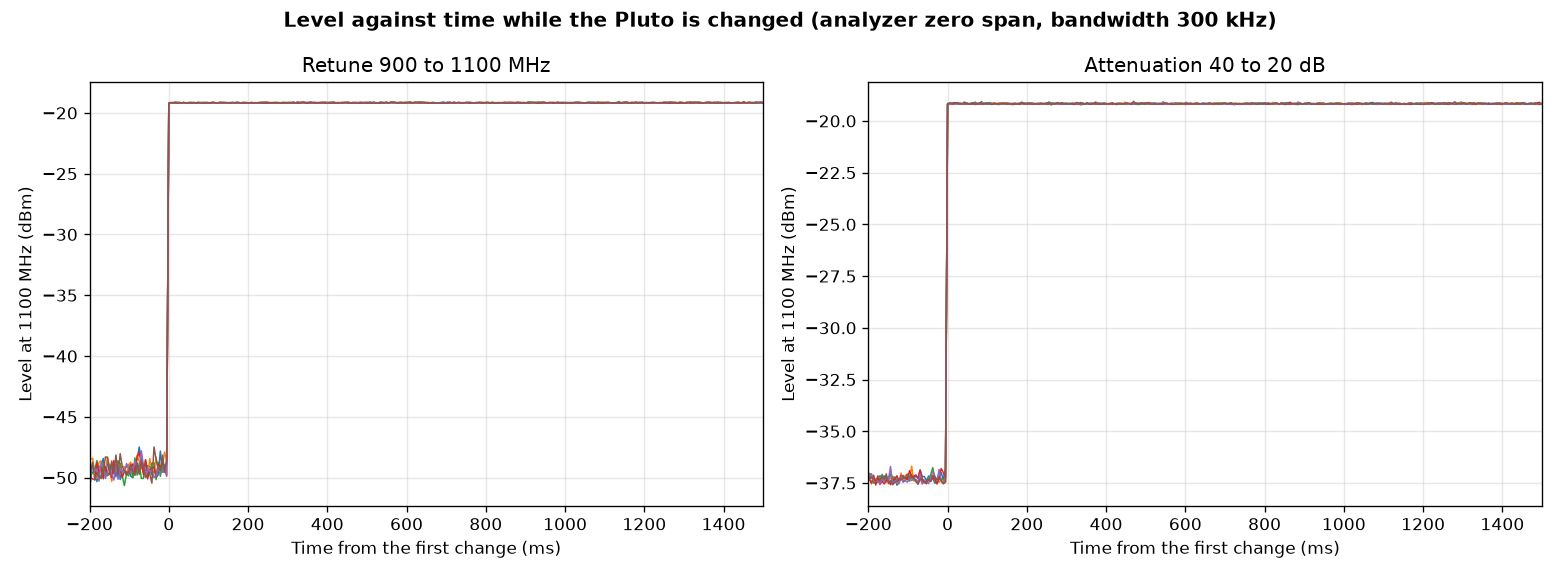
[picture p81: phase_detector_calibration/site/img/pluto_settling.png]
Level at 1100 MHz against time while the Pluto is retuned and while its attenuation is changed


- Analyzer at 1100 MHz with zero span: it records level against time, one point every 5.3 ms, bandwidth 300 kHz.
- Left: the Pluto was moved from 900 to 1100 MHz. Right: attenuation changed from 40 to 20 dB. Six repeats each.
- In every repeat the level is within 0.5 dB of its final value at the first point after the change. Settling takes less than one point.
- The delay between sending the command over USB and the change appearing was not measured.

#### Full map, tone scale 0.5

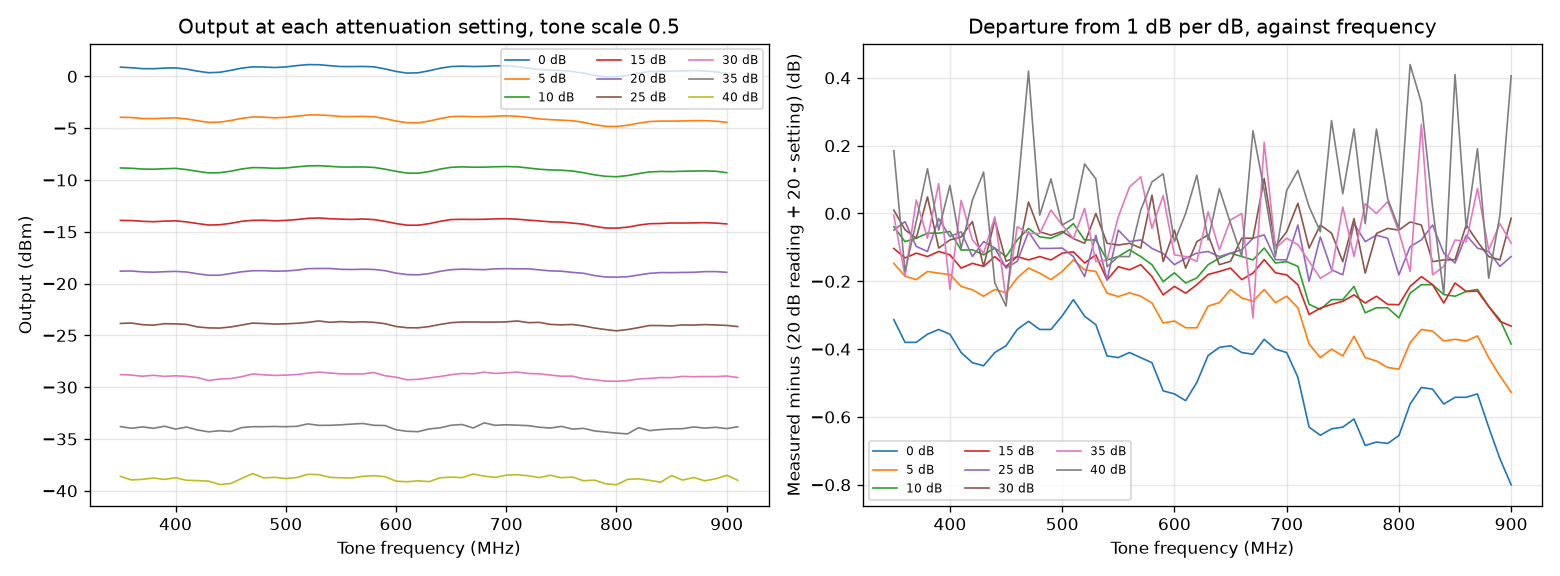
[picture p82: phase_detector_calibration/site/img/pluto_map.png]
Pluto output against frequency at each attenuation setting, tone scale 0.5


- 1575 readings at 175 frequencies (still running).
- At 0 dB attenuation: highest 1.14 dBm at 520 MHz, lowest −6.36 dBm at 1630 MHz.
- Inside 1000 to 1200 MHz at 0 dB: −1.16 to 0.20 dBm.
- Full table: pluto_map_table.csv.

#### Full map, tone scale 1.0

Pluto output against frequency at each attenuation setting, tone scale 1.0

- 210 readings at 70 frequencies (still running).
- At 0 dB attenuation: highest 7.01 dBm at 525 MHz, lowest −0.54 dBm at 1625 MHz.
- Inside 1000 to 1200 MHz at 0 dB: 4.27 to 5.79 dBm.
- Full table: pluto_map_scale1_table.csv.

#### IF band table: 1000 to 1200 MHz in 1 MHz steps

Pluto output across 1000 to 1200 MHz in 1 MHz steps, and departure from 1 dB per dB

- 201 frequencies × 21 attenuation settings (0 to 40 dB in 2 dB steps) = 4221 readings. Tone scale 0.5, bandwidth 3 kHz.
- At 0 dB: −1.14 dBm (lowest, at 1150 MHz) to 0.28 dBm (highest, at 1028 MHz).
- At 20 dB: −20.21 to −19.04 dBm.
- Departure from 1 dB per dB (relative to the 20 dB reading): −1.09 to −0.65 dB at 0 dB; −0.32 to 0.16 dB at 40 dB.
- Largest change between neighbouring 1 MHz points: 0.09 dB. A straight line between table points is good to under 0.1 dB.
- Full table: pluto_characterization\pluto_if_band_table.csv.

Frequency (MHz) | 0 dB | 4 dB | 10 dB | 20 dB | 30 dB | 40 dB
1000 | −0.03 | −3.95 | −9.66 | −19.37 | −29.44 | −39.44
1010 | 0.14 | −3.79 | −9.52 | −19.21 | −29.29 | −39.25
1020 | 0.18 | −3.74 | −9.46 | −19.12 | −29.19 | −39.34
1030 | 0.20 | −3.71 | −9.43 | −19.12 | −29.18 | −39.20
1040 | 0.17 | −3.75 | −9.48 | −19.13 | −29.20 | −39.40
1050 | 0.11 | −3.79 | −9.51 | −19.14 | −29.26 | −39.26
1060 | −0.04 | −3.89 | −9.60 | −19.20 | −29.29 | −39.37
1070 | −0.28 | −4.09 | −9.78 | −19.31 | −29.43 | −39.47
1080 | −0.51 | −4.30 | −9.97 | −19.44 | −29.53 | −39.54
1090 | −0.57 | −4.37 | −10.02 | −19.50 | −29.58 | −39.61
1100 | −0.52 | −4.35 | −10.00 | −19.46 | −29.55 | −39.49
1110 | −0.45 | −4.27 | −9.91 | −19.43 | −29.50 | −39.53
1120 | −0.51 | −4.34 | −9.98 | −19.48 | −29.56 | −39.57
1130 | −0.74 | −4.56 | −10.20 | −19.70 | −29.78 | −39.91
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

With the drift removed the tone follows requests of 50 Hz and more within about 10 Hz at 1000 MHz. The 1100 MHz set drifted faster and is less clear. The LO setting has a resolution of a few Hz; drift is the larger effect.

#### Spectrum close to the tone

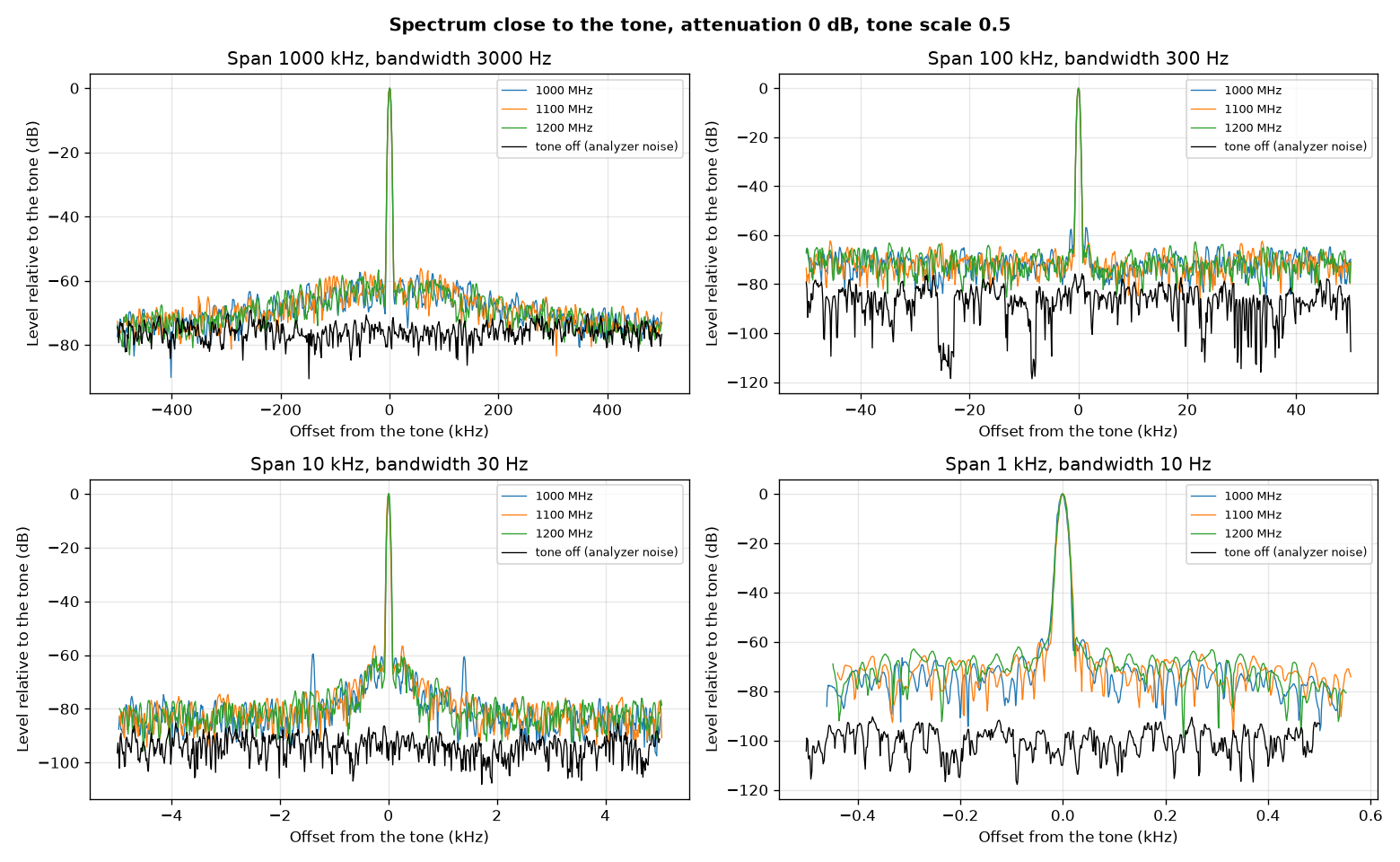
[picture p83: phase_detector_calibration/site/img/pluto_close_in.png]
Spectrum within 500 kHz, 50 kHz, 5 kHz and 500 Hz of the tone, with the analyzer's own noise


Tone (MHz) | Span (kHz) | Bandwidth (Hz) | Noise at 30 to 45% of the span from the tone (dB rel. tone) | Same, per Hz (dBc/Hz) | Largest point beyond 10% of the span (dB rel. tone)
1000 | 1000 | 3000 | −72.3 | −107.1 | −59.9
1100 | 1000 | 3000 | −72.5 | −107.3 | −58.4
1200 | 1000 | 3000 | −73.0 | −107.7 | −59.3
1000 | 100 | 300 | −70.4 | −95.1 | −64.6
1100 | 100 | 300 | −71.4 | −96.2 | −62.3
1200 | 100 | 300 | −71.1 | −95.9 | −62.7
1000 | 10 | 30 | −83.6 | −98.3 | −59.6
1100 | 10 | 30 | −83.0 | −97.8 | −71.6
1200 | 10 | 30 | −82.8 | −97.6 | −72.5
1000 | 1 | 10 | −75.4 | −85.4 | −66.5
1100 | 1 | 10 | −72.8 | −82.8 | −65.1
1200 | 1 | 10 | −73.2 | −83.2 | −63.0

\[ L(\Delta f) = P_\text{noise} - P_\text{tone} - 10\log_{10}(B) \]

\(B\) = analyzer bandwidth in Hz. The black trace is the analyzer with the tone off: its noise floor, but not its phase noise, which only appears when a signal is present. The Siglent's own phase noise is specified near −98 dBc/Hz at 10 kHz, so these numbers are an upper limit on the Pluto, not its true value.

#### Pulsed output, 13 Oct

Script sdr\pluto_pulse.py. The Pluto is sent a repeating block of samples: a constant value for the pulse, zeros between pulses. The RF is at the LO frequency during the pulse. Sample rate 30.72 MS/s, so the width is a whole number of 32.55 ns samples. Same wiring: Pluto TX straight into the spectrum analyzer. 1100 MHz.

#### Level during the pulse

Attenuation (dB) | Amplitude | Level during the pulse (dBm) | Continuous tone at the same setting (dBm)
0 | 0.25 | −5.58 | —
0 | 0.5 | 0.28 | 0.10
0 | 1.0 | 5.64 | 4.7 (12 Oct)
20 | 0.25 | −24.66 | —
20 | 0.5 | −18.71 | −18.93
20 | 1.0 | −12.56 | −13.3 (12 Oct)

- 500 µs pulse every 2 ms, read in zero span with a 300 kHz bandwidth.
- The pulse level matches the continuous tone within 0.2 dB where both were read in the same hour (amplitude 0.5). The amplitude 1.0 tone values are from the night before; that morning every level read 0.3 to 0.5 dB higher because of the RF connection (see below).
- Between pulses the reading is −54.6 to −55.7 dBm, which is the analyzer's noise in this bandwidth. The pulse is at least 55 dB above it. The LO leakage (about −60 dBm at 0 dB attenuation, from the continuous-tone tests) is still there between pulses, so the true on/off ratio at 0 dB attenuation is about 60 dB.

#### Pulse shape in time

Pulses of 100 to 1 microsecond at 1100 MHz seen in zero span

Asked width (µs) | Measured width between −6 dB points (µs) | Time between pulses (µs) | Peak reading (dBm) | Level between pulses (dBm)
100 | 98 | — | 0.31 | −52.3
20 | 18 | 400 | 0.31 | −52.3
10 | 9 | 200 | 0.19 | −51.9
5 | 4 | 200 | −1.88 | −52.2
2 | 2 | 200 | −11.33 | −52.2
1 | 2 | 200 | −19.84 | −52.4

- Analyzer zero span, 1 MHz bandwidth (its widest), video trigger. Its shortest sweep is 900 µs, which is one point every 1.2 µs.
- Pulses of 10 µs and longer are shown correctly: right width, right spacing (400 µs for the 20 µs pulse, 200 µs for the others), flat top at +0.2 to +0.3 dBm.
- Pulses of 5 µs and shorter read low (−1.9, −11.3, −19.8 dBm). That is the analyzer: one point every 1.2 µs and a 1 MHz filter cannot follow them. It is not the Pluto; see the spectrum below.
- This analyzer cannot show the shape of the 50 ns to 1.2 µs pulses the design uses. That needs a detector and the oscilloscope, or the SM200B.

#### Pulse spectrum

Spectrum of pulses from 2000 ns down to 32 ns

Asked width (ns) | Samples | Actual width (ns) | Peak in 100 kHz bandwidth (dBm) | Relative to a continuous tone (dB) | Departure from 20 log10(width) (dB) | First null, measured (MHz) | First null, expected 1/width (MHz)
5000 | 154 | 5013.0 | −4.75 | −4.78 | −0.78 | — | 0.20
2000 | 61 | 1985.7 | −12.00 | −12.03 | 0.01 | — | 0.50
1200 | 37 | 1204.4 | −16.59 | −16.62 | −0.24 | 0.85 | 0.83
1000 | 31 | 1009.1 | −17.89 | −17.92 | 0.00 | 1.01 | 0.99
500 | 15 | 488.3 | −24.16 | −24.19 | 0.03 | 2.05 | 2.05
300 | 9 | 293.0 | −28.61 | −28.65 | 0.02 | 3.44 | 3.41
200 | 6 | 195.3 | −31.85 | −31.89 | 0.30 | — | 5.12
130 | 4 | 130.2 | −34.81 | −34.84 | 0.87 | — | 7.68
100 | 3 | 97.7 | −37.12 | −37.15 | 1.05 | — | 10.24
65.0 | 2 | 65.1 | −40.22 | −40.25 | 1.48 | — | 15.36
32.5 | 1 | 32.6 | −43.43 | −43.47 | 4.27 | — | 30.67

1. One pulse every 100 µs, attenuation 0 dB, amplitude 0.5. Analyzer: 100 kHz bandwidth, positive-peak detector, 3 s sweep, so each point of the trace sees about 40 pulses and keeps the largest.
2. A first attempt with a normal fast sweep gave a ragged trace (each point either caught a pulse or missed it). Those traces are saved as pulse_spectrum_* and are not used.
3. The spectrum of a rectangular pulse of width τ has nulls at multiples of 1/τ from the centre. The null positions were found from the trace and compared with 1/τ.
4. In a bandwidth narrower than 1/τ the peak reading falls 20 dB for each tenfold drop in width. The departure column is the reading minus that rule, taking the 1000 ns pulse as the reference.

\[ \Delta f_\text{null} = \frac{1}{\tau} \qquad P_\text{peak}(\tau) = P_\text{peak}(\tau_0) + 20\log_{10}\!\left(\frac{\tau}{\tau_0}\right) \]

- The 5000 ns pulse is wider than the analyzer filter can treat as short, so the 20 log rule does not apply to it.
- From 2000 ns down to 300 ns the nulls are where 1/τ says and the peak follows the 20 log rule within 0.3 dB. The Pluto makes these pulses with the right width and full amplitude.
- For 200 ns the first null (5.1 MHz expected) can be seen in the plot near 5 MHz.
- Below about 130 ns the departure grows (+0.9 dB at 130 ns, +1.5 dB at 65 ns, +4.3 dB at one sample). The spectrum is cut off beyond about ±10 MHz: the Pluto's RF bandwidth setting is 18 MHz. A pulse shorter than about 100 ns comes out wider and lower than asked.
- To make the 50 ns pulses the design calls for, the Pluto's sample rate and RF bandwidth would have to be raised. That has not been tried and would need its own check.
- After each pulse test the normal tone generator was switched back on and read: −18.82 and −18.99 dBm at 20 dB, as before.

#### Warm-up and repeatability, 13 Oct

The Pluto was replugged at 10:59 on 13 Oct after 11 hours unpowered. The drift log ran from 11:02 to 13:03: level and frequency at 1100 MHz, 20 dB, every 23 s, with the level table and frequency sweep repeated at 11:00, 11:04 and 12:06.

Time | Level at 1100 MHz, 20 dB (dBm) | Frequency error (ppm) | Chip temperature (°C)
11:02 | −18.89 | −10.24 | 27.2
11:22 | −19.03 | −11.95 | 30.7
11:30 | −19.00 | −12.1 | 31.6
11:31:32 | step to −19.32, then −19.48 | no change | 31.6
11:54 | −19.46 | −12.38 | 32.5
12:27 | −19.46 | −12.51 | 32.5
13:00 | −19.44 | −12.57 | 31.6

- Warm-up, 11:02 to 11:30: level fell 0.11 dB; frequency error moved from −10.2 to −12.1 ppm.
- 11:31:32: the computer was moved. The level dropped 0.45 dB between two readings 23 s apart and stayed there. The frequency did not change. The spectrum analyzer reported one USB error 23 s later and carried on.
- After the step, 220 readings over 90 minutes: −19.49 to −19.43 dBm, standard deviation 0.011 dB.

#### The same table on three occasions

Setting | 12 Oct 23:44 (dBm) | 13 Oct 11:04, before the move (dBm) | 13 Oct 12:06, after the move (dBm)
1000 MHz, 0 dB | −0.01 | 0.29 | 0.01
1100 MHz, 0 dB | −0.51 | −0.01 | −0.50
1200 MHz, 0 dB | −0.38 | −0.02 | −0.40
1100 MHz, 20 dB | −19.47 | −19.00 | −19.47
1100 MHz, 40 dB | −39.54 | −39.05 | −39.52
1250 MHz, 20 dB | −20.51 | −19.61 | −20.46
1450 MHz, 20 dB | −23.51 | −21.36 | −22.95
1600 MHz, 20 dB | −23.77 | −20.30 | −22.62
1700 MHz, 20 dB | −23.92 | −22.56 | −23.77
2000 MHz, 20 dB | −22.79 | −22.75 | −22.80

- Before the move, 13 Oct read higher than 12 Oct at every frequency: by 0.04 to 3.5 dB, most between 1250 and 1750 MHz.
- After the move, 13 Oct matches 12 Oct within 0.06 dB up to 1400 MHz and within 1.1 dB from 1450 to 1650 MHz.
- A change that follows a mechanical disturbance, differs with frequency, and leaves the Pluto's frequency untouched is the RF path: the cable or an SMA connection between the Pluto and the analyzer.
- So the level tables describe the Pluto plus that cable in the state it was in on the night of 12 Oct. Inside 1000 to 1200 MHz a different state moved them by 0.3 to 0.5 dB.
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
