Sorin-Jayaweera/Panthalassa-Clinic-Team/phase_detector_calibration/site/parts/testplan.html

This file is one piece of the JACON notes. Open the full site to see it with the other tabs.

## Test plan

Every test still to run, grouped by part of the JACON. Each one says how to wire it, who does what, and what comes out. Mark them validated as they get done.

Before any of it: read the maximum input power printed on the Signal Hound SM200B and never exceed it. Put a fixed attenuator in front of it whenever an amplifier is in the path. Use a DC block if the part under test can put DC on its output. Never cable the Furuno radar to anything: it is 2.2 kW peak. Radar tests are over the air only.

### What I can control from the computer

Gear | How it connects | What I can do | Status
Signal Hound SM200B | USB 3.0, with Signal Hound’s Spike software and SM API installed | sweeps to 20 GHz, peak and channel power, capture pulses (160 MHz wide) | not set up yet. Needs the install, and your OK for it
Siglent SSA3021X | USB | sweeps to 2.1 GHz, peak frequency and power | working
Siglent SDS1104X-E | USB | DC levels, waveforms to 100 MHz, stacked edges | working
Syscomp CGR-201 | USB (COM12) | DC to 3.52 V, square waves to a few MHz | working
ADALM-Pluto | USB | a tone or a pulse at 1.0 to 1.2 GHz, level stepped | not driven by me yet. You have GNU Radio flowgraphs
ADF5355 PLL | depends on the board | set the LO frequency | unknown. Tell me the board
Bench supplies | by hand | nothing. You set them and tell me | manual

Open question, blocks the RX tests: what makes the 9.3 to 9.5 GHz test signal? Three choices. One: the ADF5355 set to 9.4 GHz, if there is a second one or we borrow the LO for a while. Two: Pluto at 1.0 to 1.2 GHz into the TX mixer with the 8.3 GHz LO, which is the TX chain doing its real job. Three: the Furuno radar over the air. I recommend two, because it sweeps and I can control it.

## RX chain

Antenna, limiter, LNA, mixer, IF amp, splitter. Test each part alone first, then stack them one at a time.

#### RX-0. The source and the cables

do this first

Wire: 9.4 GHz source → cable → SM200B. Then swap in each cable you plan to use, one at a time.

You: connect, tell me which cable is in.

I: sweep 9.3 to 9.5 GHz, read level and frequency.

You get: source power and frequency across the band, its spurs, and the loss of every cable at 9.4 GHz. Everything later is subtracted from this.

#### RX-1. Horn antennas

8.2–12.4 GHz horns

Wire: source → horn A, facing horn B → SM200B. Measure the gap. At least 1 m, more is better.

You: set the gap, then turn one horn 90° when I ask.

I: sweep and read received power both ways round.

You get: gain of the horns in dBi across the band (drawing says 10 to 15), and how much a crossed polarization costs.

\[ G_\text{dBi} = \tfrac{1}{2}\left( P_r - P_t + 20\log_{10}\frac{4\pi d f}{c} \right) \]

#### RX-2. Power limiter

whichever limiter is picked

Wire: source → limiter → SM200B.

You: add or remove attenuators to step the input power.

I: read output at each step.

You get: its small-signal loss at 9.3 to 9.5 GHz, and the level where it starts clamping. Pass if the output never tops +15 dBm, the LNA’s limit. We may not have enough power to reach clamping; I will say so if not.
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
