Sorin-Jayaweera/Panthalassa-Clinic-Team/docs/img/comp_vco_tuning.png

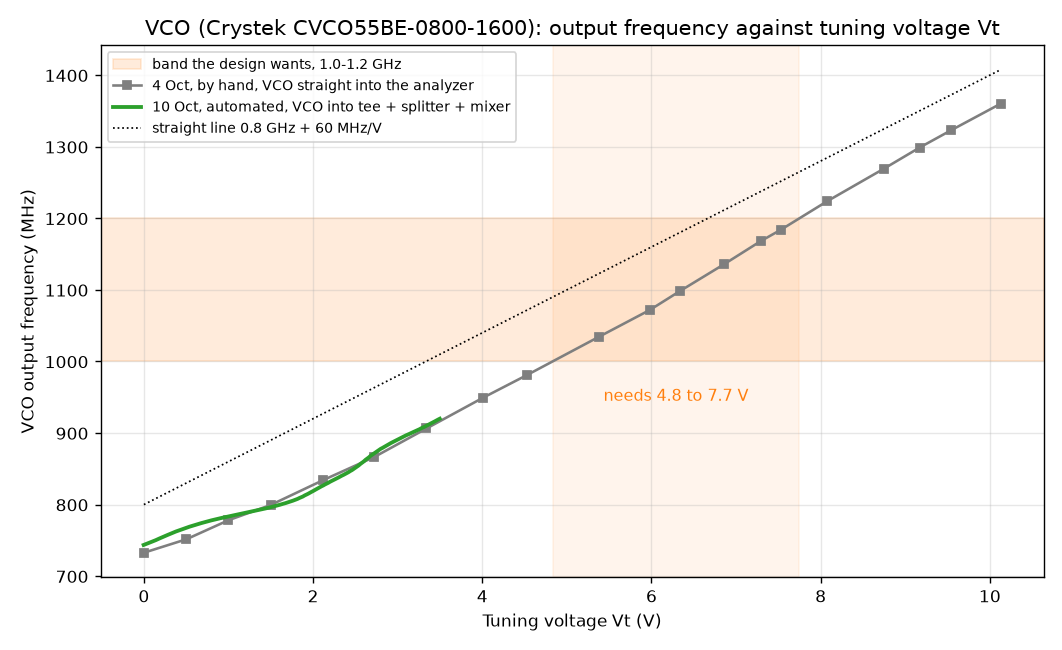
docs/img/comp_vco_tuning.png
