Sorin-Jayaweera/Panthalassa-Clinic-Team/docs/img/spike_test25b_leak_floor_50ohm_load_29dB_11p5m.png

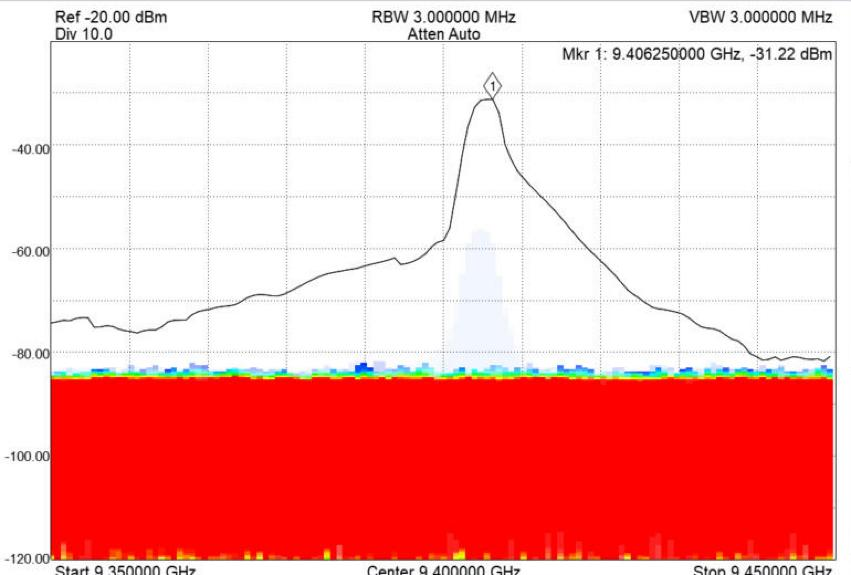
docs/img/spike_test25b_leak_floor_50ohm_load_29dB_11p5m.png
