Sorin-Jayaweera/Panthalassa-Clinic-Team/docs/img/spike_test28_vivaldi_limiter_20dB_LNA_off_19dB_11p5m.png

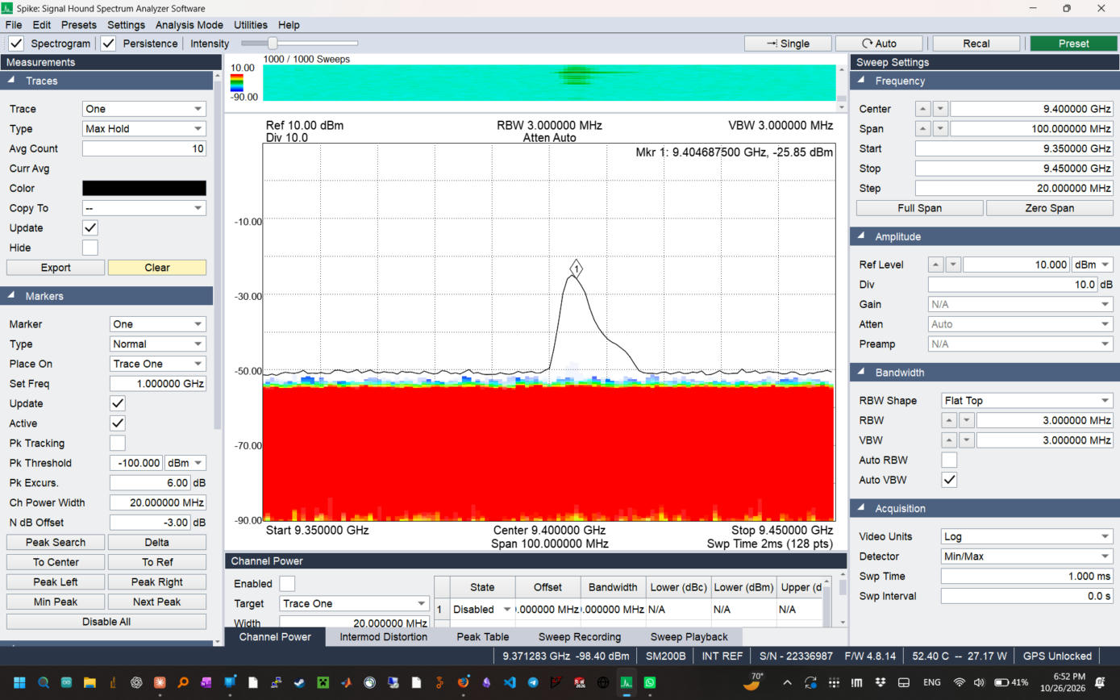
docs/img/spike_test28_vivaldi_limiter_20dB_LNA_off_19dB_11p5m.png
