Sorin-Jayaweera/Panthalassa-Clinic-Team/docs/img/spike_test29_vivaldi_limiter_20dB_LNA_19dB_31oct.png

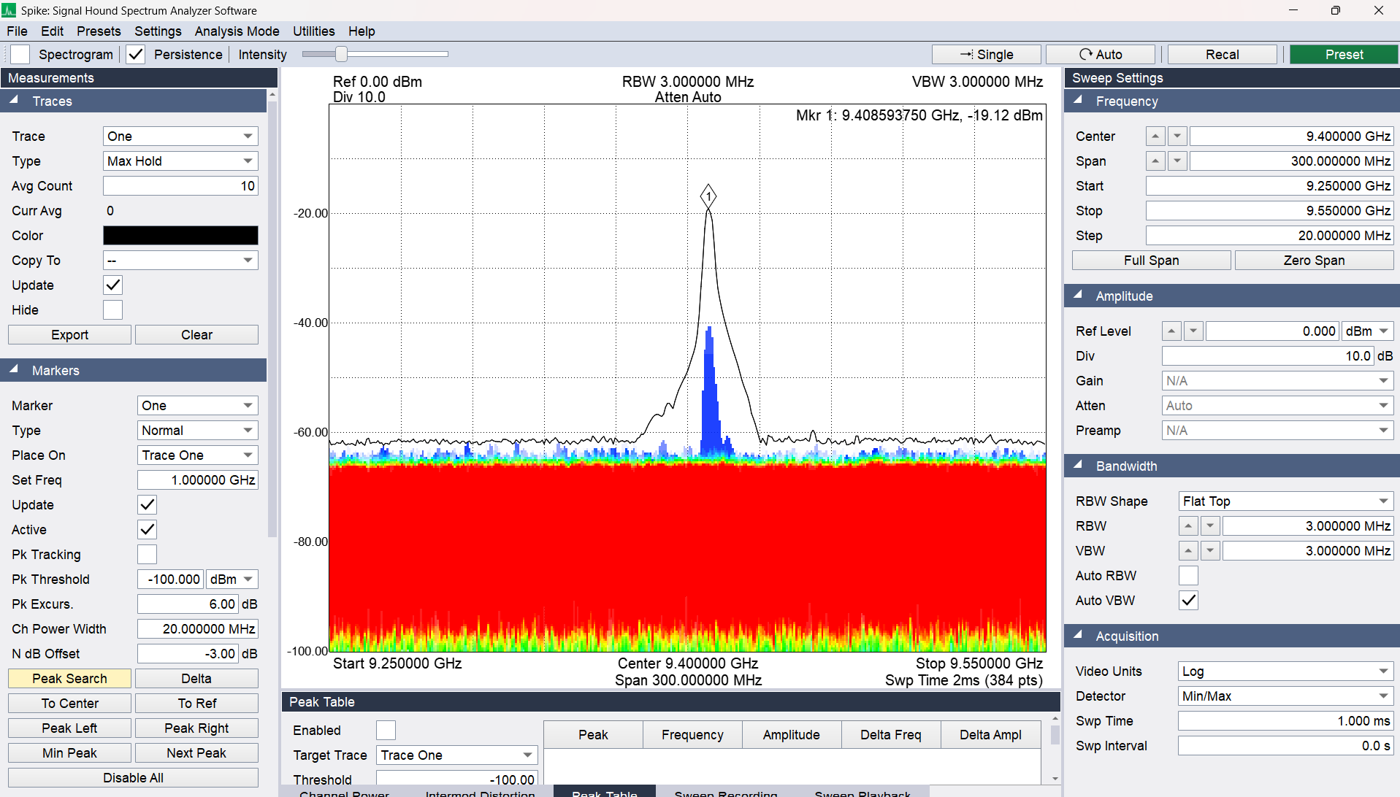
docs/img/spike_test29_vivaldi_limiter_20dB_LNA_19dB_31oct.png
