Sorin-Jayaweera/Panthalassa-Clinic-Team/docs/img/spike_test30_limiter_20dB_LNA_on_29dB_31oct.png

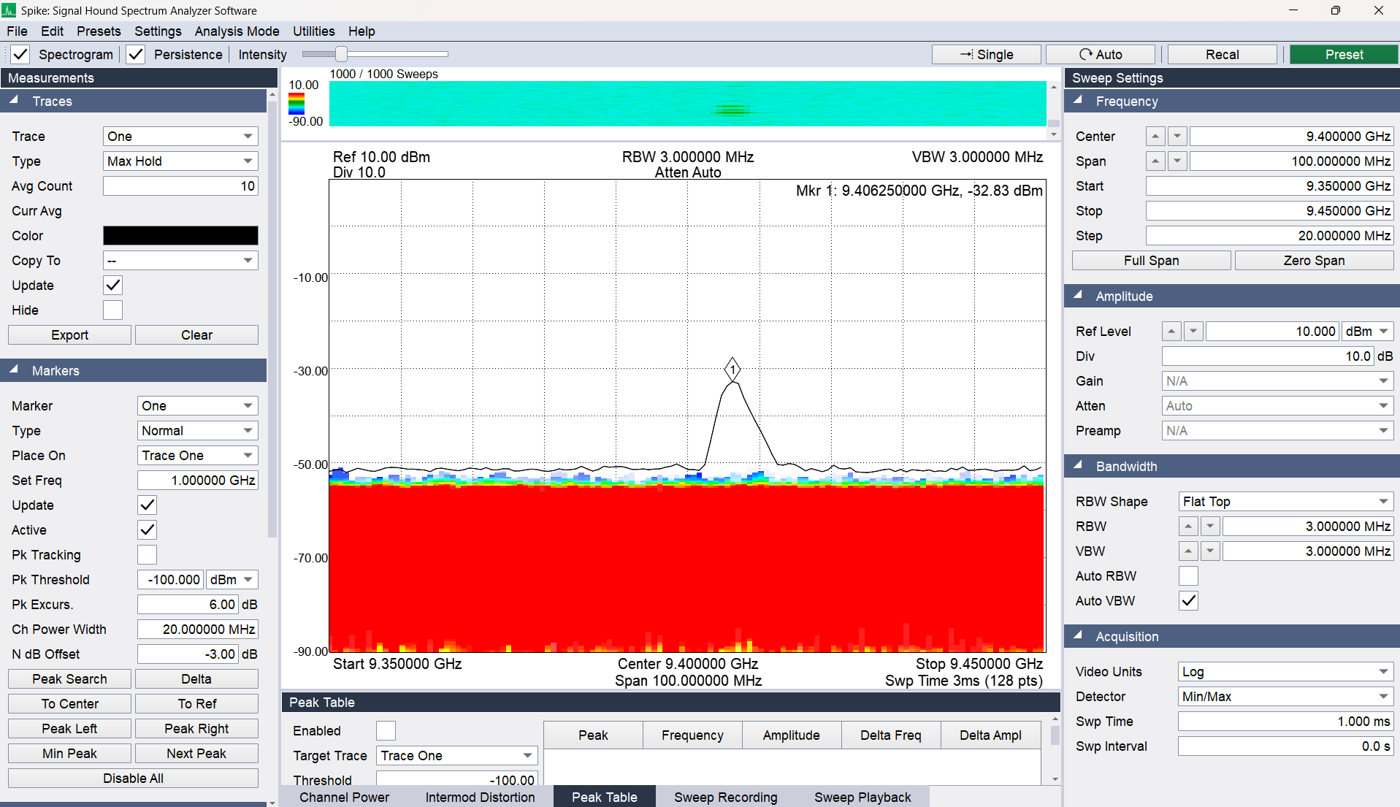
docs/img/spike_test30_limiter_20dB_LNA_on_29dB_31oct.png
