Sorin-Jayaweera/Panthalassa-Clinic-Team/docs/img/spike_test32_load_on_limiter_100kHz_31oct.png

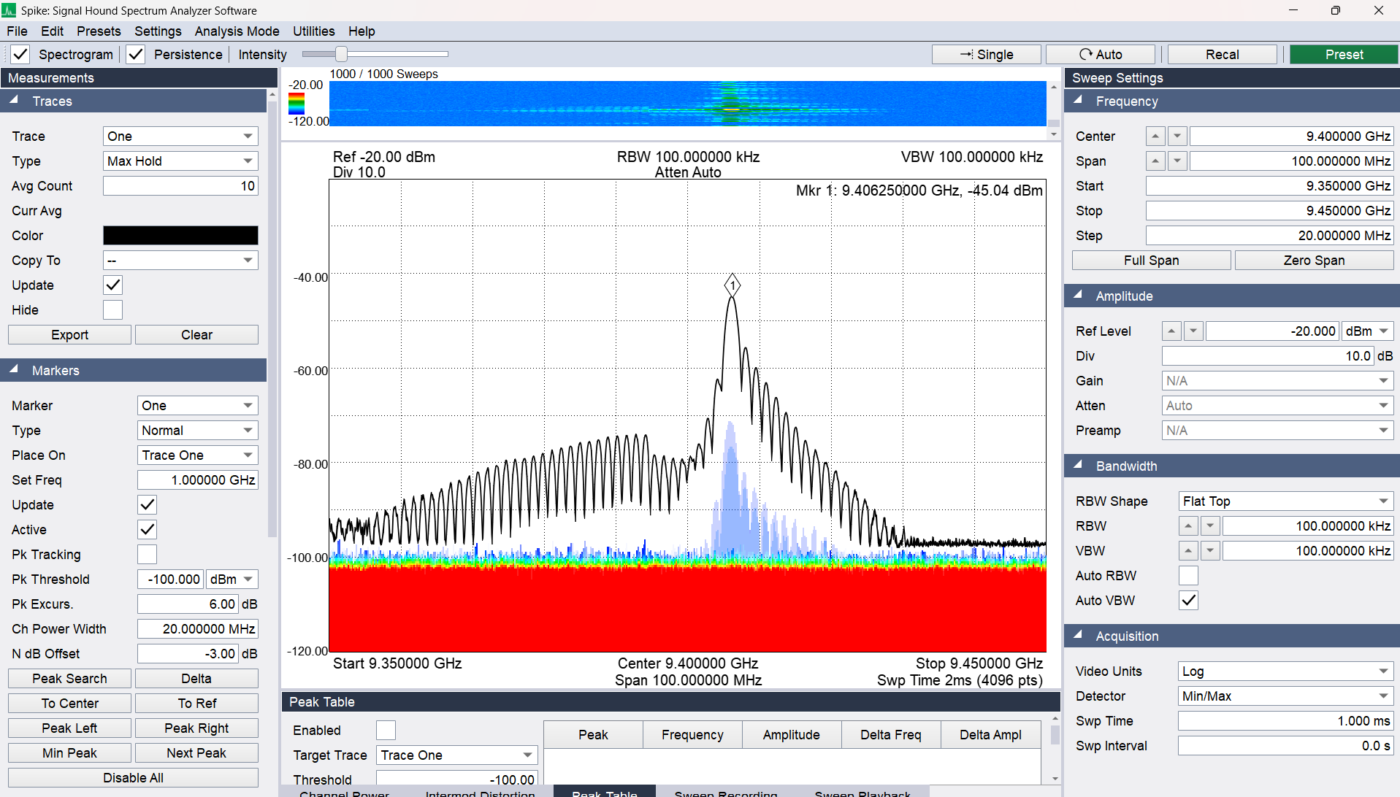
docs/img/spike_test32_load_on_limiter_100kHz_31oct.png
