Sorin-Jayaweera/Panthalassa-Clinic-Team/docs/img/spike_test36b_mixer_IF_3MHz_31oct.png

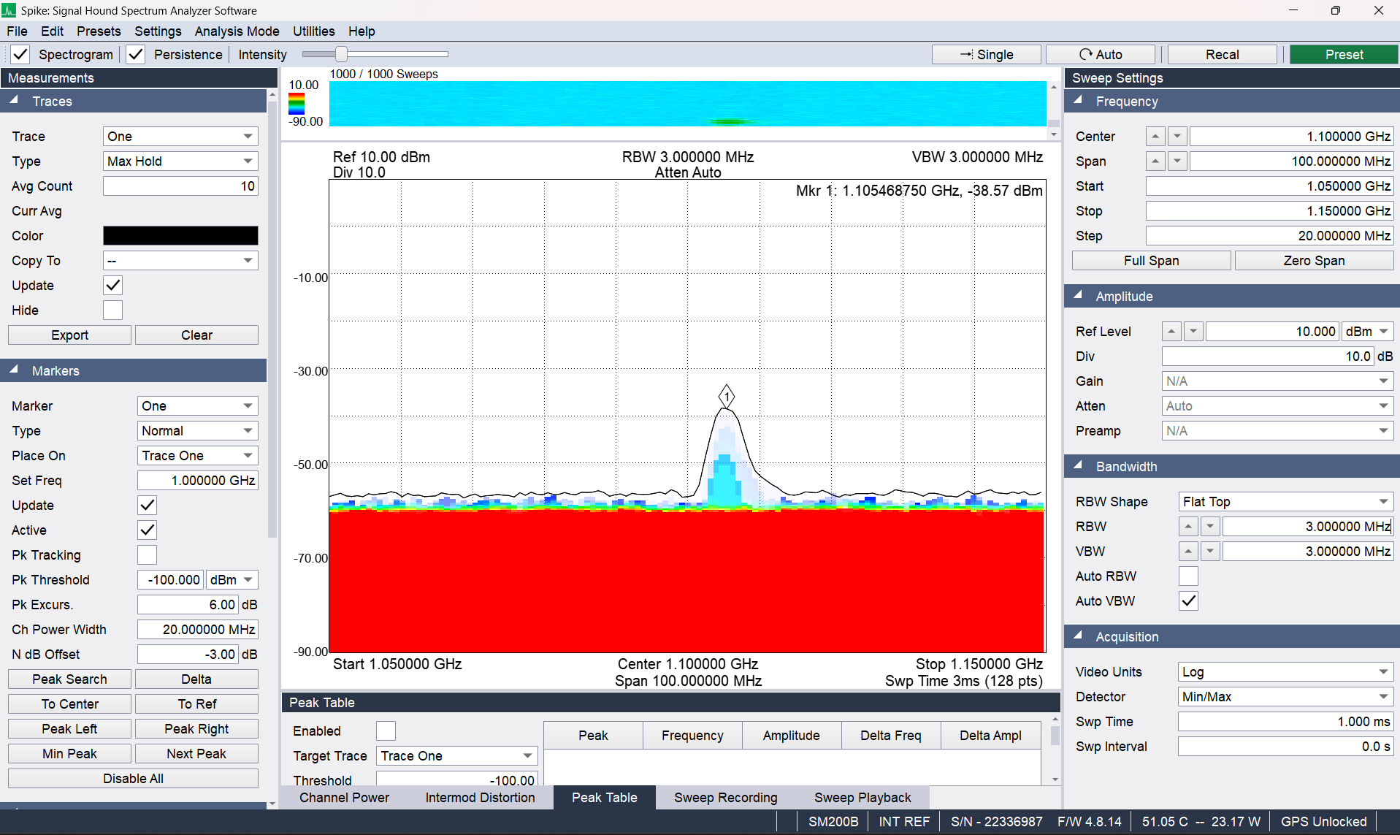
docs/img/spike_test36b_mixer_IF_3MHz_31oct.png
