Sorin-Jayaweera/Panthalassa-Clinic-Team/docs/img/spike_test43_detector_output_1p1GHz_1nov.png

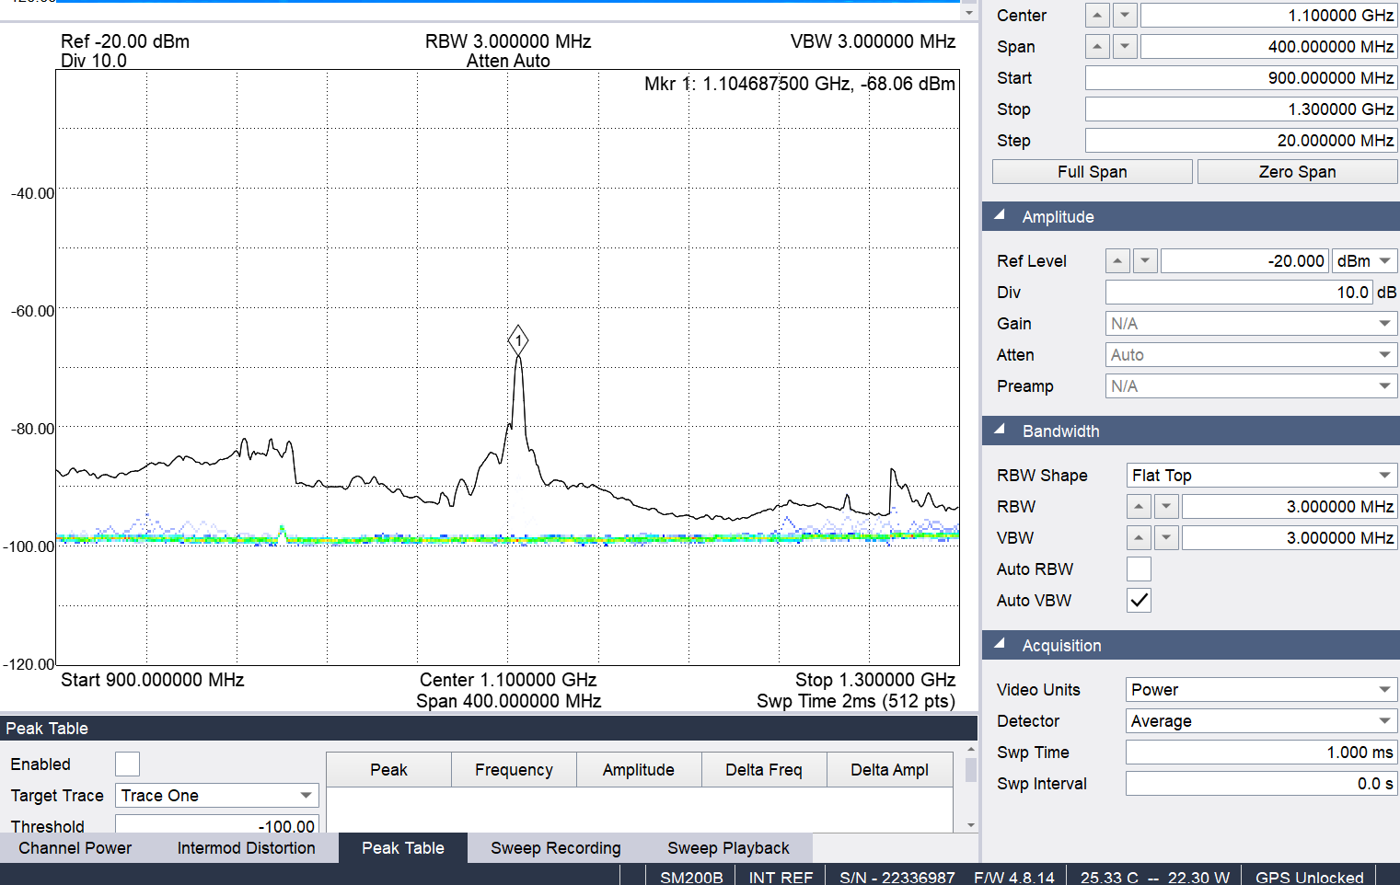
docs/img/spike_test43_detector_output_1p1GHz_1nov.png
