Sorin-Jayaweera/Panthalassa-Clinic-Team/measurements/vco/VCO_absolute_accuracy.png

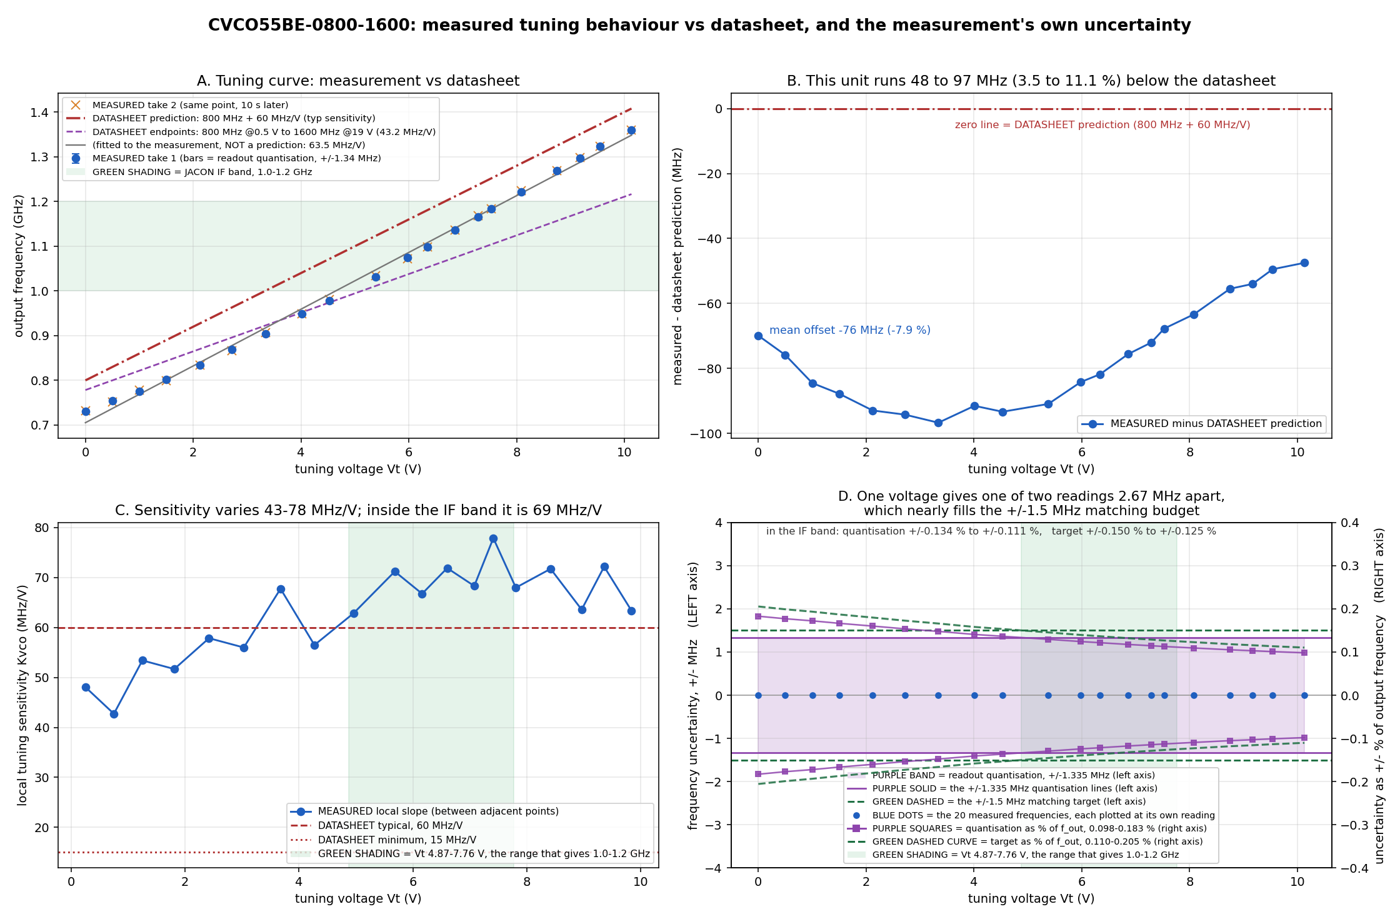
measurements/vco/VCO_absolute_accuracy.png
