Sorin-Jayaweera/Panthalassa-Clinic-Team/measurements/vco/VCO_tuning_and_uncertainty.png

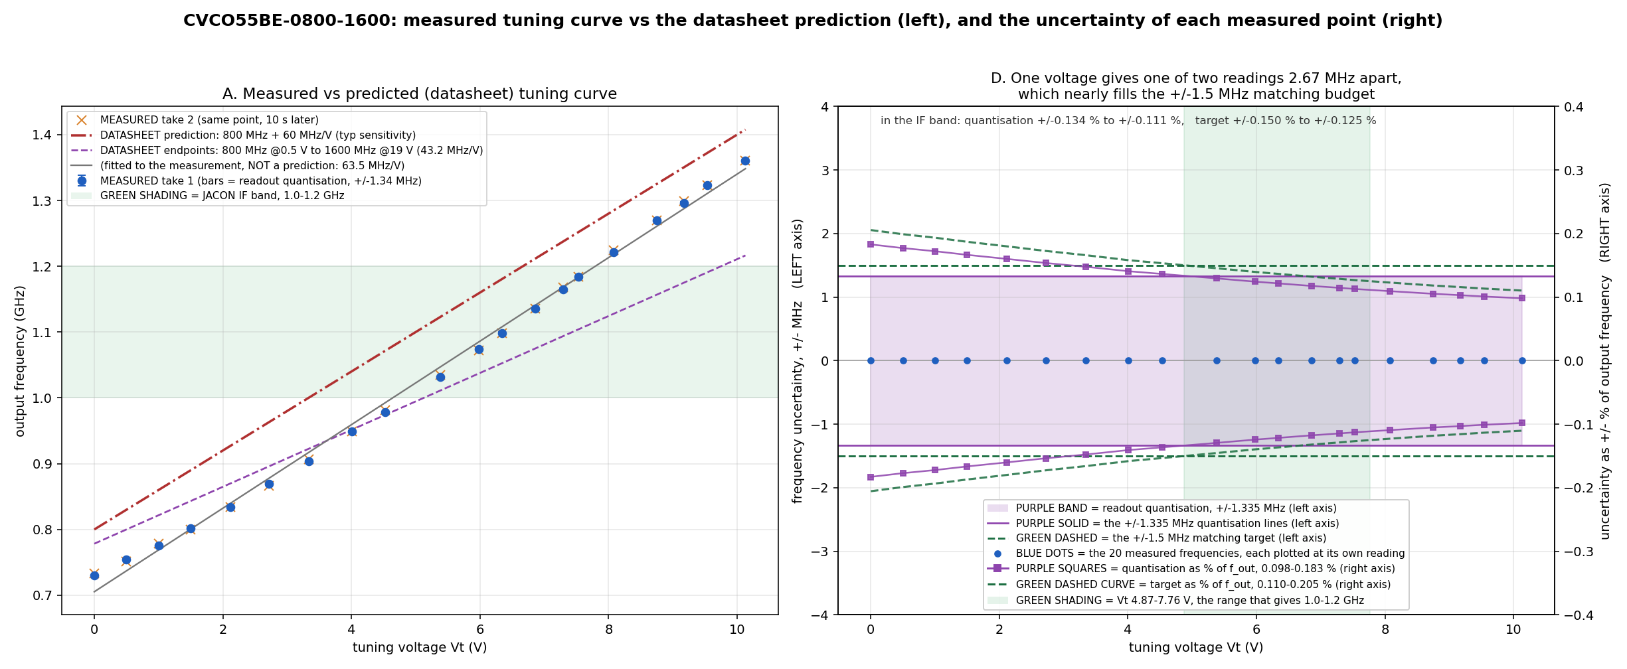
measurements/vco/VCO_tuning_and_uncertainty.png
