Sorin-Jayaweera/Panthalassa-Clinic-Team/phase_detector_calibration/BAD_furuno_detector_1nov_pll_off/first_screen.png

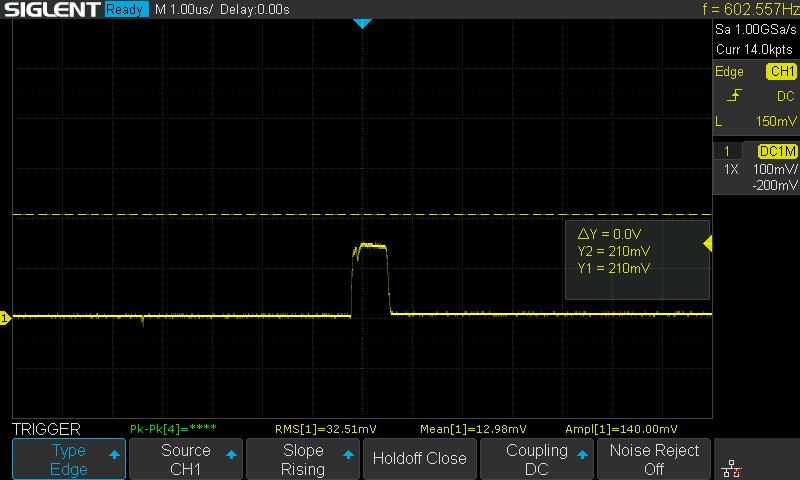
phase_detector_calibration/BAD_furuno_detector_1nov_pll_off/first_screen.png
