Sorin-Jayaweera/Panthalassa-Clinic-Team/phase_detector_calibration/furuno_detector_1nov_pll_on/first_screen.png

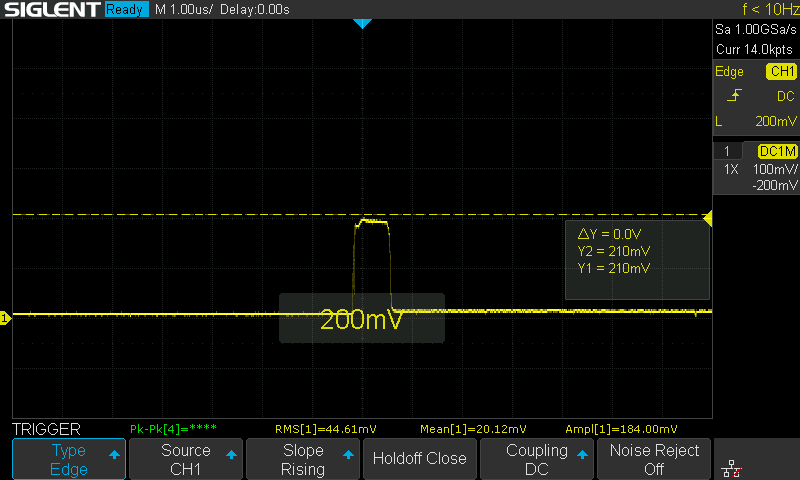
phase_detector_calibration/furuno_detector_1nov_pll_on/first_screen.png
