Sorin-Jayaweera/Panthalassa-Clinic-Team/phase_detector_calibration/furuno_detector_1nov_pll_on/ssa_0p1_to_50MHz_screen.png

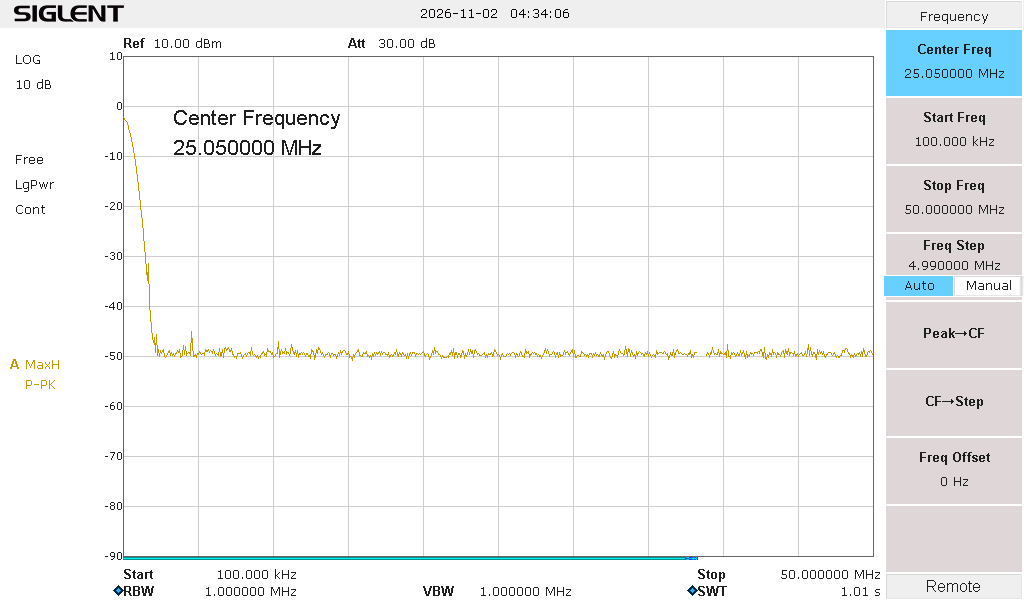
phase_detector_calibration/furuno_detector_1nov_pll_on/ssa_0p1_to_50MHz_screen.png
