Sorin-Jayaweera/Panthalassa-Clinic-Team/phase_detector_calibration/furuno_detector_1nov_time_freq.png

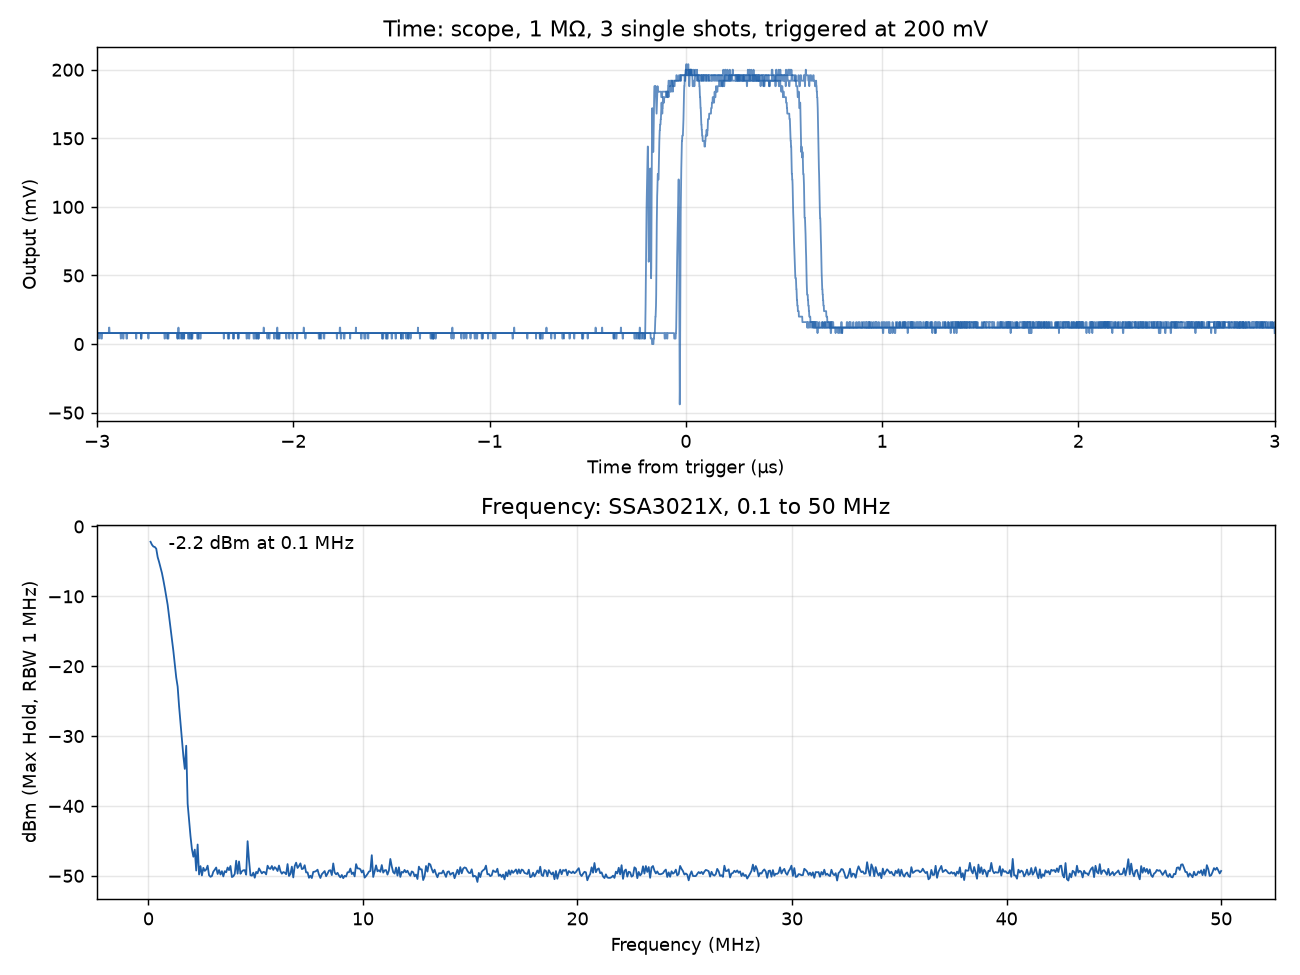
phase_detector_calibration/furuno_detector_1nov_time_freq.png
