Sorin-Jayaweera/Panthalassa-Clinic-Team/phase_detector_calibration/GOOD_power_repeatability.png

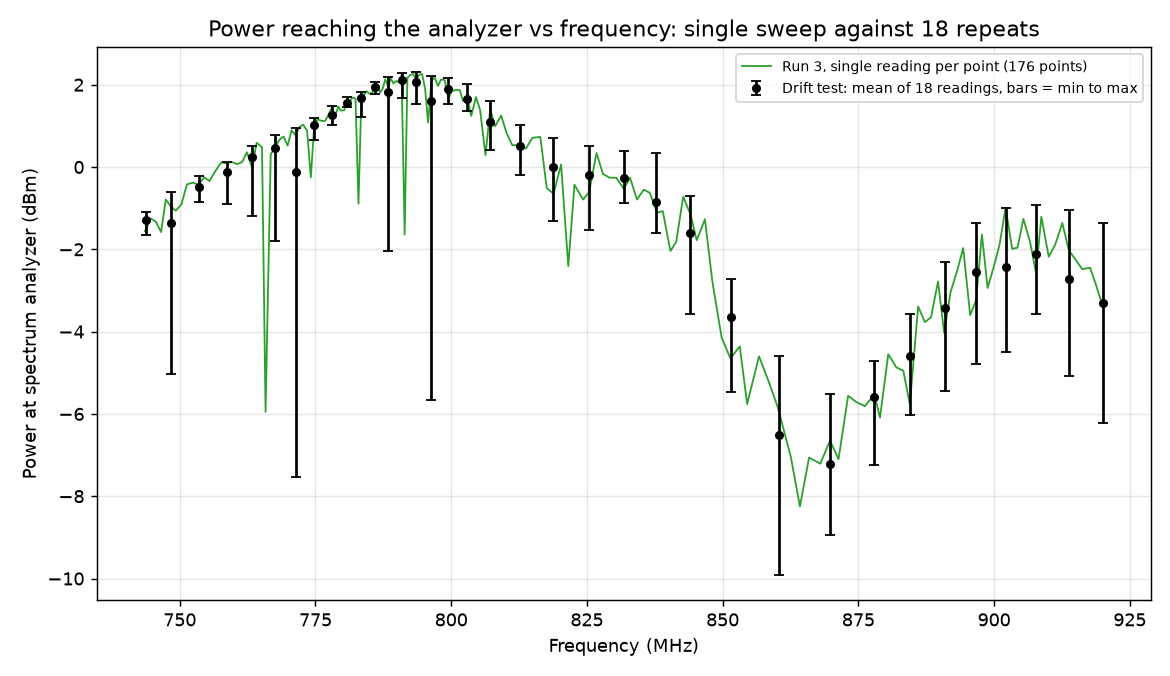
phase_detector_calibration/GOOD_power_repeatability.png
