Sorin-Jayaweera/Panthalassa-Clinic-Team/phase_detector_calibration/GOOD_vco_frequency_vs_voltage.png

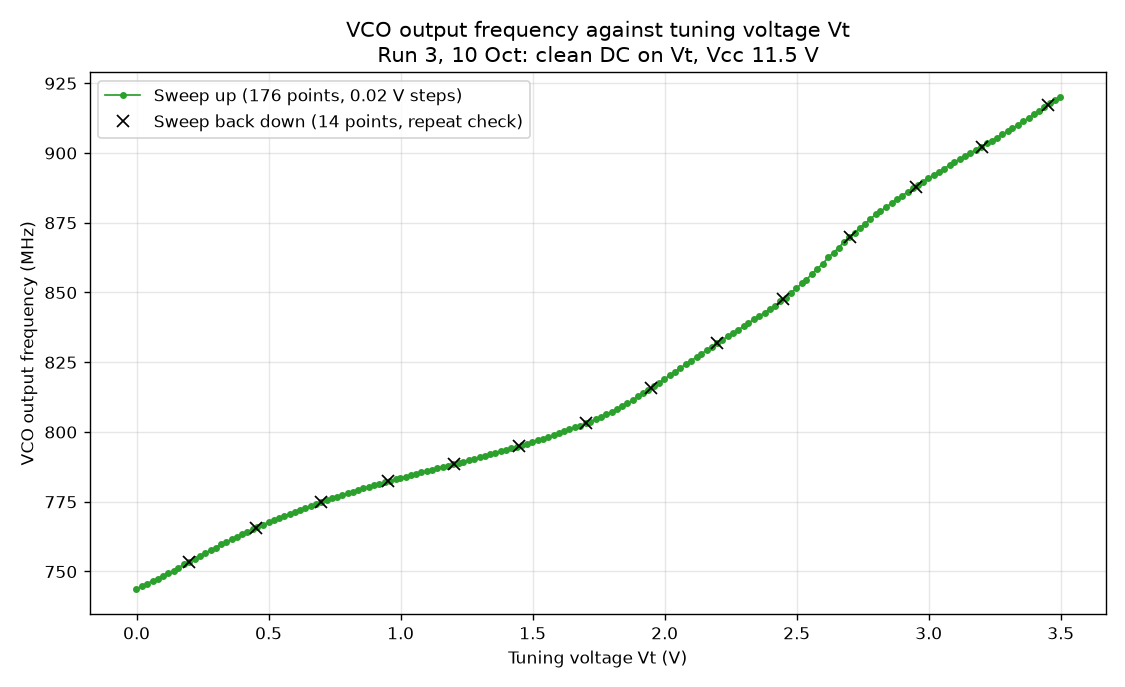
phase_detector_calibration/GOOD_vco_frequency_vs_voltage.png
