Sorin-Jayaweera/Panthalassa-Clinic-Team/phase_detector_calibration/mixer_voltage_vs_frequency.png

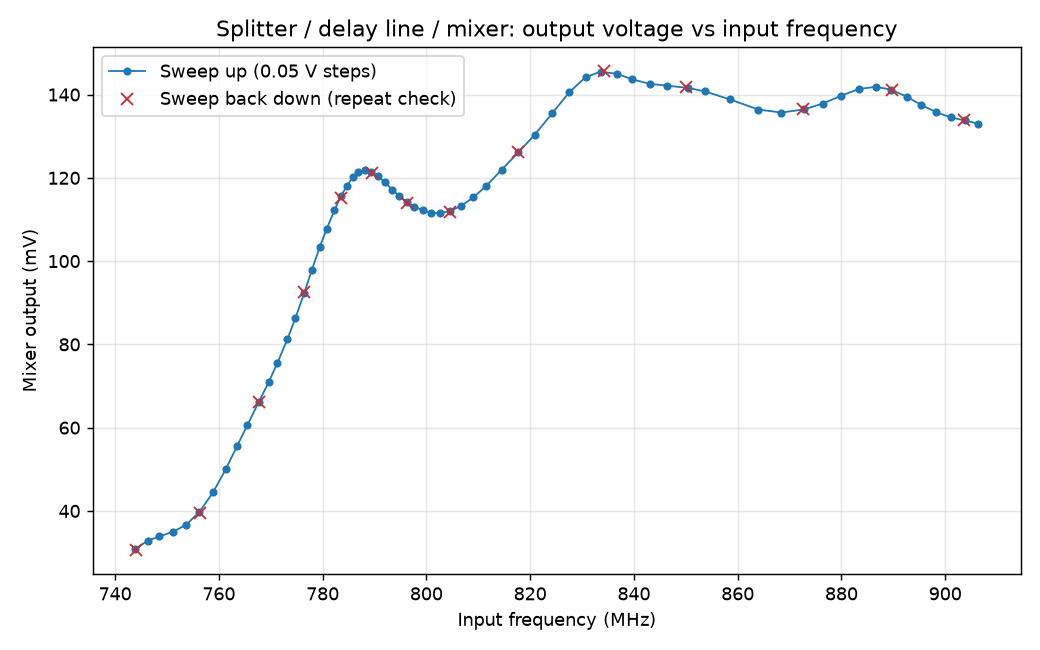
phase_detector_calibration/mixer_voltage_vs_frequency.png
