Sorin-Jayaweera/Panthalassa-Clinic-Team/phase_detector_calibration/p162x4_power_freq_map_1nov.png

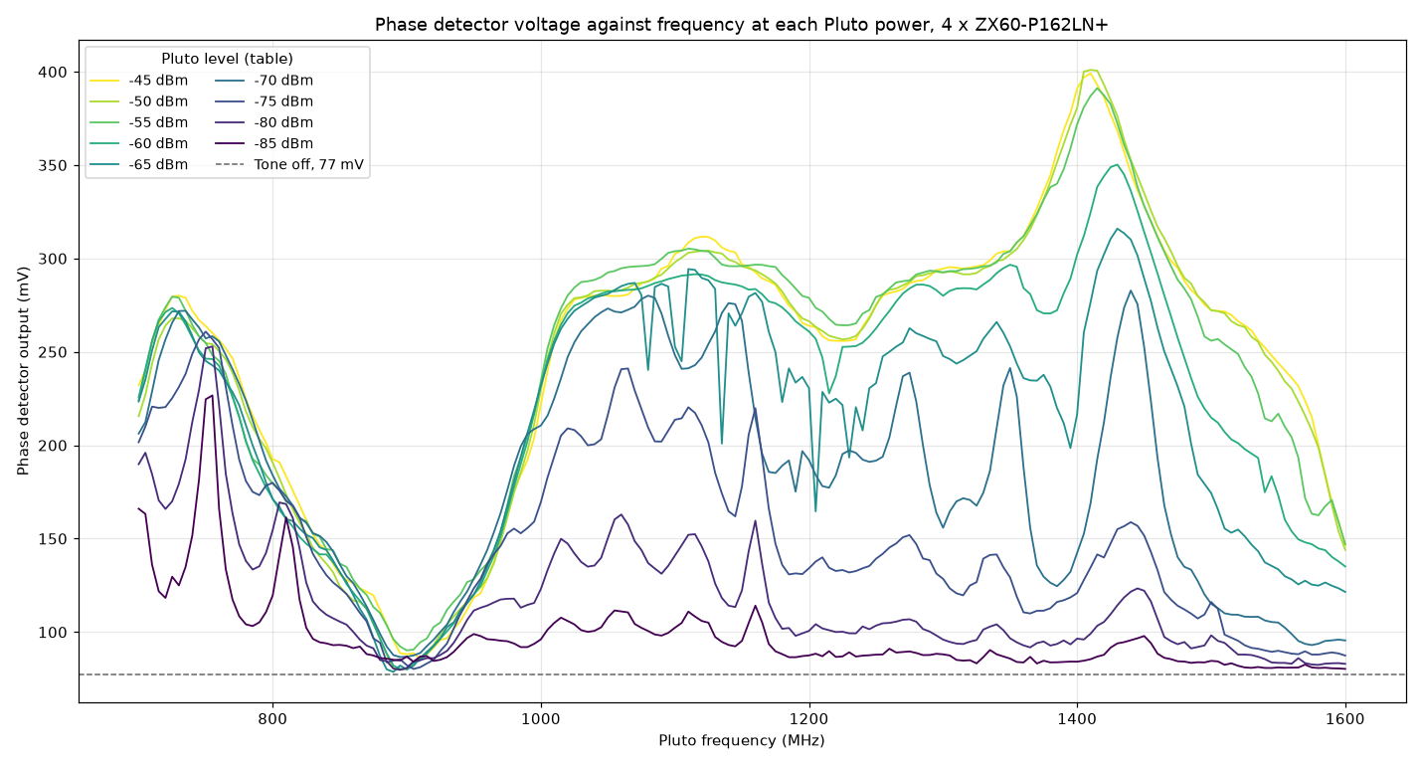
phase_detector_calibration/p162x4_power_freq_map_1nov.png
