Sorin-Jayaweera/Panthalassa-Clinic-Team/phase_detector_calibration/p162x4_power_freq_zoom_1nov.png

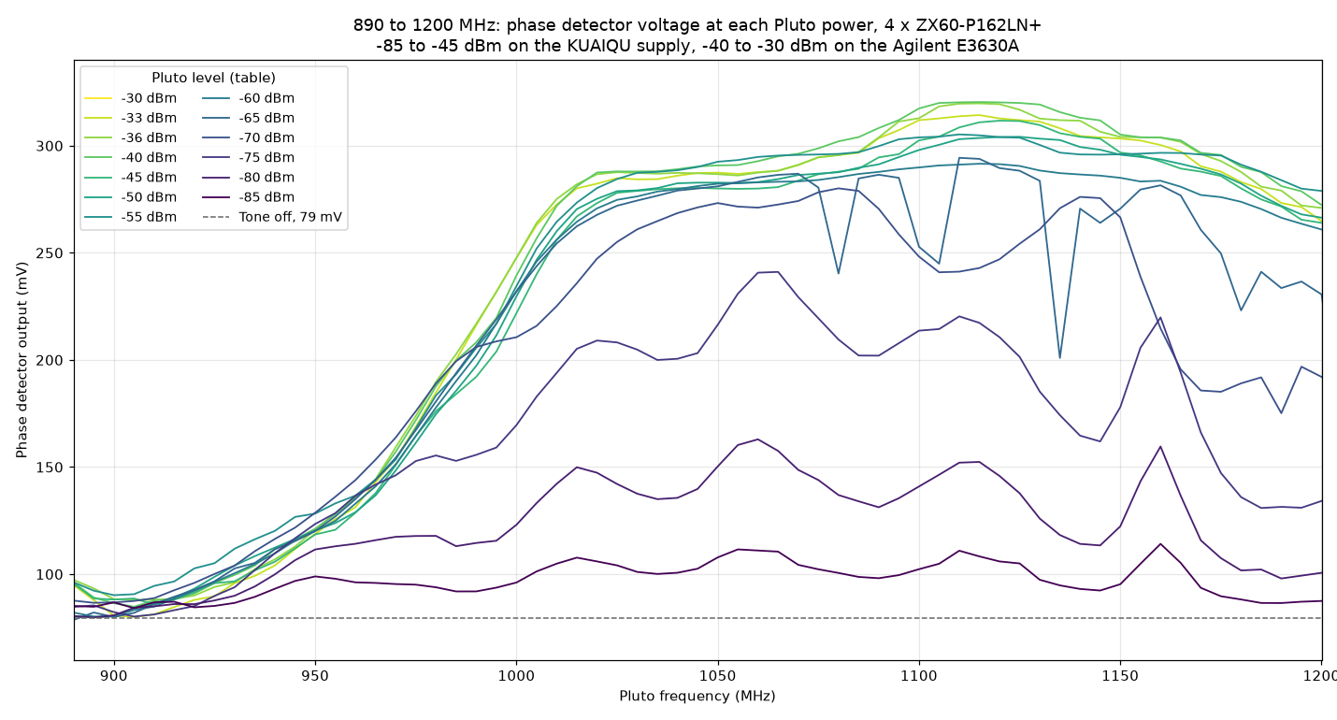
phase_detector_calibration/p162x4_power_freq_zoom_1nov.png
