Sorin-Jayaweera/Panthalassa-Clinic-Team/phase_detector_calibration/p162x4_stability_1nov.png

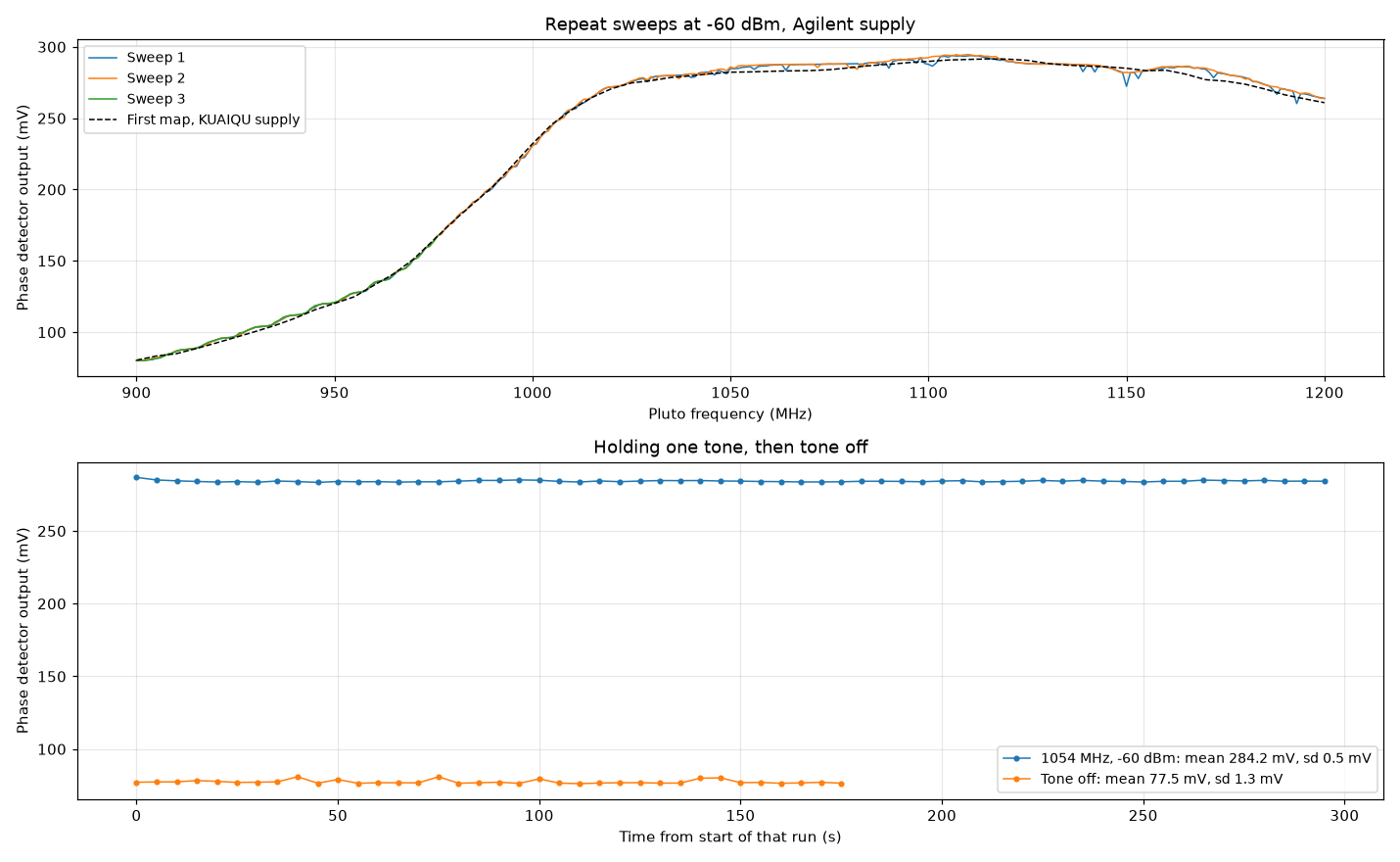
phase_detector_calibration/p162x4_stability_1nov.png
