Sorin-Jayaweera/Panthalassa-Clinic-Team/phase_detector_calibration/pluto_calibration_1nov_-36dBm_run2.png

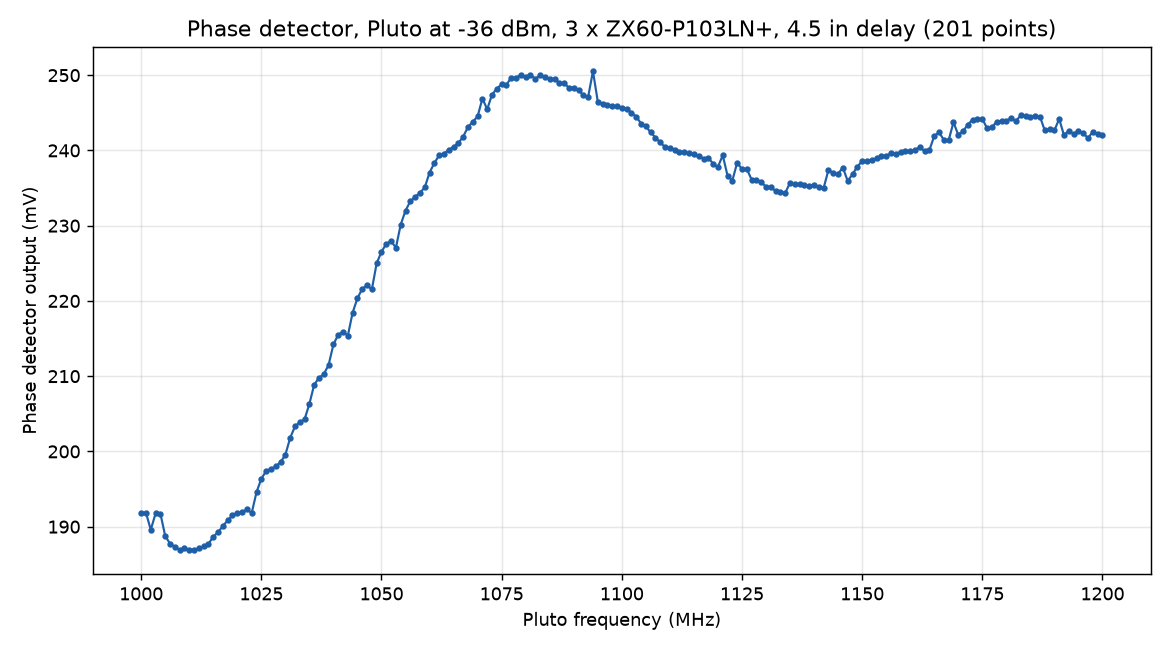
phase_detector_calibration/pluto_calibration_1nov_-36dBm_run2.png
