Sorin-Jayaweera/Panthalassa-Clinic-Team/phase_detector_calibration/pluto_full_range_1nov.png

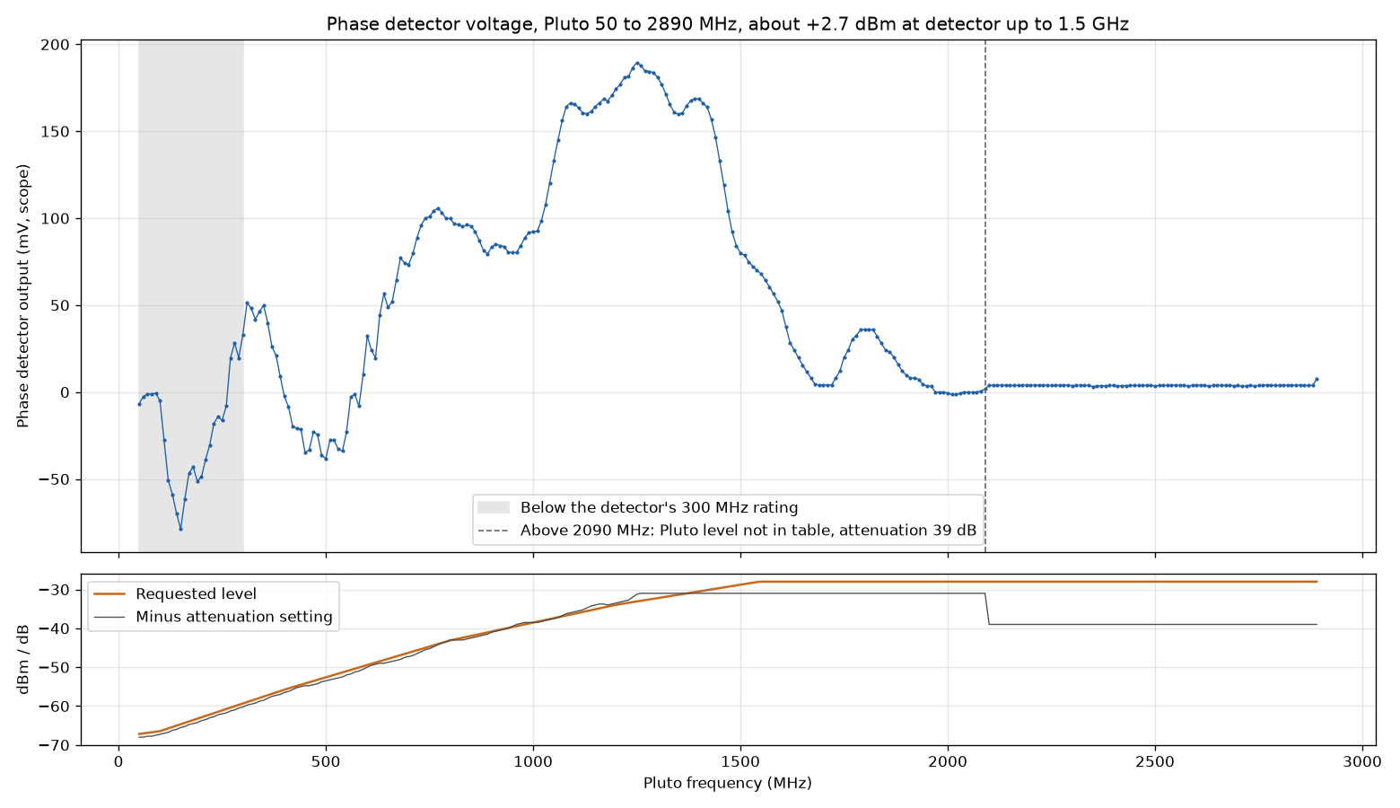
phase_detector_calibration/pluto_full_range_1nov.png
