Sorin-Jayaweera/Panthalassa-Clinic-Team/phase_detector_calibration/pluto_leak_1nov.png

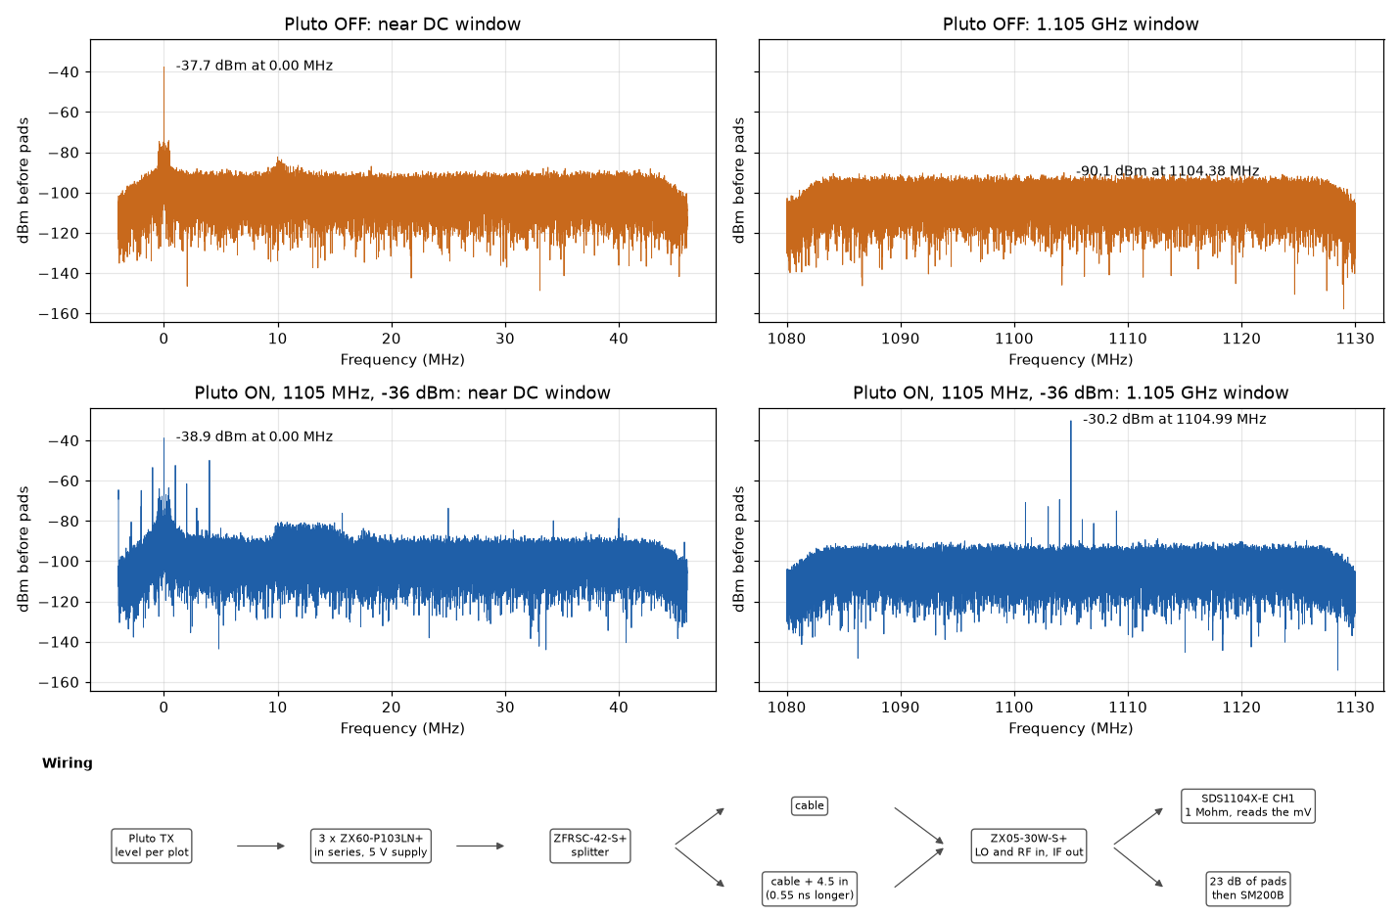
phase_detector_calibration/pluto_leak_1nov.png
