Sorin-Jayaweera/Panthalassa-Clinic-Team/phase_detector_calibration/power_at_analyzer_vs_frequency.png

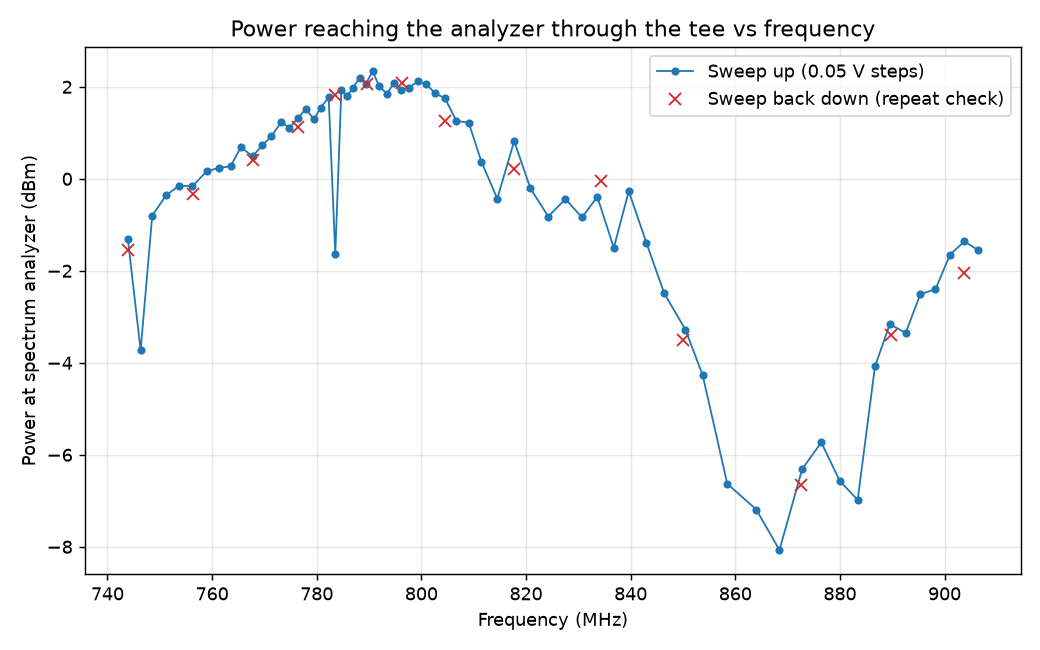
phase_detector_calibration/power_at_analyzer_vs_frequency.png
