Sorin-Jayaweera/Panthalassa-Clinic-Team/phase_detector_calibration/site/img/lut_mixer_alone.png

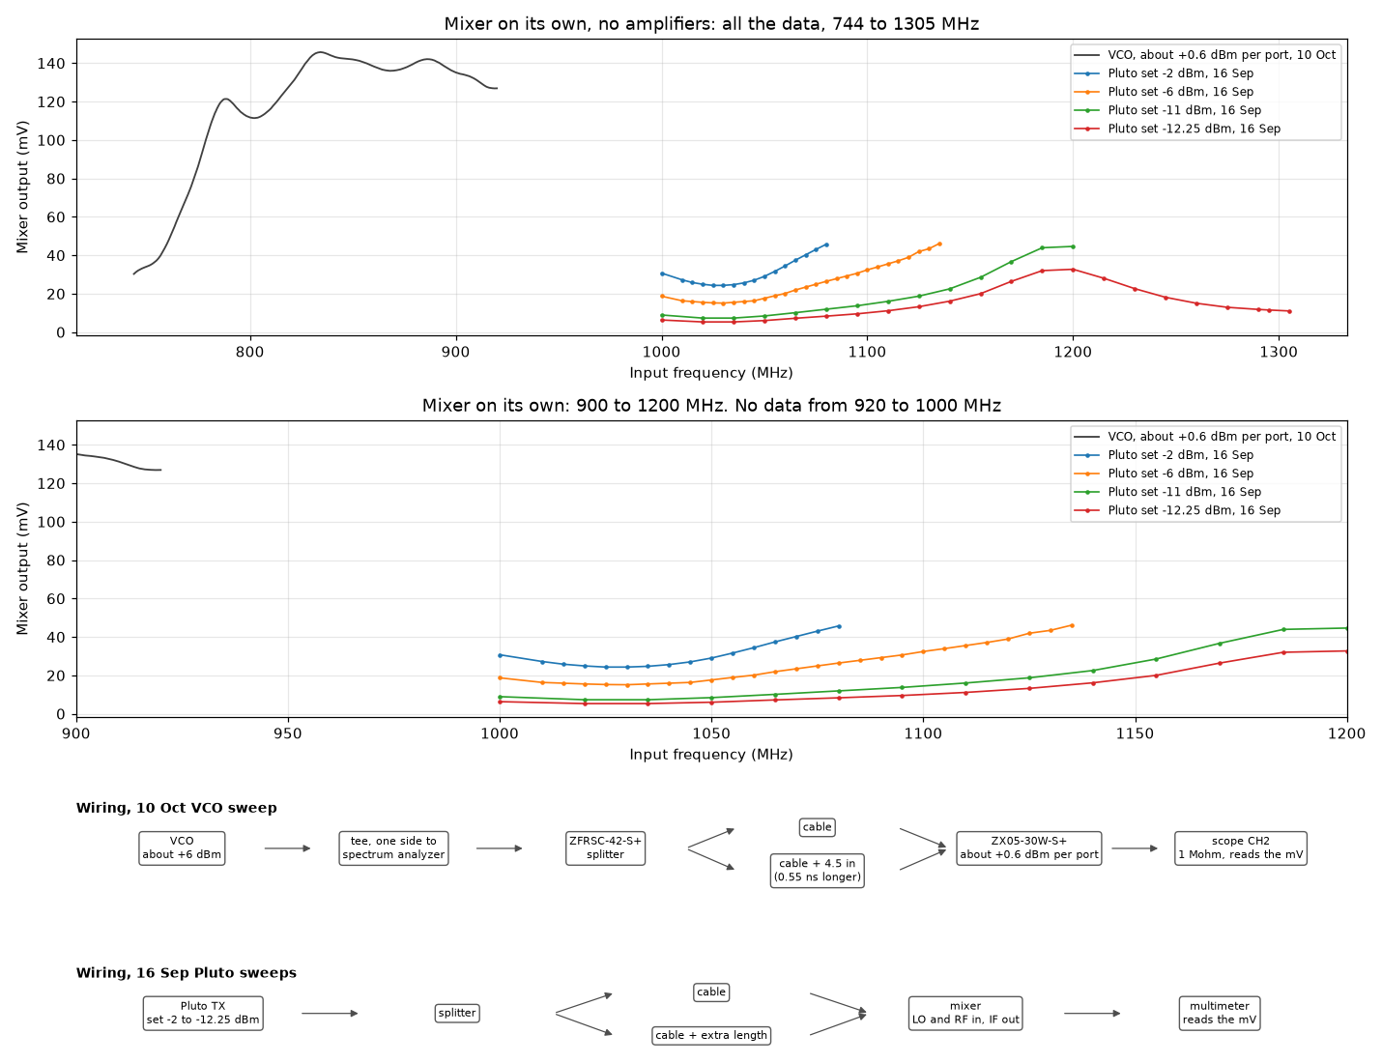
phase_detector_calibration/site/img/lut_mixer_alone.png
