Sorin-Jayaweera/Panthalassa-Clinic-Team/phase_detector_calibration/site/img/lut_p162x4_mixer.png

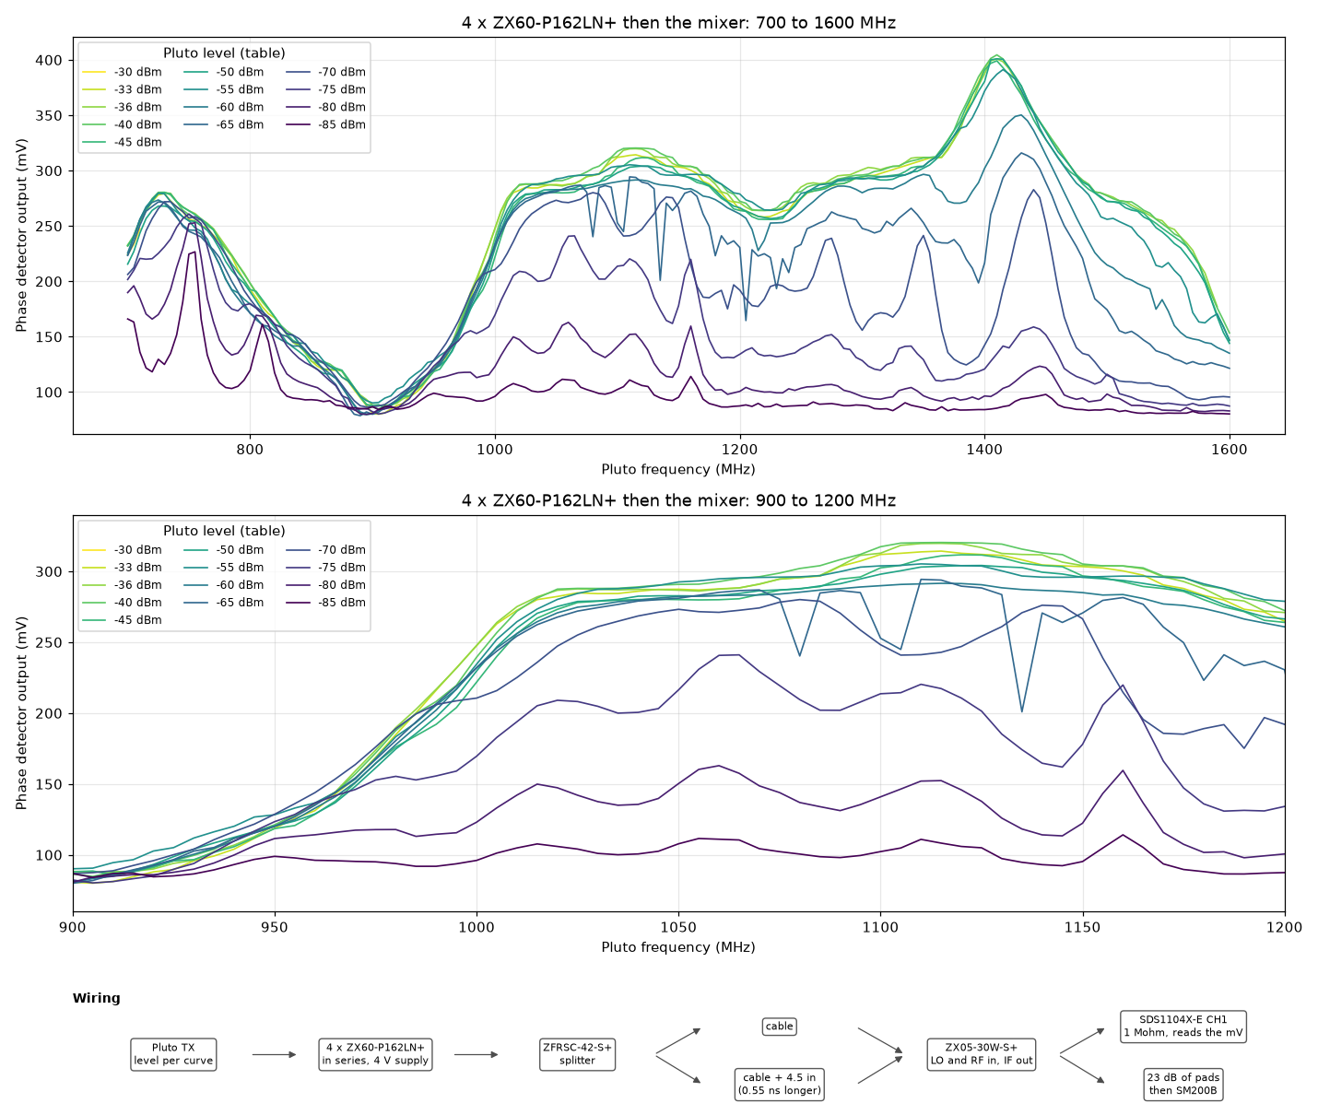
phase_detector_calibration/site/img/lut_p162x4_mixer.png
