Sorin-Jayaweera/Panthalassa-Clinic-Team/phase_detector_calibration/site/img/p162x4_power_uncertainty.png

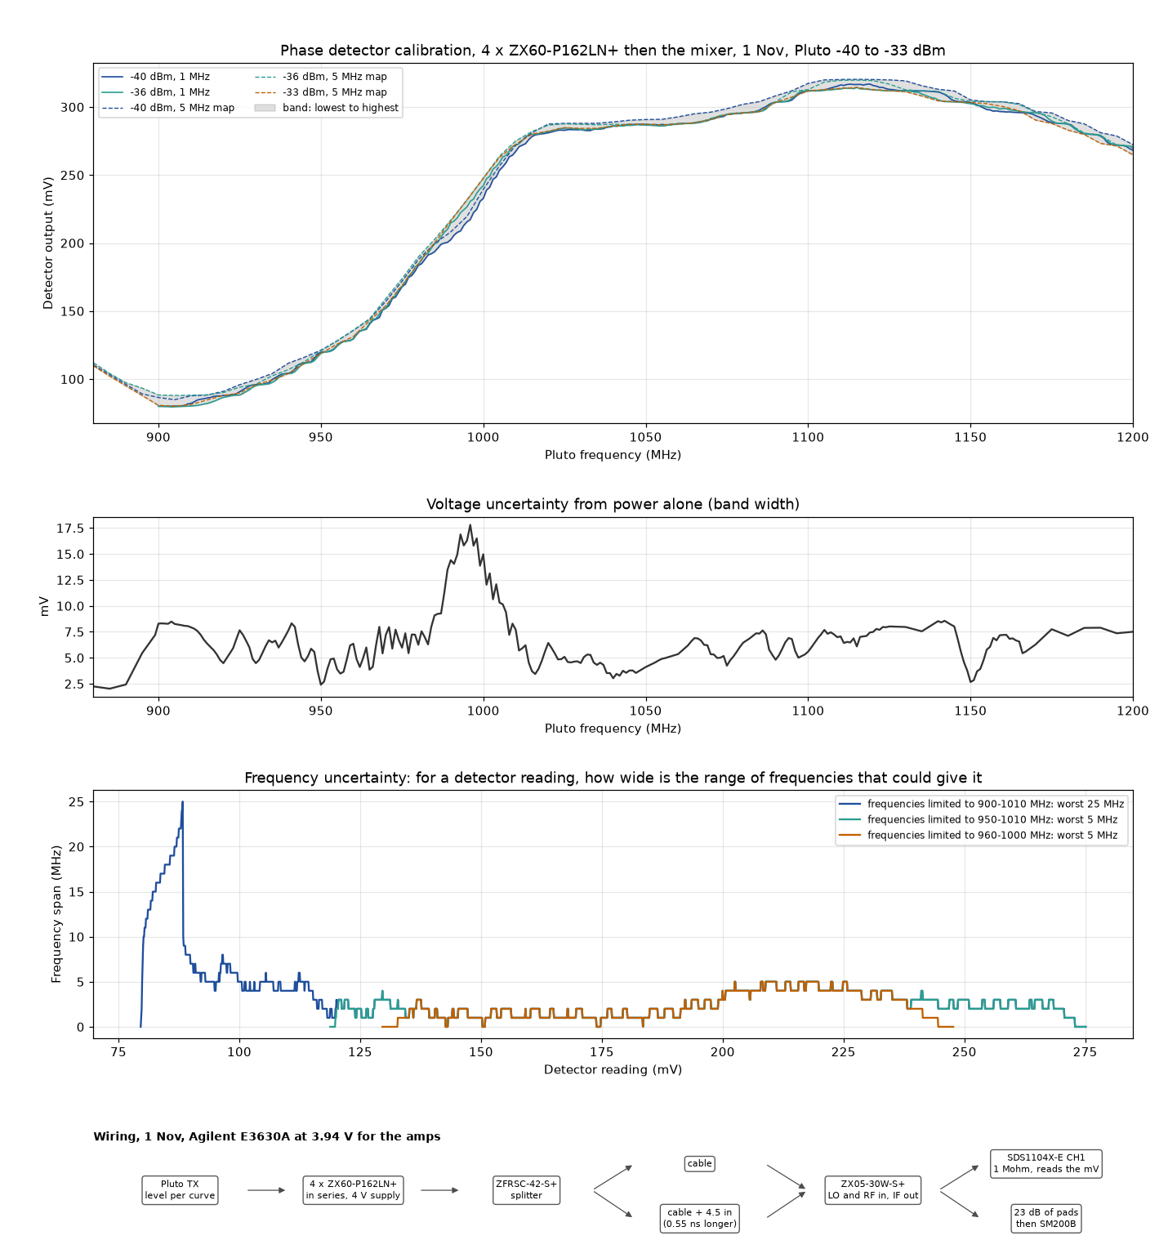
phase_detector_calibration/site/img/p162x4_power_uncertainty.png
