Sorin-Jayaweera/Panthalassa-Clinic-Team/phase_detector_calibration/site/img/pluto_calibration_1nov_-36dBm_800to1200.png

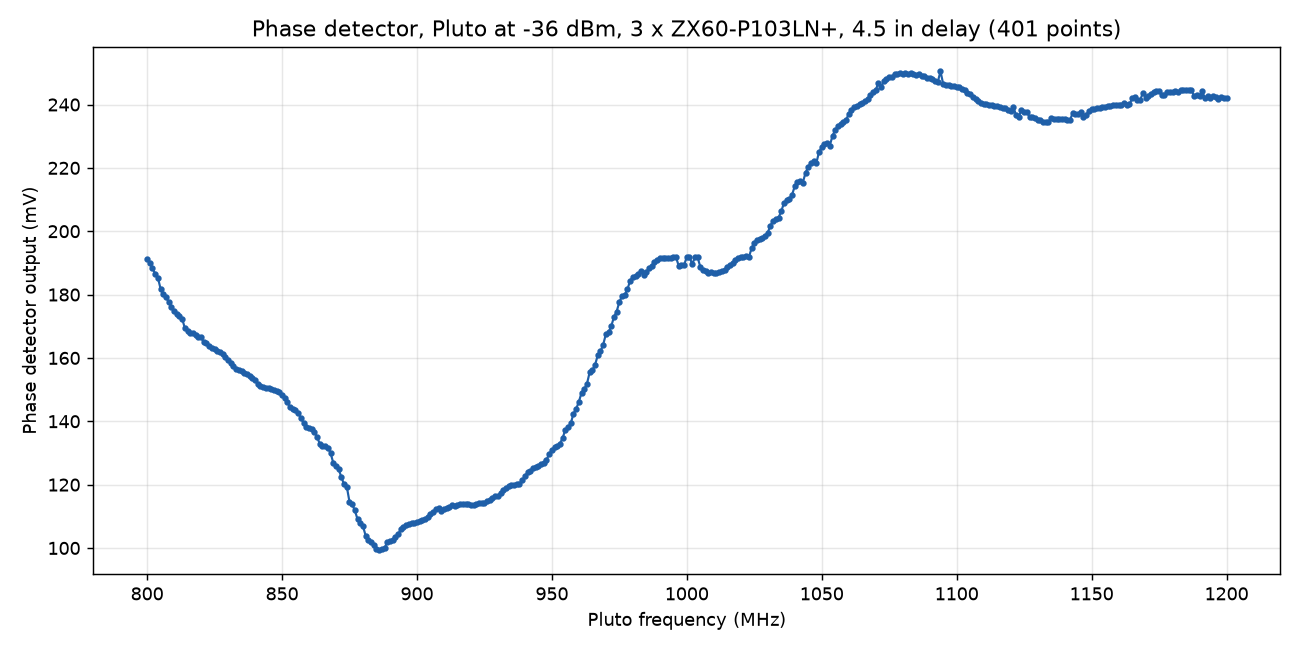
phase_detector_calibration/site/img/pluto_calibration_1nov_-36dBm_800to1200.png
