Sorin-Jayaweera/Panthalassa-Clinic-Team/phase_detector_calibration/site/img/pluto_drift.png

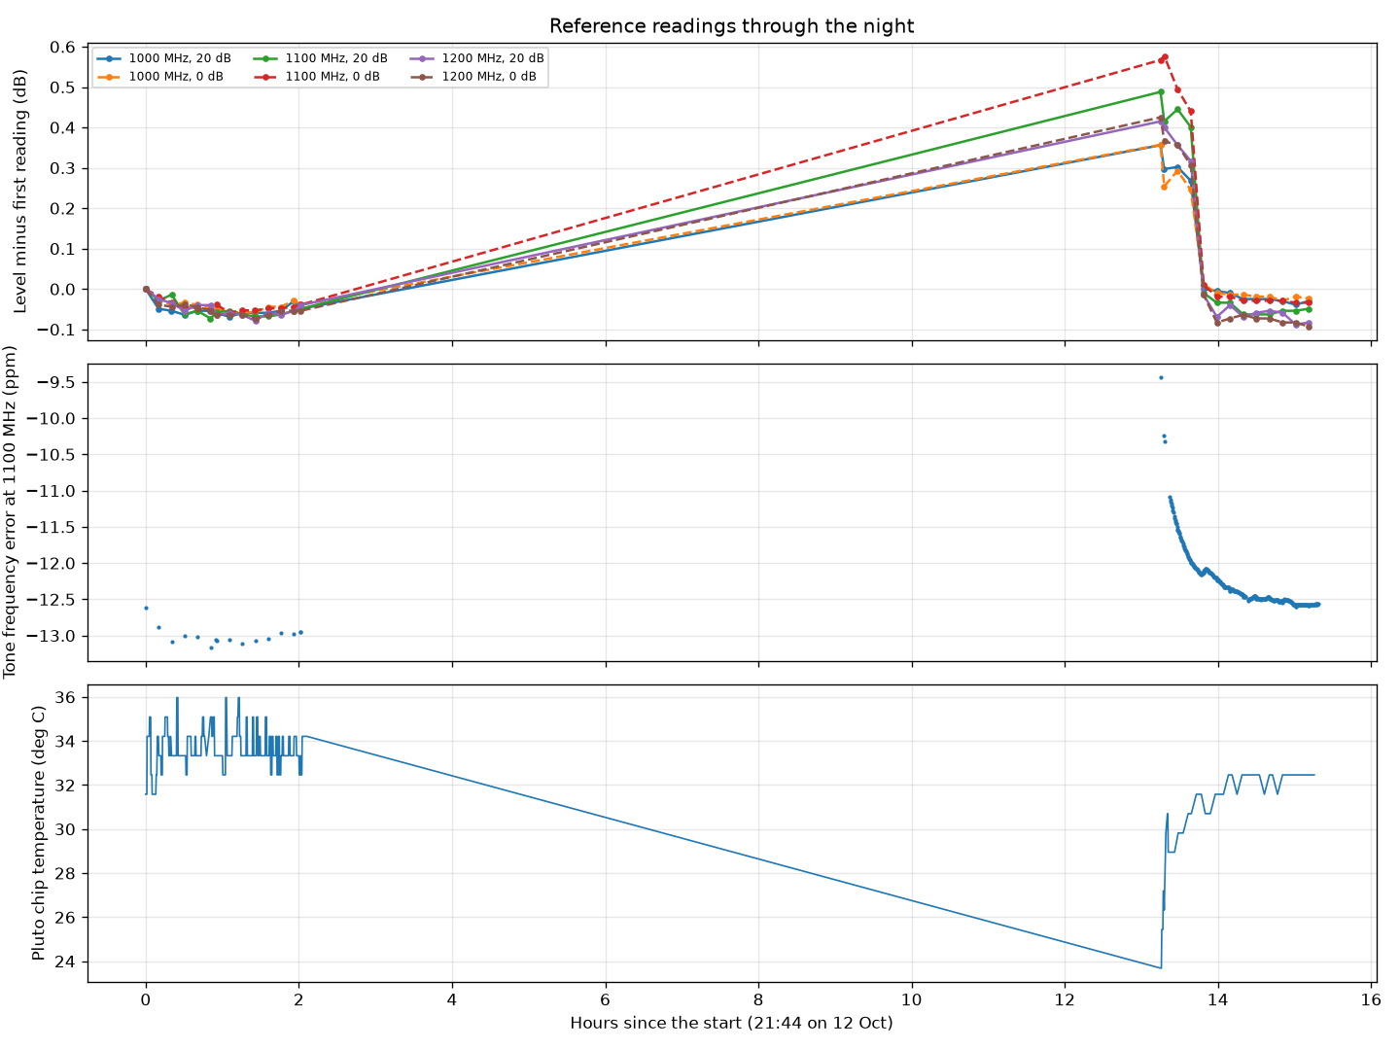
phase_detector_calibration/site/img/pluto_drift.png
