Sorin-Jayaweera/Panthalassa-Clinic-Team/phase_detector_calibration/site/img/pluto_map_runs_1nov.png

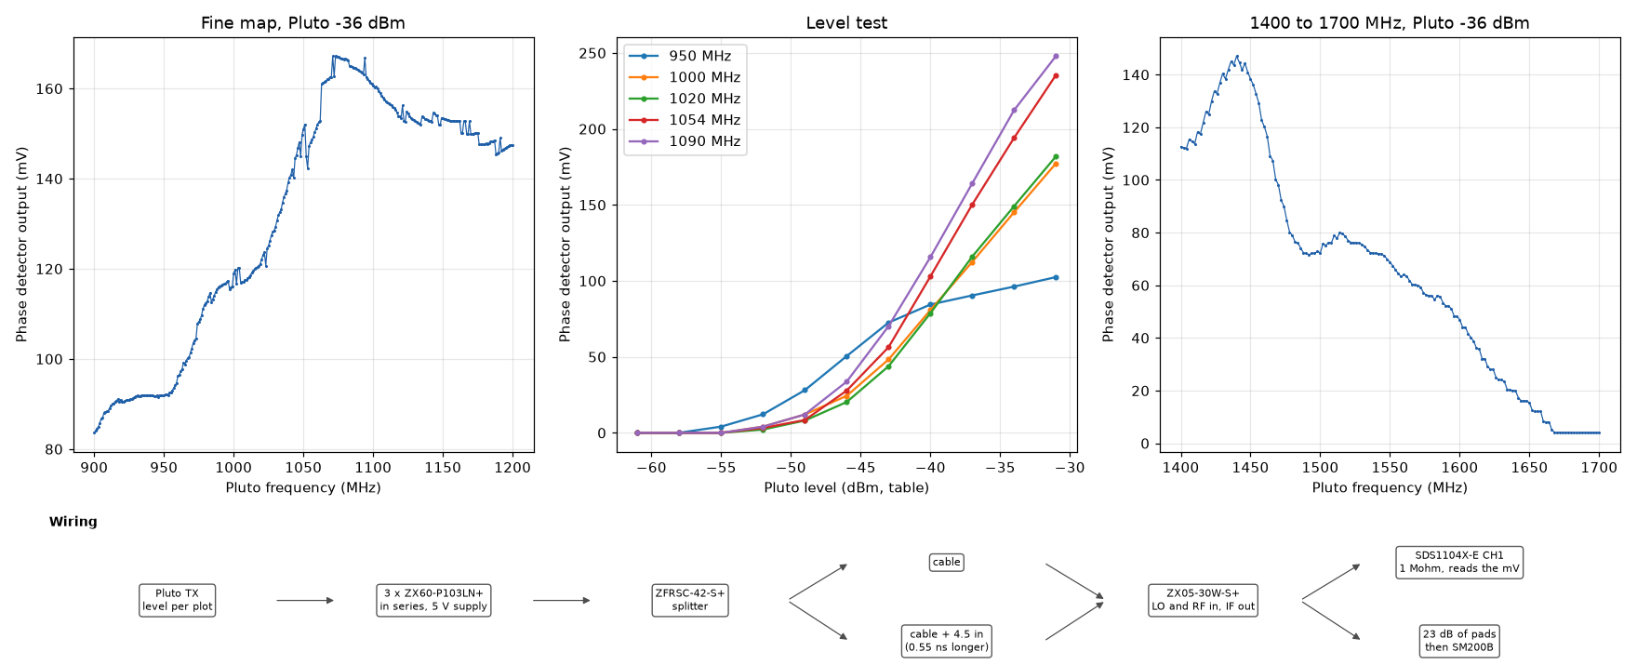
phase_detector_calibration/site/img/pluto_map_runs_1nov.png
