Sorin-Jayaweera/Panthalassa-Clinic-Team/phase_detector_calibration/site/img/pluto_power_freq_map_1nov.png

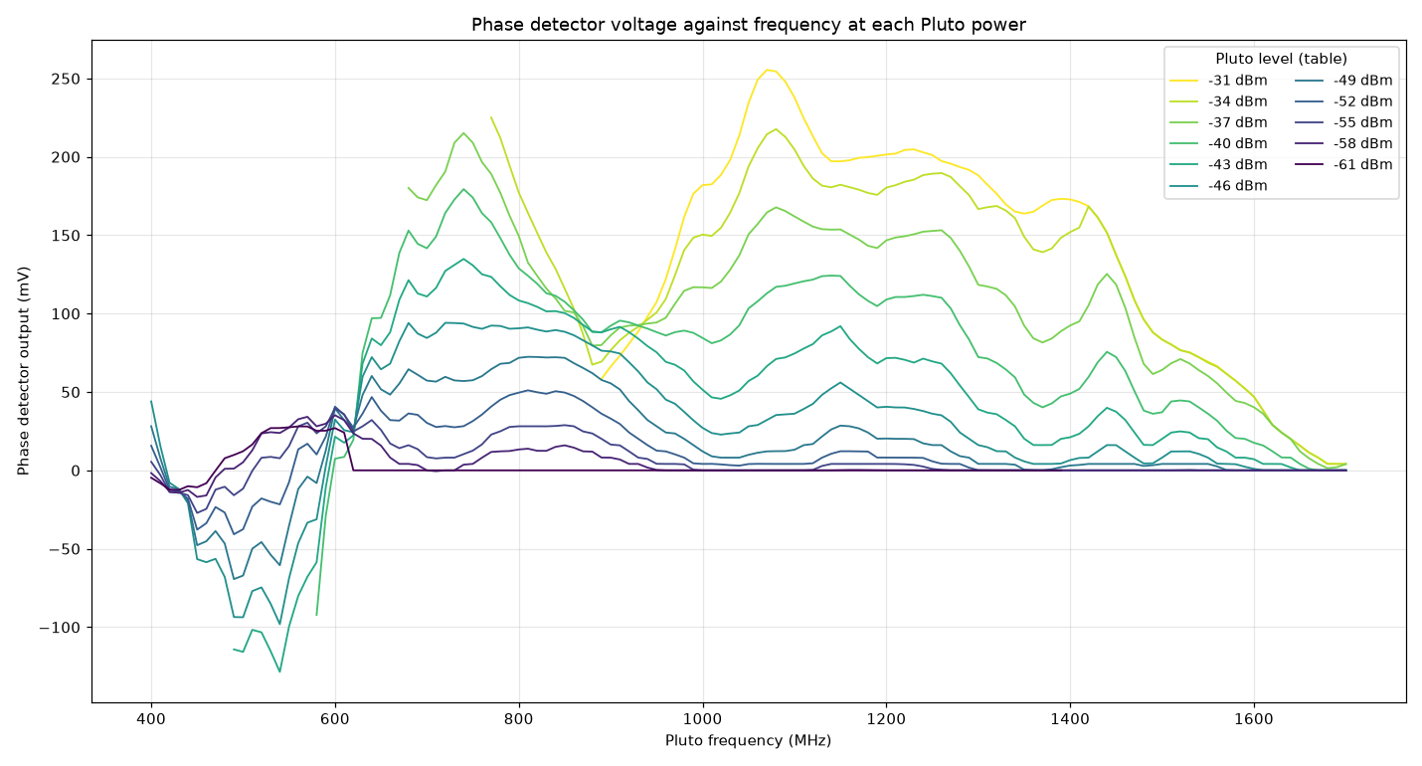
phase_detector_calibration/site/img/pluto_power_freq_map_1nov.png
