Sorin-Jayaweera/Panthalassa-Clinic-Team/phase_detector_calibration/site/img/racon_fig2_edges.png

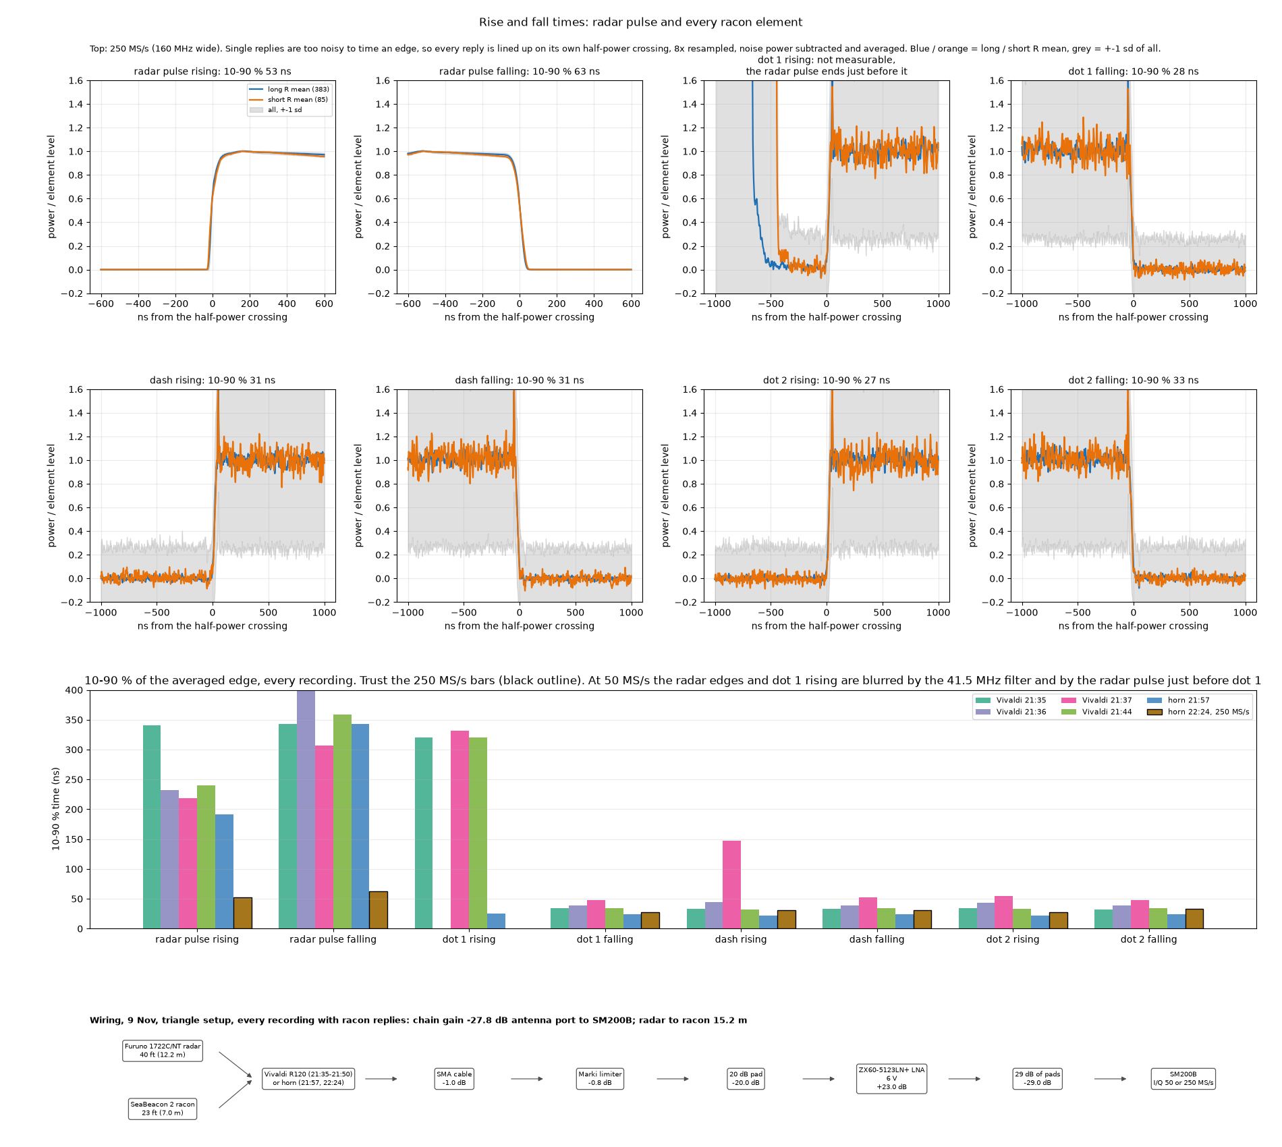
phase_detector_calibration/site/img/racon_fig2_edges.png
