Sorin-Jayaweera/Panthalassa-Clinic-Team/phase_detector_calibration/site/img/racon_fig5_short_block.png

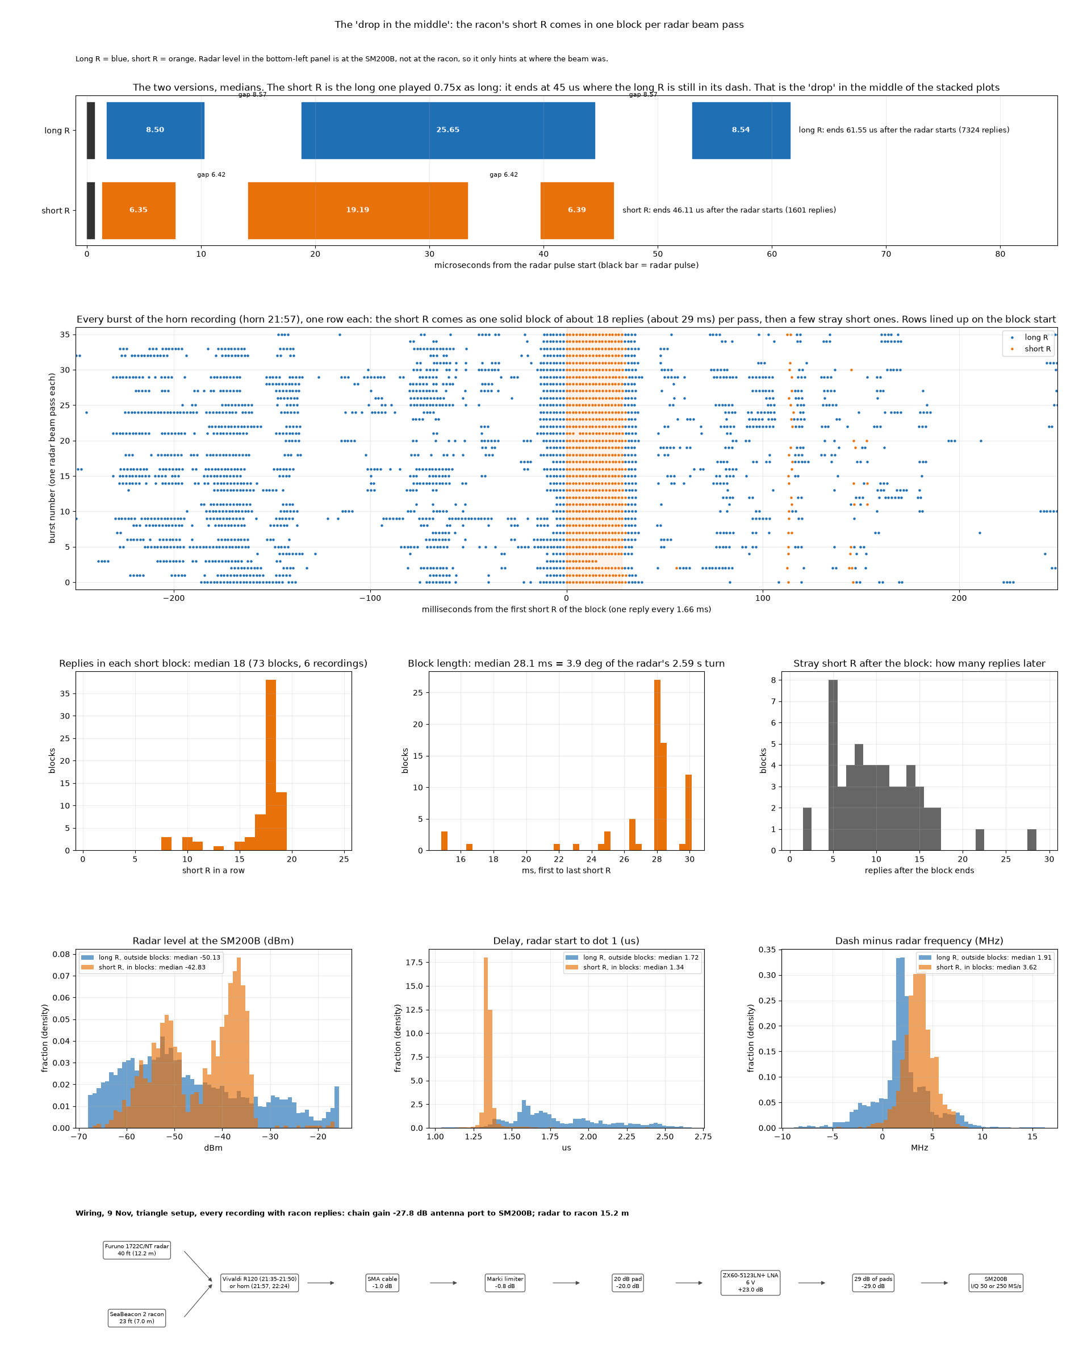
phase_detector_calibration/site/img/racon_fig5_short_block.png
