Sorin-Jayaweera/Panthalassa-Clinic-Team/phase_detector_calibration/site/img/racon_fig6_iq_time.png

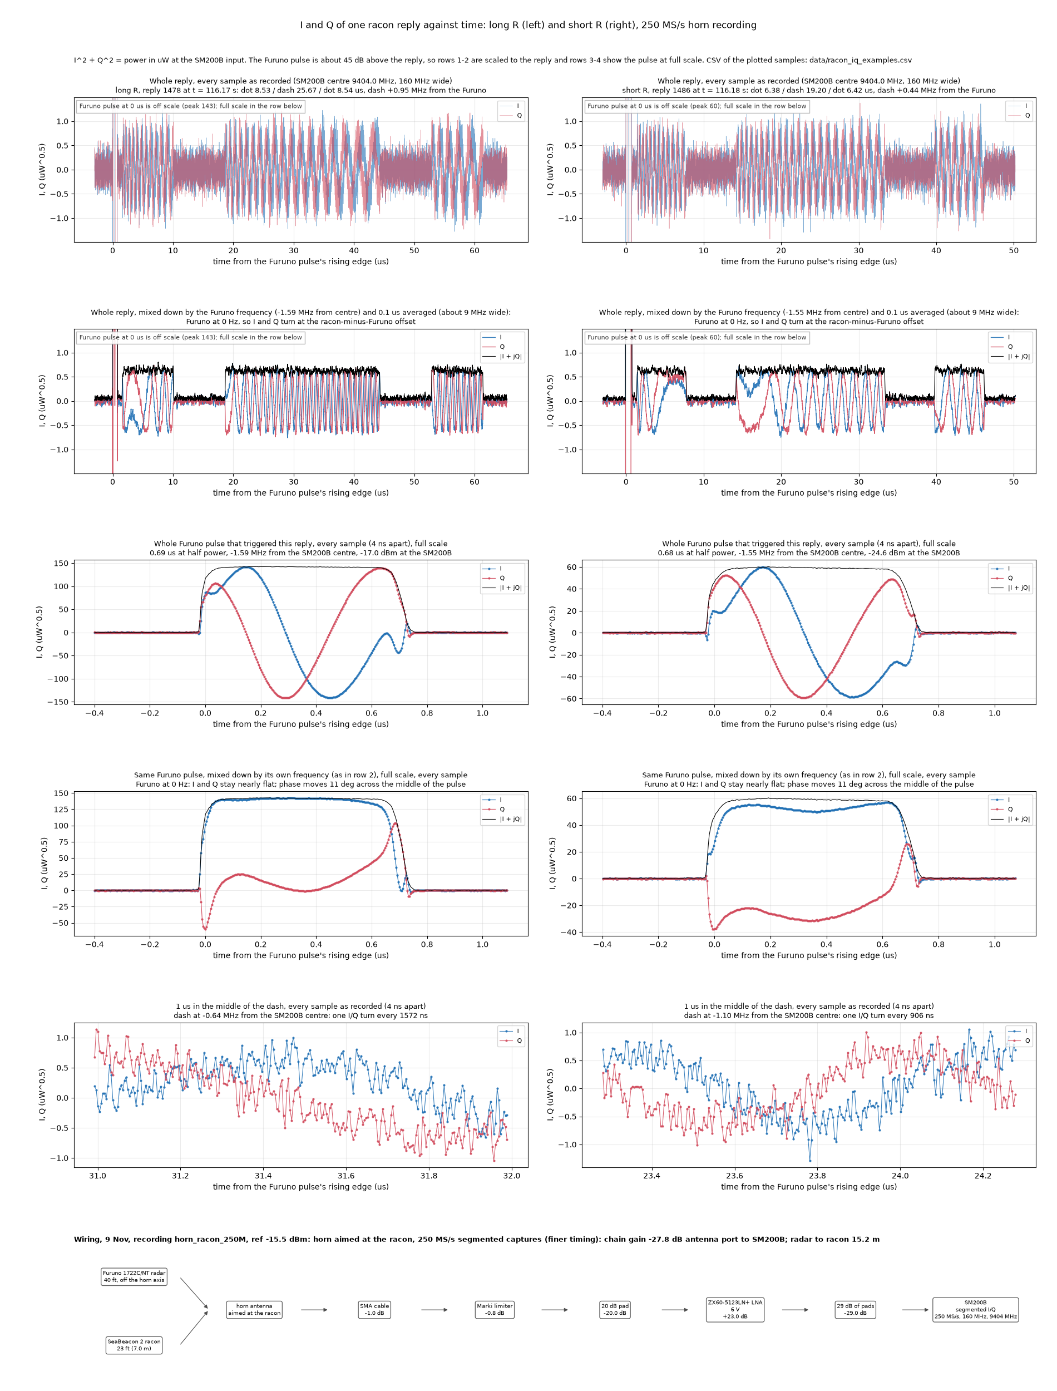
phase_detector_calibration/site/img/racon_fig6_iq_time.png
