Sorin-Jayaweera/Panthalassa-Clinic-Team/phase_detector_calibration/site/img/radar_timeline.png

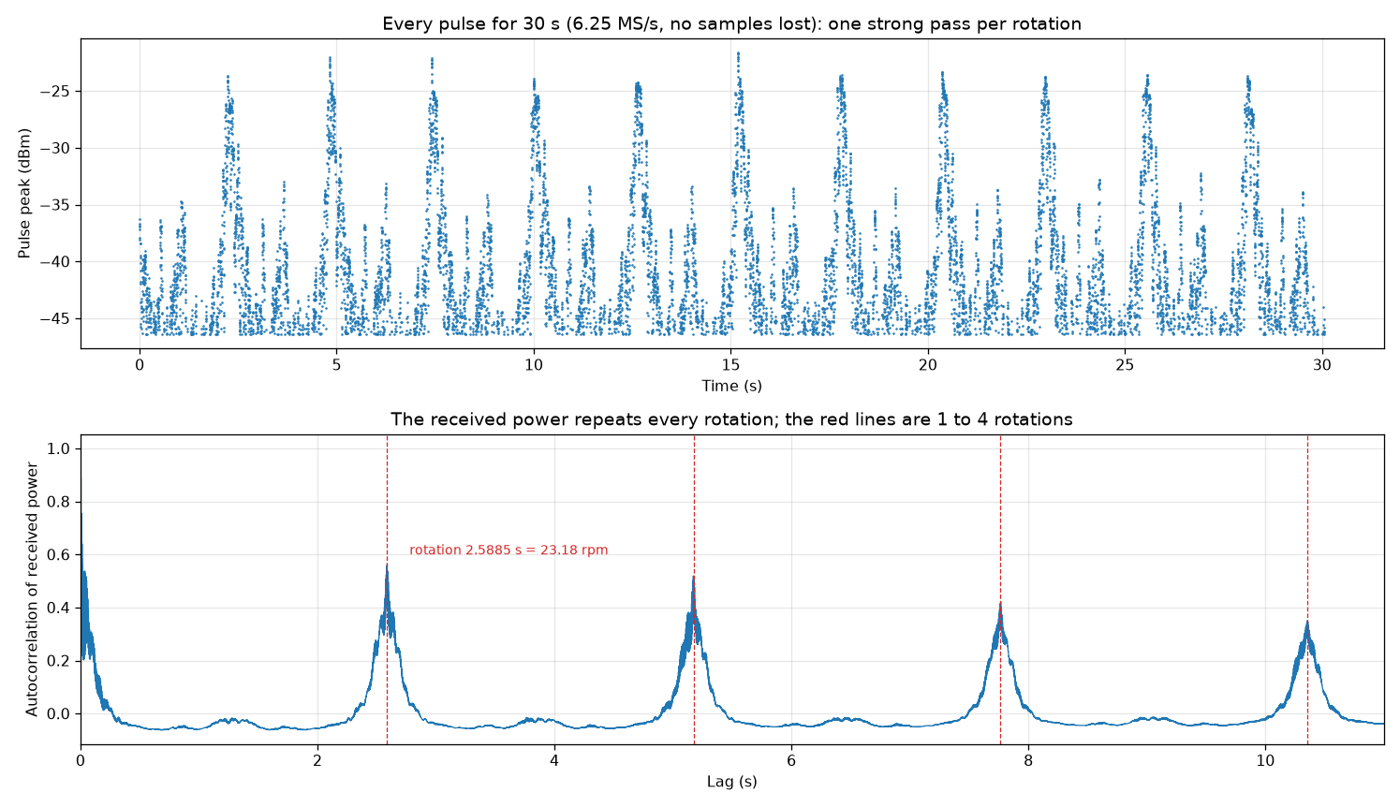
phase_detector_calibration/site/img/radar_timeline.png
