Sorin-Jayaweera/Panthalassa-Clinic-Team/phase_detector_calibration/site/img/sds1104x_first_look_31oct.png

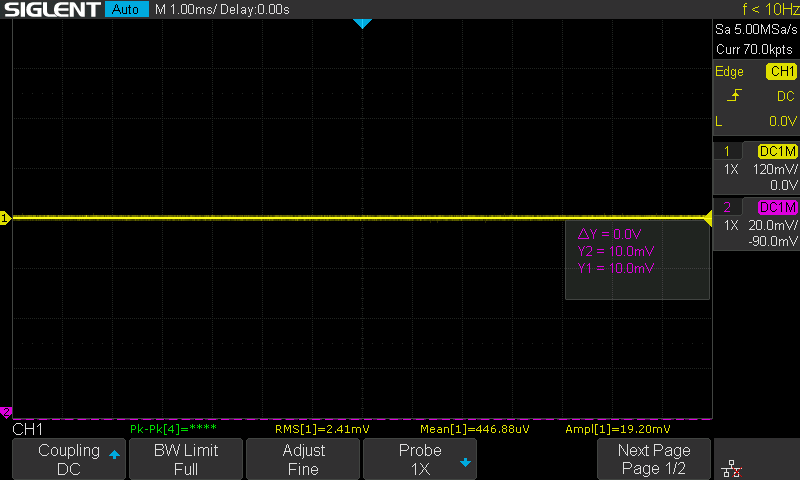
phase_detector_calibration/site/img/sds1104x_first_look_31oct.png
