Sorin-Jayaweera/Panthalassa-Clinic-Team/phase_detector_calibration/site/img/spike_test35_mixer_IF_radar_off_full_span_31oct.png

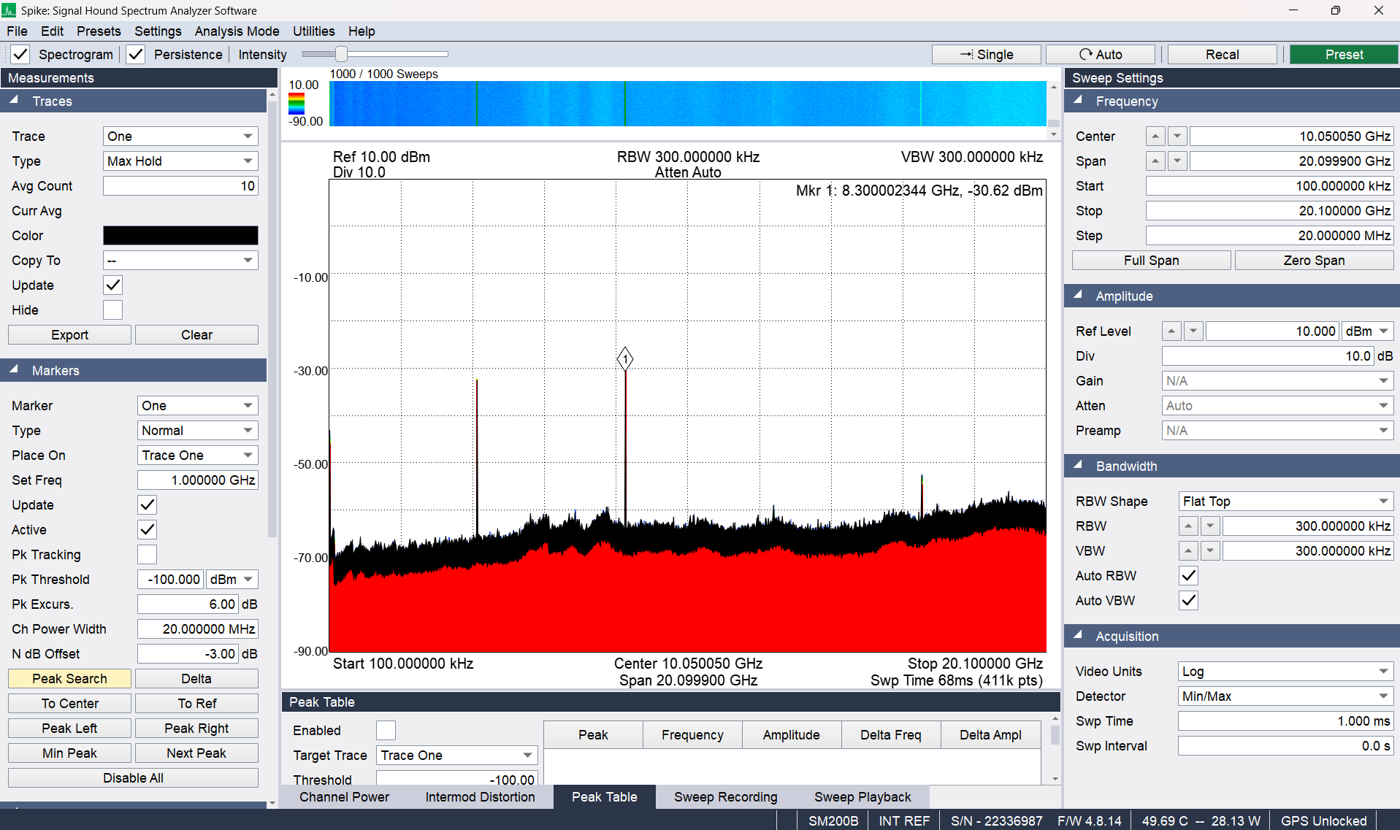
phase_detector_calibration/site/img/spike_test35_mixer_IF_radar_off_full_span_31oct.png
