Sorin-Jayaweera/Panthalassa-Clinic-Team/phase_detector_calibration/site/img/spike_test36_mixer_RF_feedthrough_31oct.png

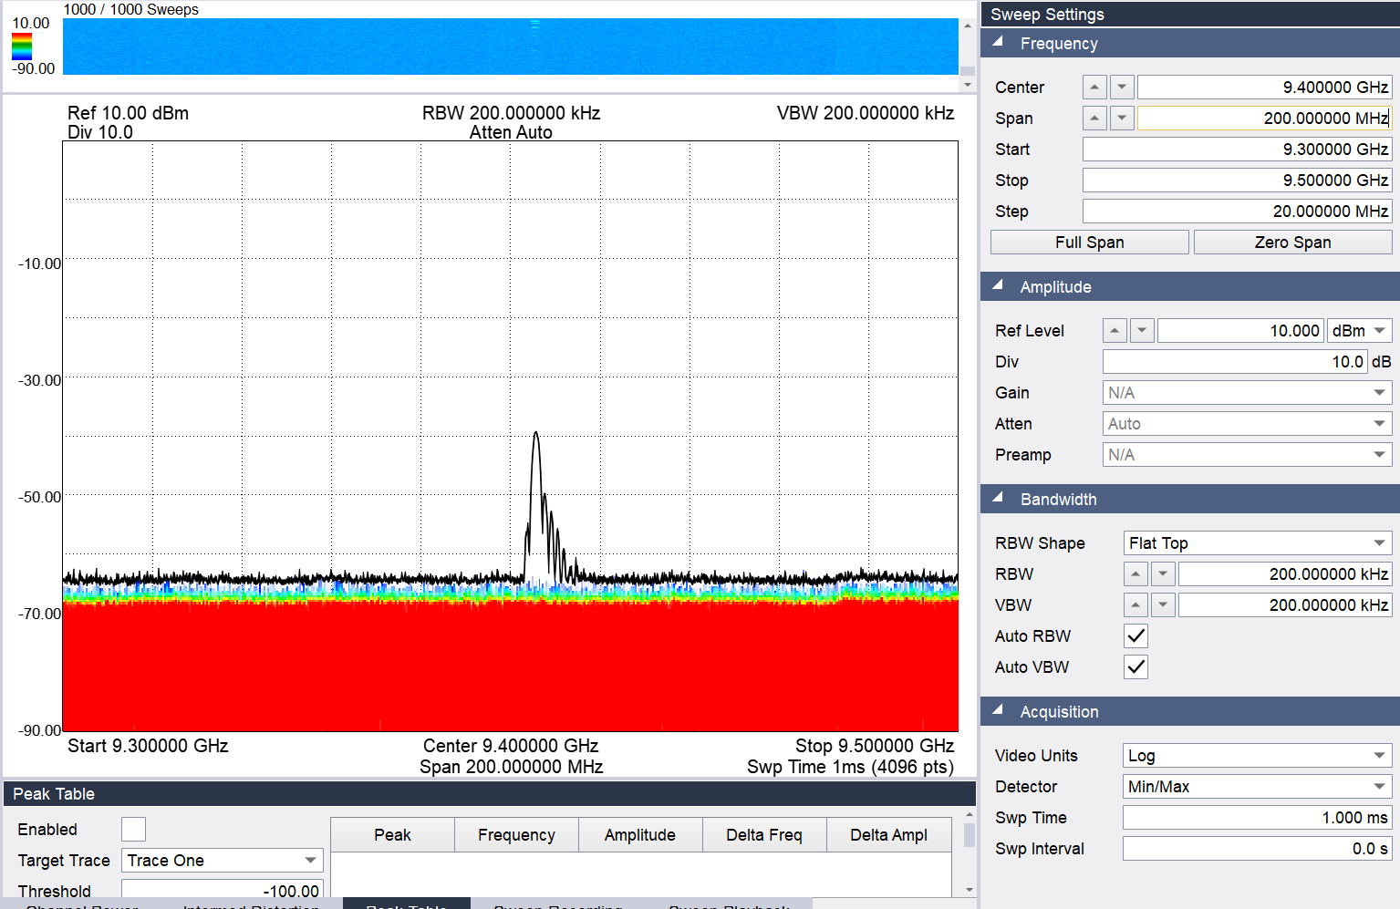
phase_detector_calibration/site/img/spike_test36_mixer_RF_feedthrough_31oct.png
