Sorin-Jayaweera/Panthalassa-Clinic-Team/phase_detector_calibration/site/img/spike_test36b_mixer_9p4GHz_3MHz_31oct.png

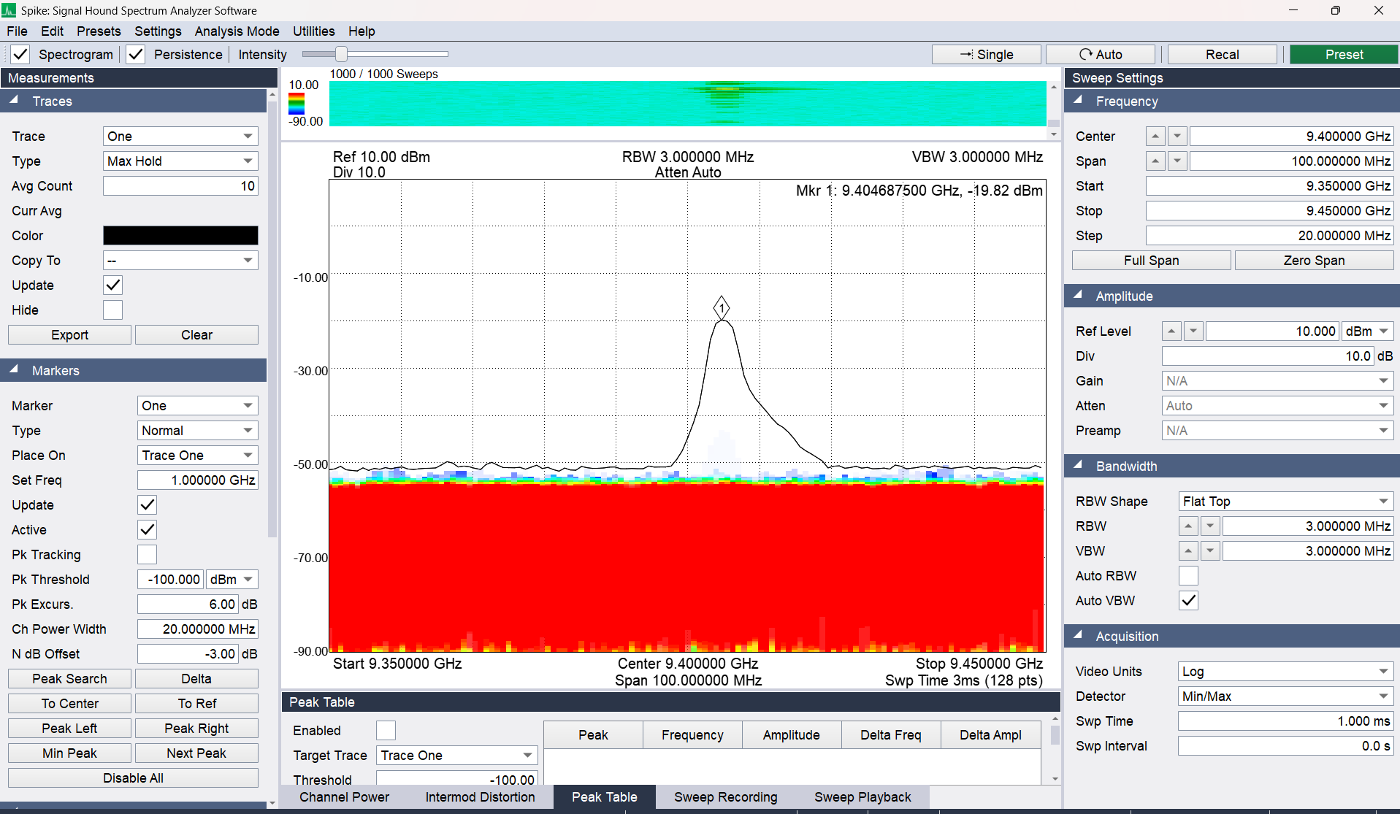
phase_detector_calibration/site/img/spike_test36b_mixer_9p4GHz_3MHz_31oct.png
