Sorin-Jayaweera/Panthalassa-Clinic-Team/phase_detector_calibration/site/img/spike_test38_mixer_IF_back_on_sm200b_31oct.png

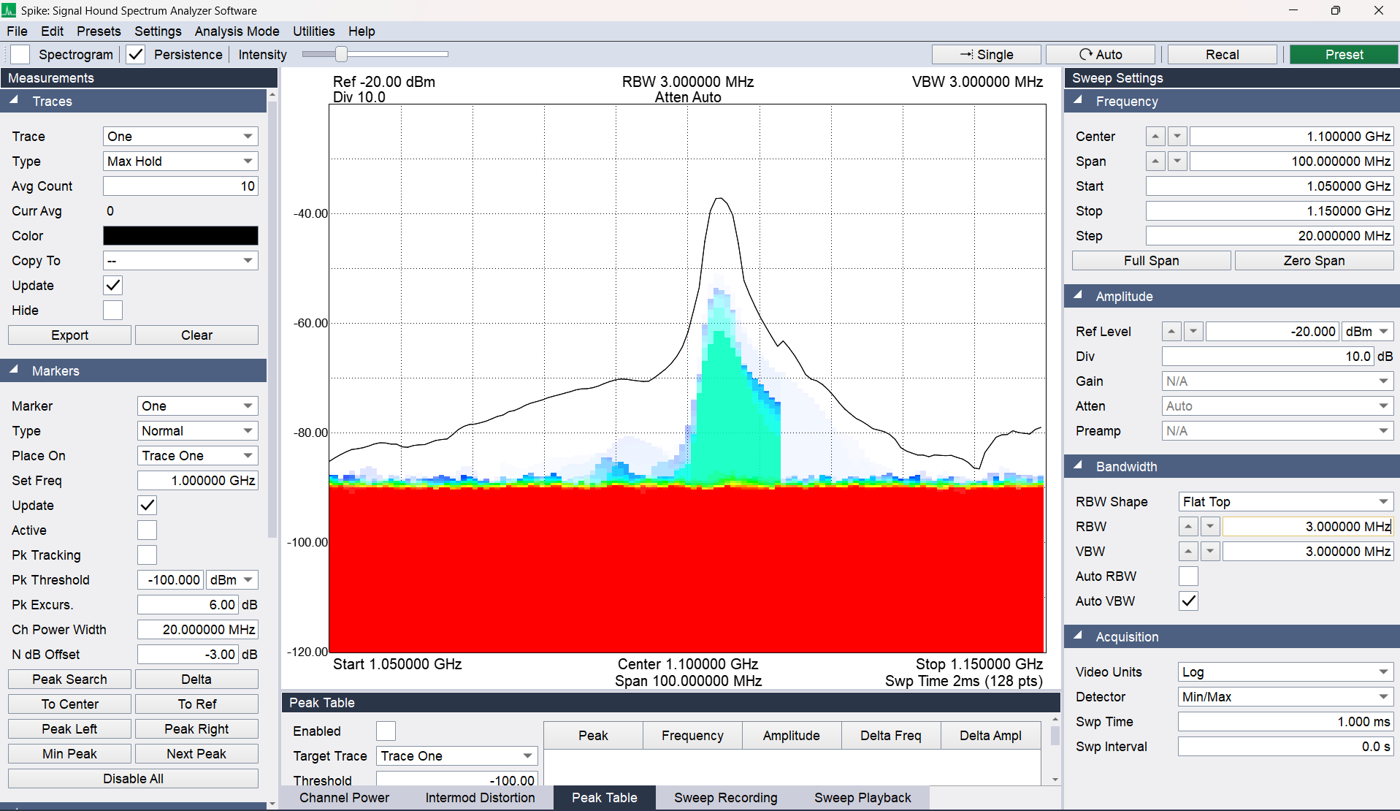
phase_detector_calibration/site/img/spike_test38_mixer_IF_back_on_sm200b_31oct.png
