Sorin-Jayaweera/Panthalassa-Clinic-Team/phase_detector_calibration/site/img/ssa3021x_IF_swept_100MHz_31oct_screen.png

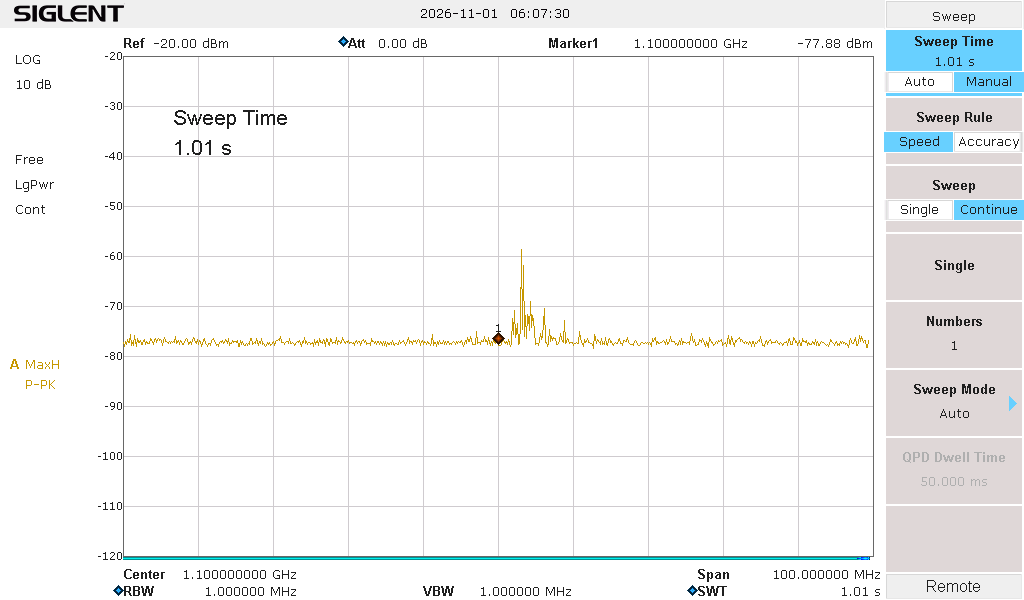
phase_detector_calibration/site/img/ssa3021x_IF_swept_100MHz_31oct_screen.png
