Sorin-Jayaweera/Panthalassa-Clinic-Team/phase_detector_calibration/site/img/stats_20261109_213716_stack_radar.png

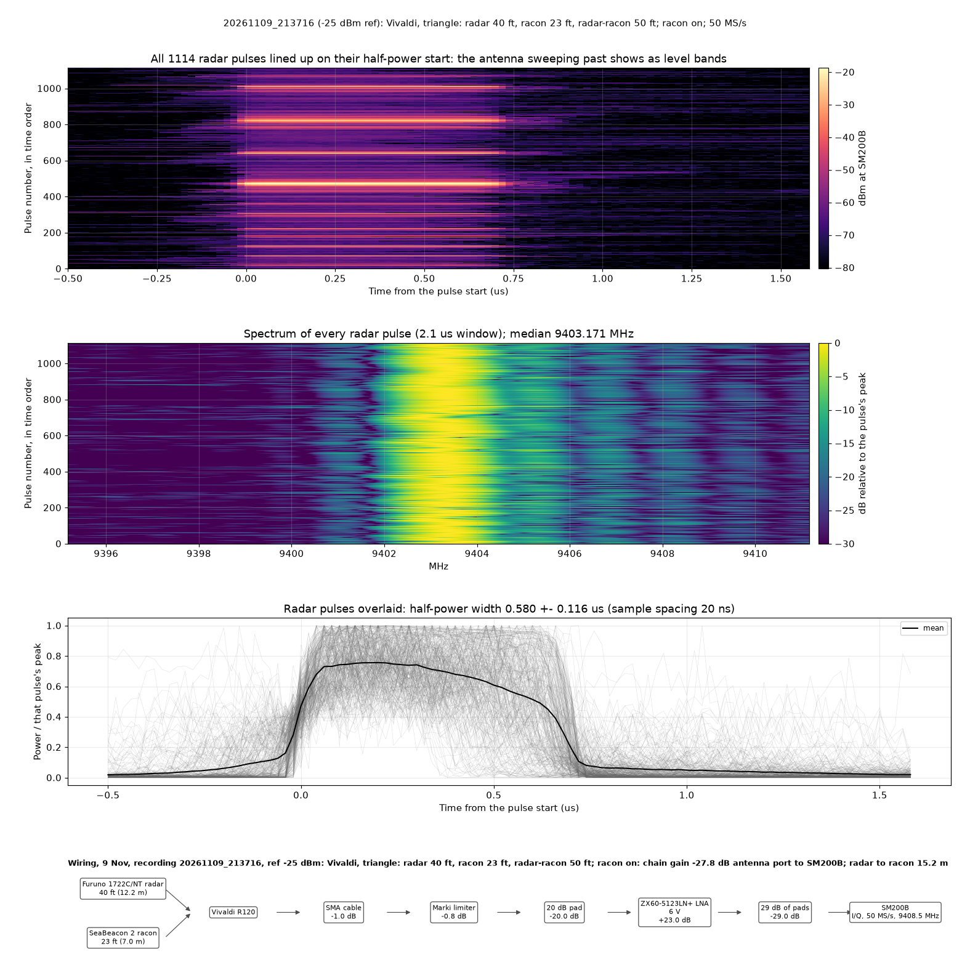
phase_detector_calibration/site/img/stats_20261109_213716_stack_radar.png
