Sorin-Jayaweera/Panthalassa-Clinic-Team/phase_detector_calibration/site/img/stats_20261109_214452_stack_envelope.png

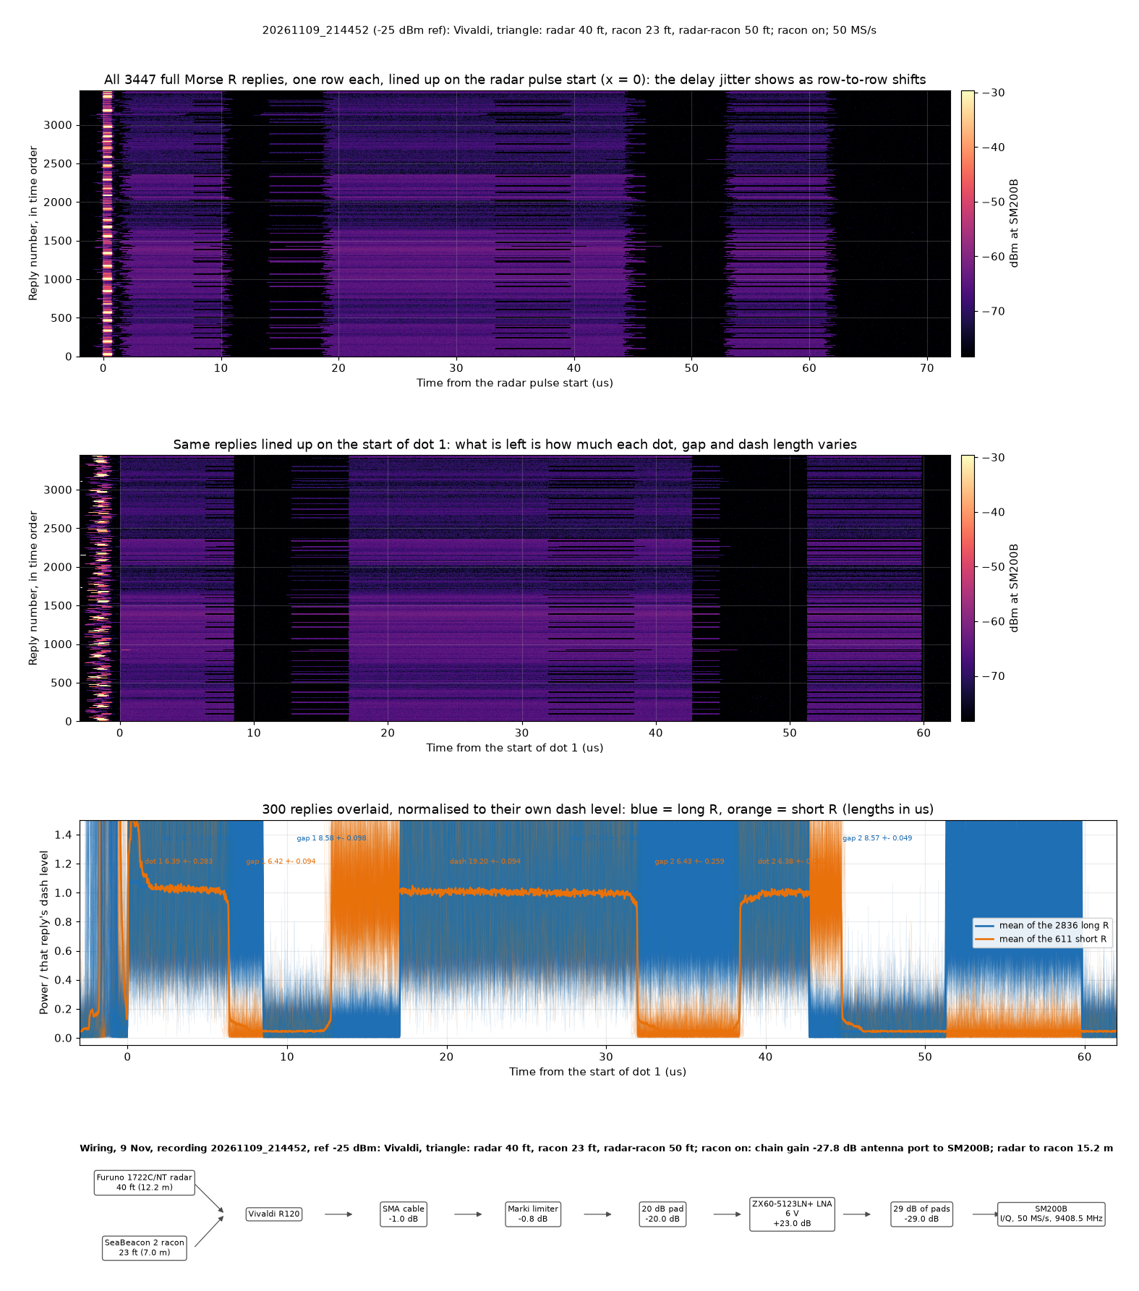
phase_detector_calibration/site/img/stats_20261109_214452_stack_envelope.png
