Sorin-Jayaweera/Panthalassa-Clinic-Team/phase_detector_calibration/site/img/stats_20261109_215716_freq.png

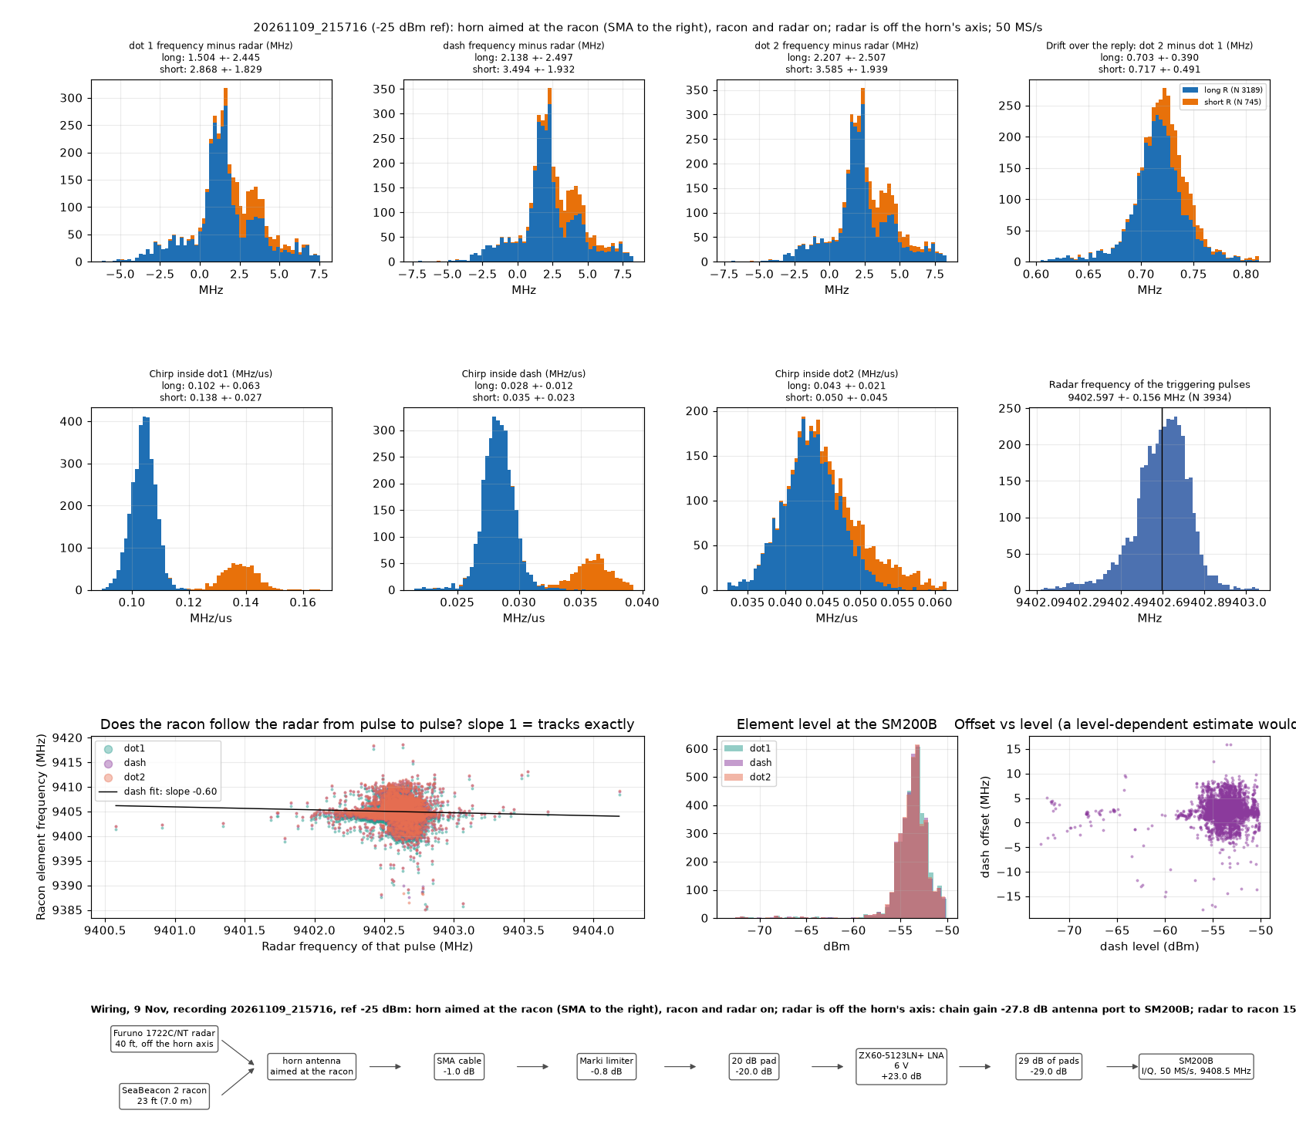
phase_detector_calibration/site/img/stats_20261109_215716_freq.png
