Sorin-Jayaweera/Panthalassa-Clinic-Team/phase_detector_calibration/site/img/stats_20261109_215716_table.png

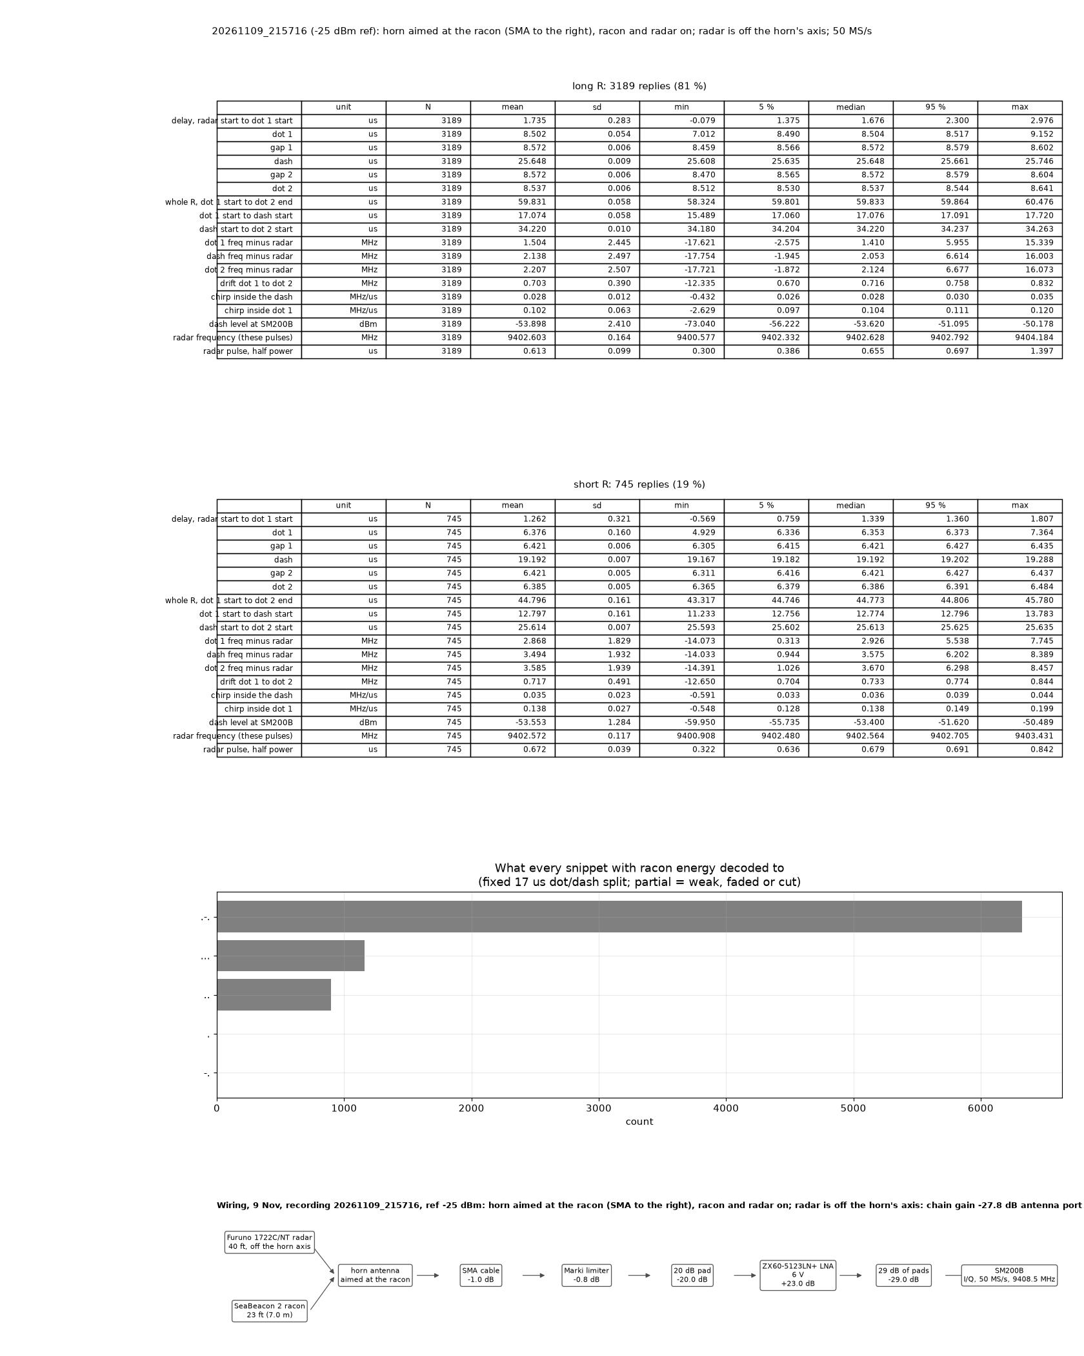
phase_detector_calibration/site/img/stats_20261109_215716_table.png
