Sorin-Jayaweera/Panthalassa-Clinic-Team/phase_detector_calibration/site/img/stats_20261109_215716_vs_time.png

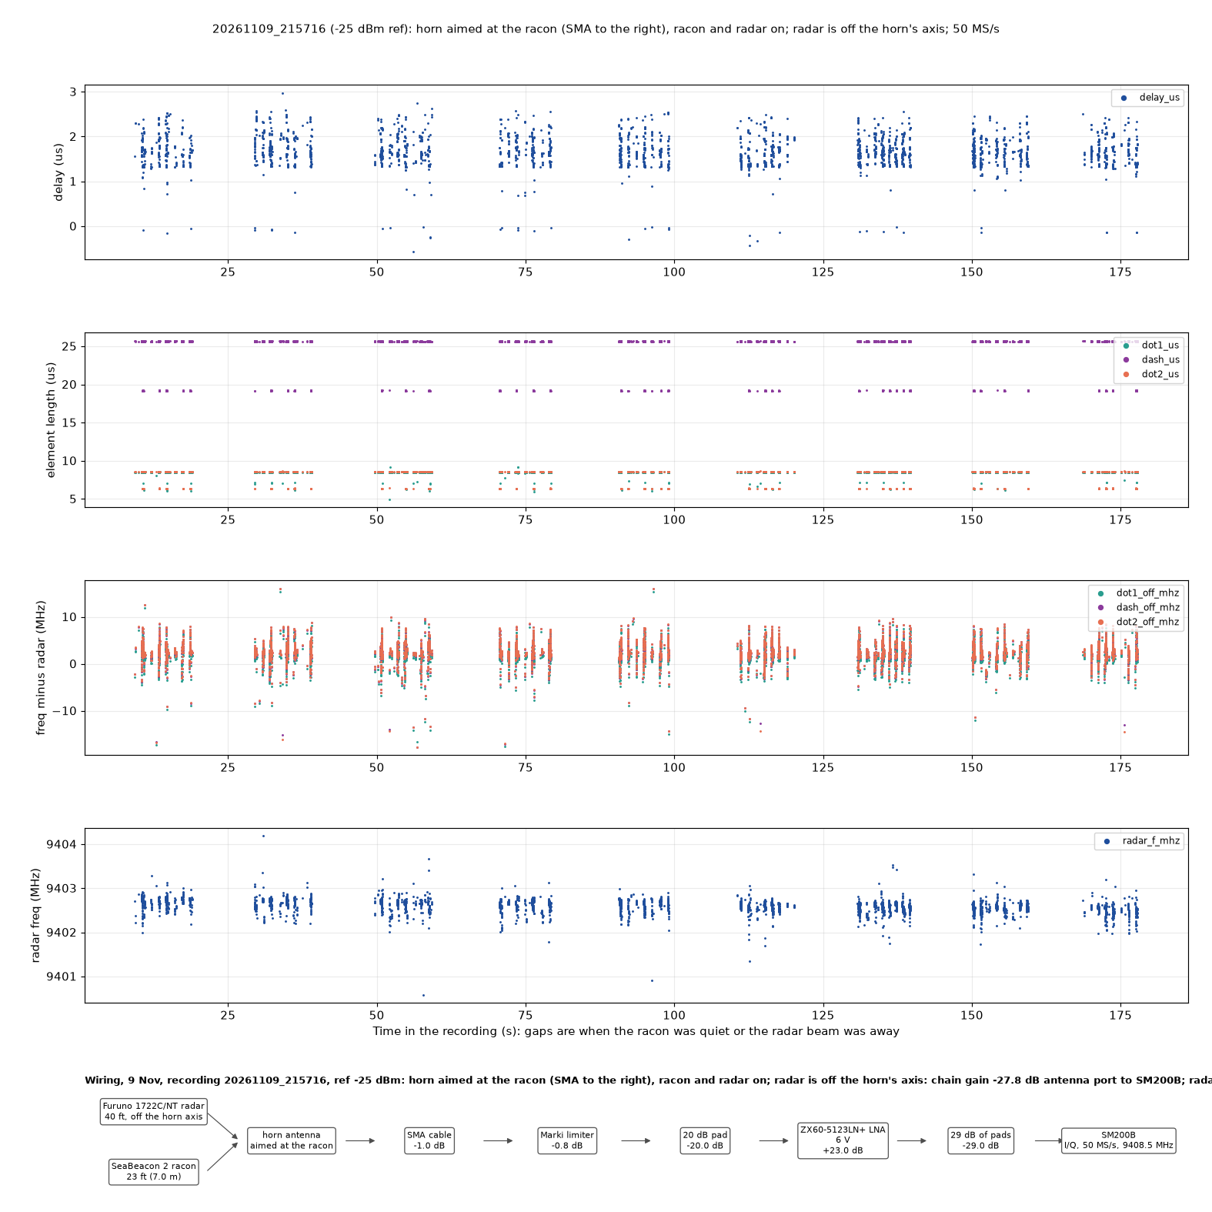
phase_detector_calibration/site/img/stats_20261109_215716_vs_time.png
