Sorin-Jayaweera/Panthalassa-Clinic-Team/phase_detector_calibration/site/img/stats_seg_horn_racon_250M_morse_timing_long.png

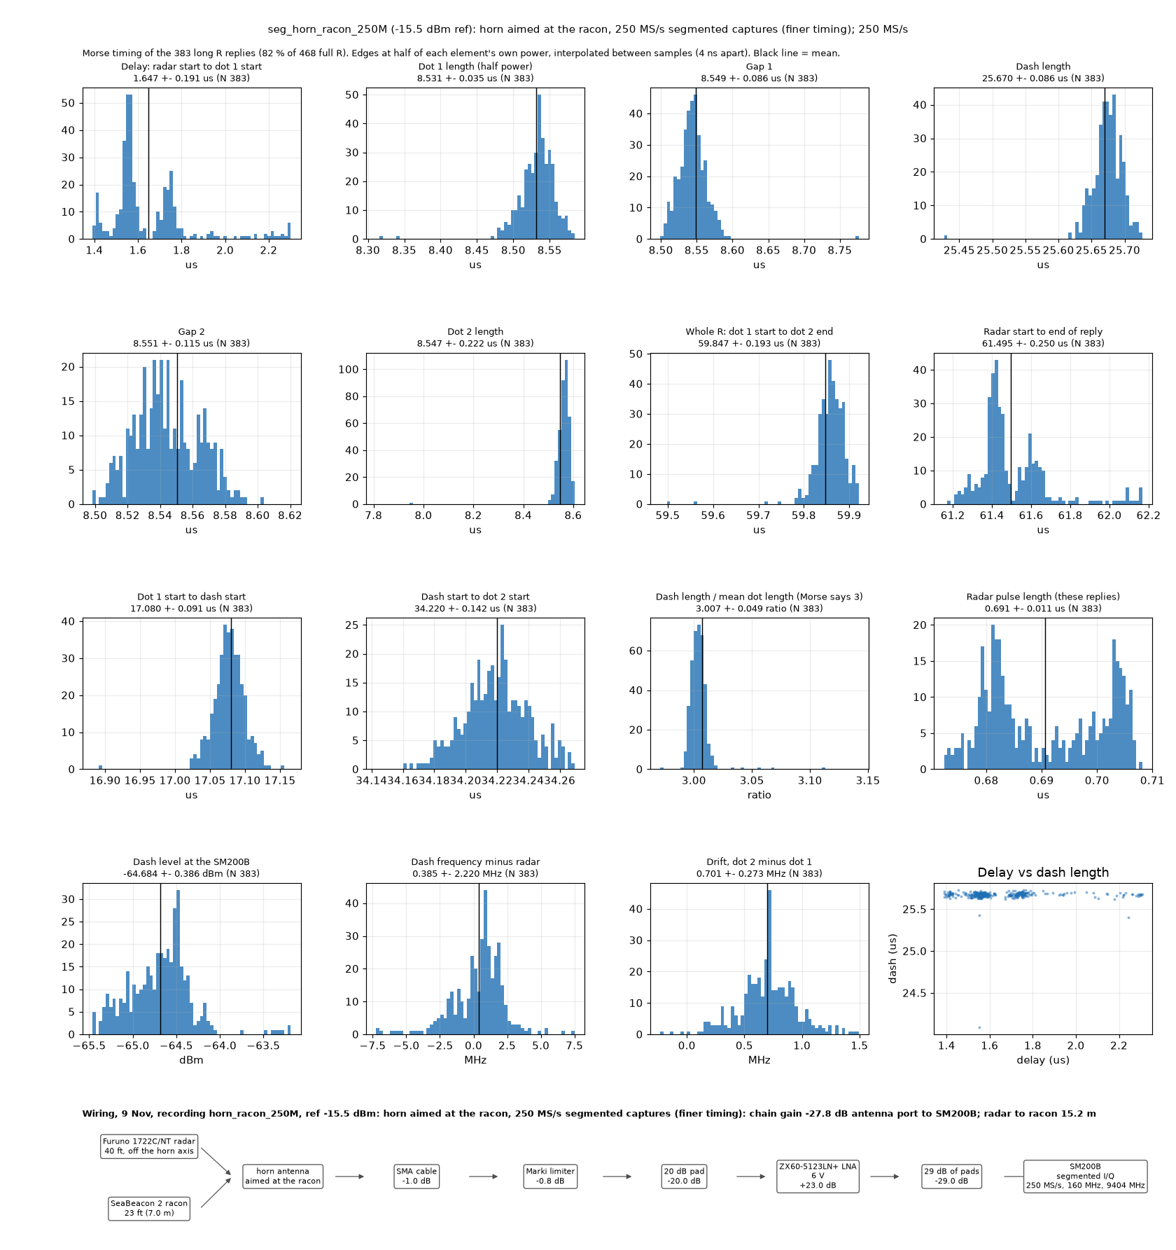
phase_detector_calibration/site/img/stats_seg_horn_racon_250M_morse_timing_long.png
