Sorin-Jayaweera/Panthalassa-Clinic-Team/phase_detector_calibration/site/img/vna_pad3dB_S21_10dBdiv.png

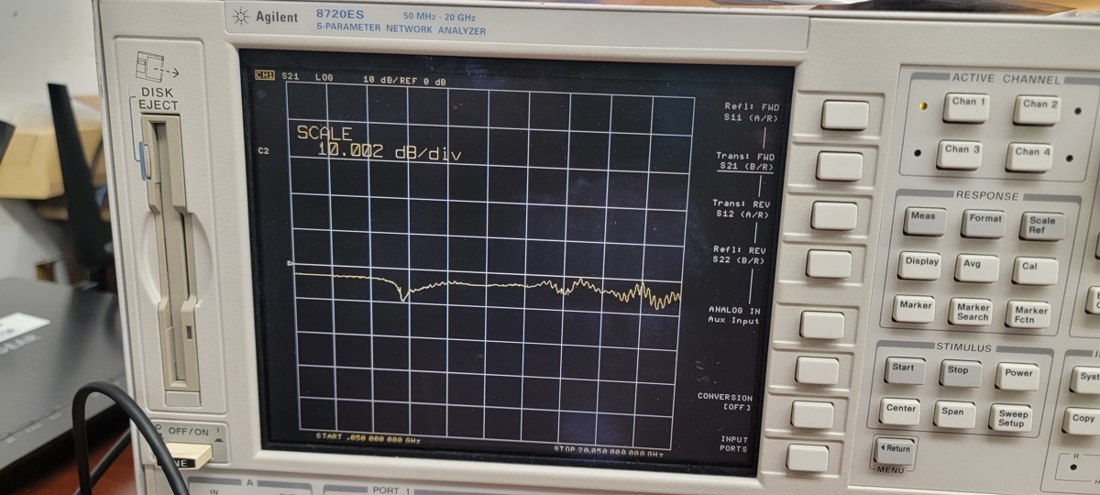
phase_detector_calibration/site/img/vna_pad3dB_S21_10dBdiv.png
