Sorin-Jayaweera/Panthalassa-Clinic-Team/phase_detector_calibration/site/img/vna_pad3dB_sweep2_S21_markers.png

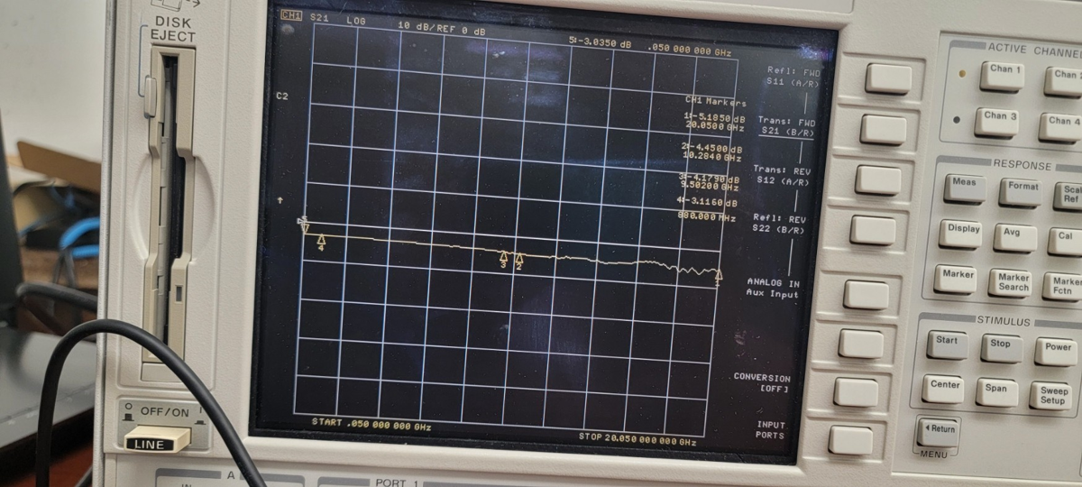
phase_detector_calibration/site/img/vna_pad3dB_sweep2_S21_markers.png
