Sorin-Jayaweera/Panthalassa-Clinic-Team/phase_detector_calibration/site/img/vna_pad3dB_sweep3_S22_markers.png

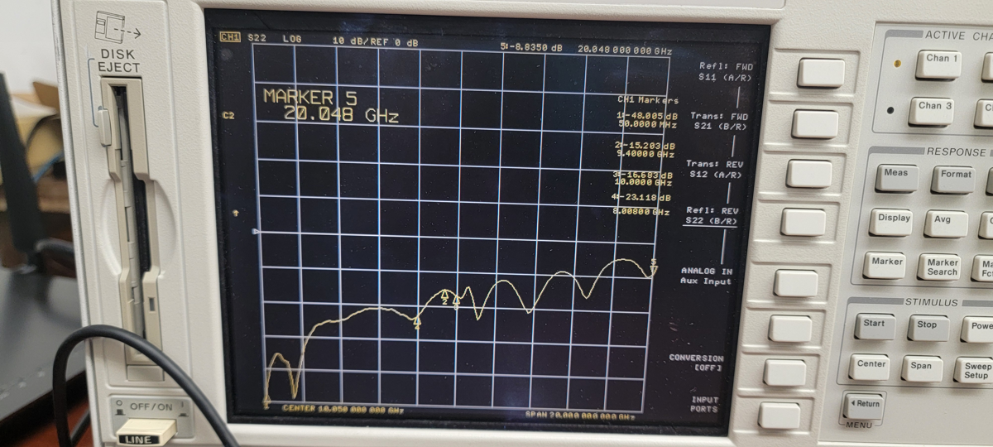
phase_detector_calibration/site/img/vna_pad3dB_sweep3_S22_markers.png
