Sorin-Jayaweera/Panthalassa-Clinic-Team/phase_detector_calibration/site/img/vna_pad6dB_S12_markers.png

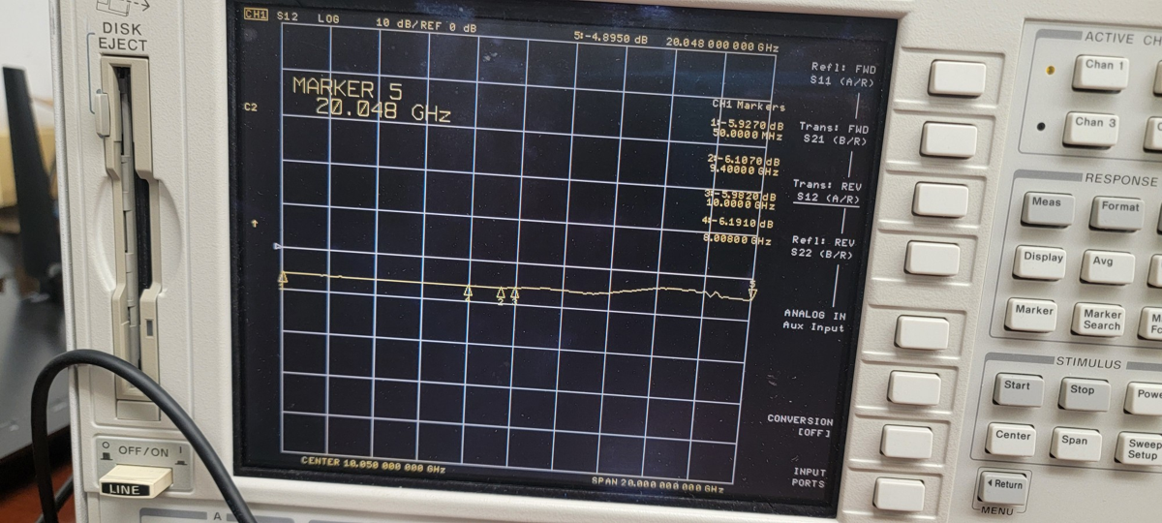
phase_detector_calibration/site/img/vna_pad6dB_S12_markers.png
