Sorin-Jayaweera/Panthalassa-Clinic-Team/phase_detector_calibration/site/img/vna_vivaldi_S11_absolute.png

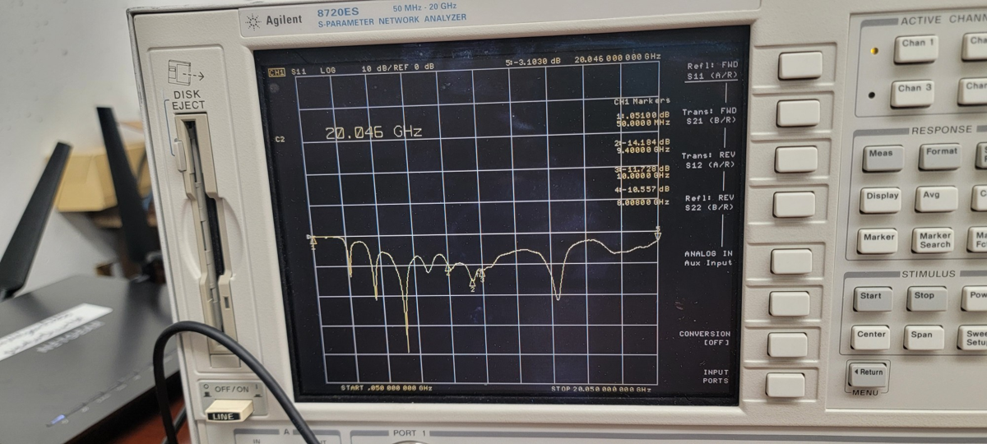
phase_detector_calibration/site/img/vna_vivaldi_S11_absolute.png
