Sorin-Jayaweera/Panthalassa-Clinic-Team/pluto_characterization/pluto_if_band.png

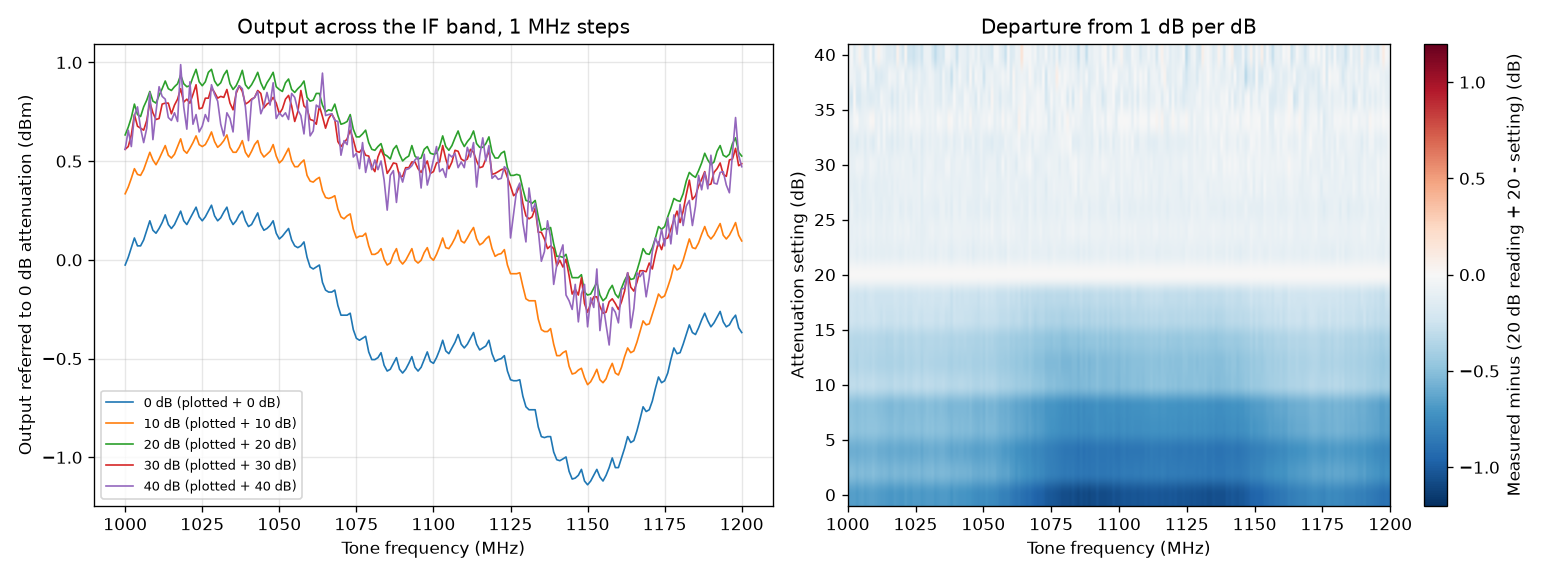
pluto_characterization/pluto_if_band.png
