Sorin-Jayaweera/Panthalassa-Clinic-Team/pluto_characterization/pluto_leak.png

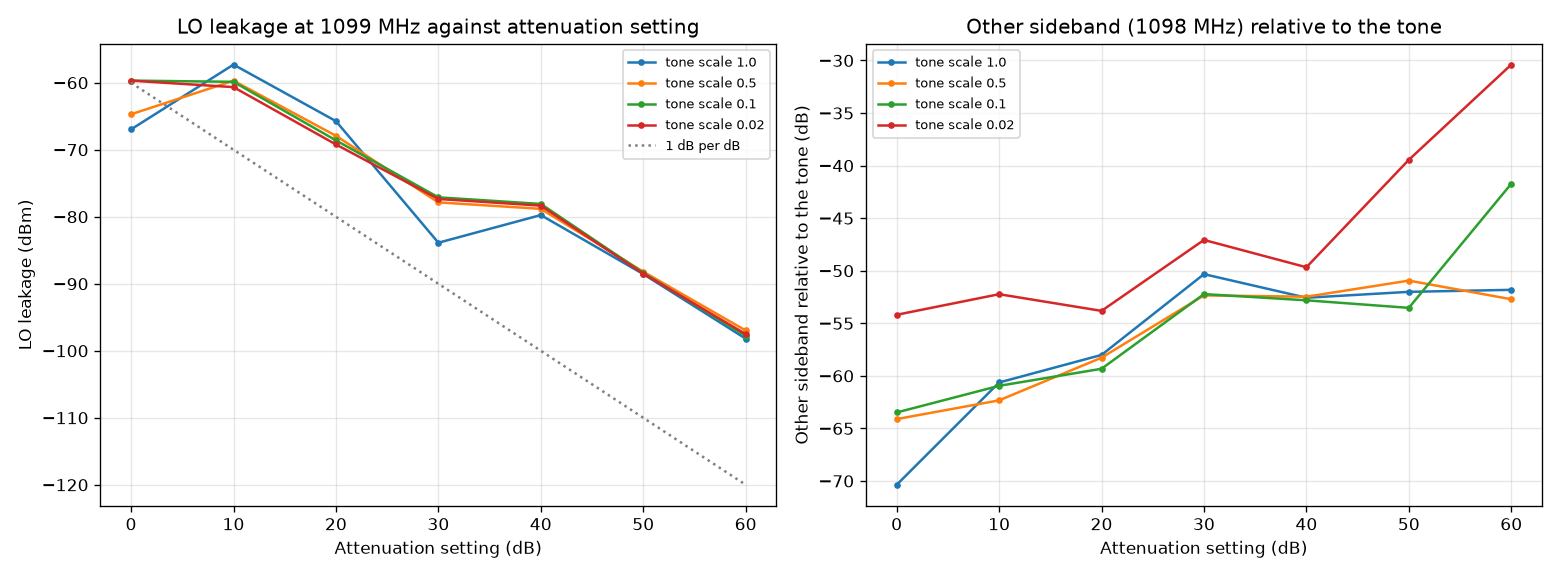
pluto_characterization/pluto_leak.png
