Sorin-Jayaweera/Panthalassa-Clinic-Team/pluto_characterization/pluto_map.png

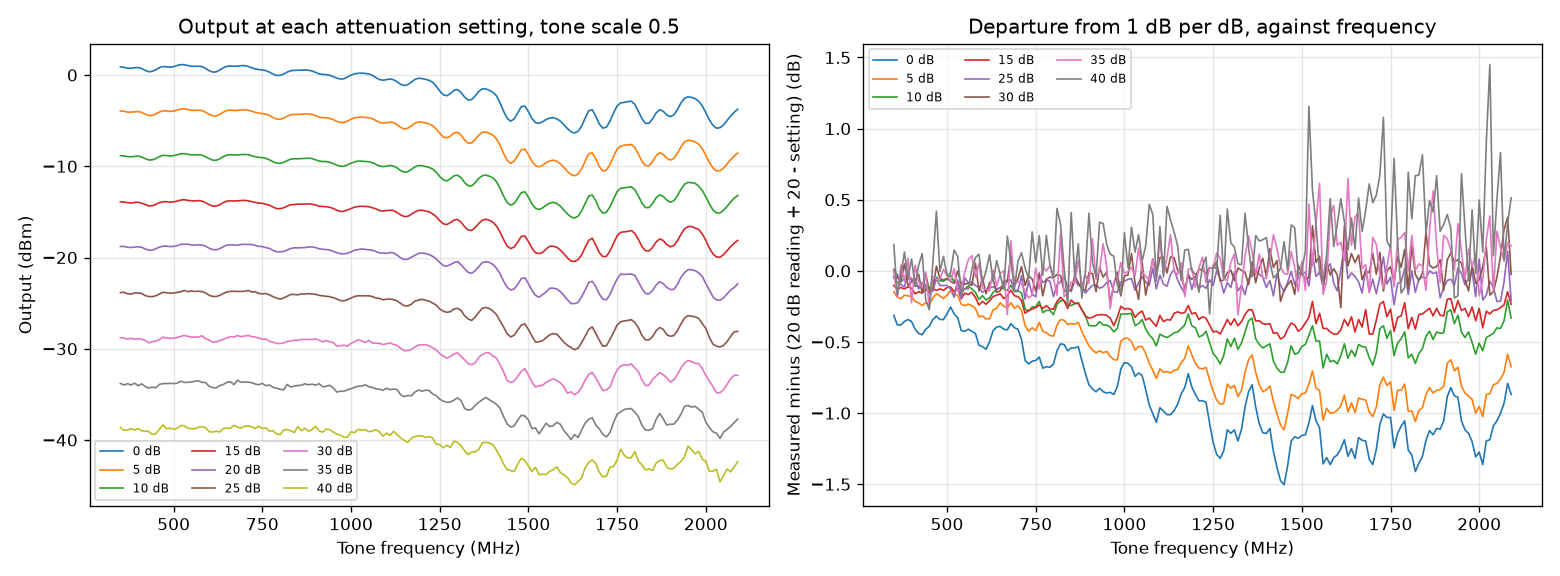
pluto_characterization/pluto_map.png
