Sorin-Jayaweera/Panthalassa-Clinic-Team/pluto_characterization/pluto_map_scale1.png

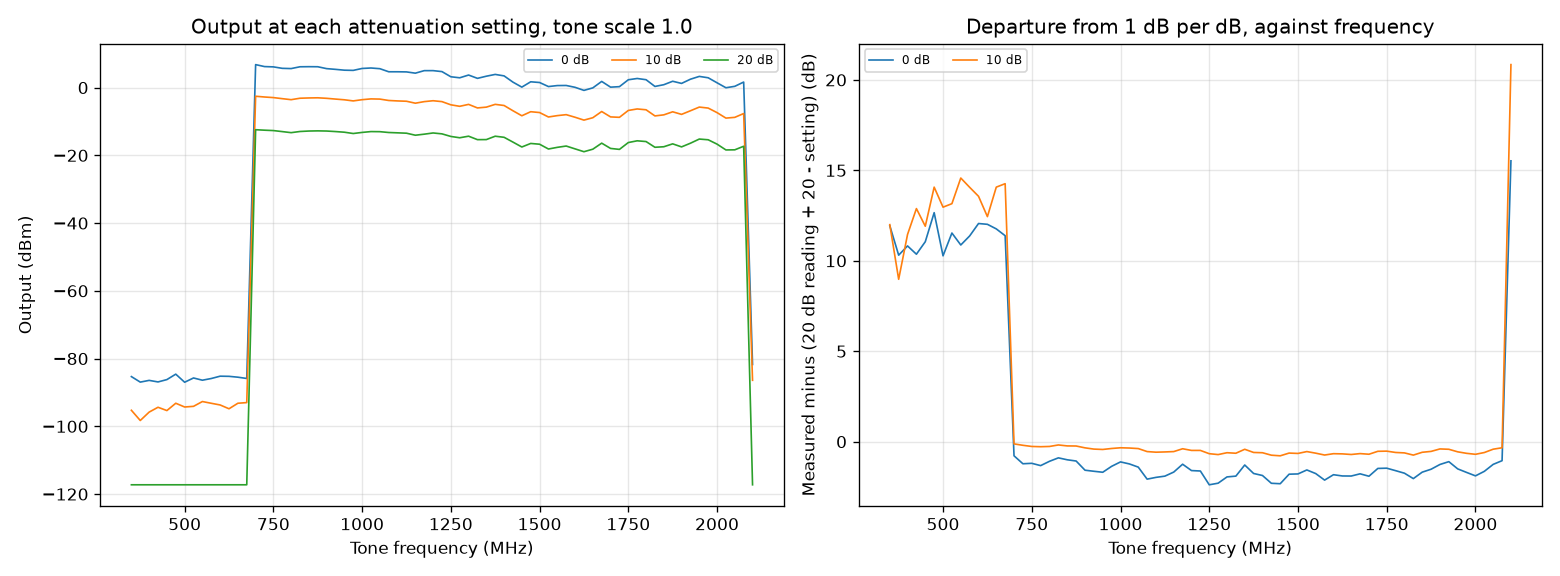
pluto_characterization/pluto_map_scale1.png
