Sorin-Jayaweera/Panthalassa-Clinic-Team/pluto_characterization/pluto_offset.png

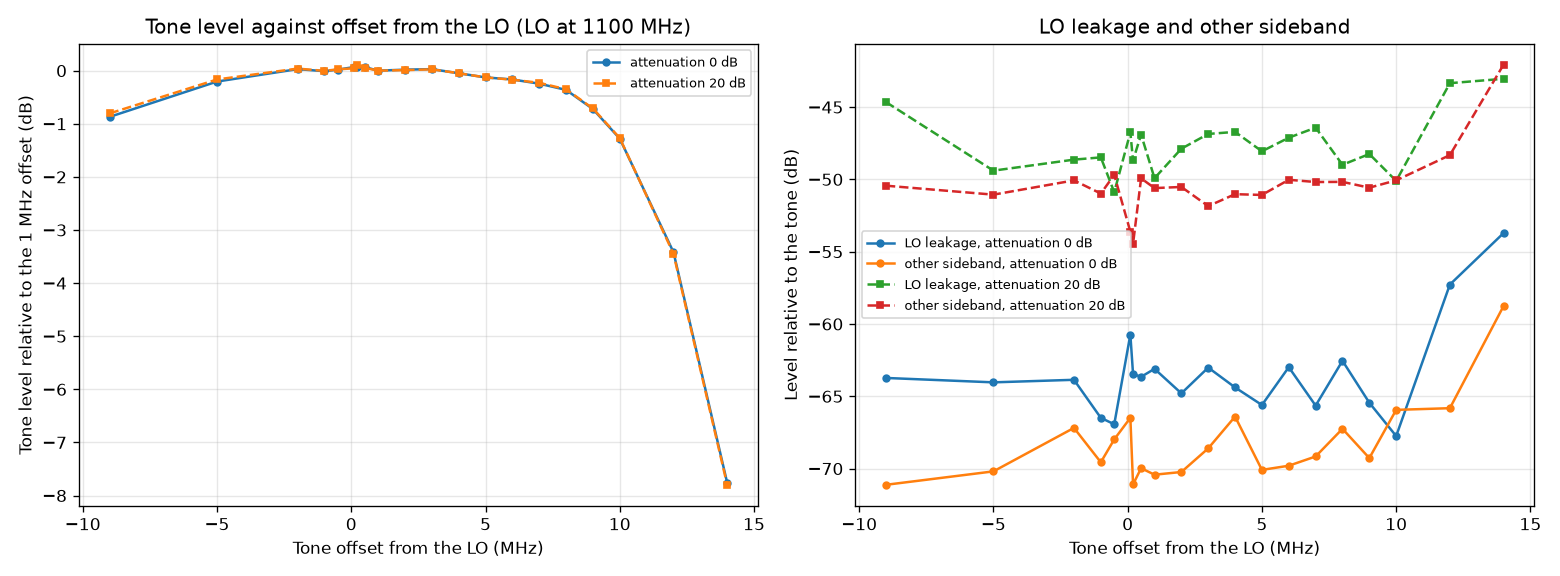
pluto_characterization/pluto_offset.png
