Sorin-Jayaweera/Panthalassa-Clinic-Team/pluto_characterization/pluto_scale_all.png

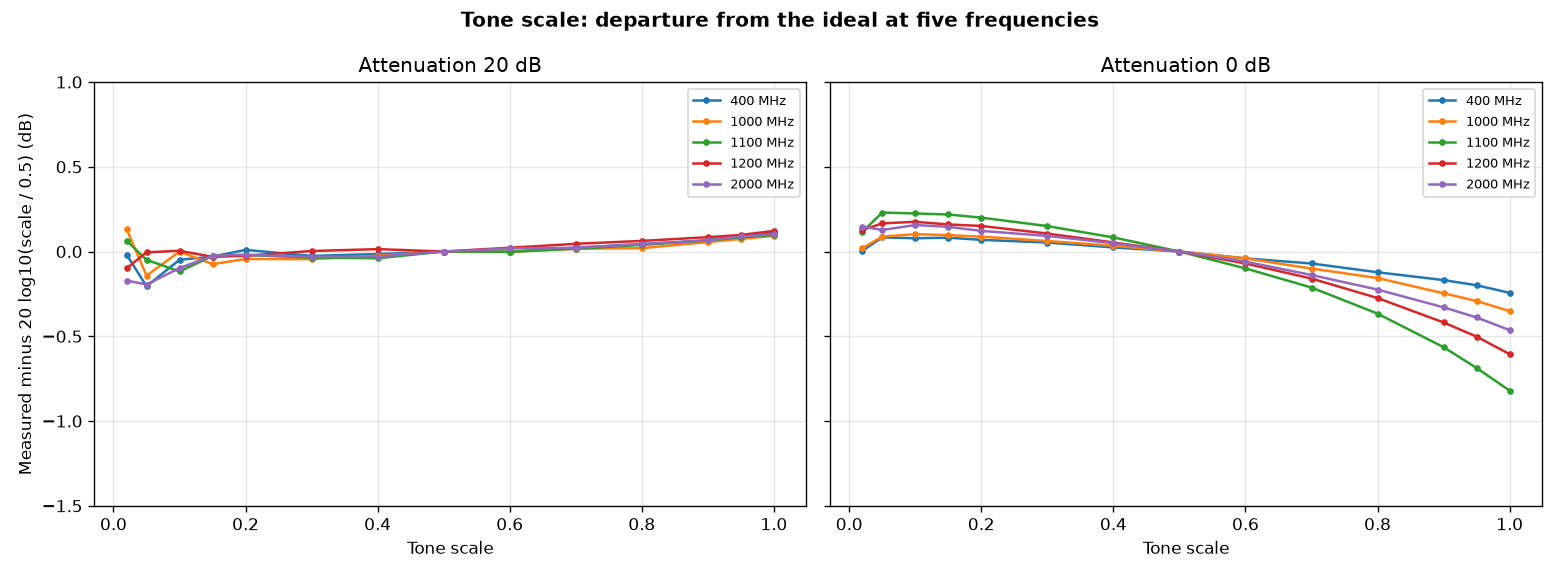
pluto_characterization/pluto_scale_all.png
