Sorin-Jayaweera/Panthalassa-Clinic-Team/pluto_characterization/pluto_tone_scale.png

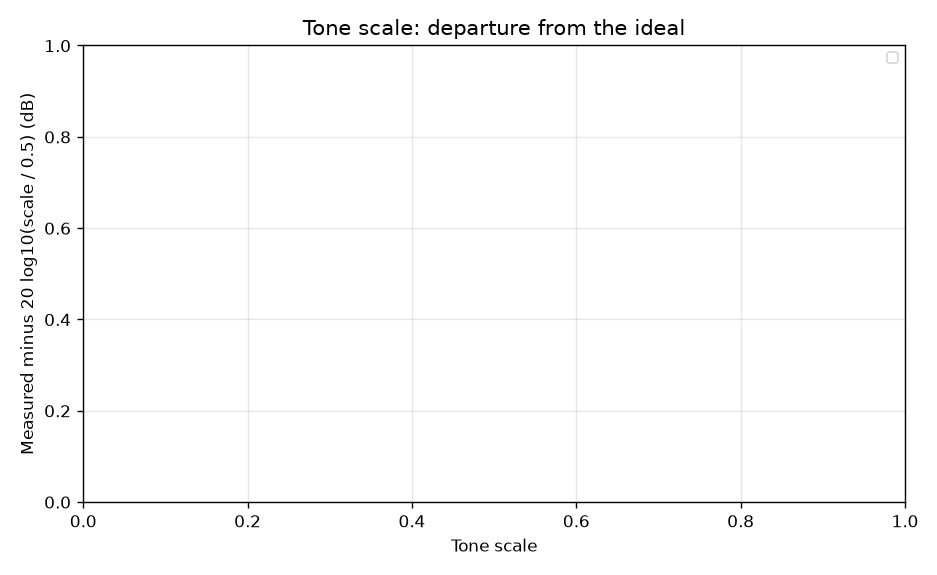
pluto_characterization/pluto_tone_scale.png
