Sorin-Jayaweera/Panthalassa-Clinic-Team/radar_test/plots/beam.png

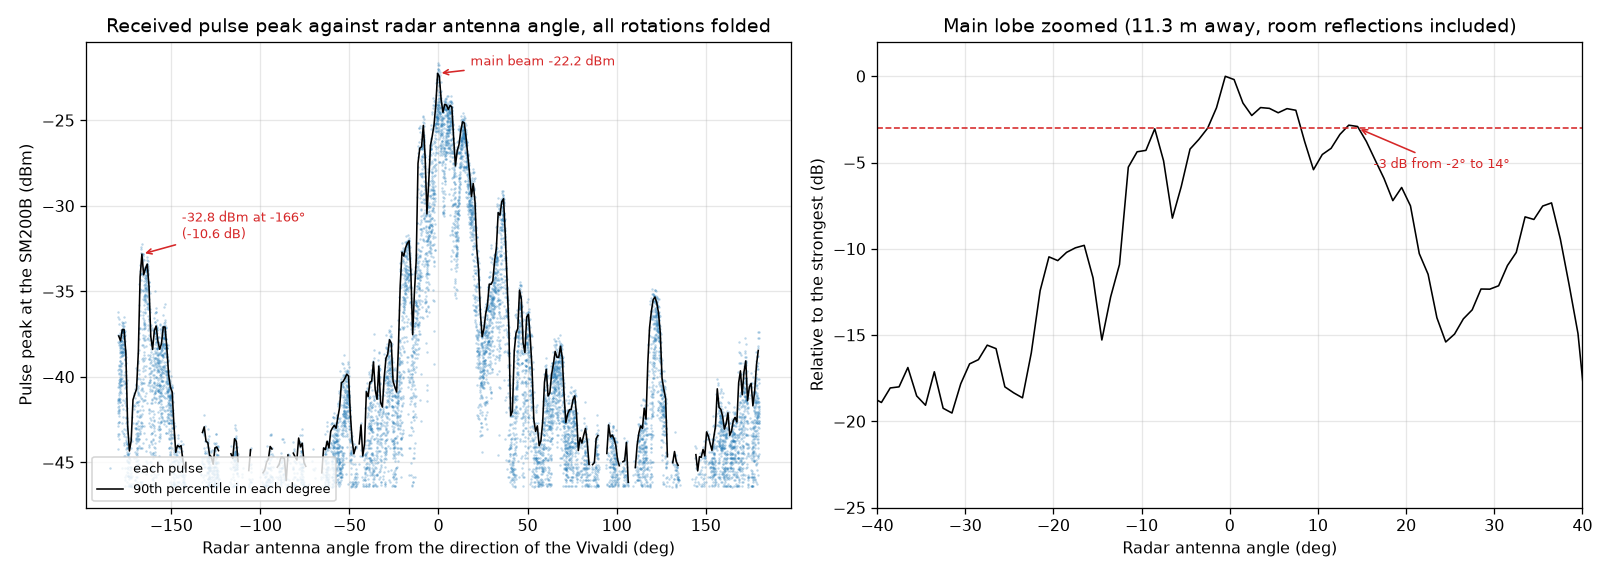
radar_test/plots/beam.png
