Sorin-Jayaweera/Panthalassa-Clinic-Team/radar_test/plots/fft_pulse.png

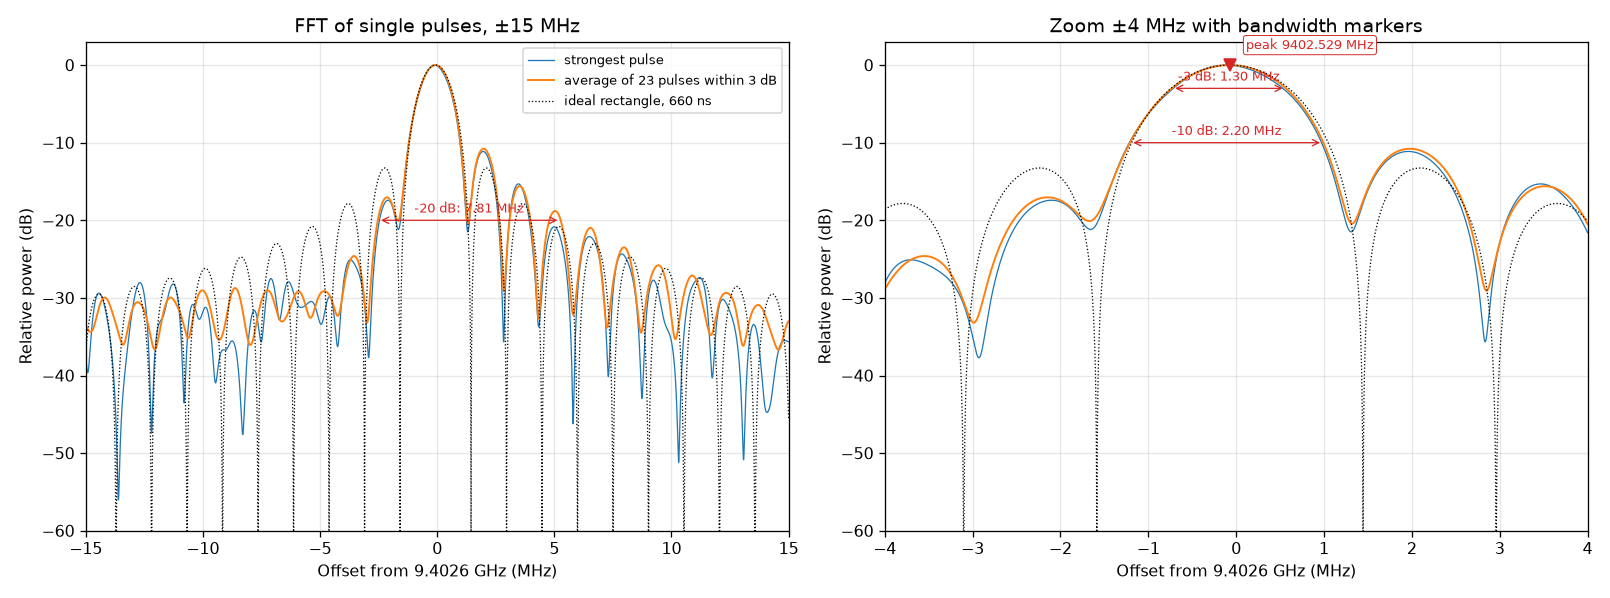
radar_test/plots/fft_pulse.png
