Sorin-Jayaweera/Panthalassa-Clinic-Team/radar_test/pulses_20261025_163509_dec8/pulses.png

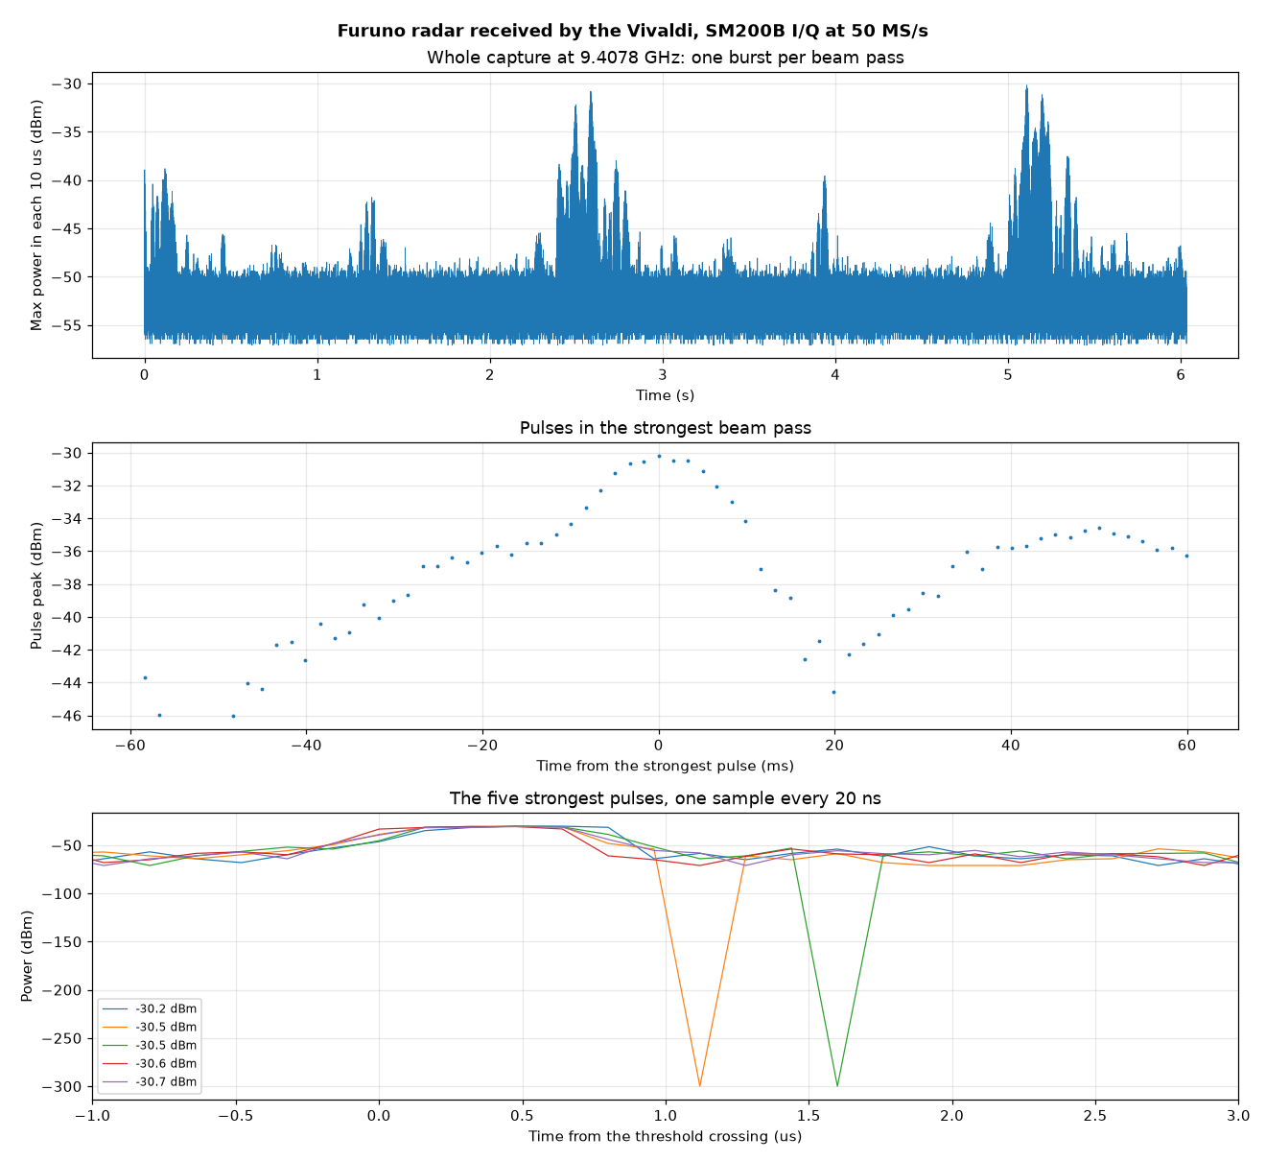
radar_test/pulses_20261025_163509_dec8/pulses.png
