Sorin-Jayaweera/Panthalassa-Clinic-Team/radar_test/racon/plots/racon_all_hist.png

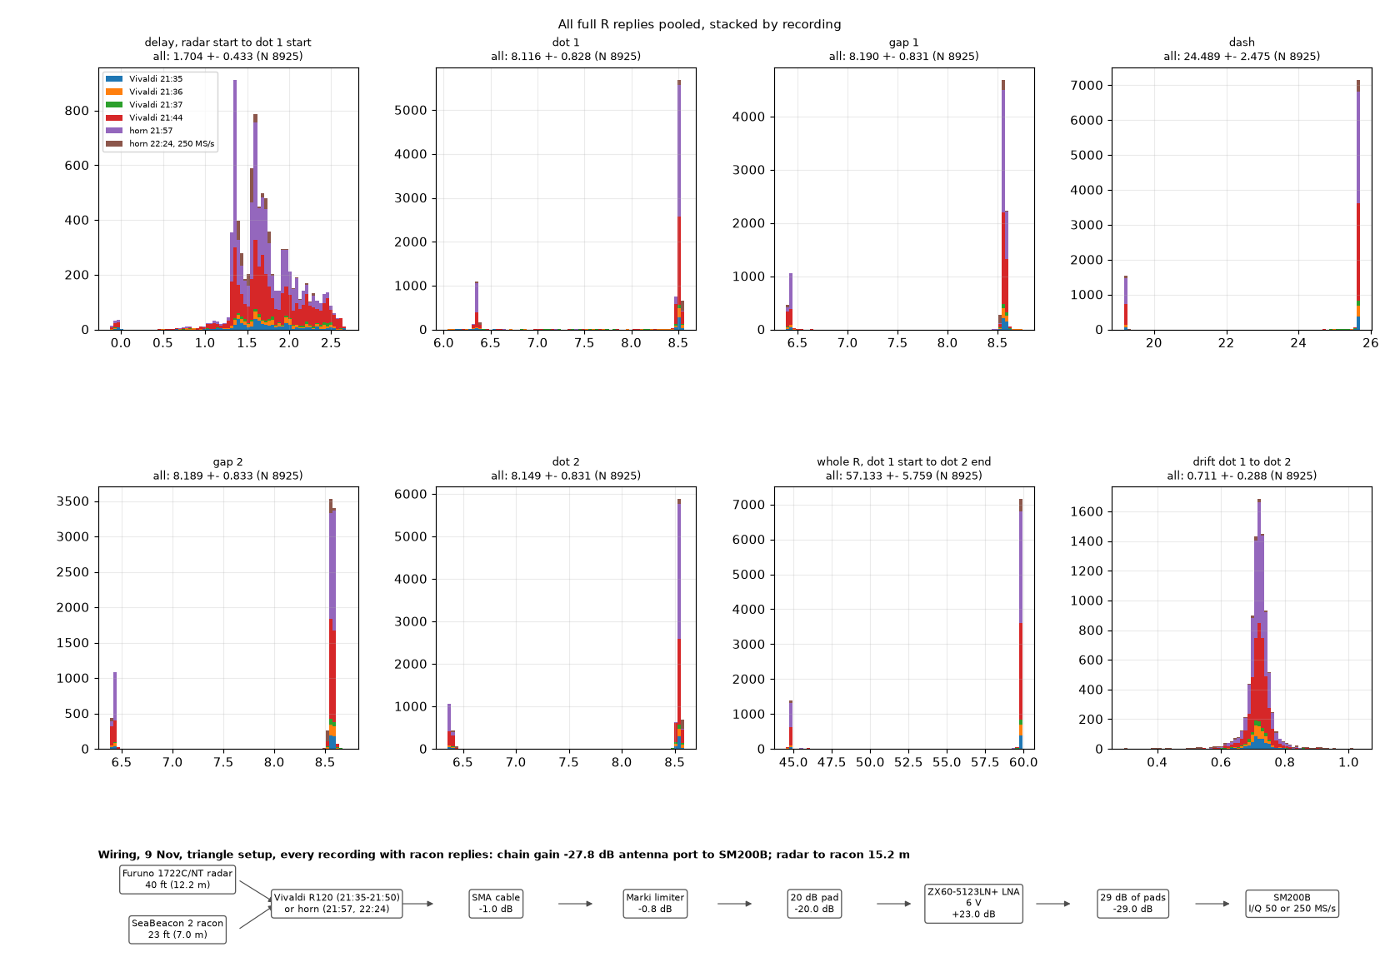
radar_test/racon/plots/racon_all_hist.png
