Sorin-Jayaweera/Panthalassa-Clinic-Team/radar_test/racon/plots/racon_fig1_durations.png

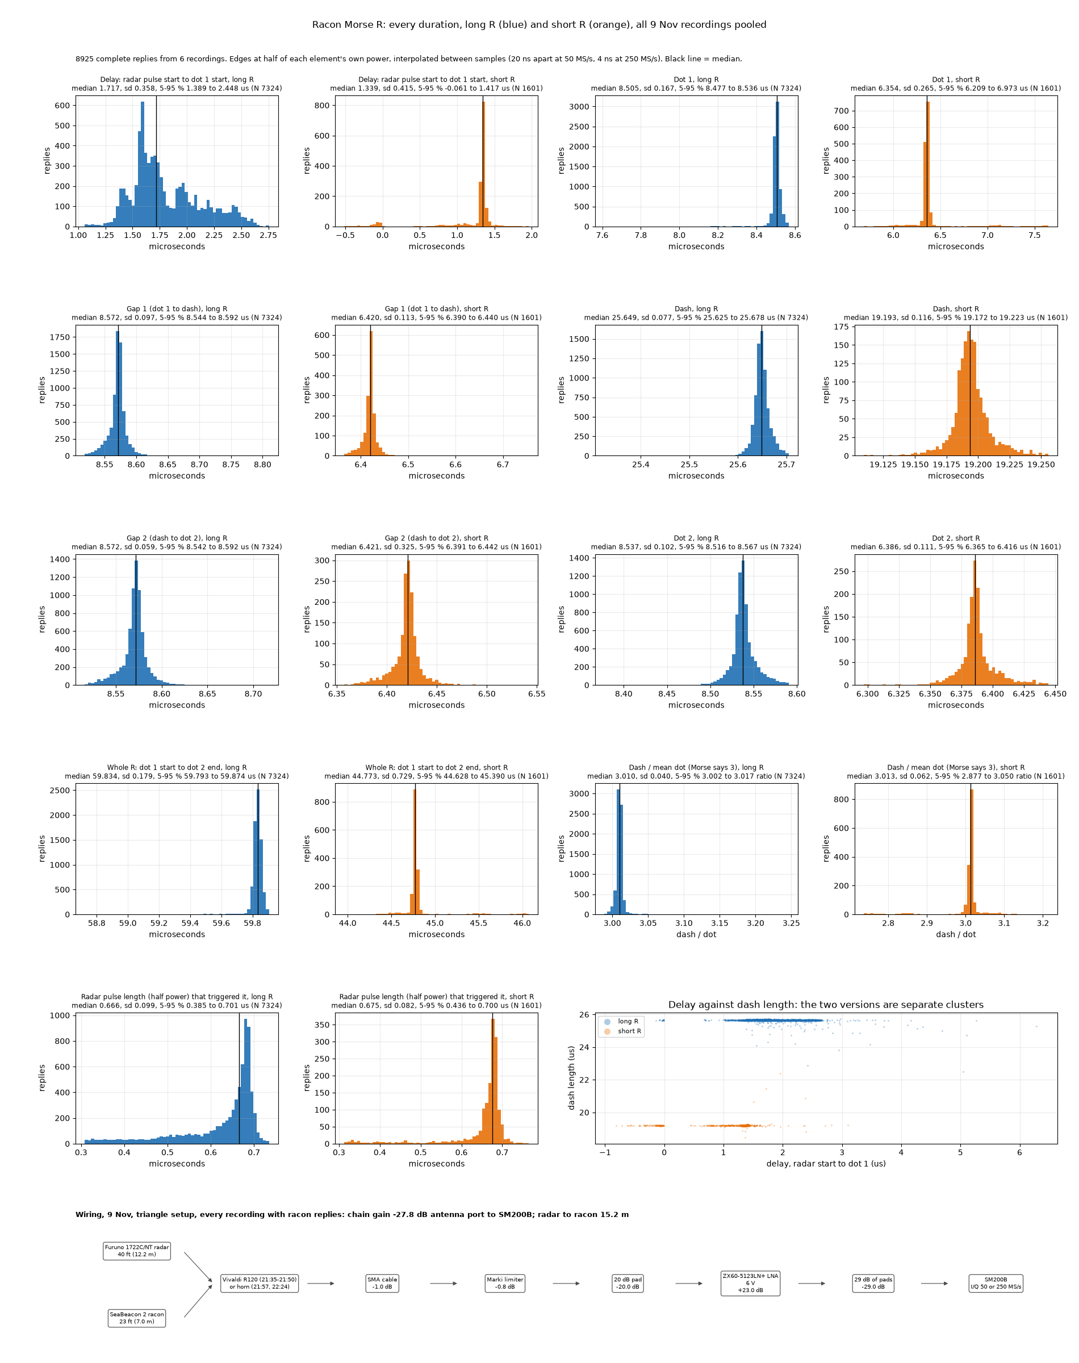
radar_test/racon/plots/racon_fig1_durations.png
