Sorin-Jayaweera/Panthalassa-Clinic-Team/radar_test/racon/plots/racon_fig3_frequency.png

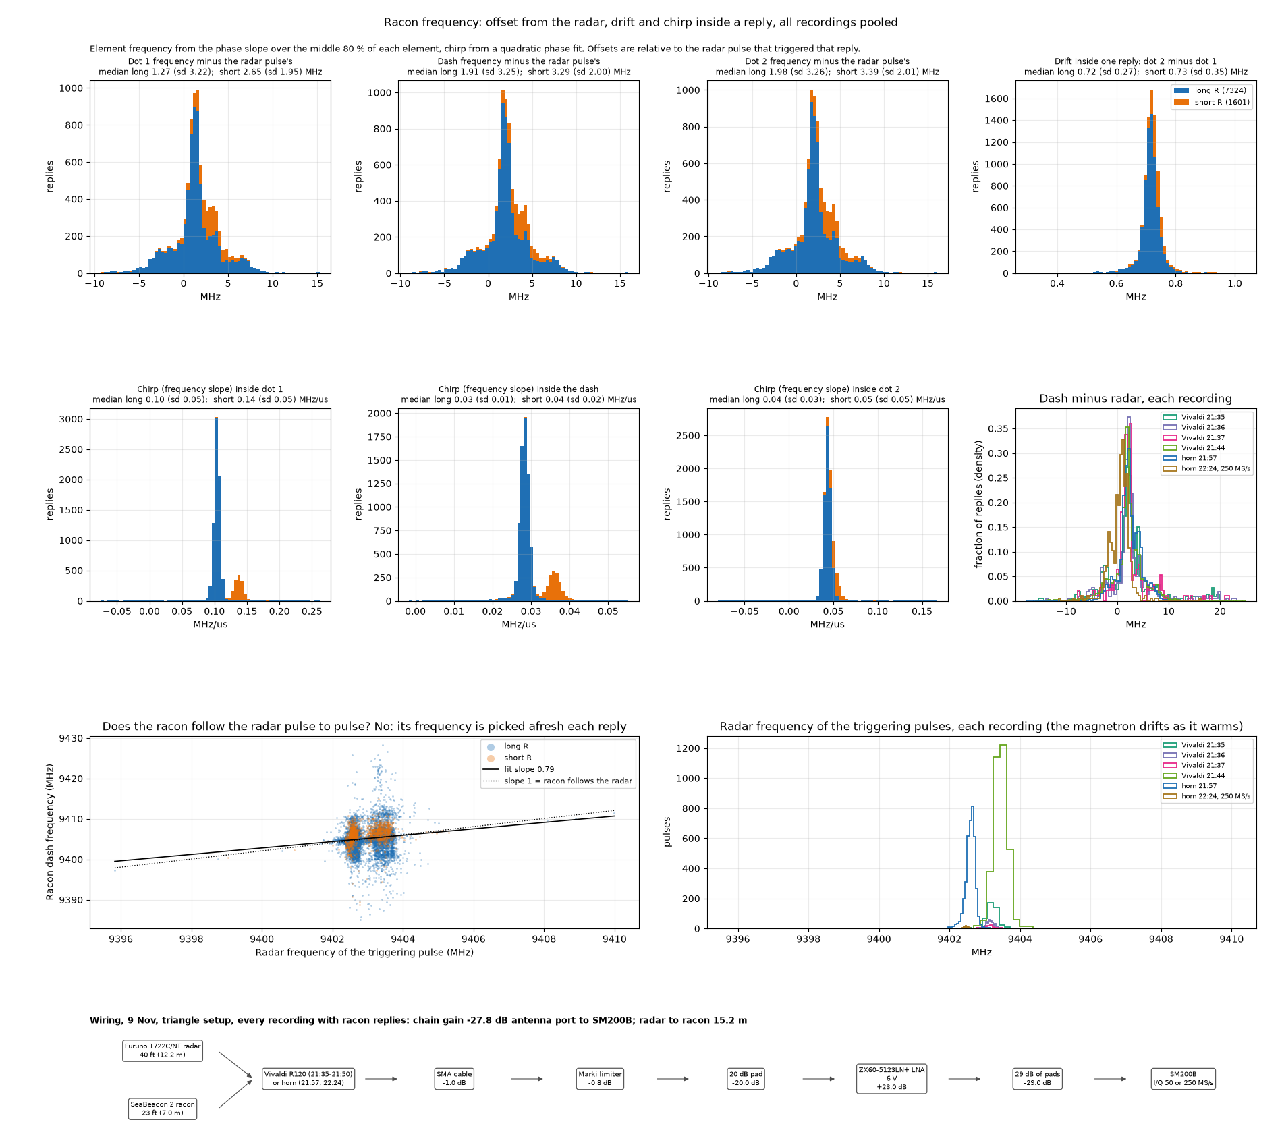
radar_test/racon/plots/racon_fig3_frequency.png
