Sorin-Jayaweera/Panthalassa-Clinic-Team/radar_test/racon/plots/racon_fig4_levels.png

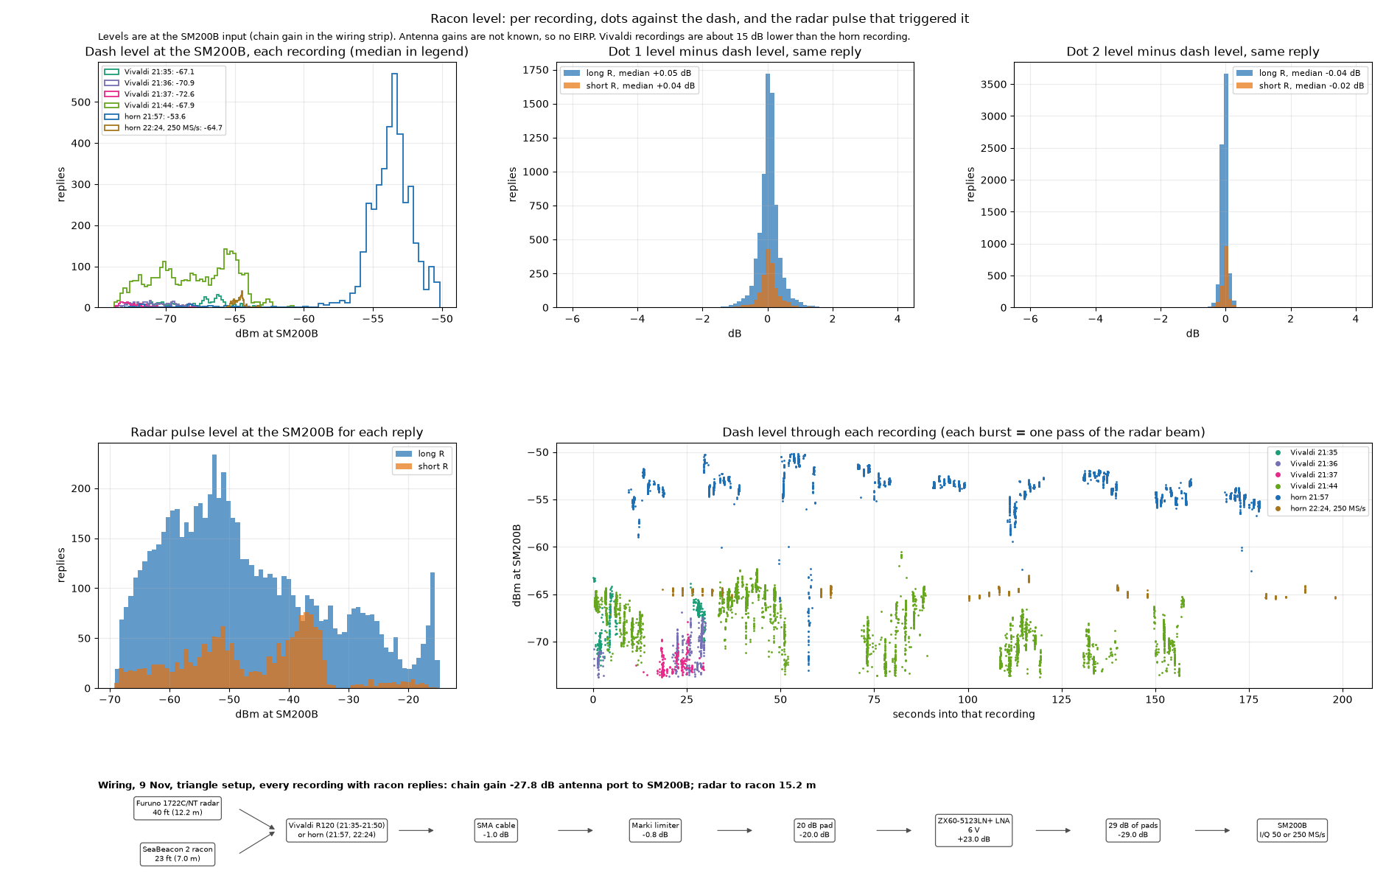
radar_test/racon/plots/racon_fig4_levels.png
