Sorin-Jayaweera/Panthalassa-Clinic-Team/radar_test/racon/plots/radar_all_9nov.png

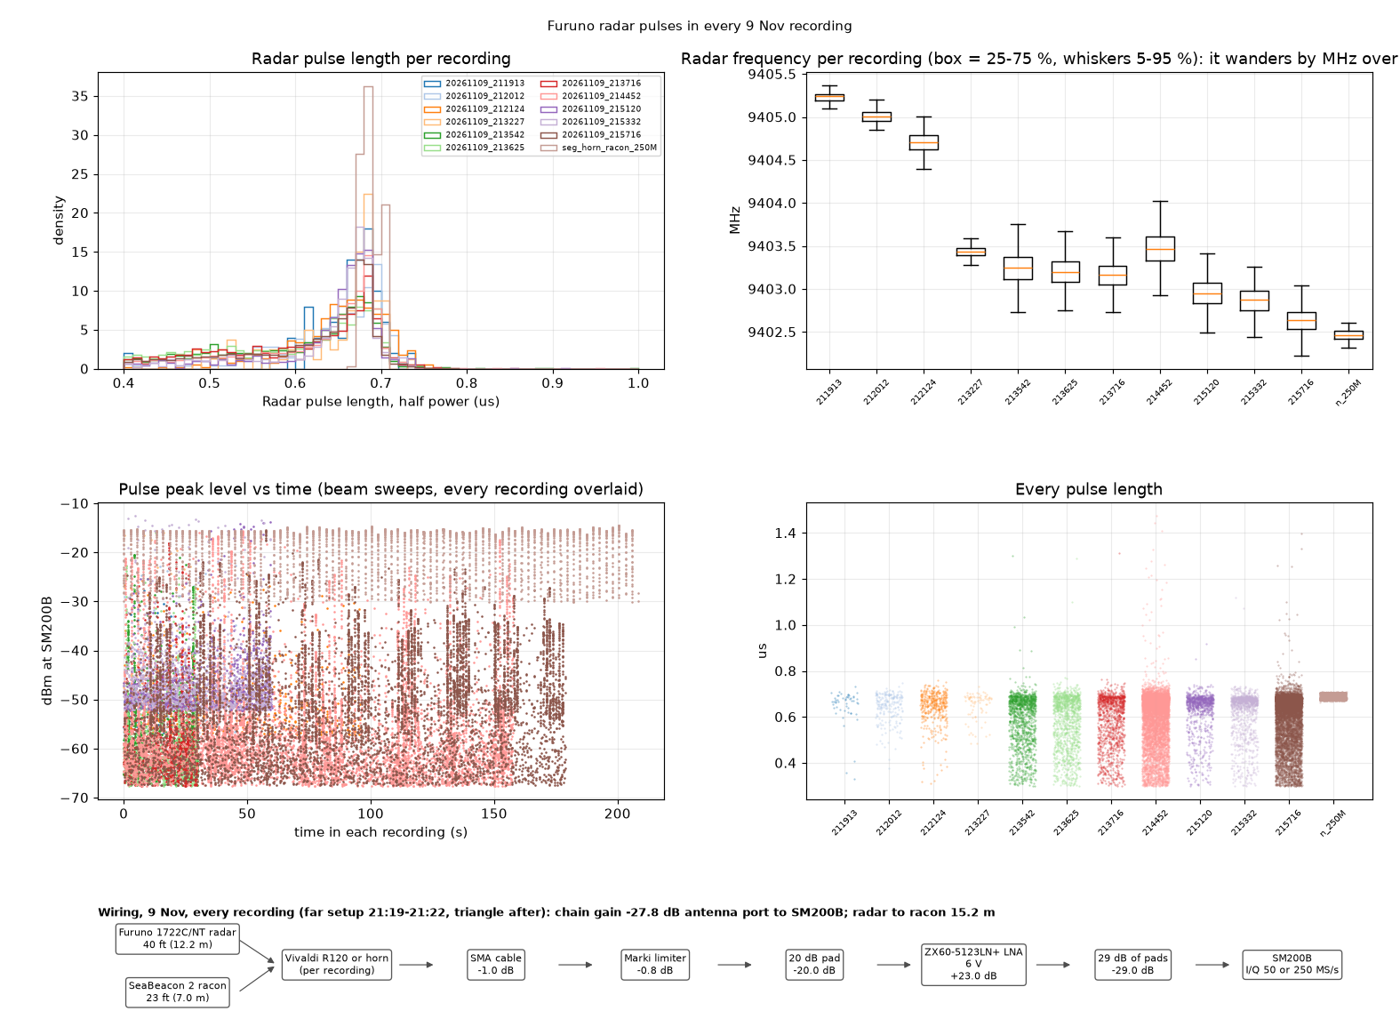
radar_test/racon/plots/radar_all_9nov.png
