Sorin-Jayaweera/Panthalassa-Clinic-Team/radar_test/racon/plots/raw_20261109_212012_chain.png

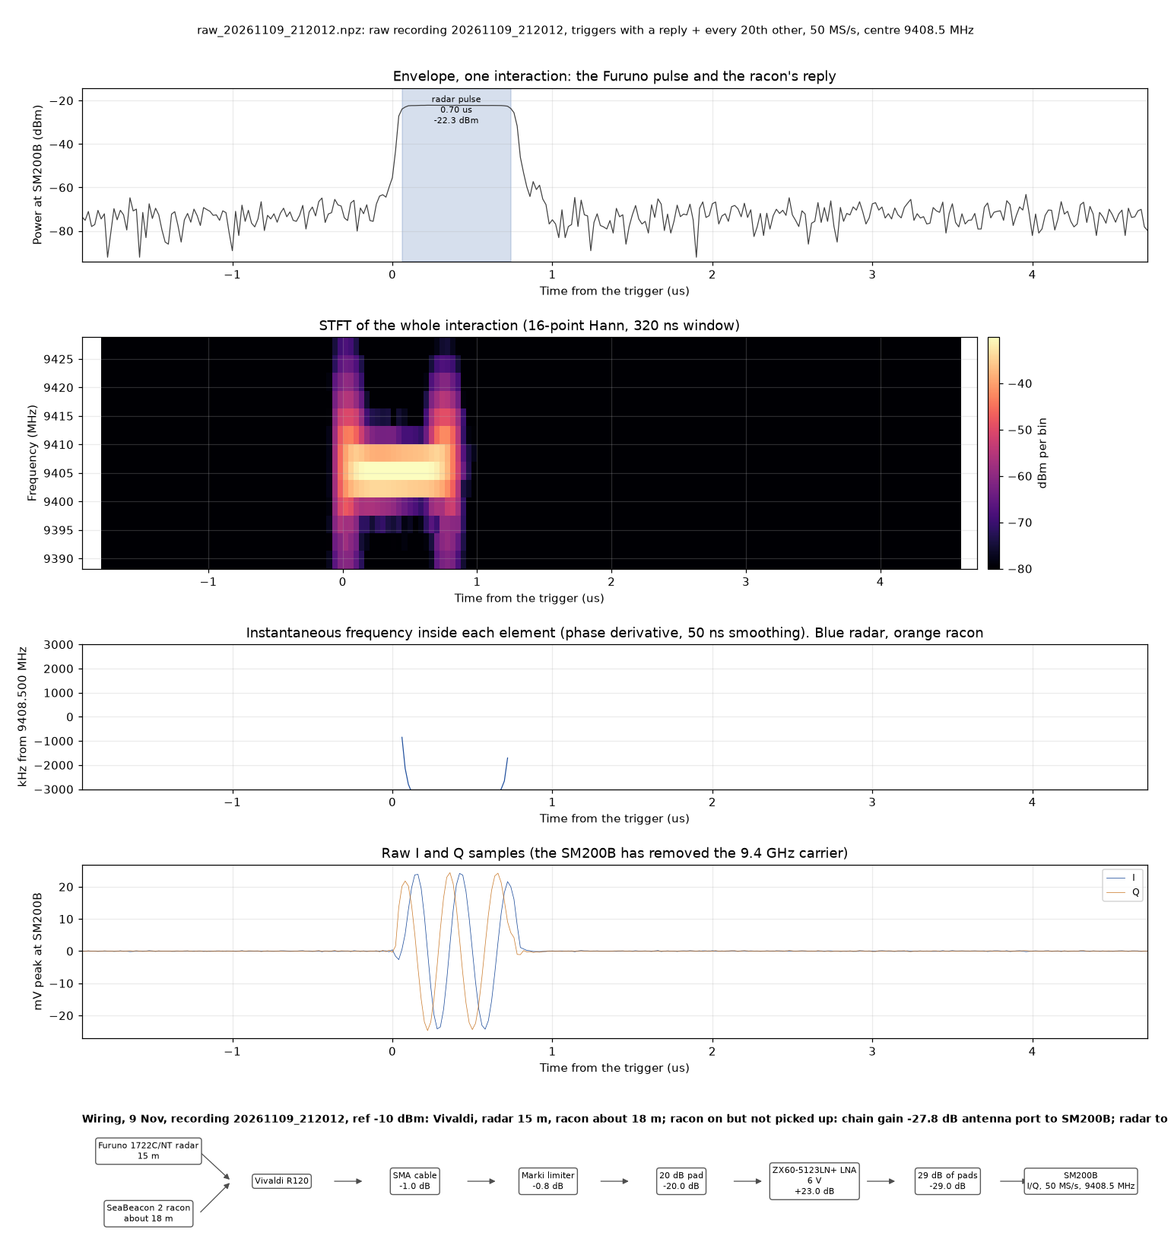
radar_test/racon/plots/raw_20261109_212012_chain.png
