Sorin-Jayaweera/Panthalassa-Clinic-Team/radar_test/racon/plots/raw_20261109_213227_after_pulse.png

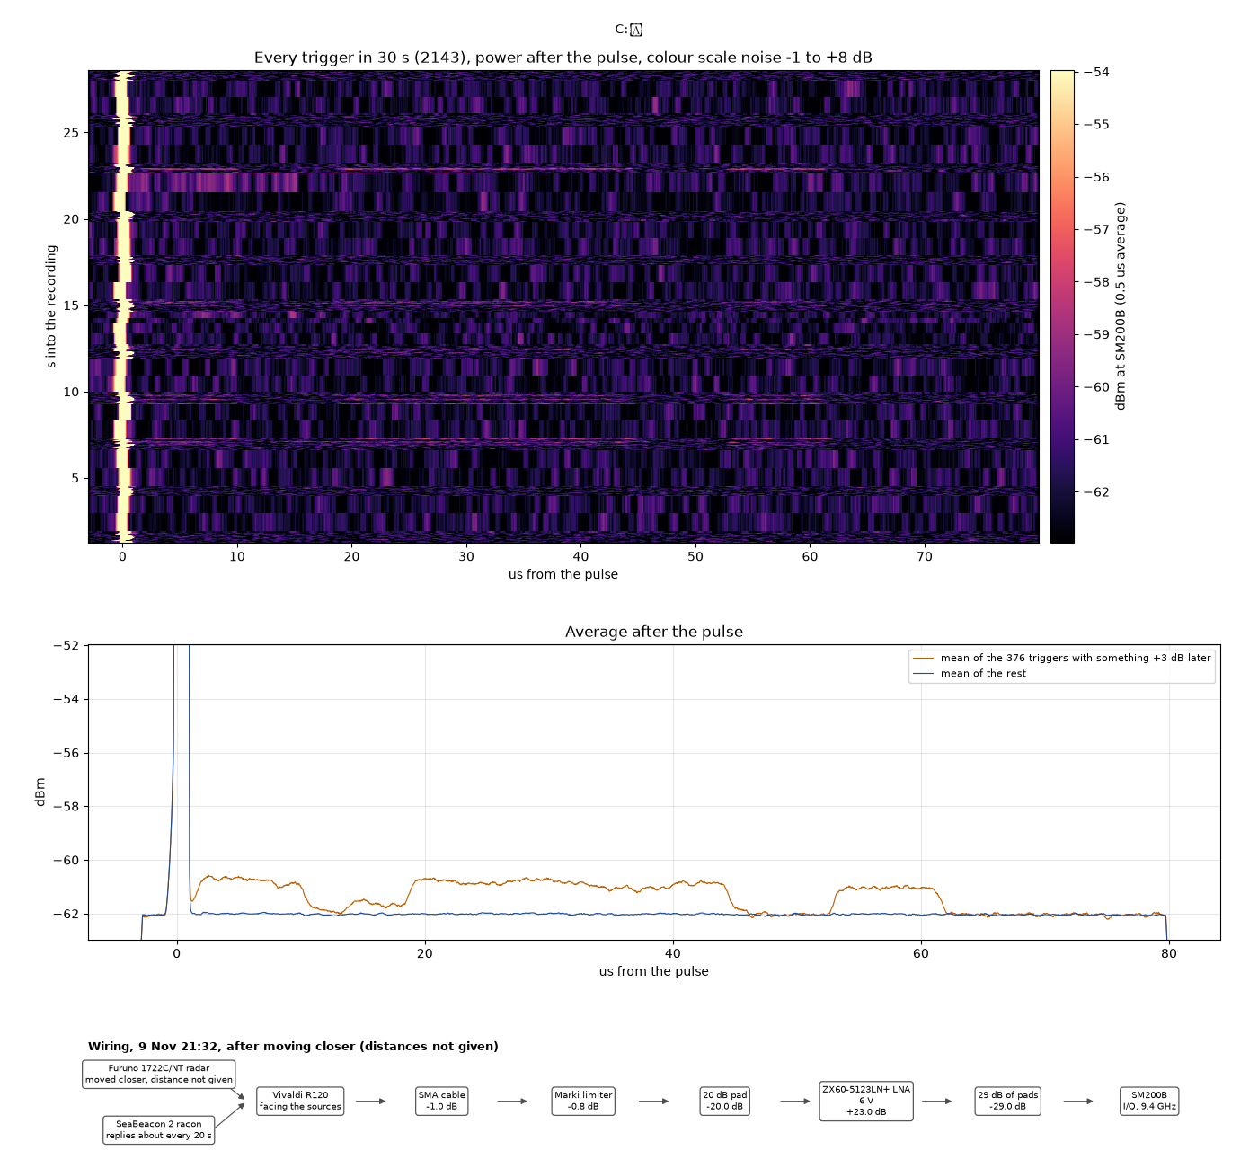
radar_test/racon/plots/raw_20261109_213227_after_pulse.png
