Sorin-Jayaweera/Panthalassa-Clinic-Team/radar_test/racon/plots/raw_20261109_213542_loudness.png

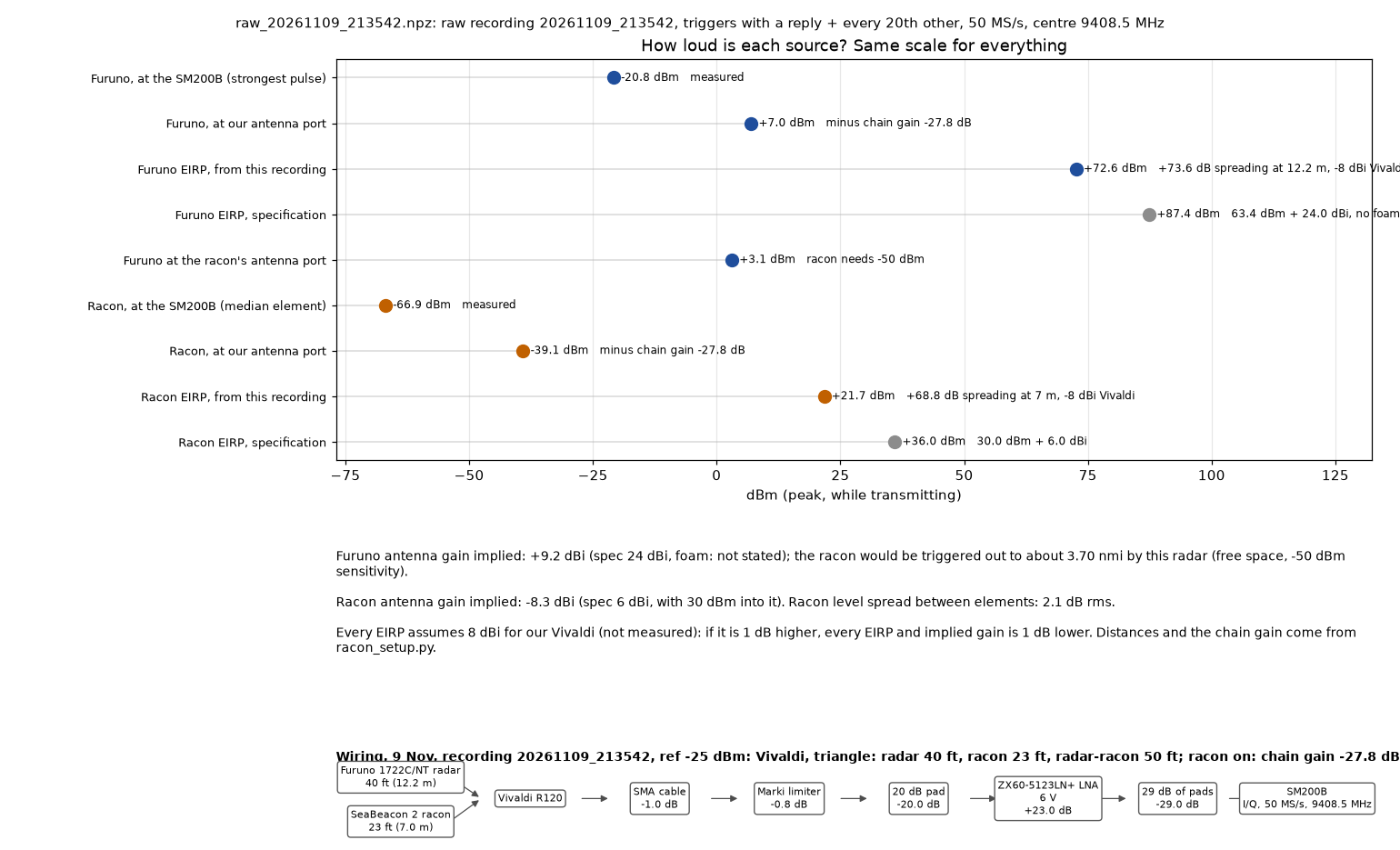
radar_test/racon/plots/raw_20261109_213542_loudness.png
