Sorin-Jayaweera/Panthalassa-Clinic-Team/radar_test/racon/plots/raw_20261109_213542_stats.png

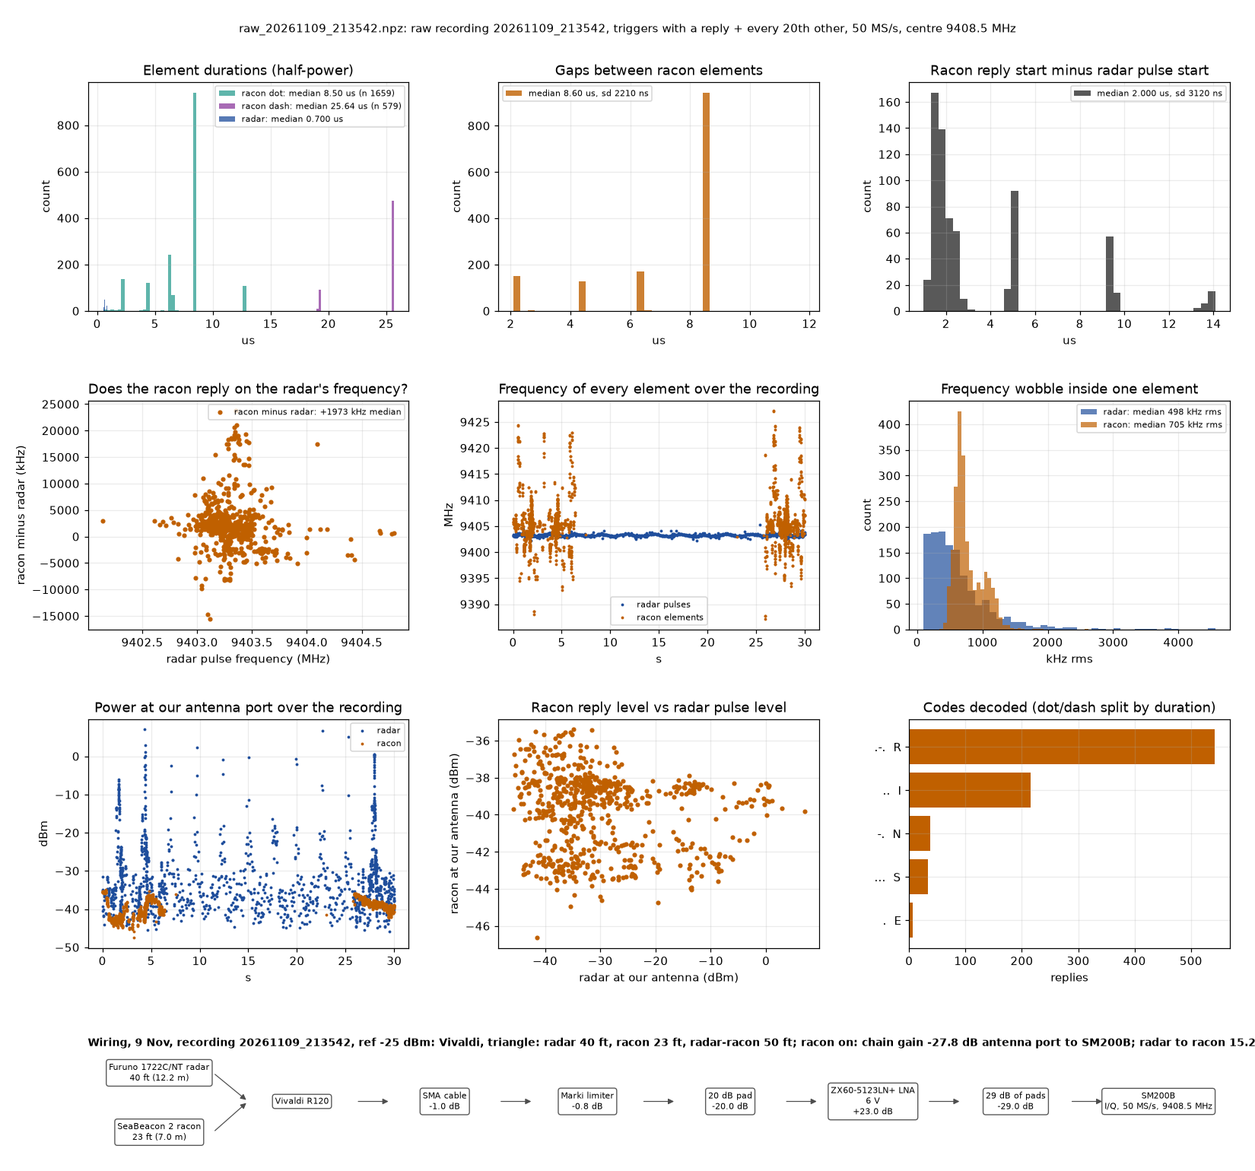
radar_test/racon/plots/raw_20261109_213542_stats.png
