Sorin-Jayaweera/Panthalassa-Clinic-Team/radar_test/racon/plots/raw_20261109_215120_timeline.png

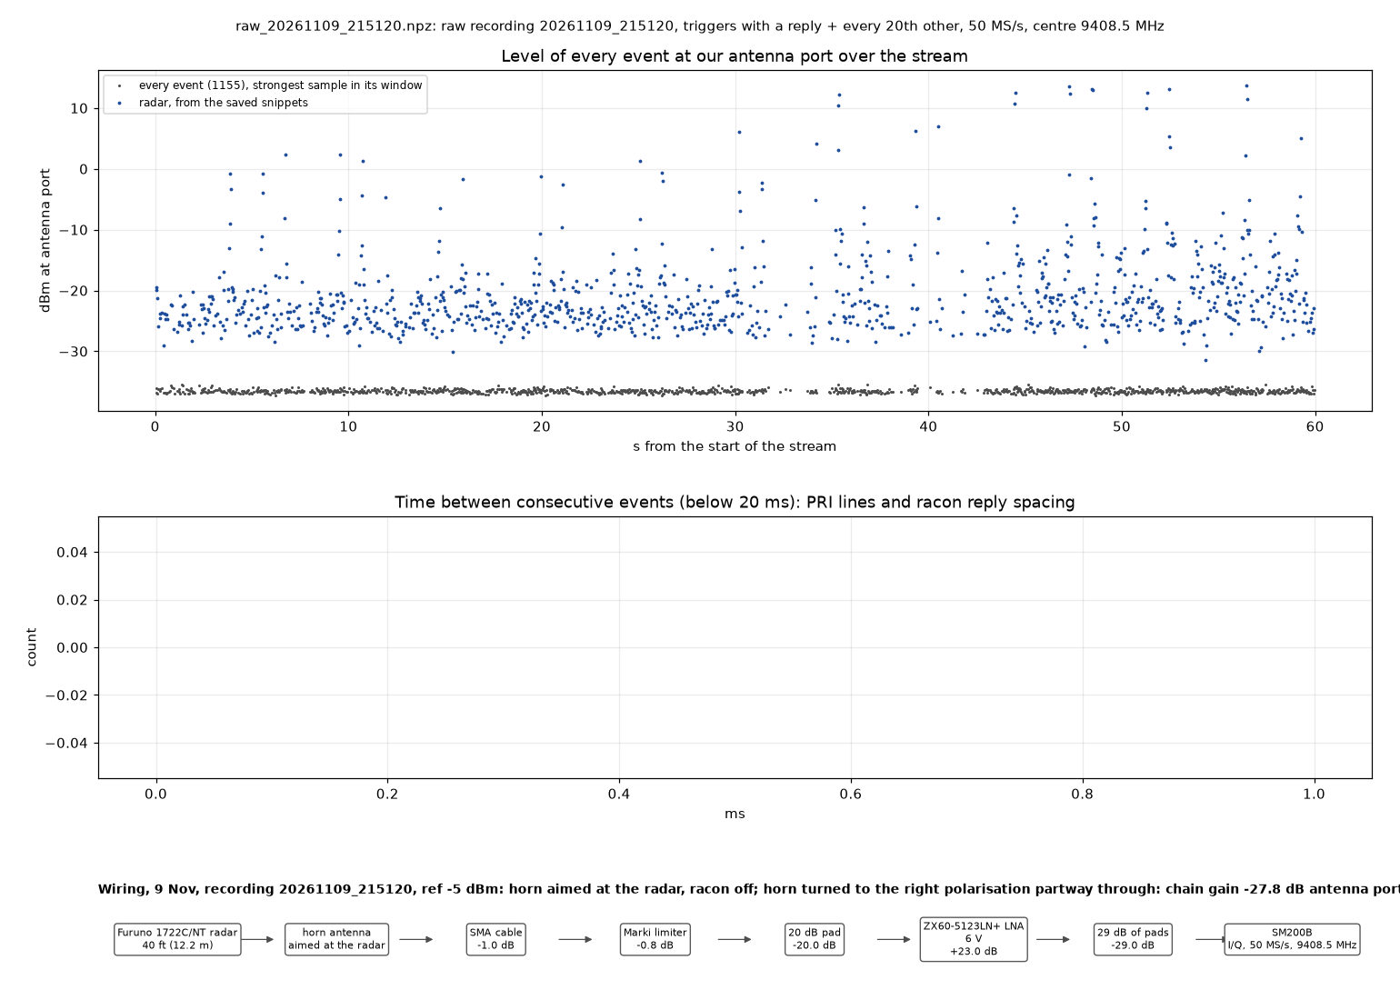
radar_test/racon/plots/raw_20261109_215120_timeline.png
