Sorin-Jayaweera/Panthalassa-Clinic-Team/radar_test/racon/plots/raw_20261109_215716_loudness.png

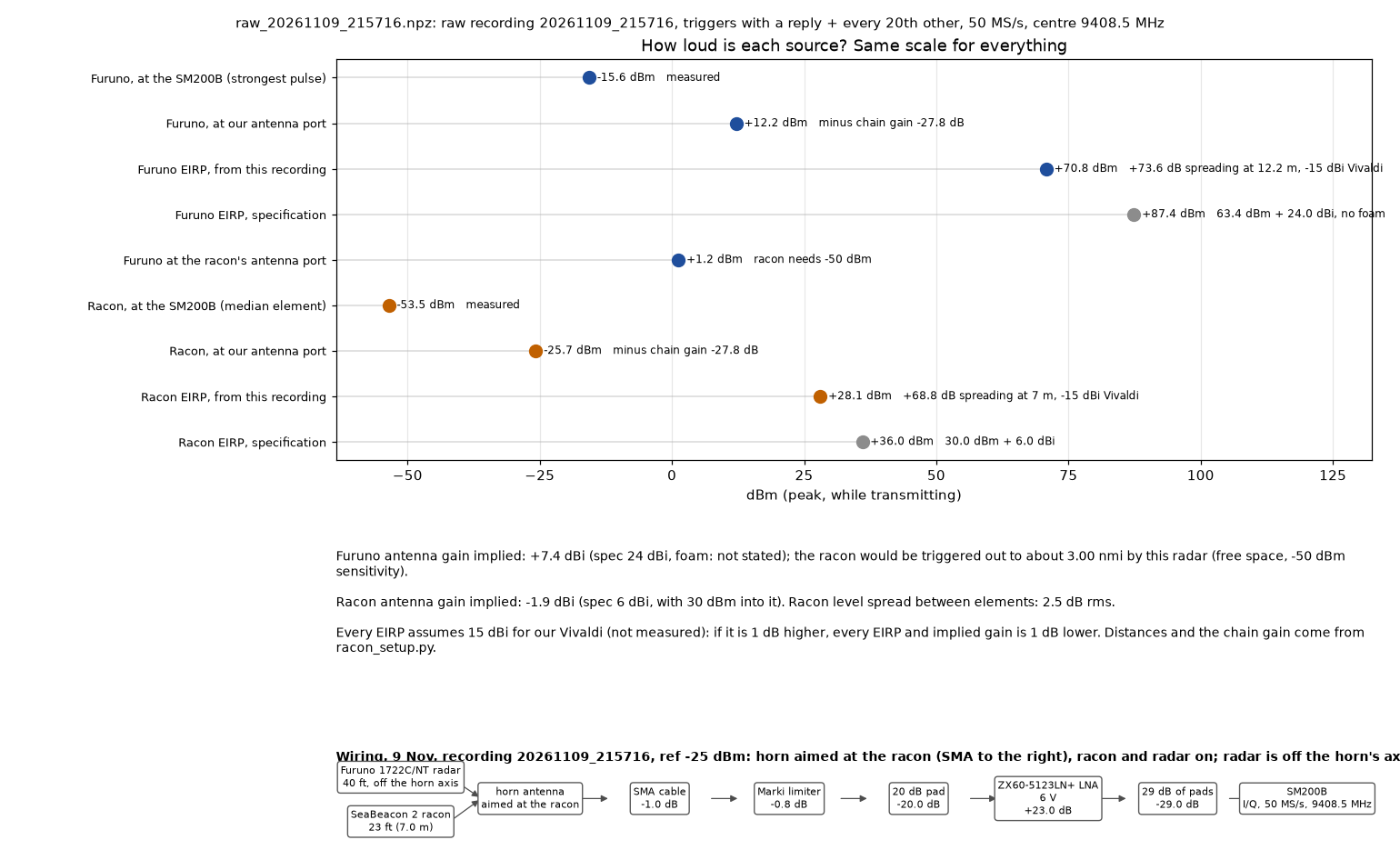
radar_test/racon/plots/raw_20261109_215716_loudness.png
