Sorin-Jayaweera/Panthalassa-Clinic-Team/radar_test/racon/plots/raw_20261109_215716_replies.png

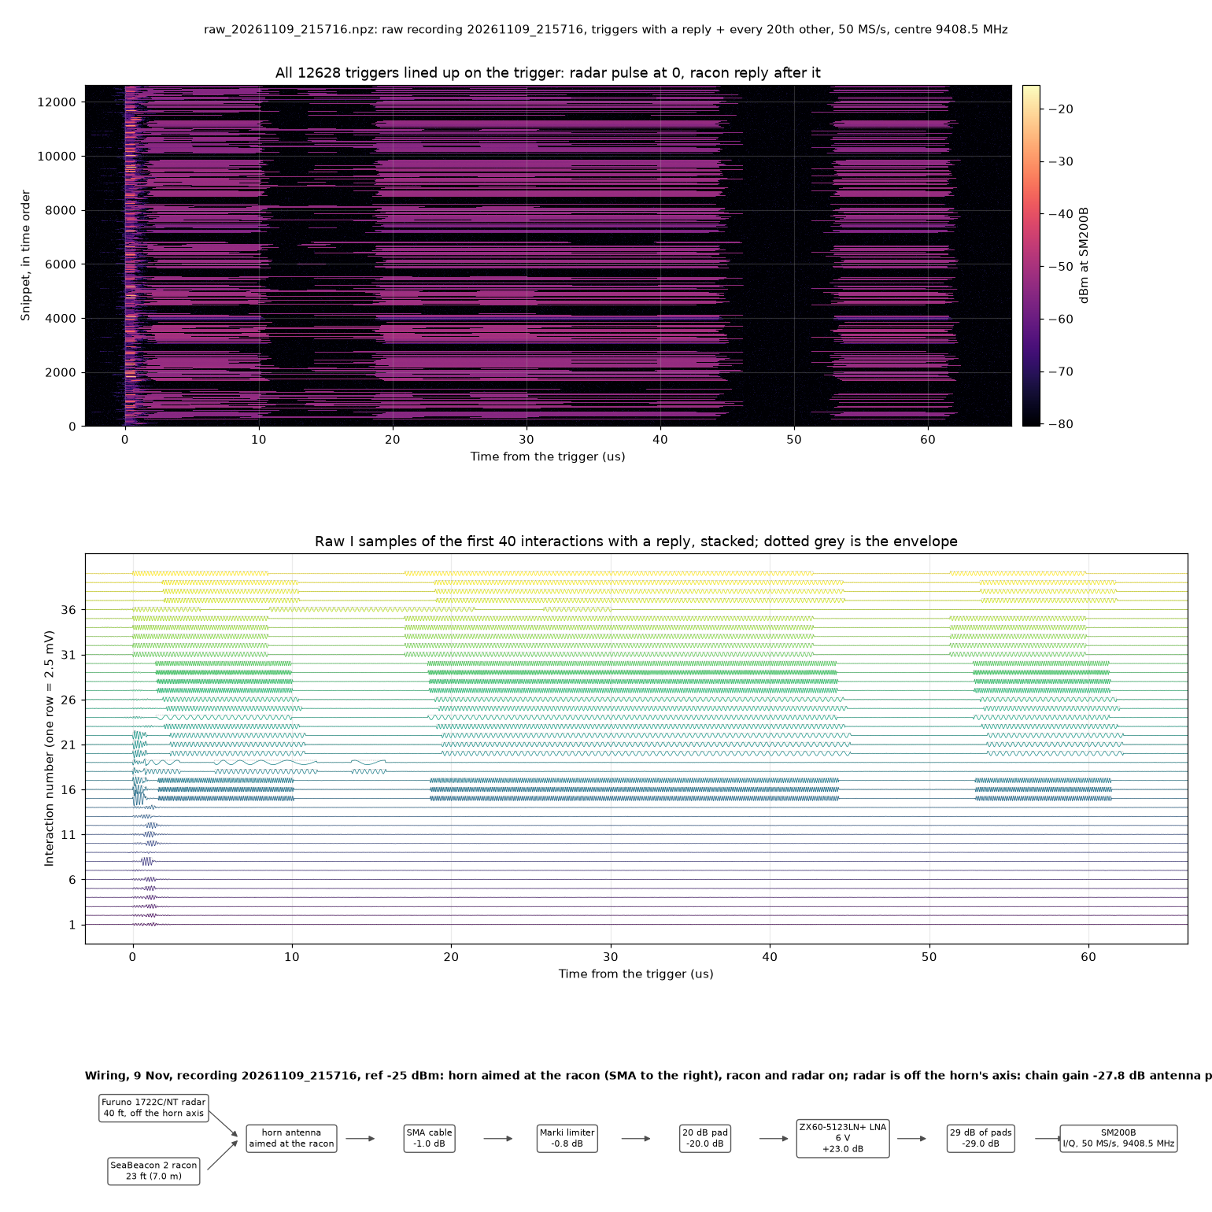
radar_test/racon/plots/raw_20261109_215716_replies.png
