Sorin-Jayaweera/Panthalassa-Clinic-Team/radar_test/racon/plots/stats_20261109_213542_morse_timing_long.png

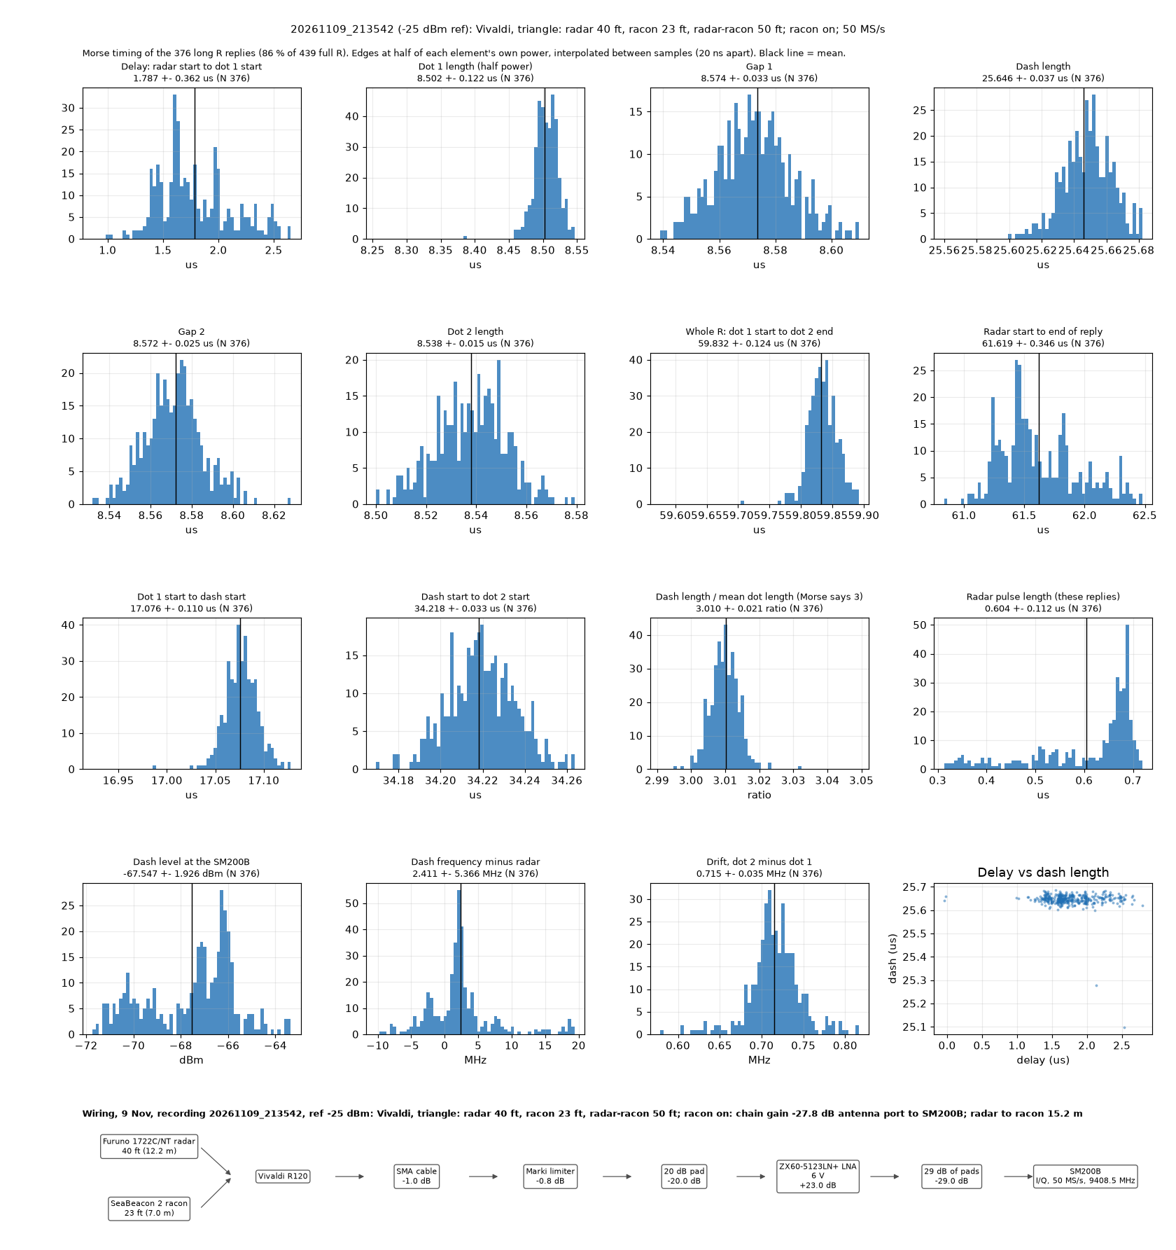
radar_test/racon/plots/stats_20261109_213542_morse_timing_long.png
