Sorin-Jayaweera/Panthalassa-Clinic-Team/radar_test/racon/plots/stats_20261109_213542_table.png

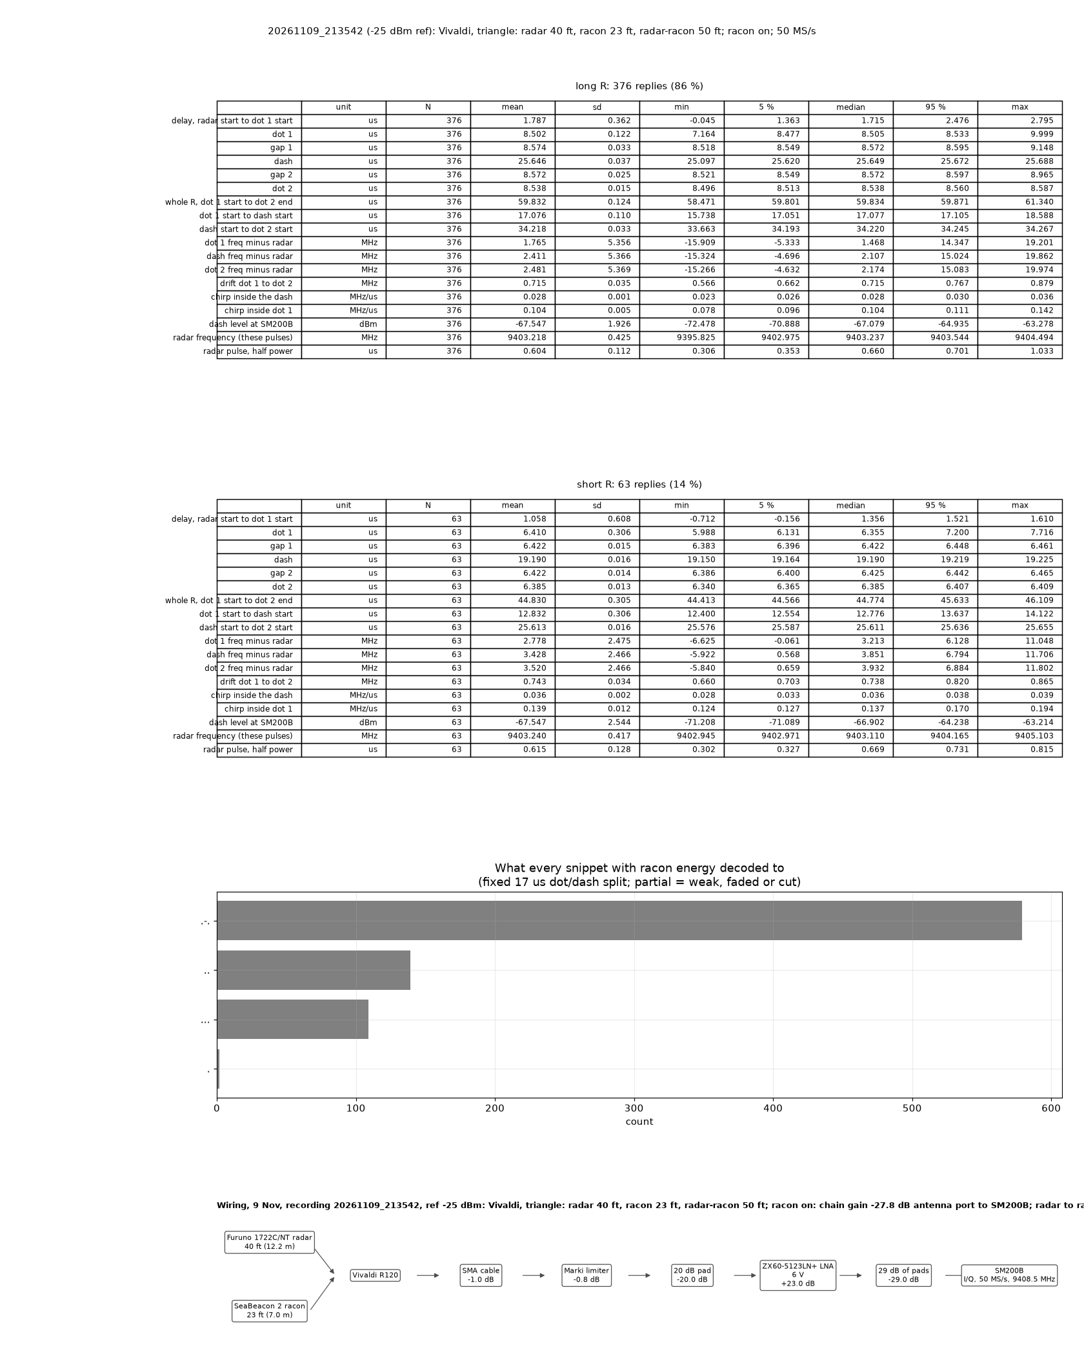
radar_test/racon/plots/stats_20261109_213542_table.png
