Sorin-Jayaweera/Panthalassa-Clinic-Team/radar_test/racon/plots/stats_20261109_213625_bursts.png

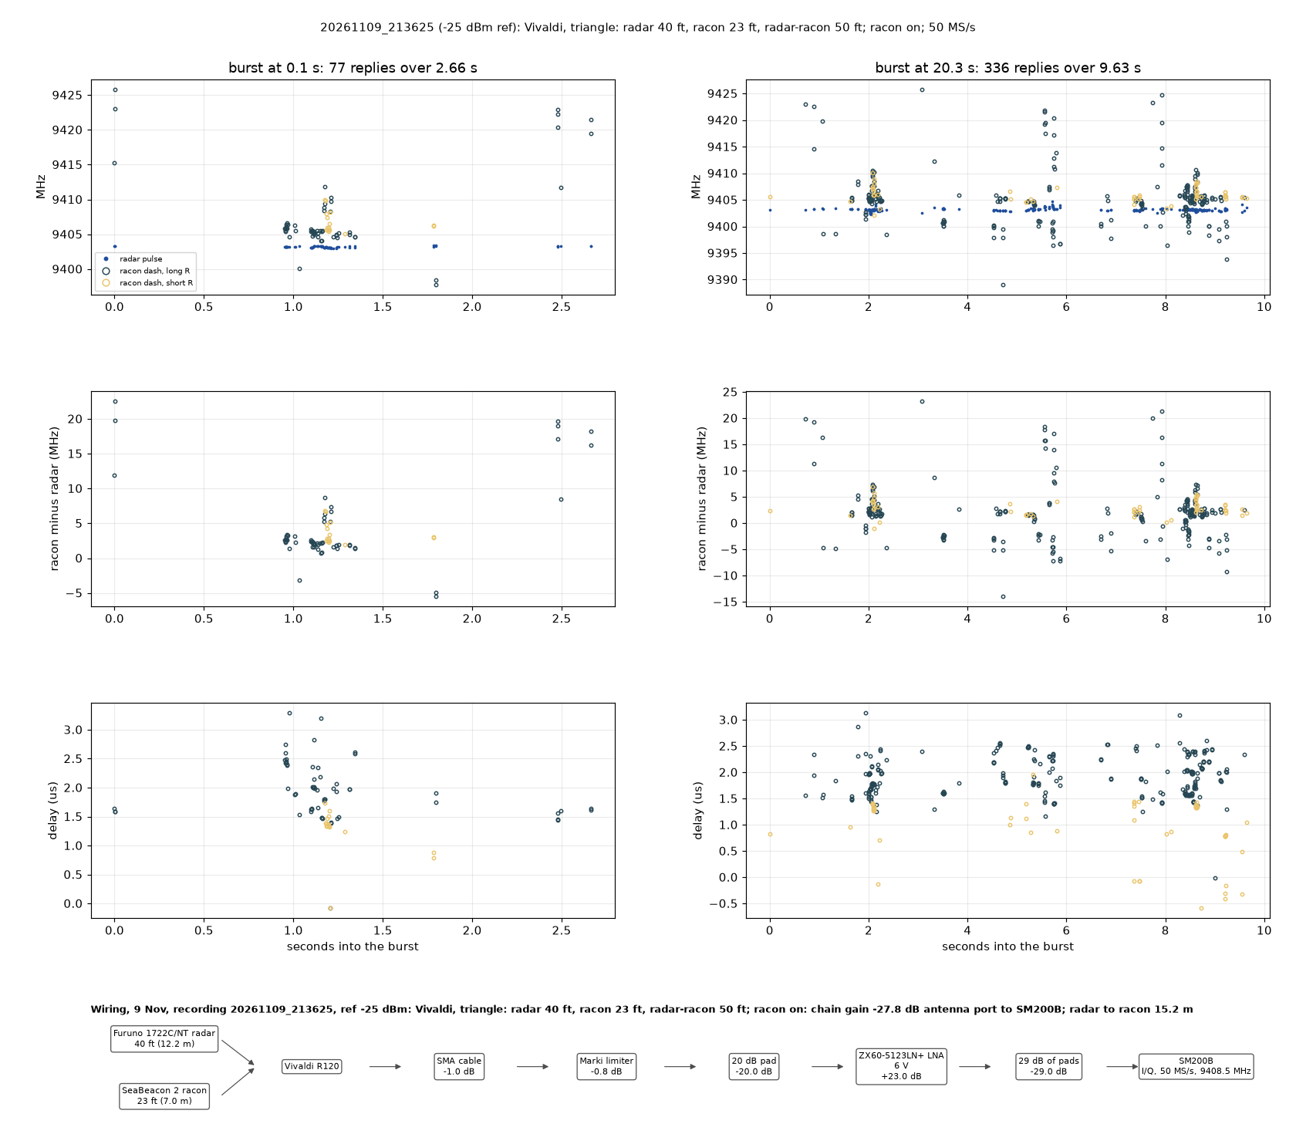
radar_test/racon/plots/stats_20261109_213625_bursts.png
