Sorin-Jayaweera/Panthalassa-Clinic-Team/radar_test/racon/plots/stats_20261109_213625_morse_timing_short.png

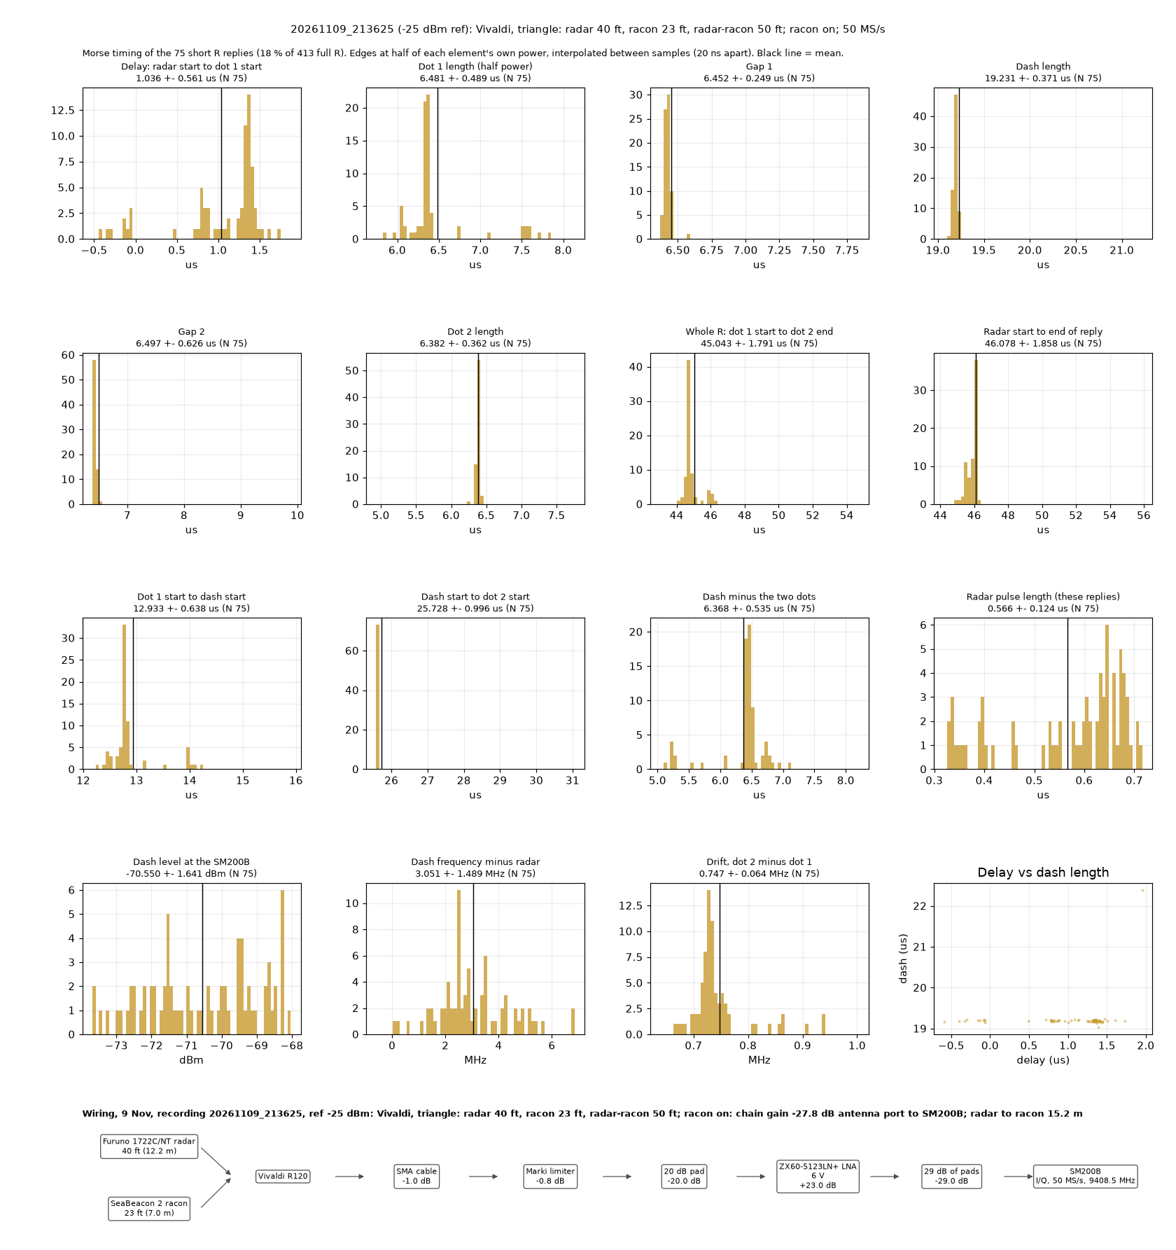
radar_test/racon/plots/stats_20261109_213625_morse_timing_short.png
