Sorin-Jayaweera/Panthalassa-Clinic-Team/radar_test/racon/plots/stats_20261109_213625_stack_envelope.png

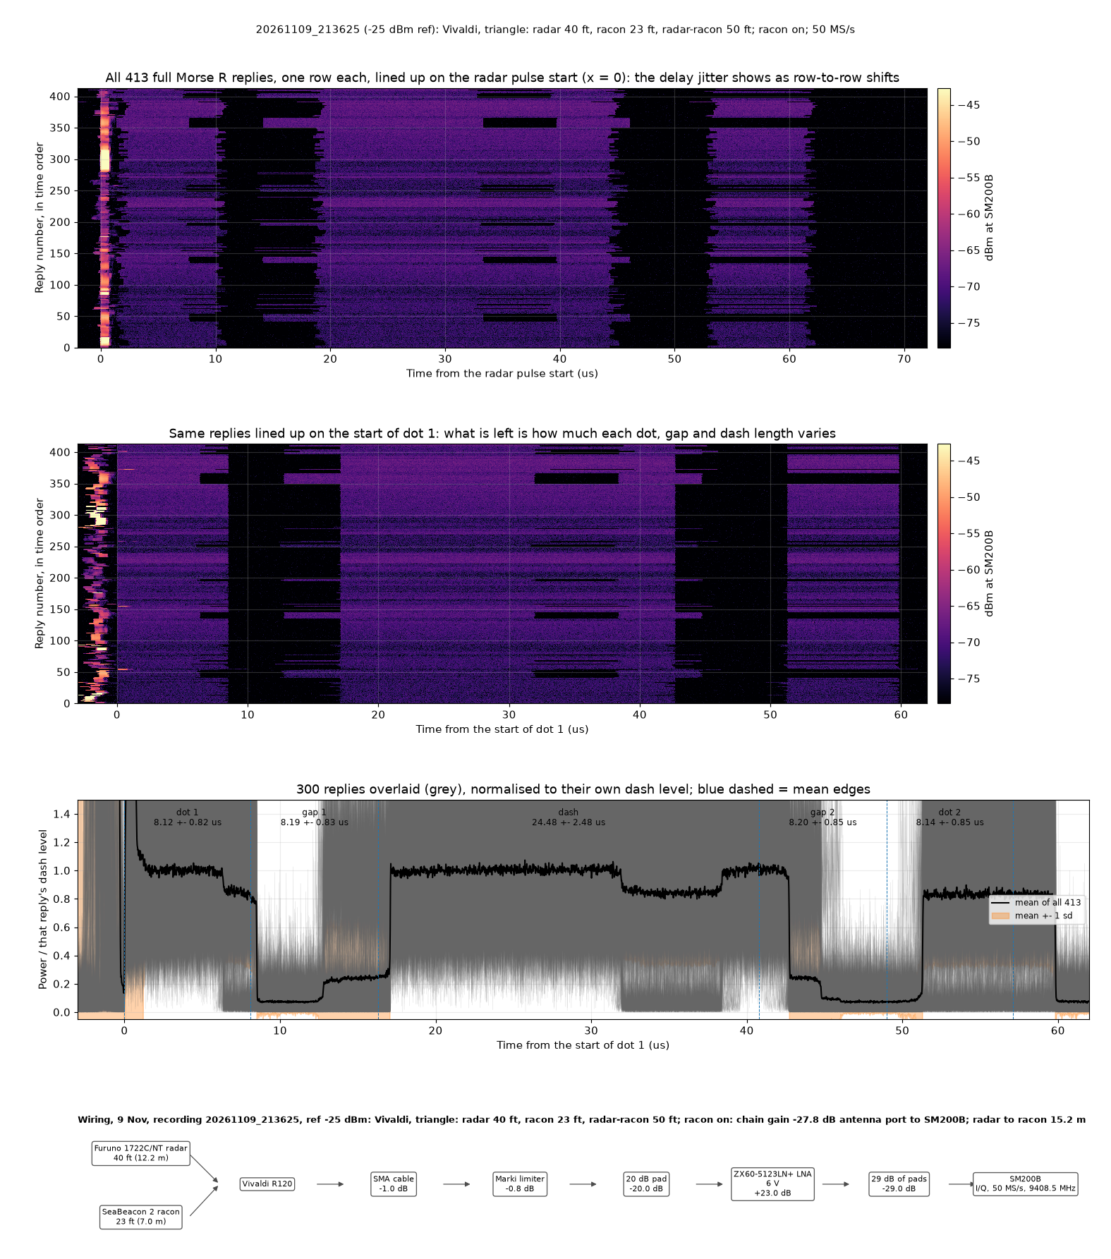
radar_test/racon/plots/stats_20261109_213625_stack_envelope.png
