Sorin-Jayaweera/Panthalassa-Clinic-Team/radar_test/racon/plots/stats_20261109_214452_morse_timing_long.png

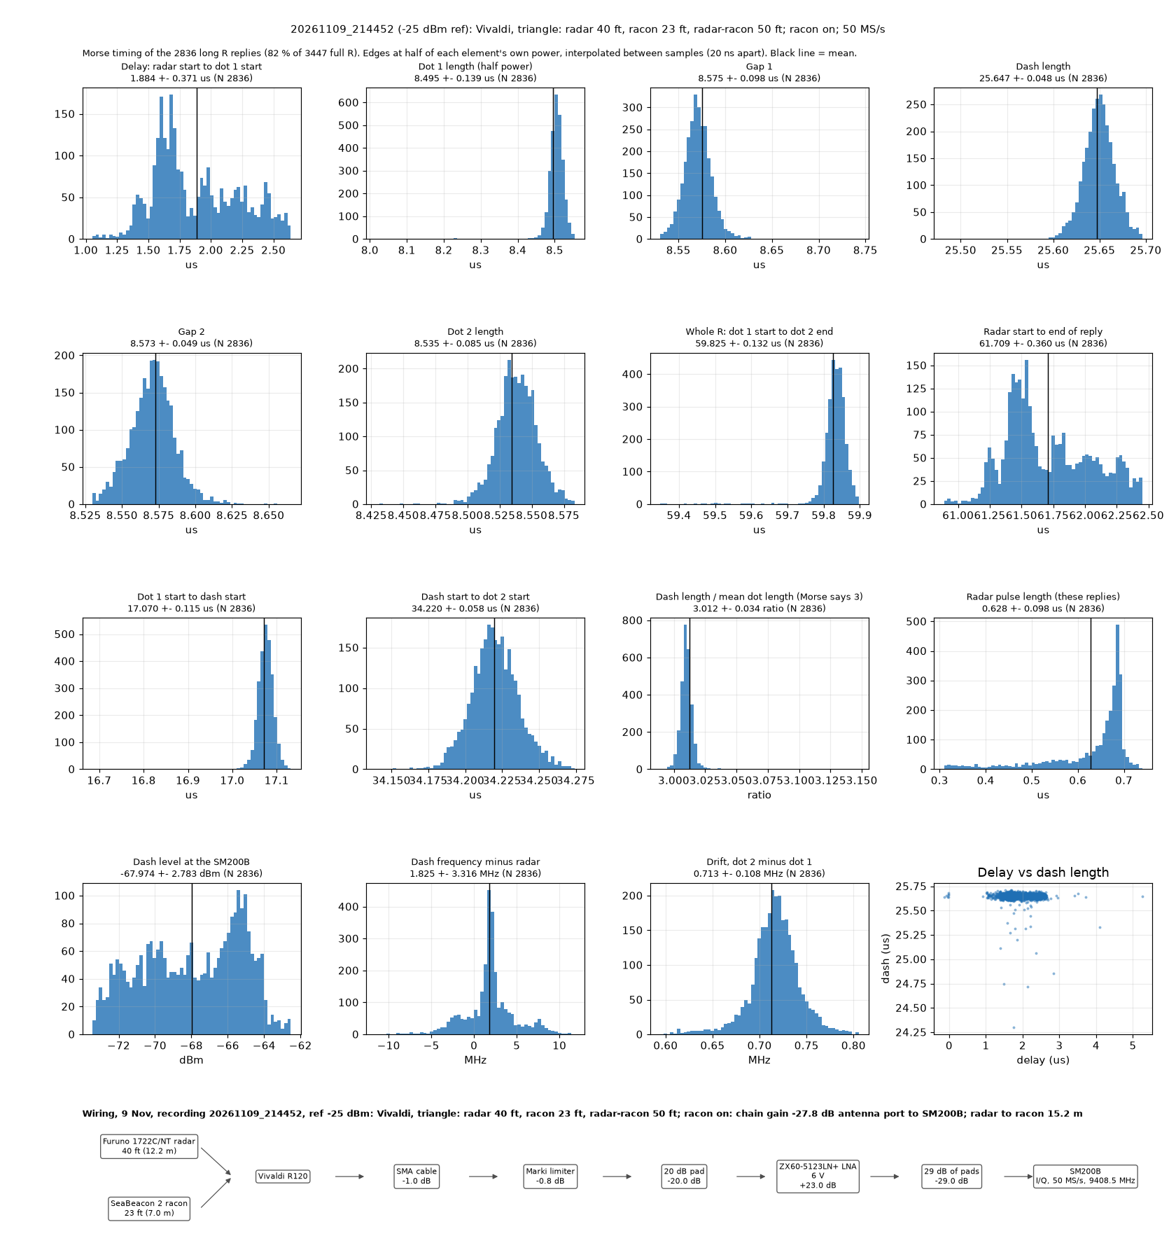
radar_test/racon/plots/stats_20261109_214452_morse_timing_long.png
