Sorin-Jayaweera/Panthalassa-Clinic-Team/radar_test/racon/plots/stats_20261109_215716_edges.png

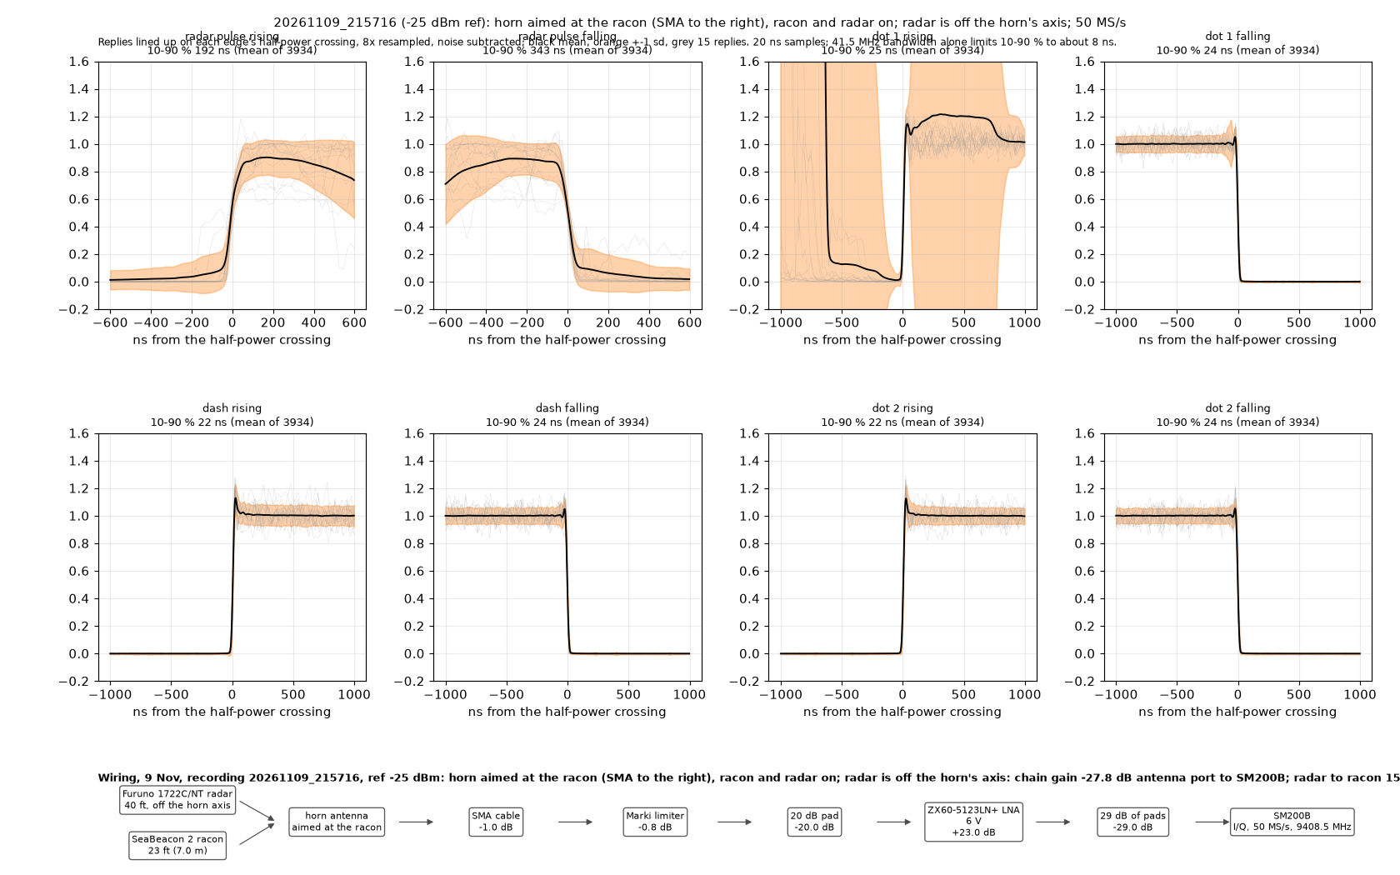
radar_test/racon/plots/stats_20261109_215716_edges.png
