Sorin-Jayaweera/Panthalassa-Clinic-Team/radar_test/racon/plots/stats_seg_horn_racon_250M_bursts.png

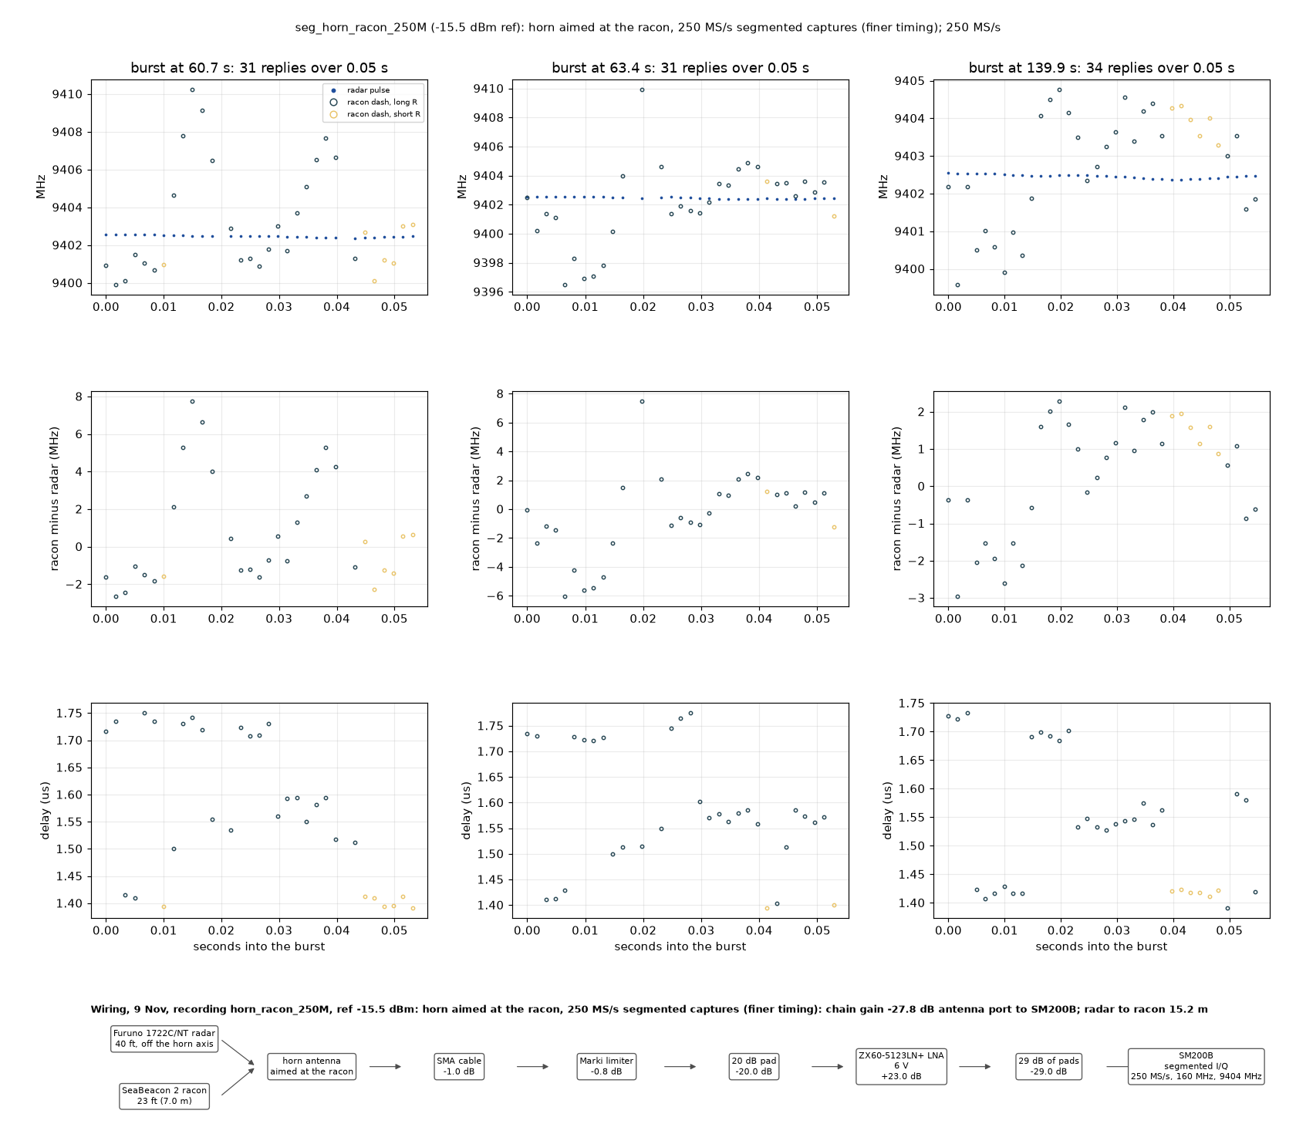
radar_test/racon/plots/stats_seg_horn_racon_250M_bursts.png
