Sorin-Jayaweera/Panthalassa-Clinic-Team/radar_test/racon/plots/survey_radar_20261109_190354_survey.png

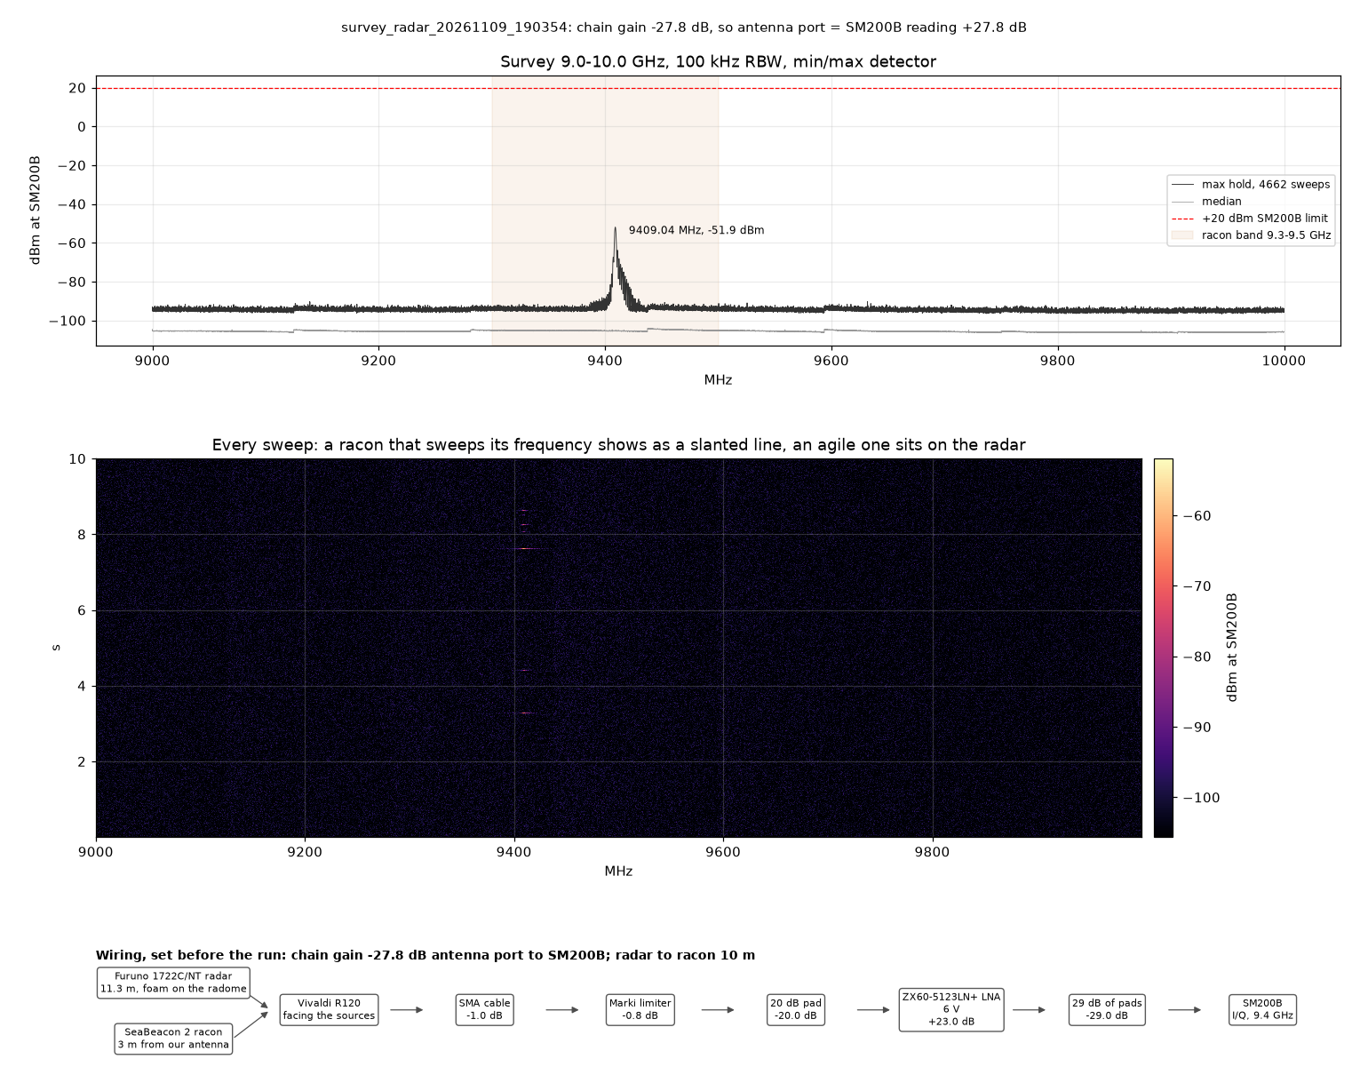
radar_test/racon/plots/survey_radar_20261109_190354_survey.png
