Sorin-Jayaweera/Panthalassa-Clinic-Team/radar_test/racon/plots/sweeps_harm2.png

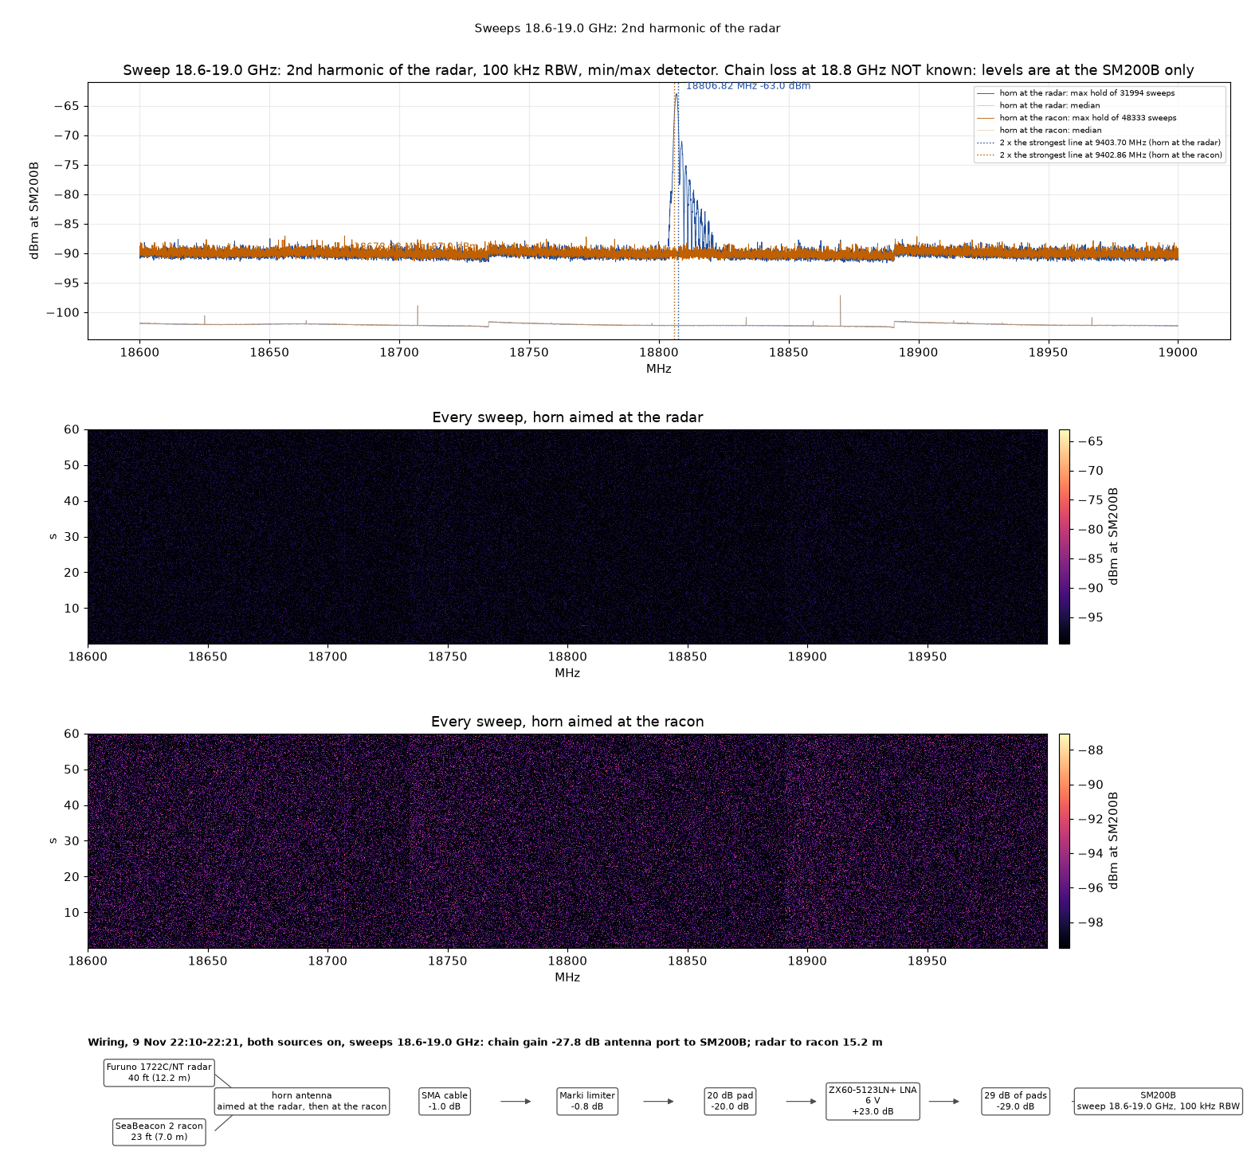
radar_test/racon/plots/sweeps_harm2.png
