Sorin-Jayaweera/Panthalassa-Clinic-Team/radar_test/racon/plots/sweeps_wide.png

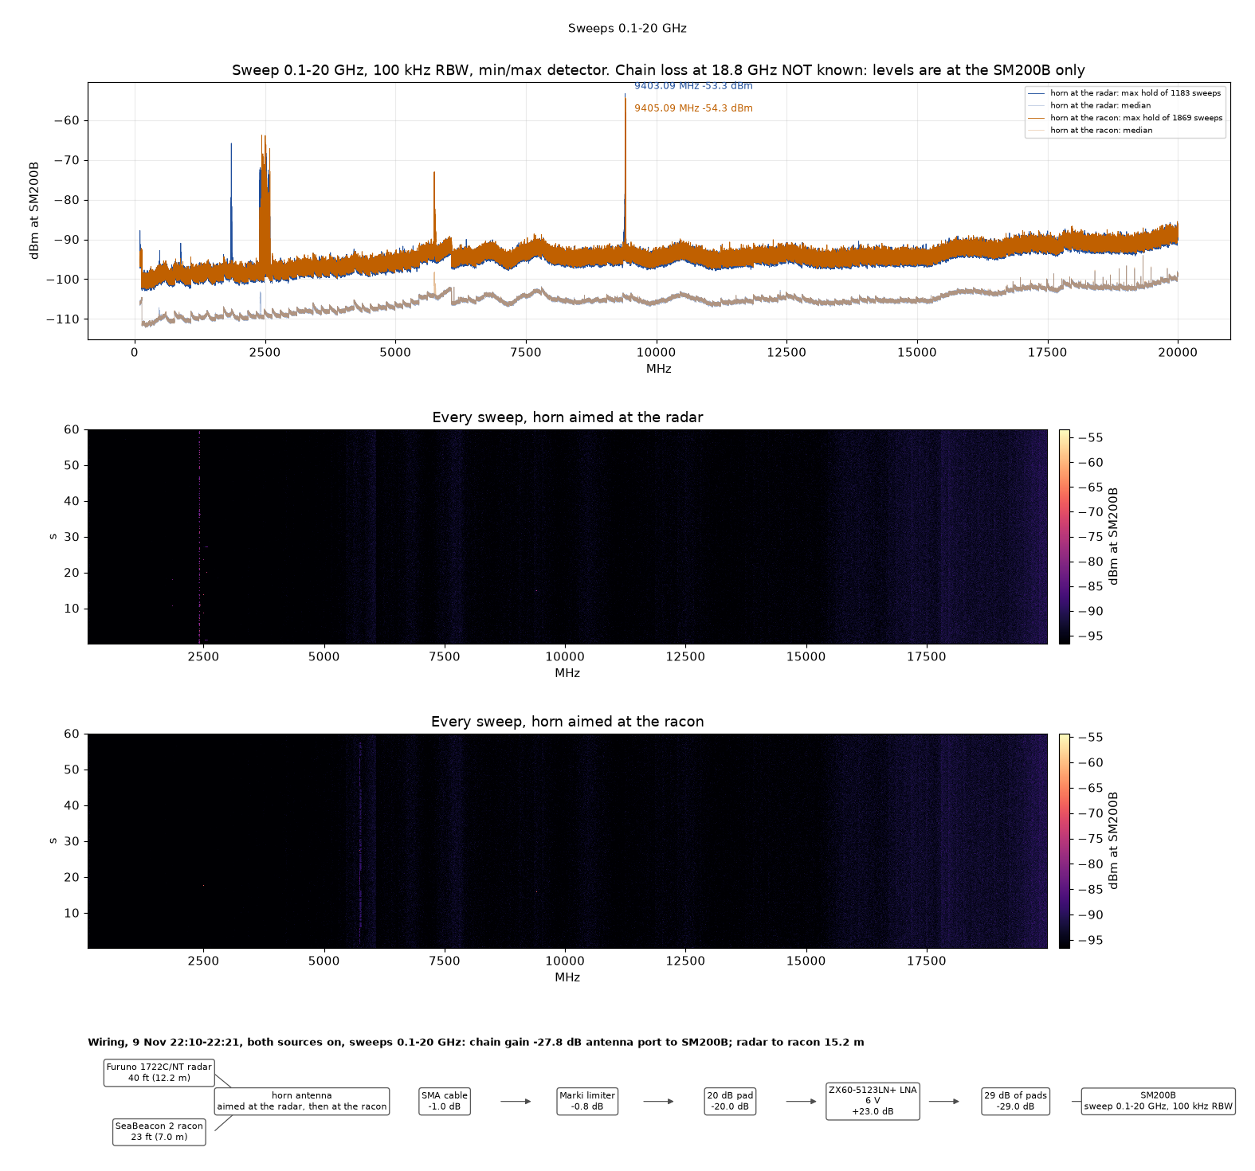
radar_test/racon/plots/sweeps_wide.png
