Sorin-Jayaweera/Panthalassa-Clinic-Team/radar_test/racon/plots/synthetic_seg_chain.png

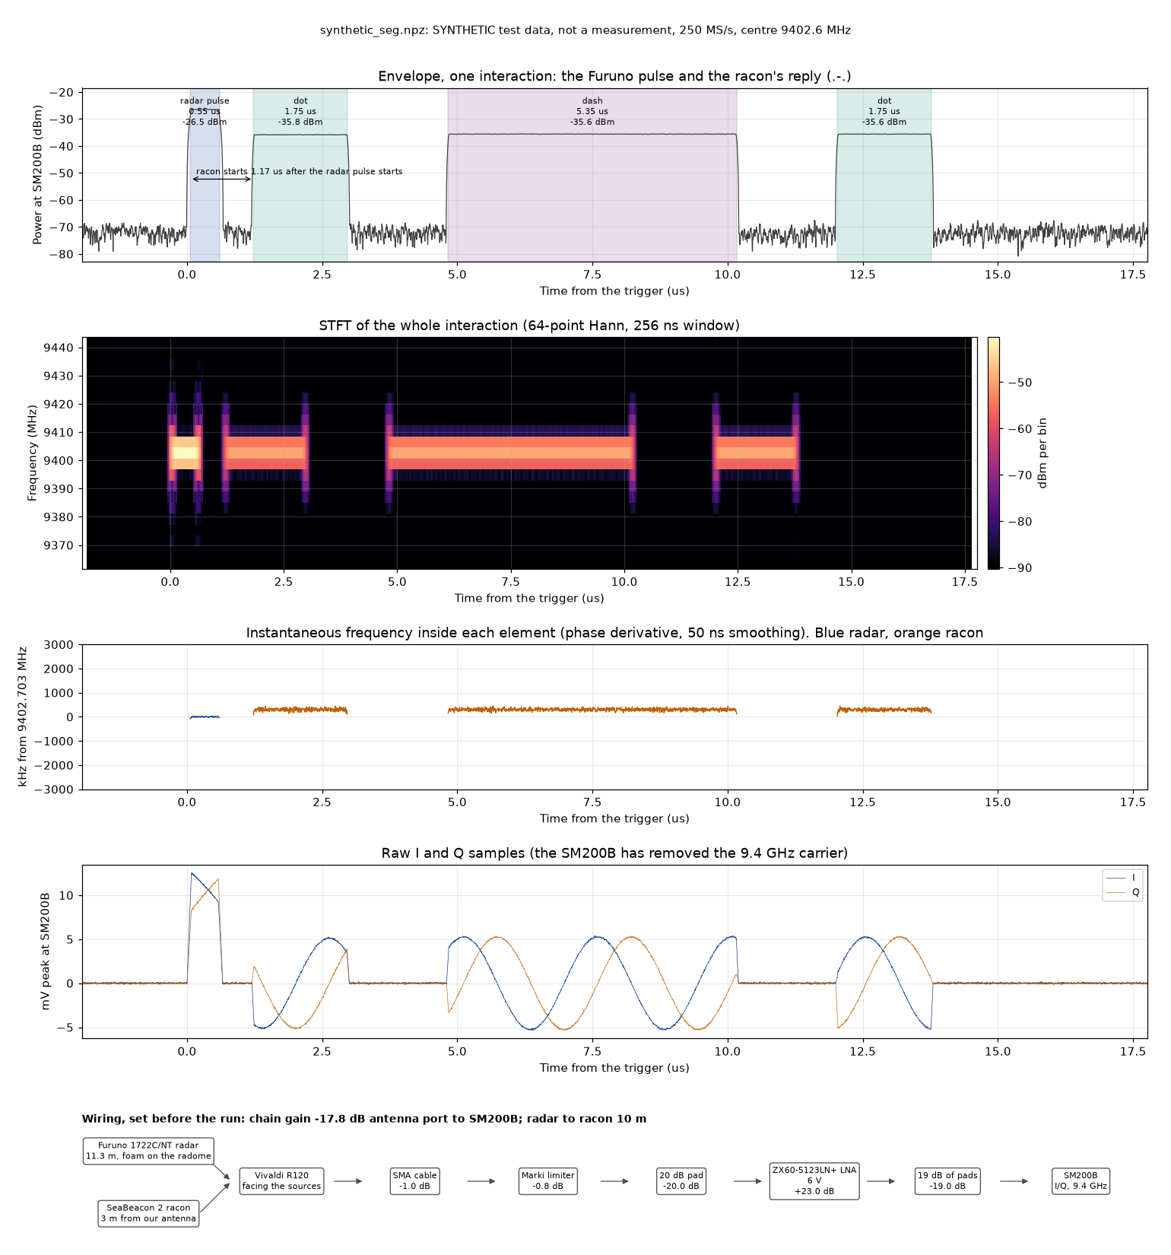
radar_test/racon/plots/synthetic_seg_chain.png
