Sorin-Jayaweera/Panthalassa-Clinic-Team/radar_test/racon/plots/synthetic_seg_replies.png

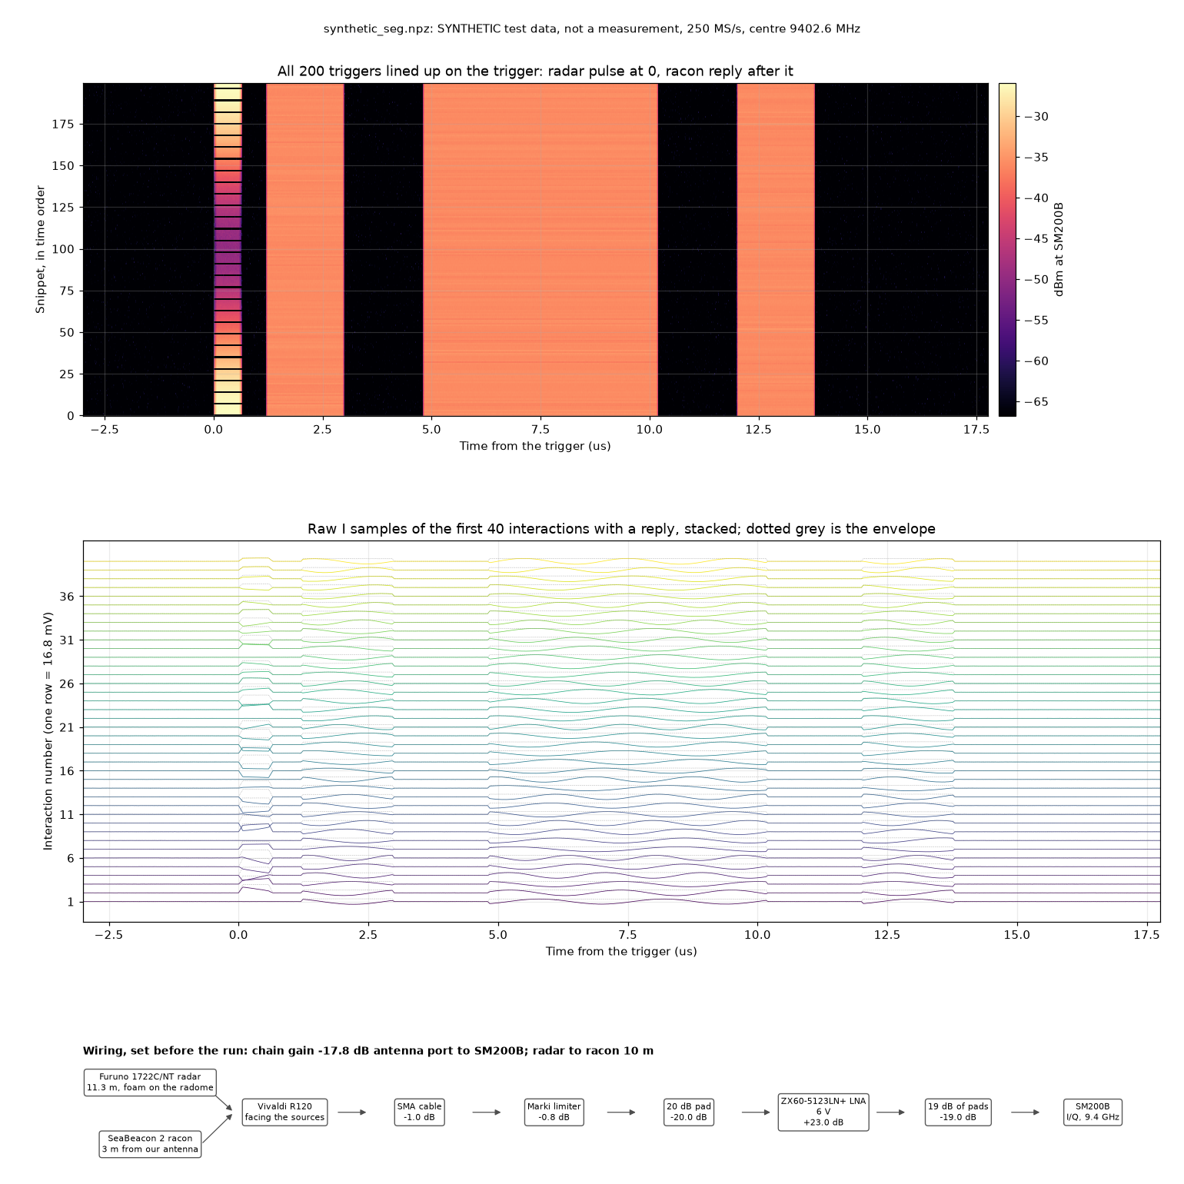
radar_test/racon/plots/synthetic_seg_replies.png
