Sorin-Jayaweera/Panthalassa-Clinic-Team/radar_test/scans/baseline_20261025_111406.png

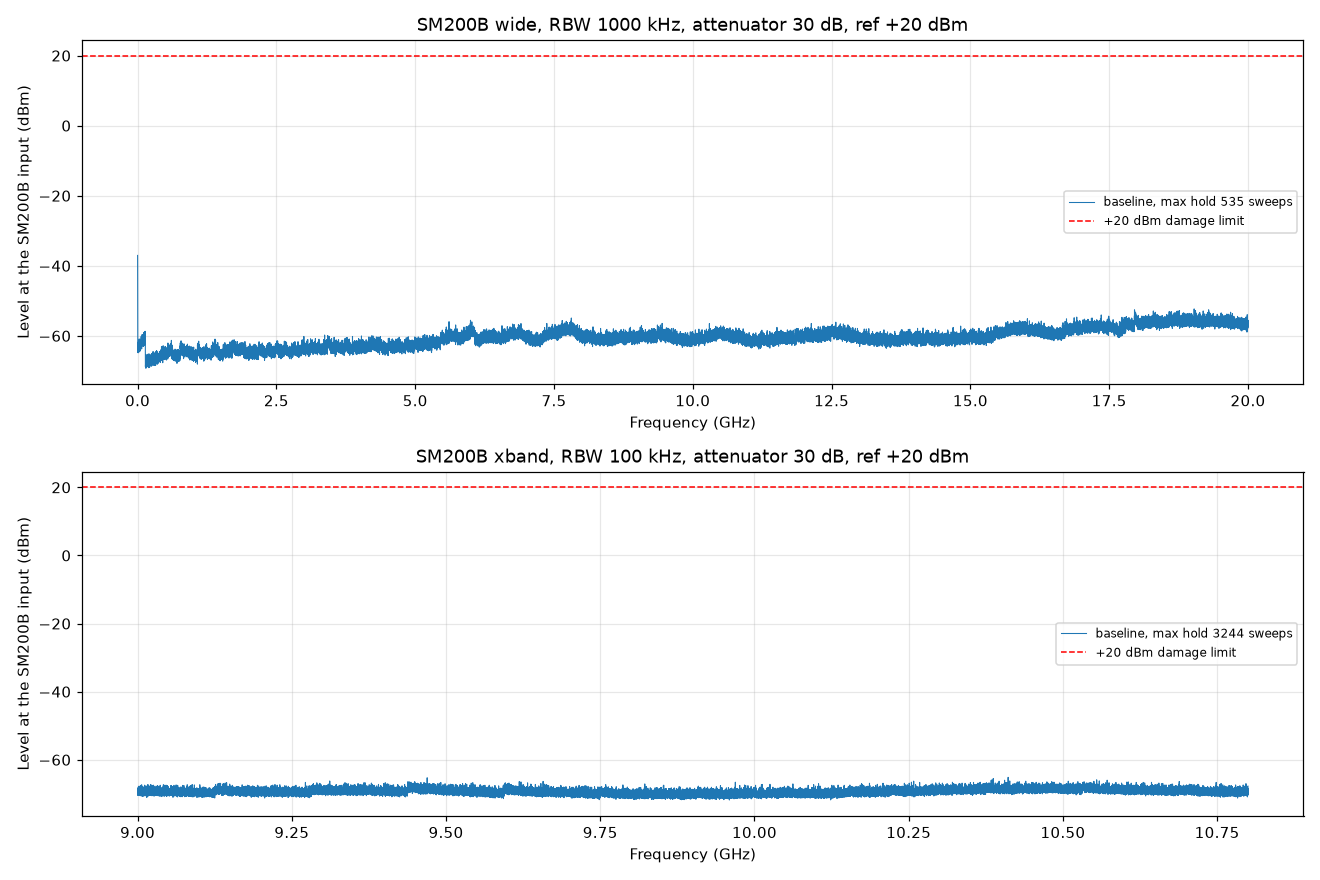
radar_test/scans/baseline_20261025_111406.png
