Sorin-Jayaweera/Panthalassa-Clinic-Team/radar_test/spike_screens/maxxie_IF_swept_100MHz_31oct.png

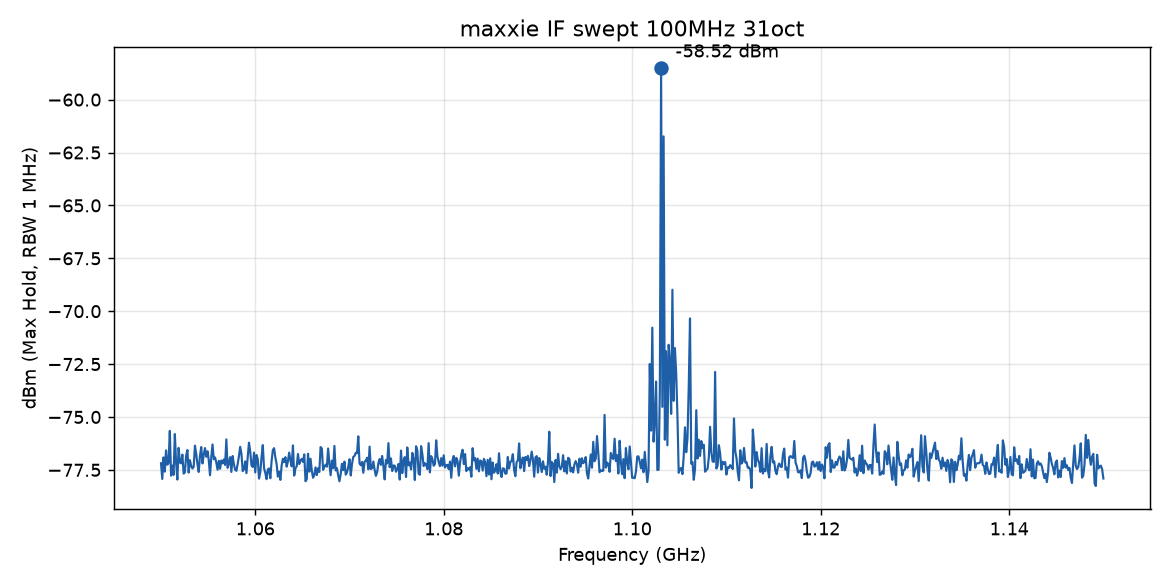
radar_test/spike_screens/maxxie_IF_swept_100MHz_31oct.png
