Sorin-Jayaweera/Panthalassa-Clinic-Team/radar_test/spike_screens/maxxie_IF_zero_span_1p105GHz_31oct.png

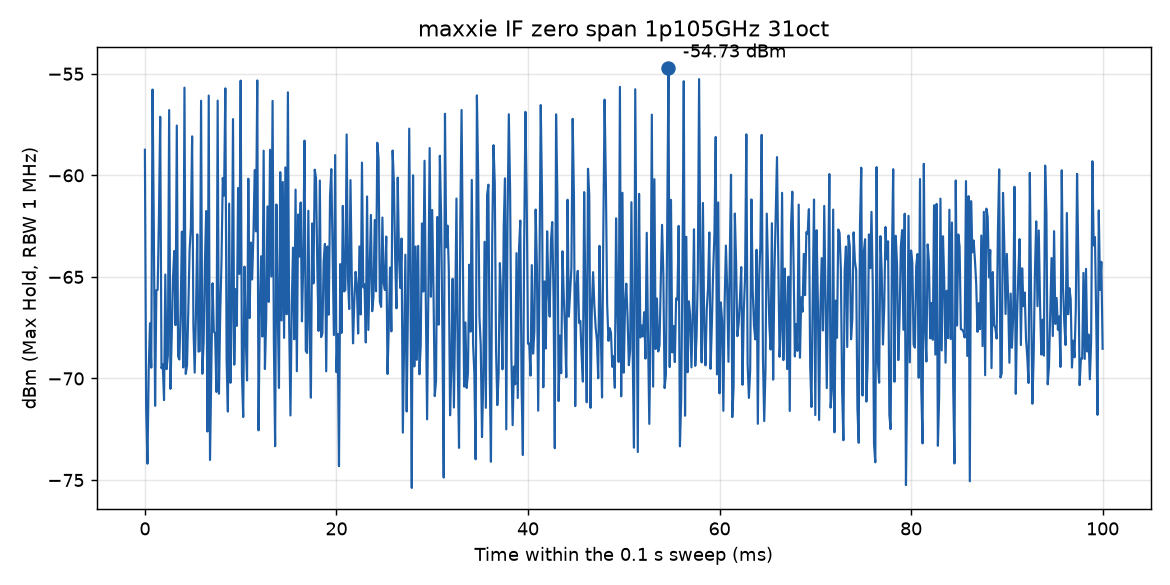
radar_test/spike_screens/maxxie_IF_zero_span_1p105GHz_31oct.png
