Sorin-Jayaweera/Panthalassa-Clinic-Team/radar_test/spike_screens/ssa3021x_IF_zero_span_1p105GHz_31oct_screen.png

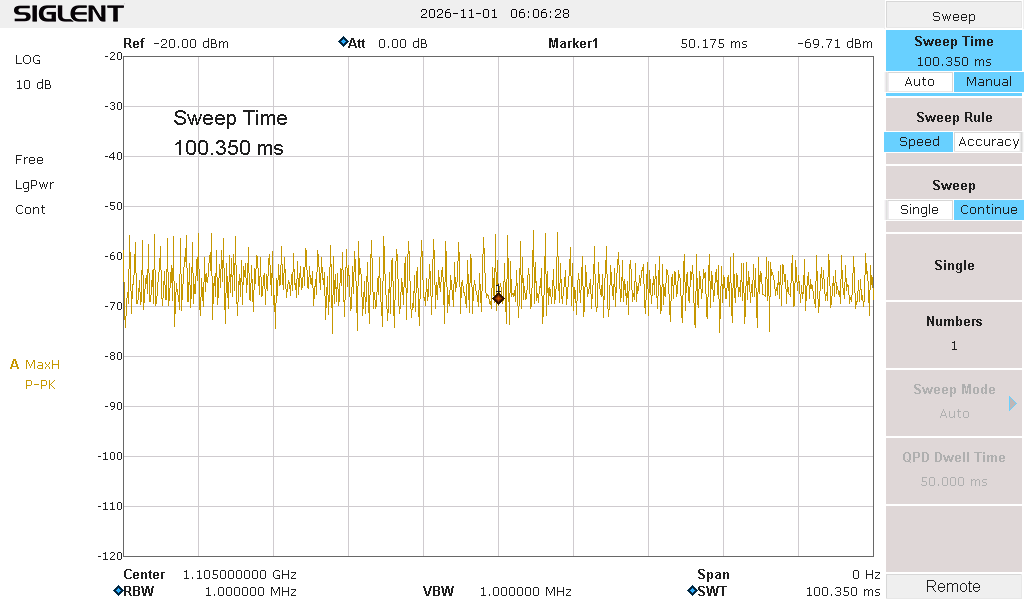
radar_test/spike_screens/ssa3021x_IF_zero_span_1p105GHz_31oct_screen.png
