Sorin-Jayaweera/Panthalassa-Clinic-Team/radar_test/spike_screens/test27_vivaldi_limiter_20dB_LNA_19dB_11p5m_ref-20_CLIPPED.jpg

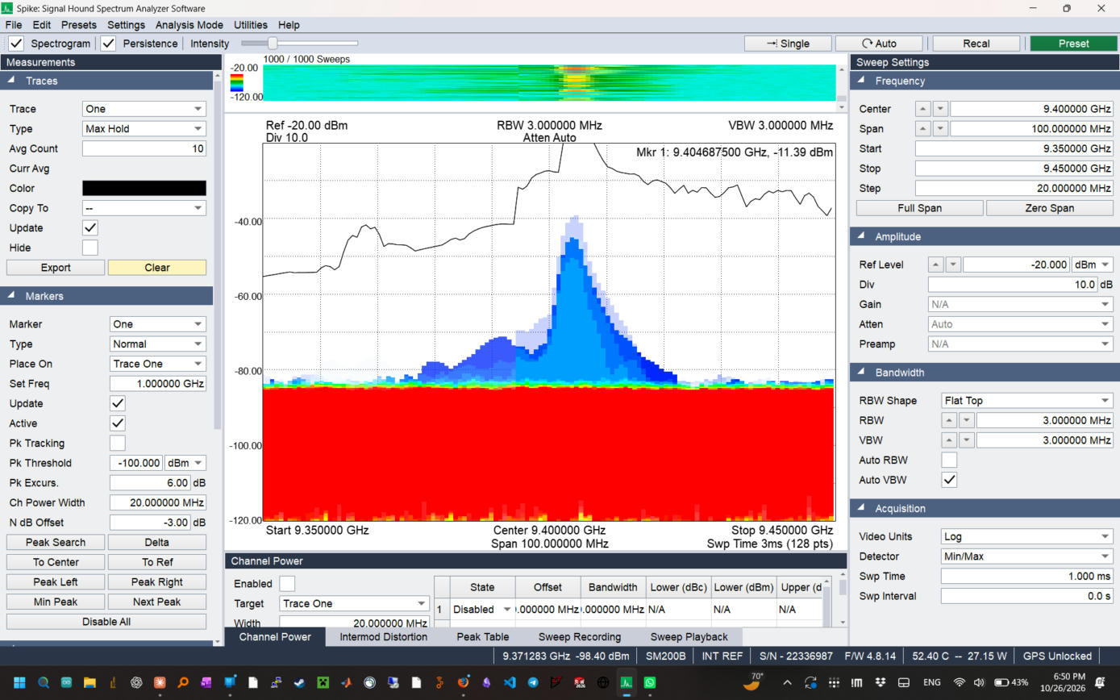
radar_test/spike_screens/test27_vivaldi_limiter_20dB_LNA_19dB_11p5m_ref-20_CLIPPED.jpg
