Sorin-Jayaweera/Panthalassa-Clinic-Team/radar_test/spike_screens/test30b_limiter_20dB_LNA_on_29dB_ref-20_31oct.png

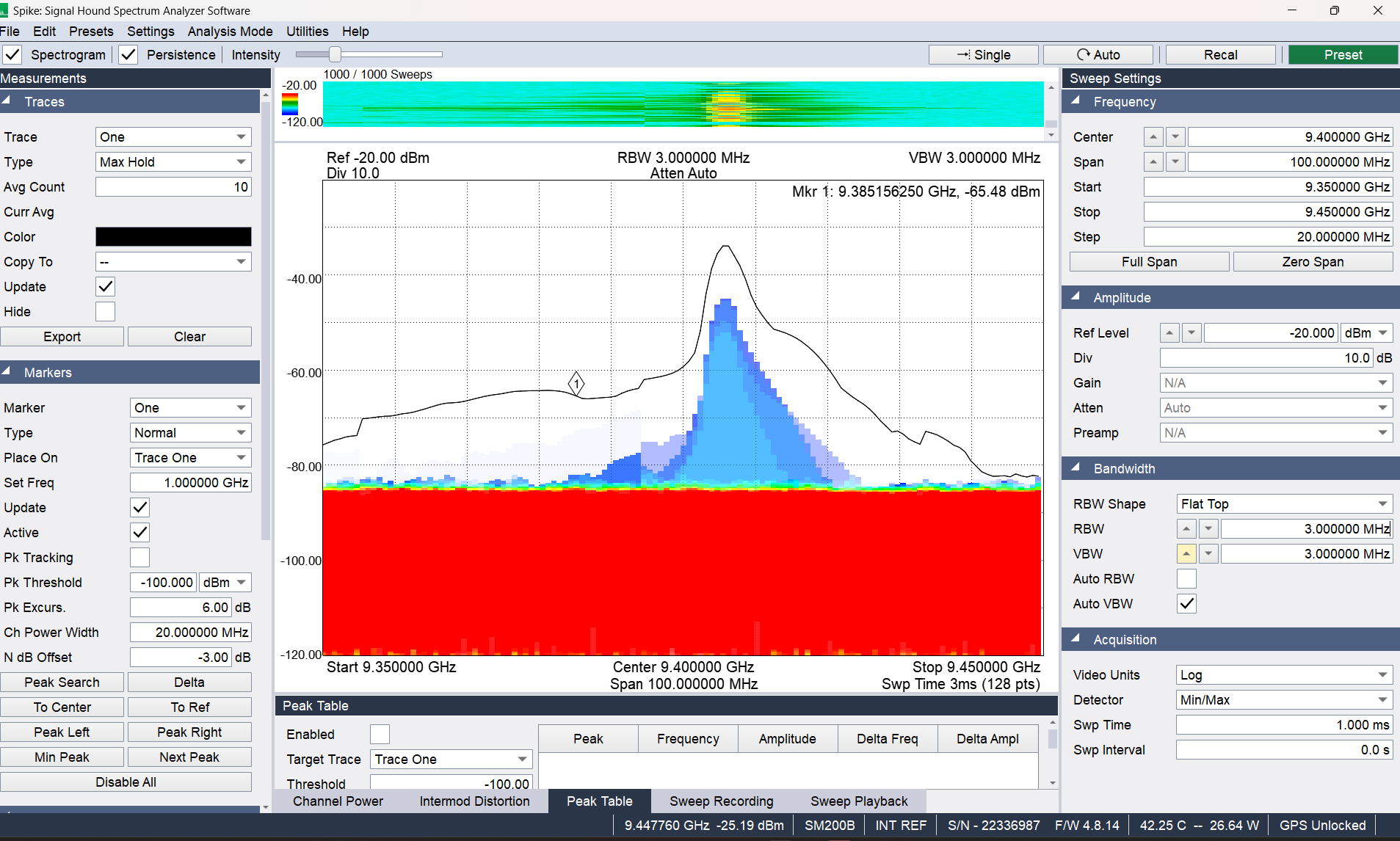
radar_test/spike_screens/test30b_limiter_20dB_LNA_on_29dB_ref-20_31oct.png
