Sorin-Jayaweera/Panthalassa-Clinic-Team/radar_test/spike_screens/test31_limiter_20dB_LNA_on_29dB_100kHz_31oct.png

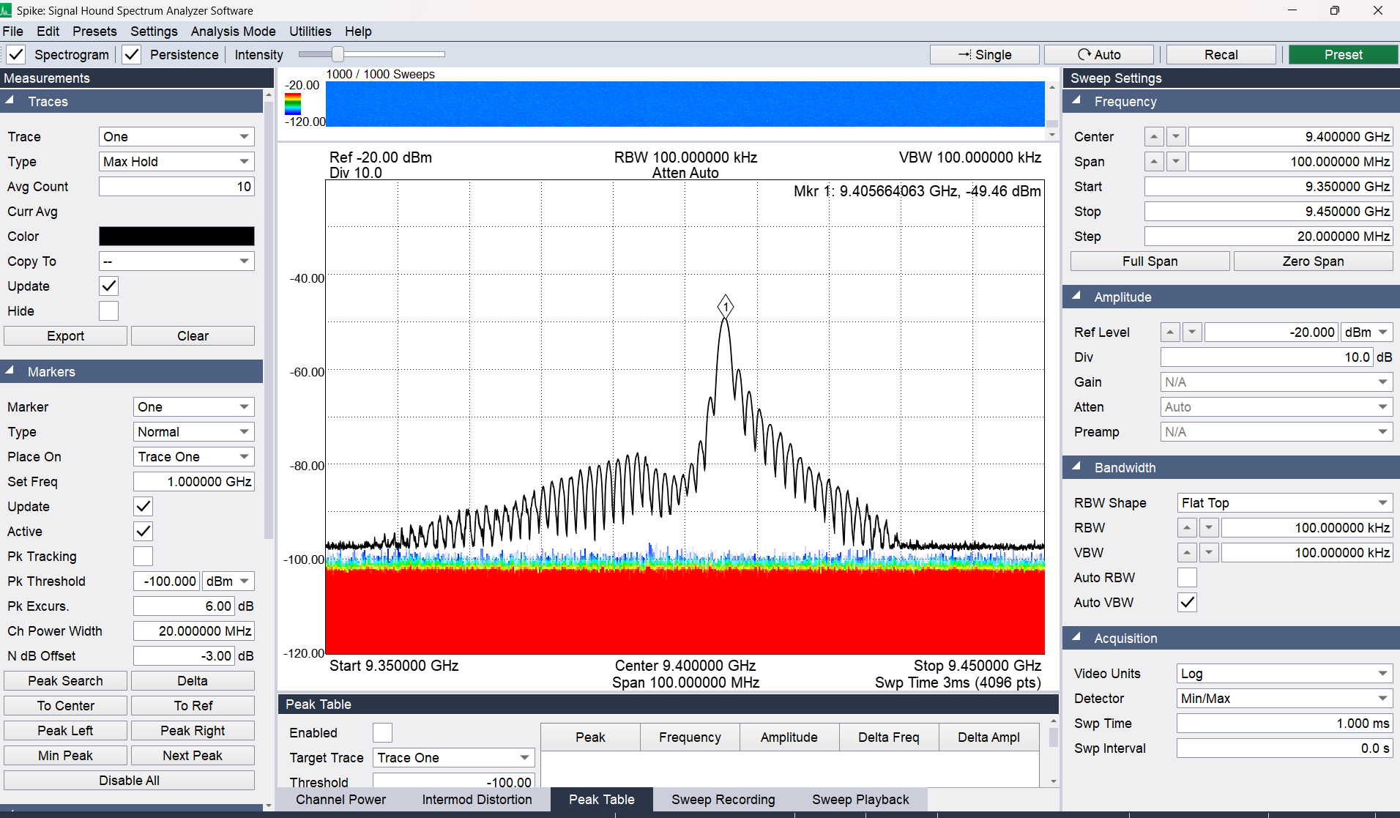
radar_test/spike_screens/test31_limiter_20dB_LNA_on_29dB_100kHz_31oct.png
