Sorin-Jayaweera/Panthalassa-Clinic-Team/radar_test/spike_screens/test33_vivaldi_direct_on_limiter_31oct.png

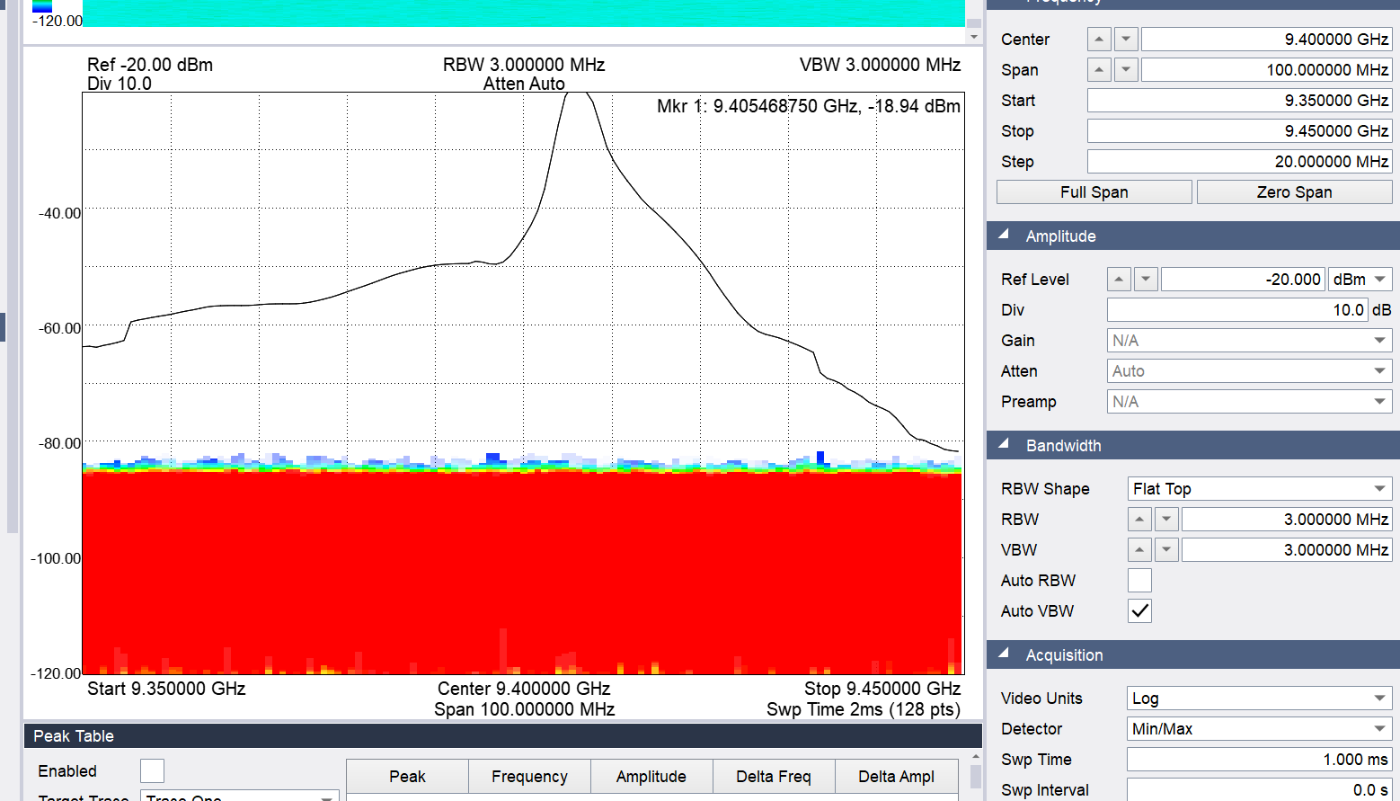
radar_test/spike_screens/test33_vivaldi_direct_on_limiter_31oct.png
