Sorin-Jayaweera/Panthalassa-Clinic-Team/radar_test/spike_screens/test36_mixer_LO_feedthrough_31oct.png

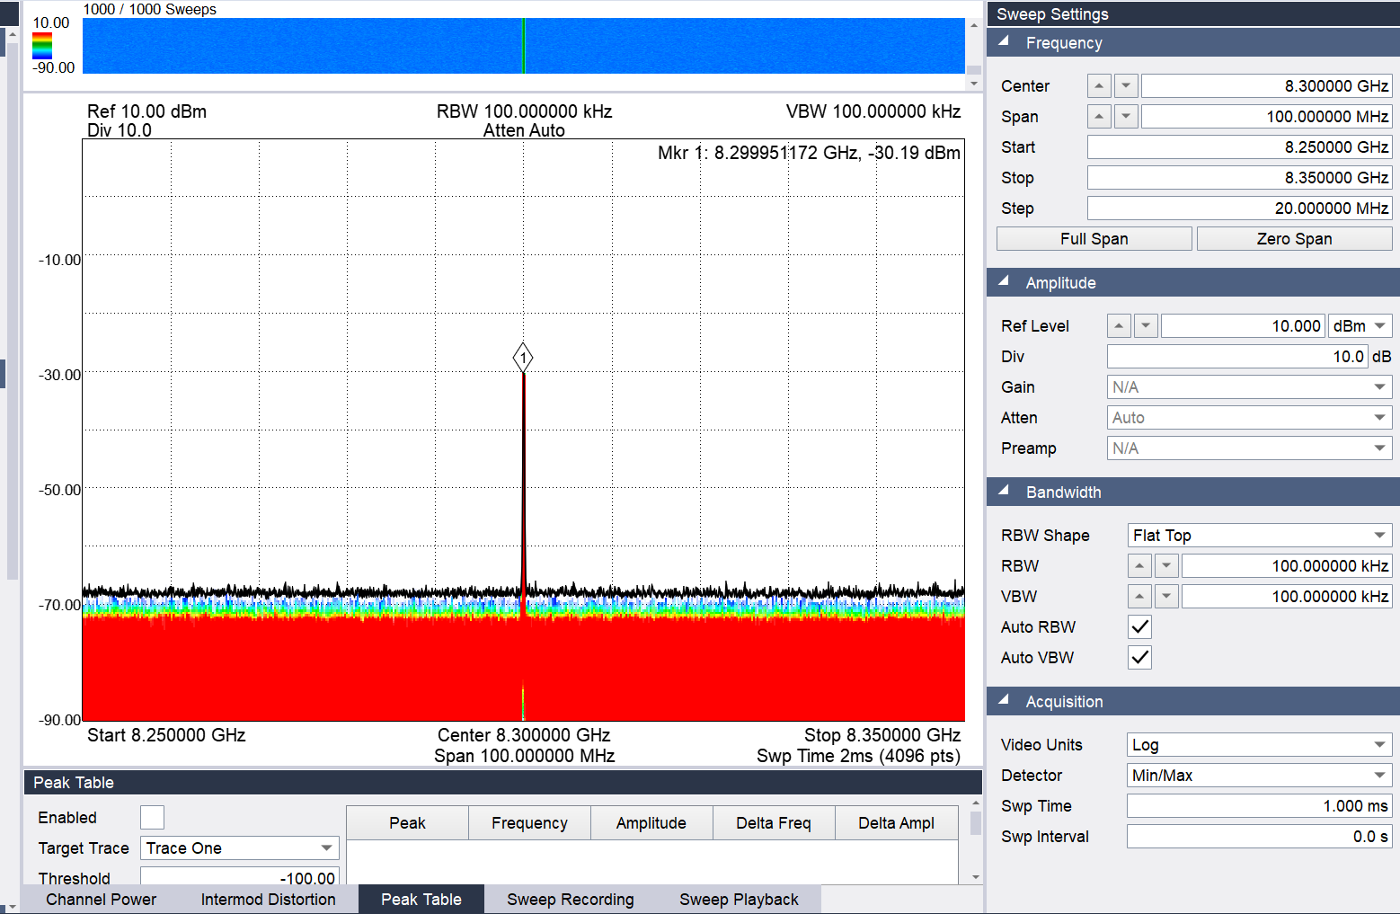
radar_test/spike_screens/test36_mixer_LO_feedthrough_31oct.png
