Sorin-Jayaweera/Panthalassa-Clinic-Team/radar_test/spike_screens/yippie_detector_tone_off_1us_1nov.png

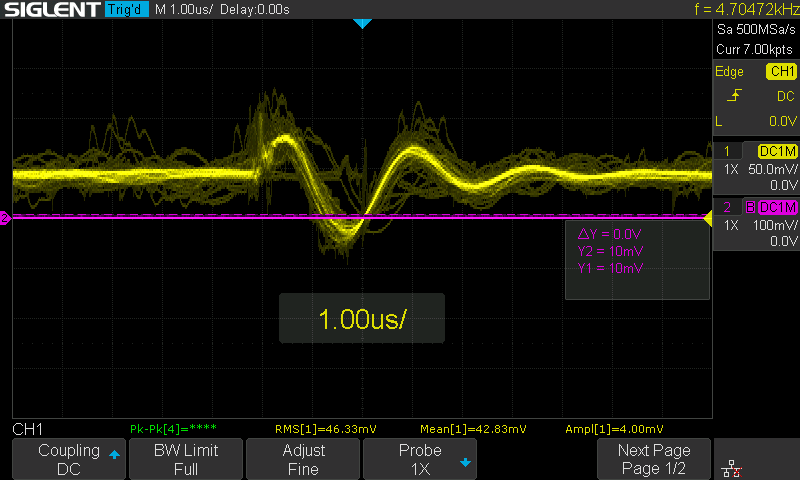
radar_test/spike_screens/yippie_detector_tone_off_1us_1nov.png
