Sorin-Jayaweera/Panthalassa-Clinic-Team/radar_test/vna/limiter_abs_S21.jpg

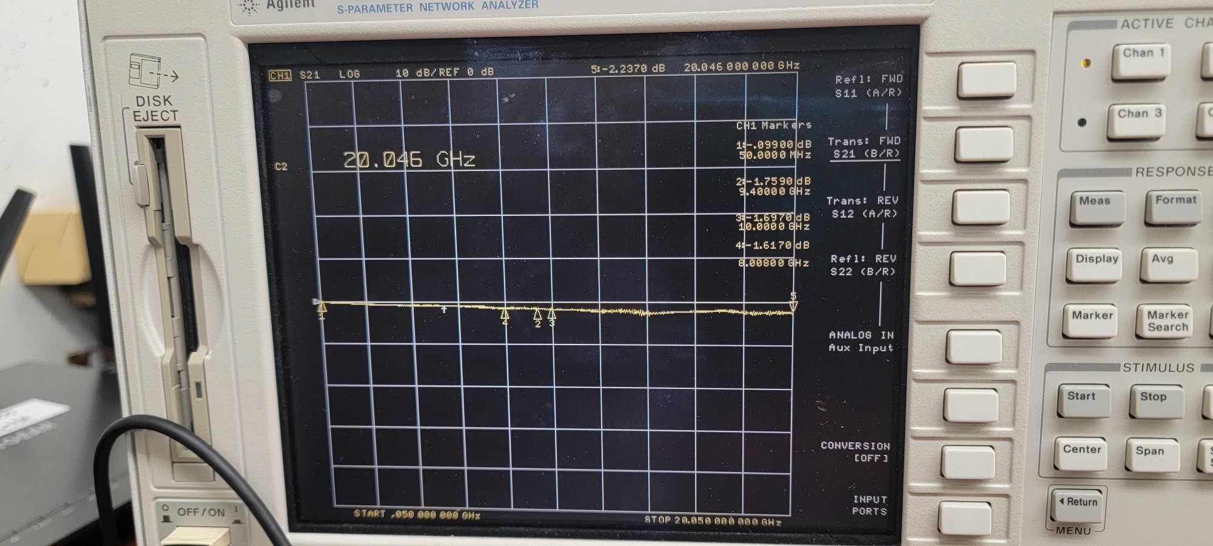
radar_test/vna/limiter_abs_S21.jpg
