Sorin-Jayaweera/Panthalassa-Clinic-Team/radar_test/vna/limiter_delta_S11.jpg

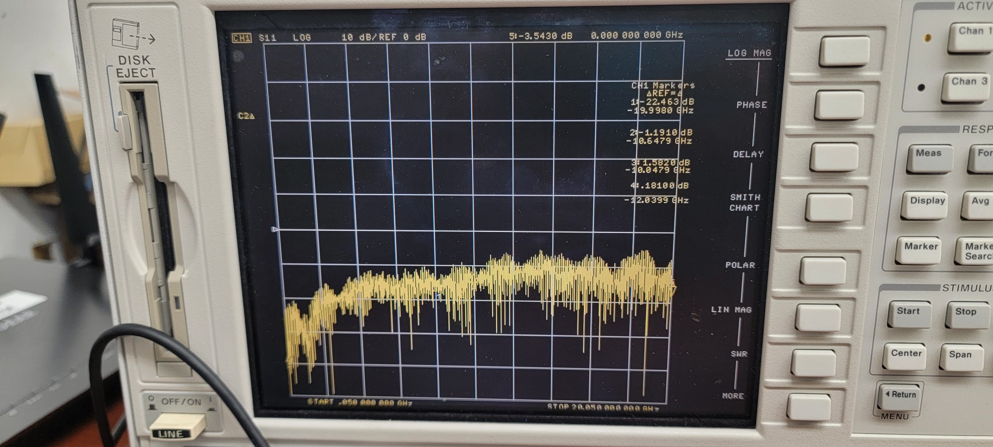
radar_test/vna/limiter_delta_S11.jpg
