Sorin-Jayaweera/Panthalassa-Clinic-Team/radar_test/vna/limiter_delta_S22.jpg

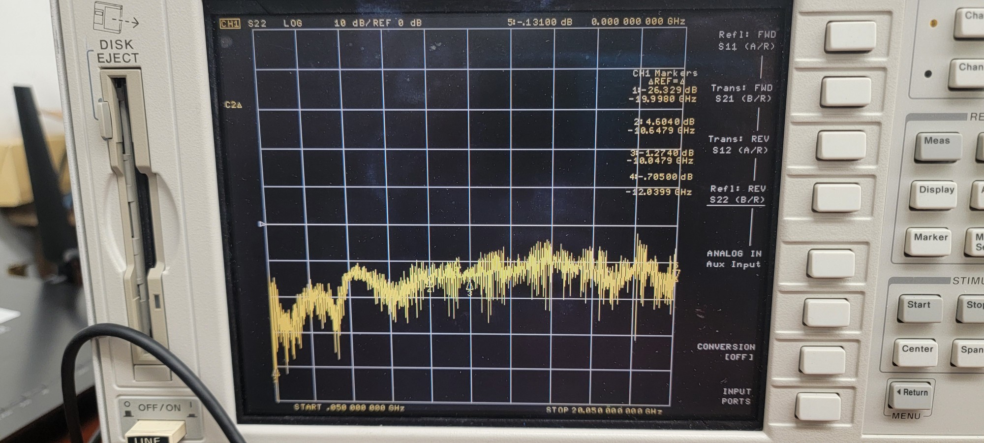
radar_test/vna/limiter_delta_S22.jpg
