Sorin-Jayaweera/Panthalassa-Clinic-Team/radar_test/vna/mixer30W_LOport1_RFport2_S21.jpg

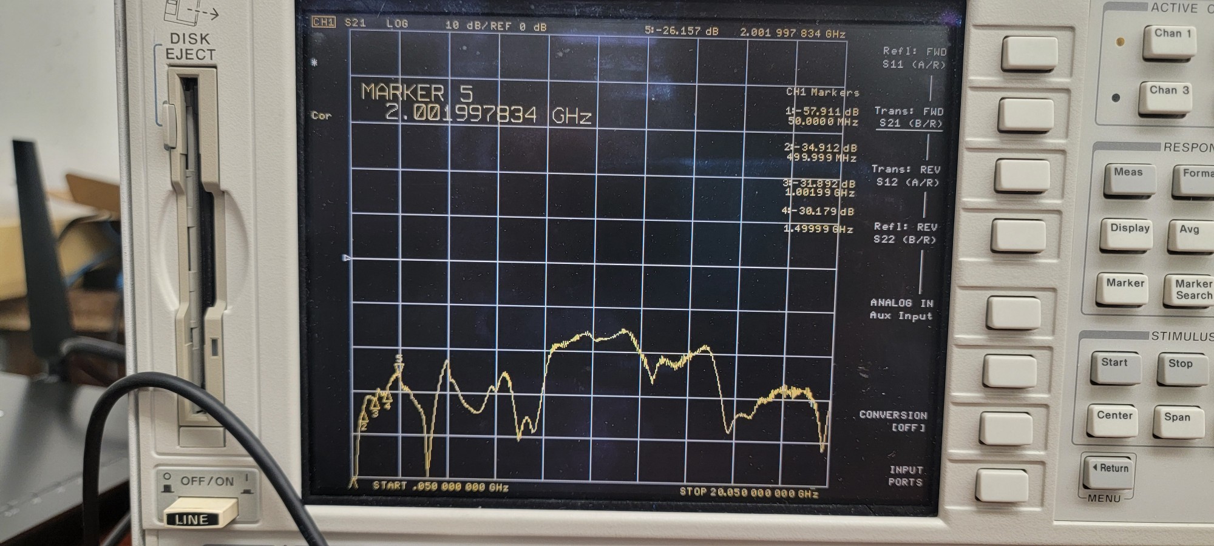
radar_test/vna/mixer30W_LOport1_RFport2_S21.jpg
