Sorin-Jayaweera/Panthalassa-Clinic-Team/radar_test/vna/pad3dB_S12_10dBdiv.jpg

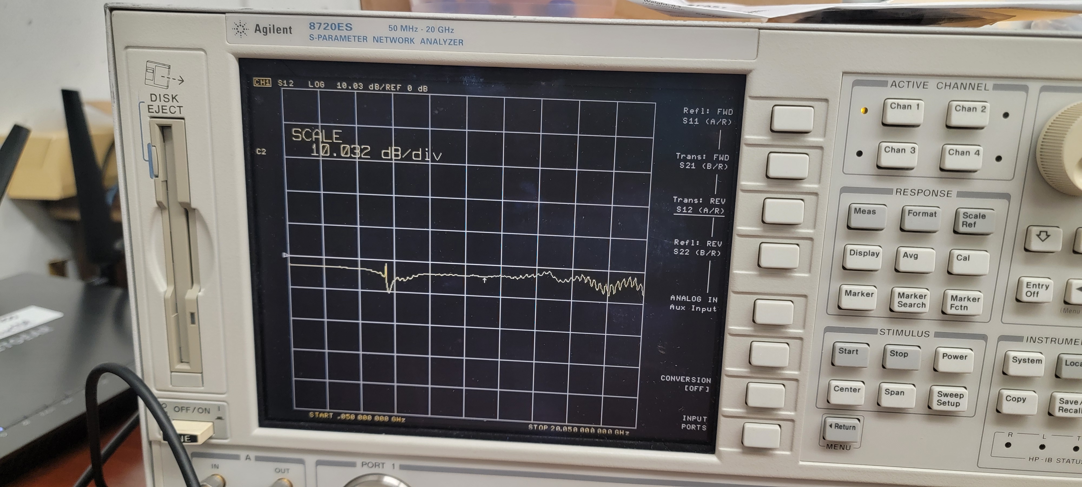
radar_test/vna/pad3dB_S12_10dBdiv.jpg
