Sorin-Jayaweera/Panthalassa-Clinic-Team/radar_test/vna/pad3dB_sweep2_S11_markers.jpg

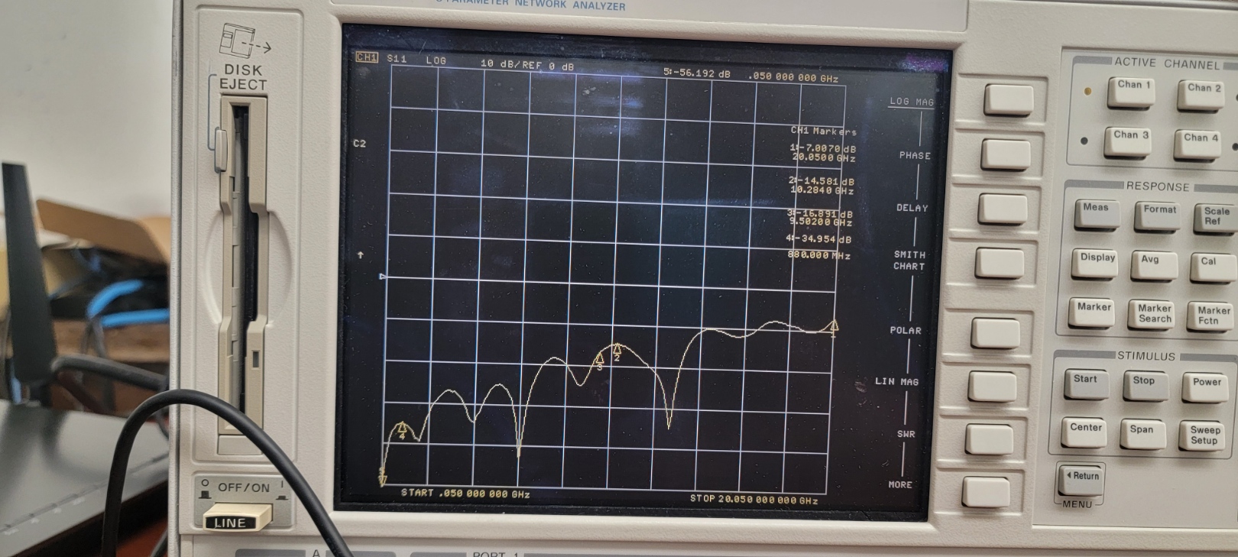
radar_test/vna/pad3dB_sweep2_S11_markers.jpg
