Sorin-Jayaweera/Panthalassa-Clinic-Team/radar_test/vna/pad3dB_sweep3_S12_markers.jpg

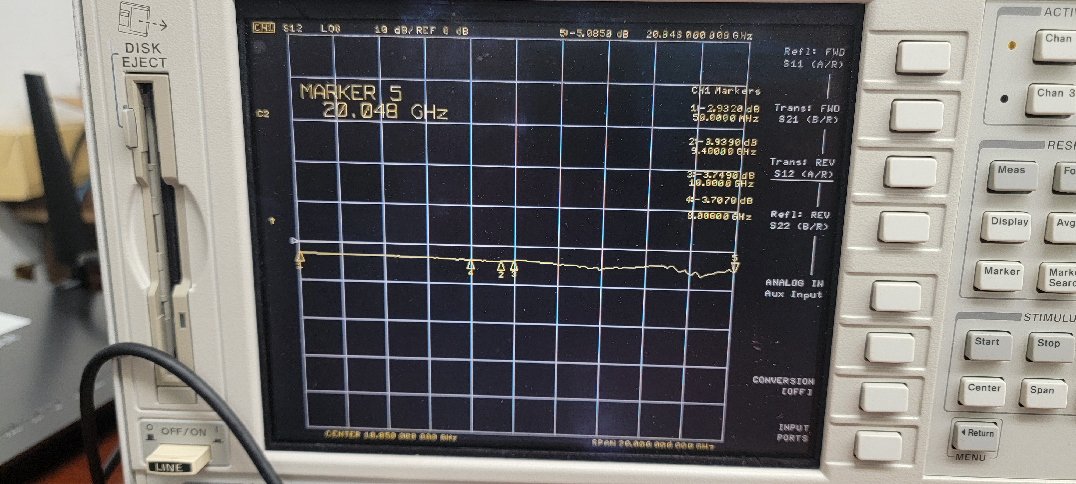
radar_test/vna/pad3dB_sweep3_S12_markers.jpg
