Sorin-Jayaweera/Panthalassa-Clinic-Team/radar_test/vna/pad6dB_S11_markers.jpg

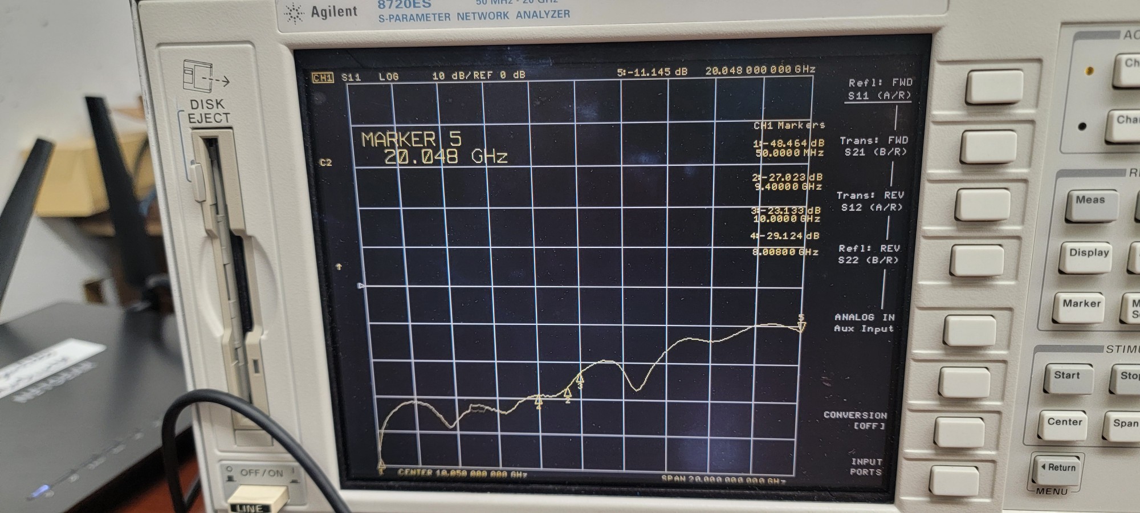
radar_test/vna/pad6dB_S11_markers.jpg
