Sorin-Jayaweera/Panthalassa-Clinic-Team/radar_test/vna/pad10dB_delta_S11.jpg

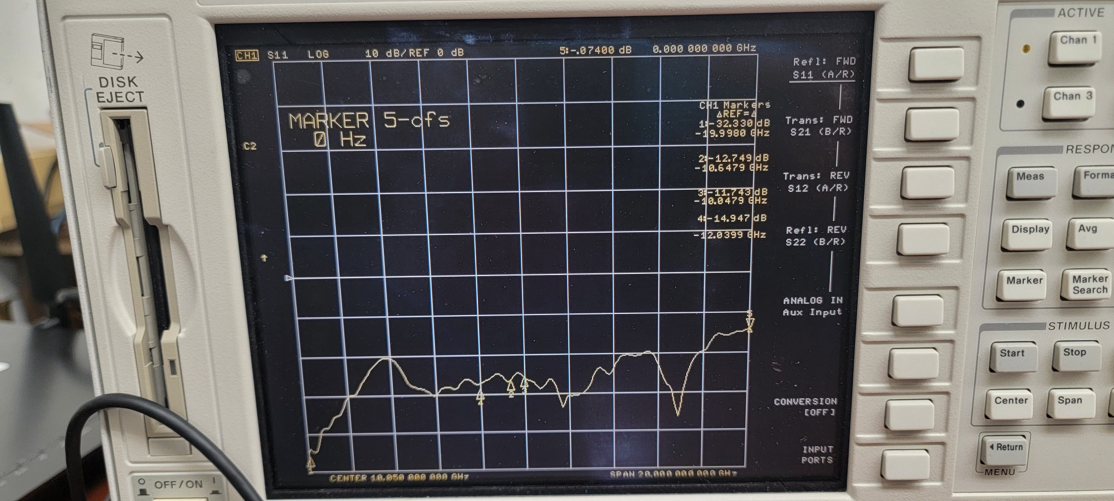
radar_test/vna/pad10dB_delta_S11.jpg
