Sorin-Jayaweera/Panthalassa-Clinic-Team/radar_test/vna/pad10dB_delta_S22.jpg

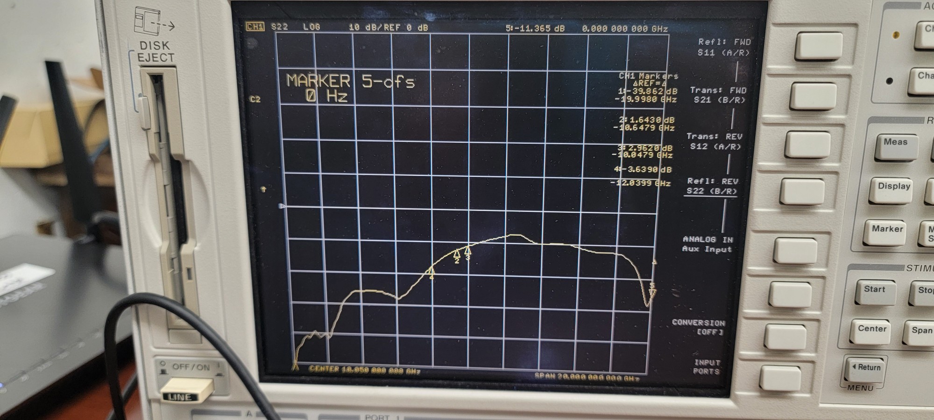
radar_test/vna/pad10dB_delta_S22.jpg
