Sorin-Jayaweera/Panthalassa-Clinic-Team/radar_test/vna/vivaldi_S11_delta_1601pts_interpolated.webp

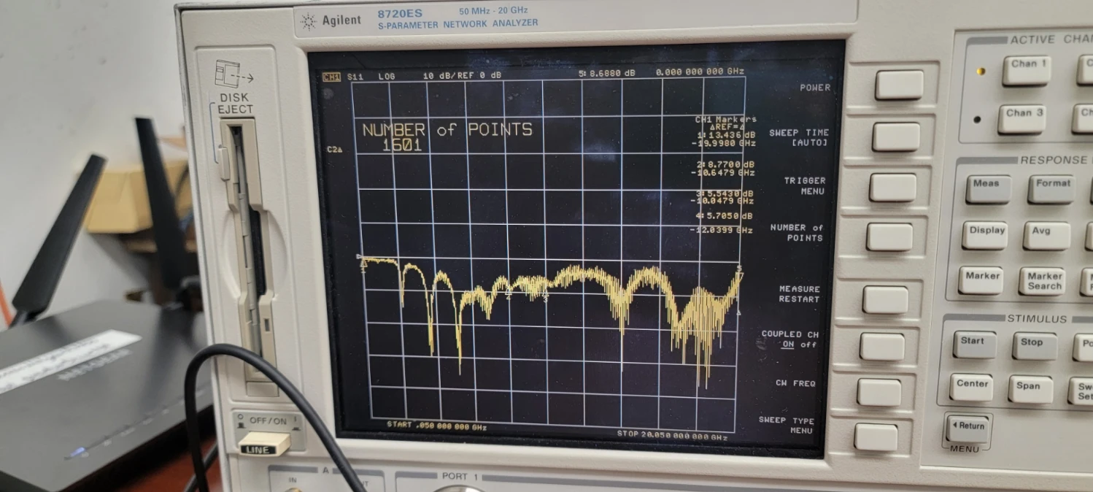
radar_test/vna/vivaldi_S11_delta_1601pts_interpolated.webp
