Sorin-Jayaweera/Panthalassa-Clinic-Team/simulations/claude/03_gnuradio_pluto/measurements/example_SYNTHETIC_measurement_comparison.png

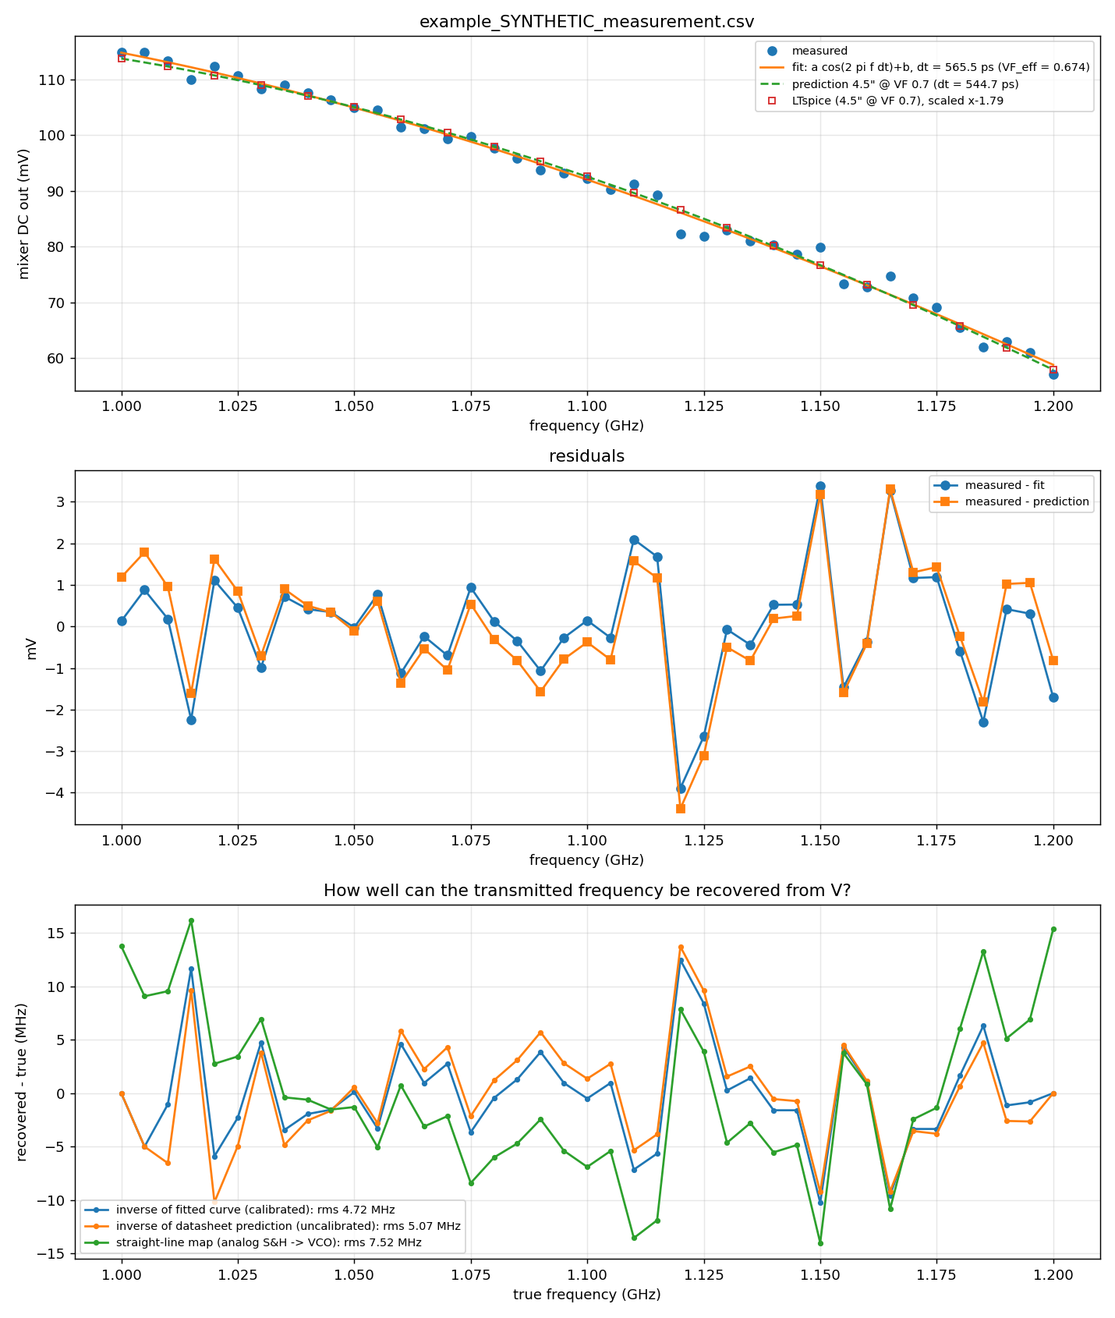
simulations/claude/03_gnuradio_pluto/measurements/example_SYNTHETIC_measurement_comparison.png
