Sorin-Jayaweera/Panthalassa-Clinic-Team/review/suggested_changes.md

# Suggested change

0 open. Generated from the GitHub issues; do not edit by hand.
