Sorin-Jayaweera/Panthalassa-Clinic-Team/cad/foam_enclosure/foam_enclosure_drawings.pdf

## SHEET 1 — CUT PLAN (7 boards)

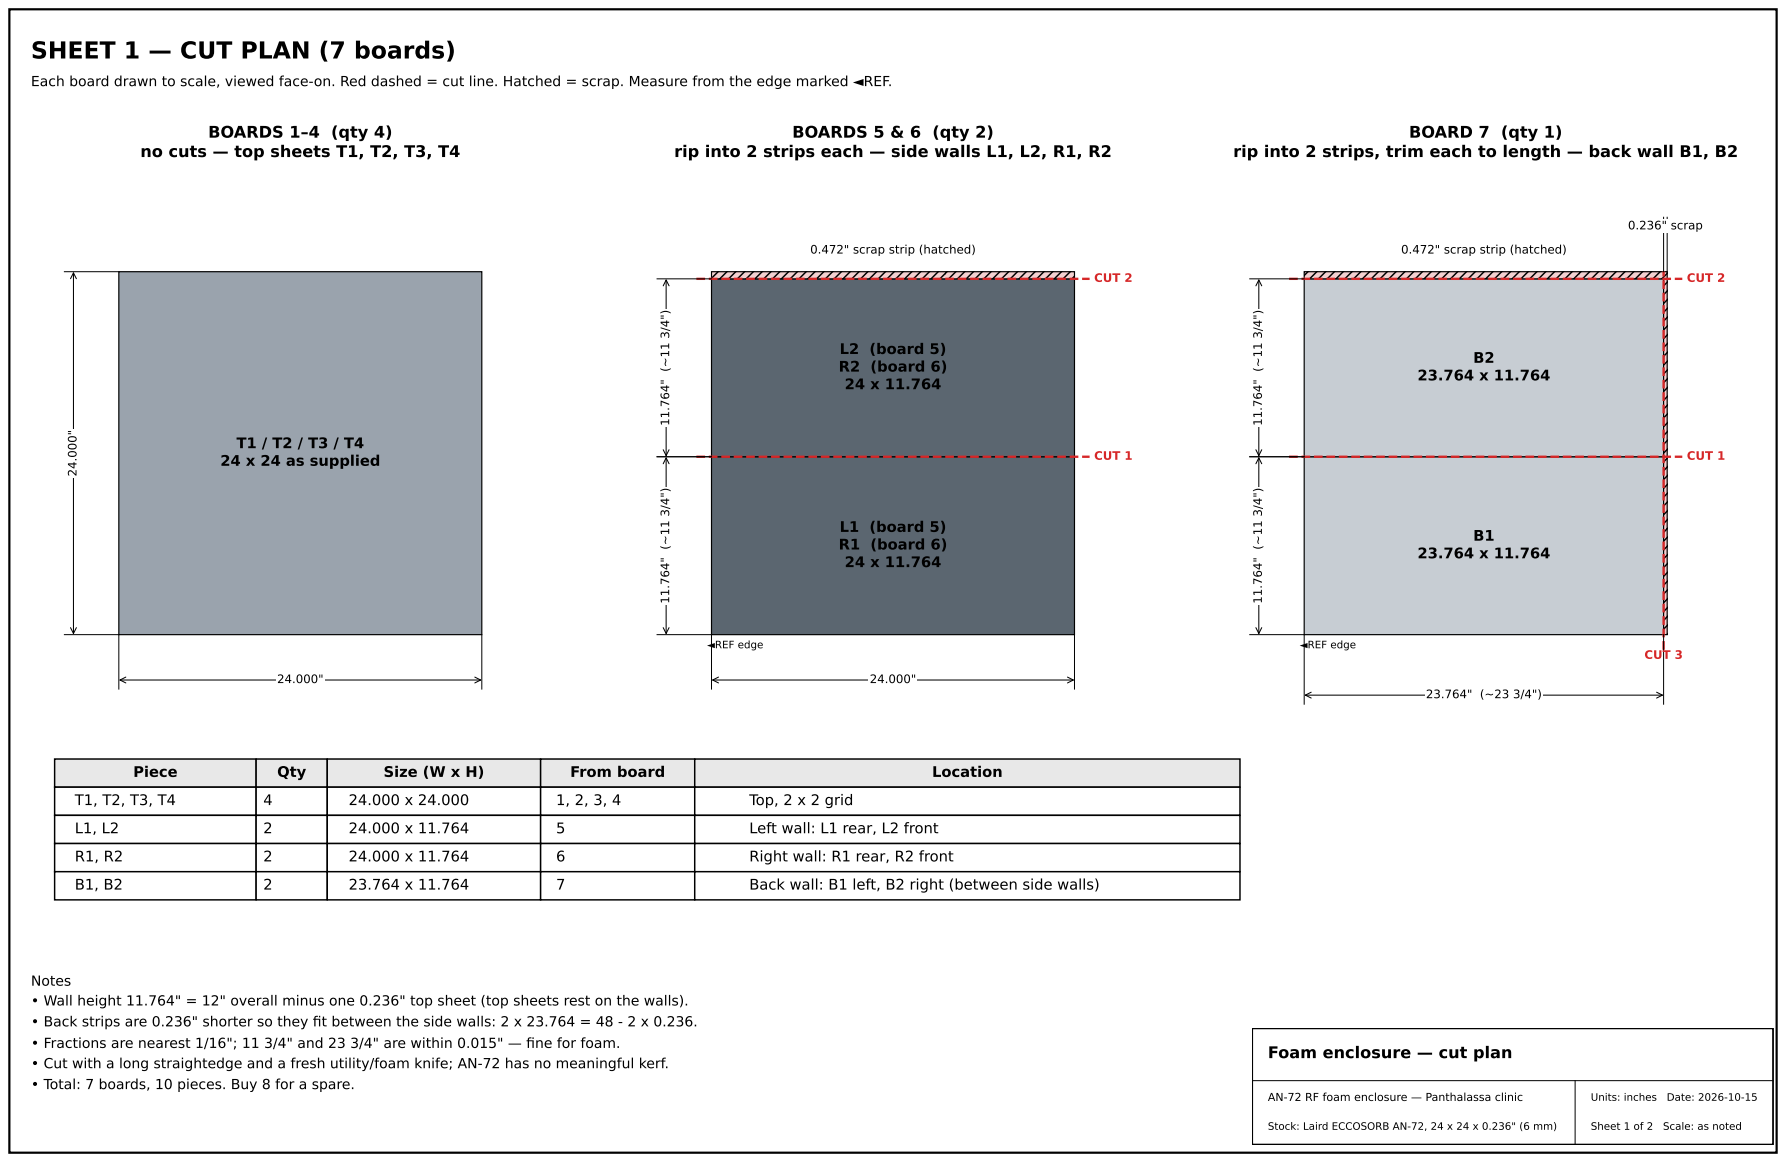
[picture p267: page 1]
T1 / T2 / T3 / T4 24 x 24 as supplied; BOARDS 1–4 (qty 4); L1 (board 5) R1 (board 6) 24 x 11.764; L2 (board 5) R2 (board 6) 24 x 11.764; CUT 1; CUT 2; ◄REF edge; BOARDS 5 & 6 (qty 2); CUT 3; scrap; BOARD 7 (qty 1); Piece; Qty; Size (W x H); From board; Location; Top, 2 x 2 grid; Left wall: L1 rear, L2 front; Right wall: R1 rear, R2 front; Back wall: B1 left, B2 right (between side walls)

Each board drawn to scale, viewed face-on. Red dashed = cut line. Hatched = scrap. Measure from the edge marked ◄REF.

no cuts — top sheets T1, T2, T3, T4

rip into 2 strips each — side walls L1, L2, R1, R2

rip into 2 strips, trim each to length — back wall B1, B2

0.472" scrap strip (hatched)

Notes
• Wall height 11.764" = 12" overall minus one 0.236" top sheet (top sheets rest on the walls).
• Back strips are 0.236" shorter so they fit between the side walls: 2 x 23.764 = 48 - 2 x 0.236.
• Fractions are nearest 1/16"; 11 3/4" and 23 3/4" are within 0.015" — fine for foam.
• Cut with a long straightedge and a fresh utility/foam knife; AN-72 has no meaningful kerf.
• Total: 7 boards, 10 pieces. Buy 8 for a spare.

Foam enclosure — cut plan

AN-72 RF foam enclosure — Panthalassa clinic

Units: inches Date: 2026-10-15

Stock: Laird ECCOSORB AN-72, 24 x 24 x 0.236" (6 mm)

Sheet 1 of 2 Scale: as noted

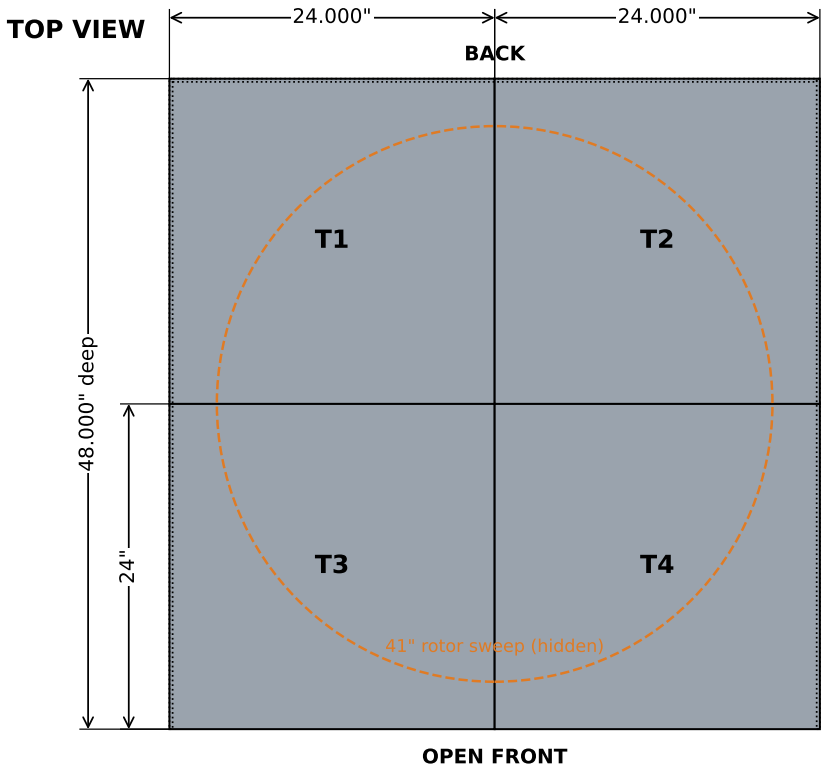
[picture p268: figure]
41" rotor sweep (hidden); OPEN FRONT; BACK; TOP VIEW; 24.000" 48.000" deep

L2 | B1 | 41" rotor (5" tall) | B2 | R2

FRONT VIEW (looking into the open front)

48.000" overall

47.528" inside

12.000"
11.764"

open bottom / floor

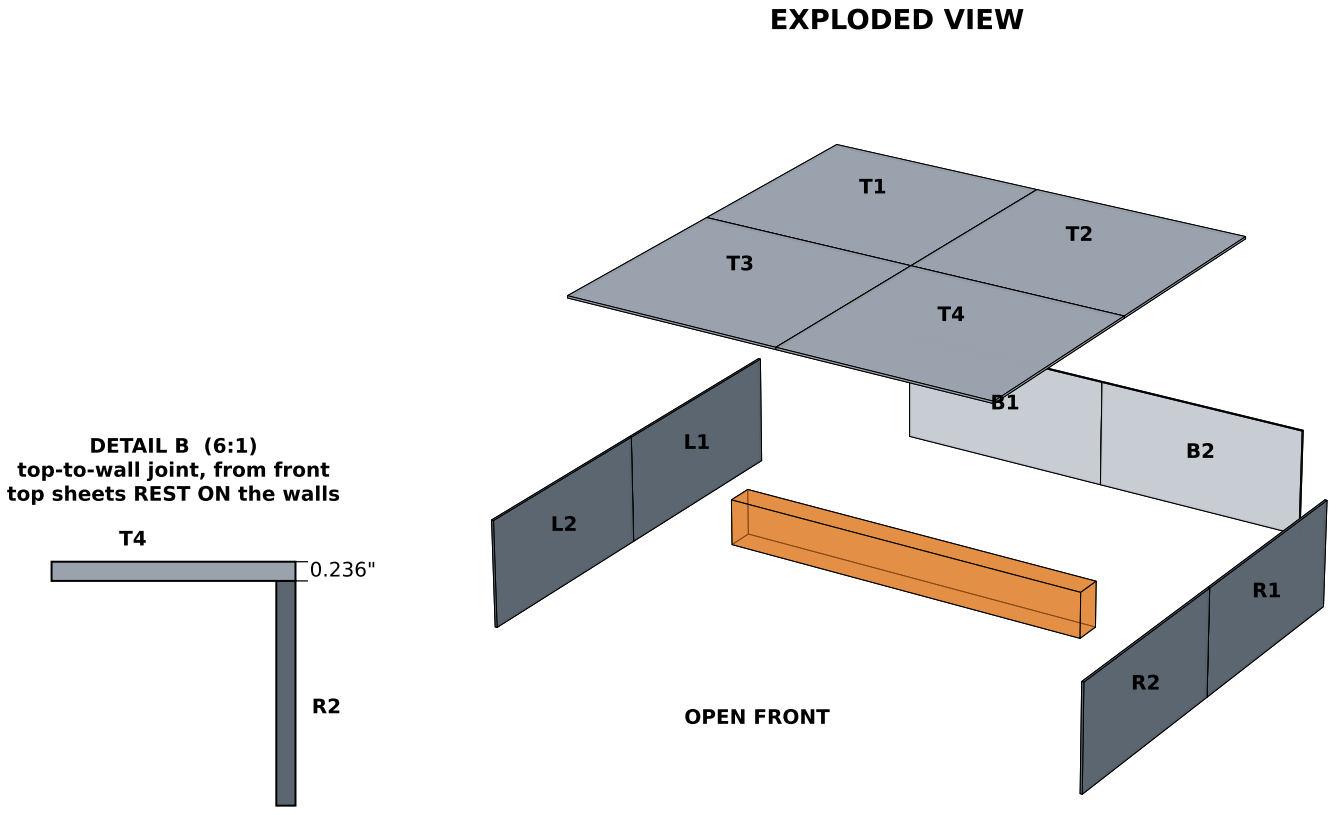
[picture p269: figure]
DETAIL B (6:1) top-to-wall joint, from front top sheets REST ON the walls; OPEN FRONT; EXPLODED VIEW

R2 (front half) | R1 (rear half) OPEN
FRONT | BACK

RIGHT SIDE VIEW

48.000" deep

24"

left wall L1/L2 is the mirror image

R1

B2

0.236"

DETAIL A (6:1)
rear-right corner, from above back strips fit INSIDE side walls

Foam enclosure — assembly

AN-72 RF foam enclosure — Panthalassa clinic

Stock: Laird ECCOSORB AN-72, 24 x 24 x 0.236" (6 mm)

Units: inches Date: 2026-10-15

Sheet 2 of 2 Scale: as noted

## SHEET 2 — ASSEMBLY (third-angle projection)

Front (+Z) and bottom are OPEN. Top, back, left, right are foam. Outer envelope 48 W x 48 D x 12 H.

ASSEMBLY ORDER
1. Stand the side walls: L2 + L1 butt end-to-end on the left (L2 at the front), R2 + R1 on the right. Outside faces 48.000" apart.
2. Fit the back wall B1 + B2 BETWEEN the side walls at the rear (Detail A). B1 on the left, B2 on the right; their seam sits on the centreline.
3. Lay the top: T1 rear-left, T2 rear-right, T3 front-left, T4 front-right, resting on the wall tops, flush with the outside faces (Detail B).
4. Leave the front and the bottom open.
5. Tape every butt seam from the outside so it can't open up.

Check: rotor sweep (41") has ~3.3" clearance to each side wall, and 11.764" of headroom over the 5" rotor.
