Sorin-Jayaweera/Panthalassa-Clinic-Team/simulations/claude/01_jacon_system/JACON_system.asc

X_CDLY: jacon_coax_dly
X_COMP: jacon_comparator
X_CREF: jacon_coax_ref
X_DAC: jacon_dac
X_DLSPL: jacon_split_res
X_ENV: jacon_env_det
X_FPGA: jacon_fpga_morse
X_IFAMP: jacon_if_amp
X_IFSPL: jacon_split_res
X_IRF: jacon_img_rej
X_KEY: jacon_key_sw
X_LIM: jacon_limiter
X_LIMAMP: jacon_lim_amp
X_LNA: jacon_lna
X_LOBUF: jacon_lo_buf
X_LOSPL: jacon_split_lo
X_MIXRX: jacon_mix_down
X_MIXTX: jacon_mix_up
X_OPA: jacon_opamp_scale
X_PA: jacon_pa
X_PD: jacon_phase_det
X_PLL: jacon_pll_lo
X_RADAR: jacon_radar_src
X_S1: jacon_tsel_rf; N1=4
X_S2: jacon_tsel_rf; N1=5 N2=6
X_S3: jacon_tsel_v; N1=7
X_S4: jacon_tsel_v; N1=7
X_S5: jacon_tsel_v; N1=8 N2=9
X_SH: jacon_sample_hold
X_SHC: jacon_sh_ctrl
X_TB: jacon_testbench
X_TXANT: jacon_tx_ant
X_VCO: jacon_vco
Named nets: rf_ant, rf_lim, rf_lna, if_mix, lo_rx, if_keyed, tx_mix, lo_tx, tx_filt, tx_out, lo_pll, lo_buf, if_amp, if_split_in, stim_if, if_to_lim, if_to_env, env, vth, det_raw, stim_pd, stim_det, stim_vtune, lim_in, lim_out, dl_ref_in, dl_dly_in, pd_rf, pd_lo, pd_out, sh_in, det, sh_ctrl, sh_hold, vtune_opa, vtune, if_vco, vco_f_GHz, key
[1] RX RF FRONT END   9.3-9.5 GHz
[8] TX RF CHAIN   back up to the radar frequency
[2] LO GENERATION   8.3 GHz
[3] IF CHAIN   1.0-1.2 GHz
[4] PULSE DETECTION  (is a radar pinging?)
[0] TEST BENCH STIMULI  (only active in per-block tests)
[5] LIMITING AMP  (remove amplitude info)
[6] DELAY-LINE DISCRIMINATOR  (frequency -> DC)
[7] SAMPLE & HOLD + SHIFT/SCALE  (DC -> VCO tune V)
[9] VCO + FPGA MORSE KEYING
JACON  -  Jason's RACON draft design  (LTspice behavioral model)
RX 9.3-9.5 GHz radar pulse -> 1.1 GHz IF -> detect + measure frequency with a delay line -> hold -> VCO -> key Morse '. - .' -> mix back up with the same LO -> TX at the radar frequency.
Every net is named: click a label to plot it. Voltages are RF amplitudes in 50 ohm: P(dBm) = 10*log10(V^2/100m).  Block models: jacon_blocks.inc.  Python plots: run_tests.py
.param TEST=0   ; <<<<<<<<<<<<  CHANGE THIS NUMBER TO PICK WHAT TO SIMULATE  >>>>>>>>>>>>
.param TSTOP=table(TEST, 0,2.1u, 1,40n, 2,5n, 3,20n, 4,650n, 5,60n, 6,176n, 7,4u, 8,50n, 9,460n, 10,300n)
.param TMAX=table(TEST, 0,2.5p, 1,2.5p, 2,1p, 3,2.5p, 4,20p, 5,10p, 6,10p, 7,0.5n, 8,10p, 9,2.5p, 10,2.5p)
.tran 0 {TSTOP} 0 {TMAX}
.include jacon_blocks.inc
TEST  what is exercised                          -> nets worth plotting
  0   FULL SYSTEM                radar pulse in -> detect -> measure f -> hold -> VCO -> Morse '. - .' out at the radar frequency
      probe: rf_ant, env, det, lim_out, pd_out, sh_hold, vtune, vco_f_GHz, key, tx_out
  1   RX FRONT END               CW 9.4 GHz power ramp P1_START..P1_STOP through limiter + LNA (compression / protection)
      probe: rf_ant, rf_lim, rf_lna
  2   LO CHAIN                   8.3 GHz PLL -> buffer -> splitter: LO drive levels at both mixers
      probe: lo_pll, lo_buf, lo_rx, lo_tx
  3   RX DOWNCONVERSION          CW radar -> LNA -> mixer -> IF amp: 1.1 GHz IF, 17.7 GHz sum, LO leak
      probe: rf_lna, if_mix, if_amp   (View > FFT)
  4   PULSE DETECTION            IF pulses of rising power -> envelope detector -> comparator vs DAC threshold
      probe: if_split_in, env, vth, det_raw
  5   LIMITING AMP               IF CW ramp P5_START..P5_STOP -> 3-stage limiter: output amplitude flattens
      probe: lim_in, lim_out
  6   DELAY-LINE DISCRIMINATOR   IF staircase 1.00..1.20 GHz (first step held twice to settle) -> limiter -> splitter -> delay lines -> phase detector (calibration)
      probe: lim_out, pd_rf, pd_lo, pd_out
  7   SAMPLE/HOLD + OP-AMP       ideal phase-detector levels + detect pulses -> S&H -> scaling op-amp (settling)
      probe: sh_in, det, sh_ctrl, sh_hold, vtune_opa
  8   VCO                        tune-voltage ramp VT8_START..VT8_STOP -> VCO frequency
      probe: vtune, vco_f_GHz, if_vco
  9   TX CHAIN                   VCO @ VT_CENTER keyed '. - .' -> up-mixer -> image-reject HPF -> PA
      probe: key, if_keyed, tx_mix, tx_filt, tx_out   (View > FFT)
 10   RX->TX FREQUENCY TRANSFER  pulse in, measure settled VCO f (use .step param F_RADAR ...; op-amp made fast)
      probe: add  .step param F_RADAR list 9.3e9 9.35e9 9.4e9 9.45e9 9.5e9 ; plot vco_f_GHz
TEST SELECT
PARAMETERS  (part values from the drawing; 'check' = assumed)
* ---- [0] RADAR ECHO STIMULUS ----
.param F_RADAR=9.4e9   ; radar frequency (9.3-9.5 GHz)
.param P_RADAR=-30     ; echo power at RX antenna port, dBm (-50 distant .. -10 close)
.param T_PULSE_ON=20n  ; pulse start
.param PW_RADAR=150n   ; pulse width (real radars 50 ns - 1.2 us)
.param T_RISE=1n       ; pulse edge time constant
.param P1_START=-60    ; TEST 1 ramp start (dBm)
.param P1_STOP=20      ; TEST 1 ramp stop (dBm)
* ---- [1] RX RF FRONT END ----
.param LIM_PMAX=17  ; power limiter flat leakage, dBm (Aaronia SMA limiter: 17 dBm @ 10 GHz)
.param LIM_IL=0.5   ; limiter insertion loss, dB (assumed)
.param ATT_RX=0     ; optional in-line attenuator to keep LNA < +15 dBm, dB
.param LNA_G=22     ; ZX60-5123LN+ gain, dB
.param LNA_P1DB=17  ; ZX60-5123LN+ output P1dB, dBm
* ---- [2] LO GENERATION ----
.param F_LO=8.3e9      ; ADF5355 frequency
.param P_PLL=3         ; ADF5355 output power at 8.3 GHz, dBm (VERIFY on your module)
.param LOBUF_G=12      ; ZX60-14012L-S+ gain, dB
.param LOBUF_P1DB=14   ; ZX60-14012L-S+ output P1dB, dBm (assumed - check datasheet)
.param LOSPLIT_IL=0.7  ; ZX10-2-1252-S+ excess loss, dB (on top of 3 dB split)
* ---- [1][8] MIXERS (ZX05-14LH-S+) ----
.param MIX_CL=6.7       ; conversion loss, dB
.param MIX_LO_NOM=10    ; LO level the loss is quoted at, dBm (LH = +10)
.param MIX_IFBW=4e9     ; IF port bandwidth (DC-4 GHz)
.param MIX_LOIF_ISO=25  ; LO->IF isolation, dB (assumed)
.param MIX_LORF_ISO=30  ; LO->RF isolation, dB (assumed)
* ---- [3] IF CHAIN ----
.param IFA_G=22.5      ; ZX60-P162LN+ gain, dB
.param IFA_P1DB=18     ; ZX60-P162LN+ output P1dB, dBm (assumed - check)
.param IFA_FHP=300e6   ; IF amp low corner (1-pole model)
.param IFA_FLP=2.5e9   ; IF amp high roll-off (3rd-order model)
.param F_IF_NOM=1.1e9  ; nominal IF used to normalise gains
* ---- [4] PULSE DETECTION ----
.param ENV_BW=130e6   ; ADL5511 envelope bandwidth
.param ENV_K=1        ; envelope out per volt of IF peak (idealised - check ADL5511 slope)
.param ENV_OFS=0      ; envelope output offset, V (ADL5511 real part has ~VREF offset)
.param VTH_DAC=15m    ; nanoDAC comparator threshold, V
.param COMP_VOD=0.5m  ; ADCMP600 overdrive for full swing, V
.param COMP_TPD=3.5n  ; ADCMP600 propagation delay
* ---- [5] LIMITING AMP ----
.param LIMA_G=17       ; gain per stage, dB (GALI-52+ / ERA-33SM+ class)
.param LIMA_P1DB=12    ; output P1dB per stage, dBm
.param LIMA_FLP=1.6e9  ; harmonic clean-up low-pass after the limiter
* ---- [6] DELAY-LINE DISCRIMINATOR ----
.param VF=0.70         ; coax velocity factor (PTFE ~0.70, foam ~0.8x, air 1.0)
.param L_REF_IN=6      ; reference arm length, inches
.param DL_IN=4.5       ; EXTRA length of delayed arm, inches  <-- design variable
.param COAX_DB_FT=0.4  ; coax loss at ~1.1 GHz, dB/ft (RG-316 ~0.4)
.param MIXMODE=1       ; phase detector: 0 = ideal multiplier, 1 = double-balanced mixer
.param PD_CL=6         ; ZX05-30W-S+ conversion loss, dB
.param PD_LO_NOM=7     ; ZX05-30W-S+ LO level, dBm (Level 7)
.param PD_FLP=100e6    ; phase-detector output low-pass (removes 2f)
* ---- [7] SAMPLE/HOLD + SCALING ----
.param SH_DLY=40n      ; FPGA: sample starts this long after detect
.param SH_WIDTH=40n    ; FPGA: sample window length
.param SH_RON=120      ; ADG1211 on-resistance, ohm (check datasheet)
.param SH_ROFF=1G      ; ADG1211 off-resistance
.param SH_C=100p       ; C0G hold capacitor
.param PD_V0=-0.3372   ; phase-detector volts at F_IF_NOM  (from TEST 6 calibration; redo if you change [5]/[6])
.param OPA_GAIN=19.46  ; op-amp gain, V/V  (from TEST 6 calibration; redo if you change [5]/[6]/VCO)
.param VT_CENTER=7.75  ; VCO tune voltage for F_IF_NOM
.param OPA_VMIN=0      ; op-amp output low rail, V
.param OPA_VMAX=11.5   ; op-amp output high rail, V
.param OPA_GBW=8e6     ; ADA4622 gain-bandwidth, Hz (check) - sets tune settling
* ---- [9] VCO + MORSE KEYING ----
.param VCO_V1=6            ; CVCO55BE tune point 1, V
.param VCO_F1=1.0e9        ; ... frequency at VCO_V1
.param VCO_V2=9.5          ; CVCO55BE tune point 2, V
.param VCO_F2=1.2e9        ; ... frequency at VCO_V2
.param VCO_FMIN=0.8e9      ; VCO lower limit
.param VCO_FMAX=1.6e9      ; VCO upper limit
.param P_VCO=3             ; VCO output power, dBm (check datasheet)
.param MORSE_UNIT=60n      ; Morse dot length (SHORTENED for simulation; real racon ~us)
.param MORSE_HOLDOFF=1.6u  ; FPGA delay from detection to first dot
.param KEY_TR=2n           ; ADG901 switching time constant
.param KEY_ISO=40          ; ADG901 off isolation at 1 GHz, dB (check)
.param KEY_IL=1            ; ADG901 insertion loss, dB
* ---- [8] TX RF CHAIN ----
.param IRF_FC=8.2e9  ; image-reject HPF ripple corner (9th-order 0.5 dB Chebyshev ~ VHF-8400+)
.param IRF_IL=1.0    ; image-reject filter extra loss, dB
.param PA_G=30       ; power amp gain, dB (ZVE-143-S+ class - check)
.param PA_P1DB=30    ; power amp output P1dB, dBm (~1 W)
* ---- TEST-BENCH STIMULI ----
.param F_IF_TEST=1.1e9  ; IF test tone (tests 4, 5)
.param P4_START=-35     ; TEST 4: first pulse power at IF splitter input, dBm
.param P4_STEP=10       ; TEST 4: power step per pulse, dB
.param T4_PER=150n      ; TEST 4: pulse period
.param T4_PW=60n        ; TEST 4: pulse width
.param P5_START=-50     ; TEST 5: ramp start at limiter input, dBm
.param P5_STOP=5        ; TEST 5: ramp stop, dBm
.param P6=-20           ; TEST 6: tone power at limiter input, dBm
.param F6_START=1.0e9   ; TEST 6: staircase start
.param F6_STEP=10e6     ; TEST 6: staircase step
.param T6_STEP=8n       ; TEST 6: time per step
.param T7_PER=1u        ; TEST 7: sample period
.param T7_PW=100n       ; TEST 7: detect pulse width
.param T7_DV=0.05       ; TEST 7: phase-detector level step, V
.param VT8_START=5      ; TEST 8: tune ramp start, V
.param VT8_STOP=10.5    ; TEST 8: tune ramp stop, V
