Sorin-Jayaweera/Panthalassa-Clinic-Team/phase_detector_calibration/site/content_radar_tests.py

"""Radar tab, top section: every over-the-air power reading of 25 and 26 Oct 2026, grouped by what was on the SM200B input.

Each test is one sentence that expands. Inside: Sorin's own words and numbers (quoted from the session transcript; times are
Pacific, UTC-7), the setup, then a collapsed "AI analysis" with derived numbers. The same tests in one table:
radar_test/test_log.md. Who read each number: "Sorin" = Sorin read it off Spike or said it; "Spike" = Claude read a
Spike screenshot; "I/Q" = Claude's own Python capture from the SM200B."""
from content import item, table, ul, p, h, fig

# The radar: Furuno 1722C/NT, long pulse (24 nm range), 9402.6 MHz, 0.68 us pulses, 604 pulses/s, 2.2 kW peak (spec).
# Pads: fixed 8 GHz-rated SMA attenuators. "29 dB" = 3 + 6 + 10 + 10. "14 dB" = 10 + 2 + 2.

T = {}


def t(n, date, time, dist, chain, cond, sm, who, far, sorin, setup, ai):
    T[n] = dict(n=n, date=date, time=time, dist=dist, chain=chain, cond=cond, sm=sm, who=who, far=far, sorin=sorin, setup=setup, ai=ai)


LEAK = "no source in the chain; this is radar leaking straight into the SM200B, cables and pads"

# ------------------------------------------------------------------ A. 50 ohm load
t("16", "25 Oct", "16:52", "3.96 m (13 ft)", "50 &Omega; load &rarr; 29 dB pads &rarr; SM200B", "foam off",
  "&minus;20.5 dBm", "Spike", LEAK,
  ["&ldquo;I unplugged the vivaldi and long cable it was connected to, and put a 50 ohm termination&rdquo; (16:51)."],
  ["Load in place of the Vivaldi and its long cable; the 29 dB of pads stayed on the SM200B."],
  ["More than the Vivaldi read in the same place a few minutes earlier (test 15, &minus;25.9 dBm). First proof that most of what the SM200B saw at 13 ft did not come through the antenna.",
   "A 50 &Omega; load cannot receive anything, so every dBm here is leakage: through the SM200B case and leads, the pads, the joints."])
t("17", "25 Oct", "16:55", "3.96 m (13 ft)", "50 &Omega; load directly on the SM200B input (no pads)", "foam off",
  "&minus;15.7 dBm", "Spike", LEAK,
  ["&ldquo;terminator is on the signal hound input now, no pads. Just 50 ohm term to a line to the signal hound&rdquo; (16:54)."],
  ["The 29 dB of pads removed; the 50 &Omega; termination screwed straight onto the SM200B input. No cable."],
  ["5 dB more than the load through 29 dB of pads (test 16) a few minutes earlier: adding 29 dB took off only 5 dB, so most of the leak enters the SM200B itself, not through its input.",
   "Same wiring as test 21 the next day (&minus;22.5 dBm); the 7 dB difference is the radar and SM200B not being in exactly the same places and the cables around them.",
   "SM200B safety: 35 dB under its +20 dBm limit."])
t("20", "26 Oct", "18:13&ndash;18:16", "3.96 m (13 ft)", "50 &Omega; load (ANNE-50L+) &rarr; 29 dB pads &rarr; SM200B", "foam off",
  "&minus;22.9 dBm", "Spike", LEAK,
  ["&ldquo;Can I use a DC-12 gigahertz MCLANNE-50L plus serial number 3-1909 50 ohm load? I'm going to put it after all the attenuators, so I'll still have 29 dB.&rdquo; (18:12)",
   "&ldquo;spike is open, radar is on. Look at the screen. This is with the 29 dB attenuators and then the 50 ohm load.&rdquo; (18:13)"],
  ["Load: Mini-Circuits ANNE-50L+ (DC&ndash;12 GHz), serial 3-1909, screwed onto the last pad.",
   "First read with Spike on its default Average detector (live trace about &minus;90 dBm, persistence &minus;78 dBm), then with Min/Max, Log, 3 MHz RBW, Max Hold: &minus;22.9 dBm."],
  ["The Average-detector numbers are not peak readings: they average a 0.68 &micro;s pulse with 1.6 ms of silence. Claude first called that a &minus;90 dBm leak; it was wrong and corrected 3 minutes later.",
   "Same wiring as test 16 the day before (&minus;20.5): the leak at 13 ft with 29 dB of pads is about &minus;21 to &minus;23 dBm."])
t("21", "26 Oct", "18:19", "3.96 m (13 ft)", "50 &Omega; load directly on the SM200B input", "foam off",
  "&minus;22.5 dBm", "Spike", LEAK,
  ["&ldquo;Is the 50 ohm load going directly into the +20 dBm max port? Is it okay for me to turn on the radar?&rdquo; (18:18)"],
  ["Pads removed; the ANNE-50L+ load screwed straight onto the SM200B&rsquo;s Type N input (through its SMA adapter)."],
  ["Same as with 29 dB of pads in front (test 20). So the leak is not coming through the pads: it gets into the SM200B itself."])
t("22", "26 Oct", "18:22", "3.96 m (13 ft)", "50 &Omega; load directly on the input, SM200B wrapped in AN-72 foam", "foam off the radar",
  "&minus;25.7 dBm (Max Hold)", "Spike", LEAK,
  ["&ldquo;So I just wrapped most of the outside of the signal found in the AN72 foam board. The front is still exposed, and it's not like tight around it, but it is around it fairly strongly. I'm going to test again the exact same setup where it's 50 ohm low directly into the plus 20 dBm max port.&rdquo; (18:22)",
   "&ldquo;Radar is now on. It is at around -30.&rdquo; (18:22)"],
  ["AN-72 absorber around the SM200B case, front panel and connector exposed."],
  ["Sorin saw about &minus;30 dBm on the live trace; Max Hold over the run caught &minus;25.7 dBm. The foam on the box takes about 3 dB off the leak."])
t("23", "26 Oct", "18:26", "3.96 m (13 ft)", "50 &Omega; load directly on the input, SM200B wrapped, whiteboard between the radar and the SM200B", "foam off the radar",
  "&minus;19.43 dBm", "Sorin", LEAK,
  ["&ldquo;Holy shit. I put the whiteboard in between the SM200B and the radar, and I got negative 19.43 dBm immediately when I turned it on. So we got much stronger values than before. My understanding of metal as Faraday cages might be wrong, because this is a solid block of metal instead of having holes. [&hellip;] Is the whiteboard acting like a transmitting antenna?&rdquo; (18:26)",
   "&ldquo;I forgot that we don't have the attenuators on right now.&rdquo; (18:31)"],
  ["Whiteboard (metal sheet) standing between the radar and the SM200B; no pads."],
  ["6 dB more than without the board (test 22). The board is not transmitting: it reflects. In a room, a metal sheet sends energy round its edges and off the walls, and the 2.6 s rotation means the beam sweeps across many paths. A sheet only shadows well when it is much bigger than the beam and nothing reflects behind it."])
t("24", "26 Oct", "18:33", "3.96 m (13 ft)", "50 &Omega; load &rarr; 29 dB pads &rarr; SM200B", "SM200B wrapped in AN-72, whiteboard between, foam off the radar",
  "&minus;25 dBm", "Sorin", LEAK,
  ["&ldquo;when I put in the attenuators, I go from -19 dBm to -25 dBm. Which means a lot of it is still coupling to the front end and only a little bit is coupling to the end and then going through the attenuators.&rdquo; (18:33)"],
  ["Test 23&rsquo;s setup (&minus;19 dBm) with the 29 dB of pads put back between the load and the SM200B."],
  ["Adding 29 dB took off only 6 dB. About &minus;25 dBm gets into the SM200B whatever is on its input (case, front panel, USB and power leads); the extra 6 dB entered at the load and adapter when they sat directly on the input.",
   "Rule from this: a reading must be at least 20 dB above the load reading for the same wiring before it can be called signal."])
t("25a", "26 Oct", "18:40", "11.3&ndash;11.5 m (37 ft)", "50 &Omega; load &rarr; 29 dB pads &rarr; SM200B", "whiteboard in, foam off",
  "&minus;34 to &minus;32 dBm", "Sorin", LEAK,
  ["&ldquo;The radar is now 11 meters away. The whiteboard is still in the way. It's just the 50 ohm and then attenuators. I'm turning it on.&rdquo; (18:39)",
   "&ldquo;Right now it's transmitting the direct path from radar at 11.5 meters away to the SM200B with just the 50 ohm load and attenuators.&rdquo;",
   "&ldquo;I measure a background of negative 34 to negative 32 dBm. I'm now moving the whiteboard out of the way to measure.&rdquo; (18:40)"],
  ["Radar moved back to the 25 Oct position."],
  ["About 10 dB less leak than at 13 ft, as expected for 2.9&times; the distance (20 log 2.9 = 9.3 dB)."])
t("25b", "26 Oct", "18:40", "11.3&ndash;11.5 m (37 ft)", "50 &Omega; load &rarr; 29 dB pads &rarr; SM200B", "whiteboard out, foam off",
  "&minus;31.2 dBm", "Spike (Sorin confirmed)", LEAK,
  ["&ldquo;with the whiteboard out of hte way I got the -31.2 dBm&rdquo;"],
  ["Spike: 3 MHz RBW, Min/Max, Max Hold, 9.40625 GHz. Screenshot: <code>radar_test/spike_screens/test25b_leak_50ohm_load_29dB_pads_11p5m_whiteboard_out_rbw3MHz.jpg</code>."],
  ["<b>The leak floor at 11.5 m.</b> The whiteboard changes it by only 1&ndash;3 dB at this distance.",
   "What it means for 25 Oct: test 7 (Vivaldi, &minus;20.3 dBm) was 11 dB above this, so mostly signal. Tests 11 and 12 (&minus;29.4, &minus;30.2) were at this floor, so they were mostly leak and the 0.8 dB limiter loss taken from them cannot be trusted."])
t("26a", "26 Oct", "18:43", "11.5 m", "50 &Omega; load &rarr; limiter &rarr; 10 dB &rarr; LNA (off) &rarr; 10 + 10 + 6 + 3 dB &rarr; SM200B", "whiteboard out, foam off",
  "&minus;31 dBm", "Sorin", LEAK,
  ["&ldquo;Okay, it's now 50 ohm load, then power limiter, then the amplifier, which is currently turned off, and then the attenuators to the signal mount.&rdquo; (18:42)",
   "&ldquo;We got the same negative 31 dBm.&rdquo; (18:43)",
   "&ldquo;The setup as it is right now is power limiter, then 10 dB, then amplifier, and then 10 dB, then 10 dB, then 6 dB, then 3 dB attenuators. This is how it has been&rdquo; (18:46)"],
  ["Load on the limiter input (where the antenna goes). 10 dB before the LNA, 29 dB after."],
  ["Same as the load alone (25b): the limiter, the extra pad and the unpowered LNA add no pickup of their own."])
t("26b", "26 Oct", "18:43", "11.5 m", "50 &Omega; load &rarr; limiter &rarr; 10 dB &rarr; LNA (on, 6 V) &rarr; 29 dB &rarr; SM200B", "whiteboard out, foam off",
  "&minus;28 dBm", "Sorin", LEAK,
  ["&ldquo;I'm going to turn on the amplifier. Amplifier is on.&rdquo; &ldquo;With the amplifier on, we get -28 dBm.&rdquo; (18:43)"],
  ["As 26a with the LNA powered at 6 V."],
  ["+3 dB over 26a. A 3 dB rise means a second leak of the same size has been added: pickup between the load and the LNA input (limiter, pad, joints), amplified 22 dB, about equals the leak that enters after the LNA. The LNA is not oscillating (that would raise the whole span or show a line away from 9.4 GHz)."])
t("26c", "26 Oct", "18:48", "11.5 m", "50 &Omega; load &rarr; limiter &rarr; 10 + 10 dB &rarr; LNA (on) &rarr; 10 + 6 + 3 dB &rarr; SM200B", "whiteboard out, foam off",
  "&minus;24.06 dBm", "Sorin", LEAK,
  ["&ldquo;Instead of this now, the 50 ohm load, then the power limiter, then 2 10 dB attenuators, then the amplifier, and then 10 dB, 6 dB, 3 dB, then signal hound.&rdquo; (18:48)",
   "&ldquo;I'm turning on the amplifier and turning on the radar. I read -24.06 dBm at the peak.&rdquo; (18:48)"],
  ["One 10 dB pad moved from after the LNA to before it, so the LNA stays linear when the antenna goes back on (test 27)."],
  ["<b>The leak floor for tests 27 and 28.</b> 4 dB above 26b because there is 10 dB less padding after the LNA."])

# ------------------------------------------------------------------ B. Vivaldi
t("1", "25 Oct", "11:44", "11.3 m (37 ft)", "Vivaldi &rarr; JFW manual attenuator at 50 dB &rarr; 10 + 2 dB &rarr; SM200B", "radar off",
  "noise &minus;66 dBm (100 kHz RBW)", "I/Q", "radar off: background only",
  ["&ldquo;I have a 10 dBm 8G attenuator, a 2 dBm 8G attenuator, then going to a manual attenuator. [&hellip;] model 50DR-046SMA, serial 803383-2225, made by JFW Industries&rdquo; (11:11)",
   "&ldquo;It is 37 feet away. [&hellip;] The Vivaldi is really bad at picking up stuff. It's noisy. It's also pointed away. And I put [&hellip;] a whiteboard in between the direct line of sight path. Plus there's the foam on the radar. Plus I have all the attenuators.&rdquo; (12:03)",
   "&ldquo;To assuage your fears, I added another 2 dB at 8G attenuator.&rdquo; (12:06) &rarr; 10 + 2 + 2 = 14 dB.",
   "Radar supply: &ldquo;I see 12 volts, 4.64 amps. The radar is not spinning, but I see the screen on.&rdquo; (11:59)"],
  ["Safe-start reference before the radar transmitted."],
  ["The JFW 50DR-046 is rated DC&ndash;2.5 GHz. At 9.4 GHz it gives almost no attenuation whatever the dial says, so it is not counted in any later number."])
t("2", "25 Oct", "12:15", "11.3 m (37 ft)", "Vivaldi pointed away &rarr; manual attenuator 50 dB &rarr; 14 dB &rarr; SM200B", "whiteboard in, AN-72 foam on the radar",
  "&minus;38.8 dBm (one pulse, 10 MHz)", "I/Q", "not worked out (antenna pointed away)",
  ["&ldquo;The radar is on.&rdquo; (12:13) &ldquo;it does show lp.&rdquo; (12:18, long pulse)",
   "&ldquo;I did set ref level to 0, so now you see the peak at like negative 80, sometimes going up to like negative 70, and div is 10 dB per division. [&hellip;] when I change to log power and min max, I see the noise floor and I see the spike going up to like 60, negative 60, negative 50 ish [&hellip;] Before I was looking at it on power with average, and average power was the thing that was like negative 60.&rdquo; (12:26)"],
  ["First sight of the radar, 9.407 GHz. Radar range set to 24 nm (long pulse)."],
  ["&minus;47.7 dBm at 100 kHz RBW. Sorin&rsquo;s &minus;80/&minus;70 dBm readings were on Spike&rsquo;s default Average detector and Power units, which read far below a pulse peak; Min/Max showed &minus;60 to &minus;50 dBm."])
t("3", "25 Oct", "12:20", "11.3 m (37 ft)", "Vivaldi facing the radar &rarr; manual attenuator 50 dB &rarr; 14 dB &rarr; SM200B", "whiteboard in, foam on",
  "about &minus;44 dBm (100 kHz RBW)", "Spike", "not worked out (100 kHz only)",
  ["&ldquo;it does show lp. I am turning the vivaldi to face now (10 seconds)&rdquo; (12:18)"],
  ["Spike, 100 kHz RBW, read from the grid."],
  ["Only a 100 kHz reading, which is 15&ndash;25 dB under the true pulse peak for a 0.68 &micro;s pulse."])
t("4", "25 Oct", "12:45&ndash;13:15", "11.3 m (37 ft)", "Vivaldi facing &rarr; manual attenuator 0 dB &rarr; 14 dB &rarr; SM200B", "whiteboard out, foam on",
  "&minus;21.5 dBm (Spike 3 MHz); &minus;20.5 dBm in Sorin&rsquo;s export; &minus;22 dBm I/Q", "Spike, Sorin, I/Q", "&asymp; &minus;7 dBm at the Vivaldi output",
  ["&ldquo;The whiteboard is out of the way, and I set the manual attenuator to 0 dB.&rdquo; (12:44)",
   "&ldquo;How much time is between each of the pulses? I see it on the spectrogram. I just don't see labels.&rdquo; (12:51)",
   "&ldquo;spike is closed, measure this all yourself.&rdquo; (12:57)",
   "&ldquo;Given that we're measuring about -20 dBm and that we have 14 dB of attenuation that's at that range, what is the actual power level that we are receiving from the furino to the Vivaldi?&rdquo; (13:06)",
   "Sorin&rsquo;s Spike exports: <code>data/Furino Characterization/14db8G_11meters_100khzrbw.csv</code> and <code>14db8G_11meters_3mhzrbw.csv</code>."],
  ["One setup, read three ways: Spike 100 kHz RBW &minus;40.7 dBm and 3 MHz RBW &minus;21.5 dBm (Claude, screenshots); Sorin&rsquo;s exports 100 kHz &minus;44.7 dBm at 9403.008 MHz and 3 MHz &minus;20.5 dBm at 9403.594 MHz; Claude&rsquo;s I/Q captures (6.25 and 50 MS/s) &minus;22 dBm."],
  ["Vivaldi output &asymp; &minus;21 + 14 = &minus;7 dBm (cable loss not included). EIRP through the foam (8 dBi Vivaldi assumed): &minus;6.5 &minus; 8 + 72.97 = +58.5 dBm.",
   "Pulse and timing from the I/Q captures: 680 ns at half power; rise 40 ns (20&ndash;120); carrier 9402.6 MHz; bandwidth 1.3 / 2.2 / 7.8 MHz at &minus;3 / &minus;10 / &minus;20 dB; 16 staggered spacings 1606.5&ndash;1706.5 &micro;s (mean 1655 &micro;s, 604 pulses/s); rotation 2.5885 s; second harmonic not seen. Leakage does not change these. Full plots further down this tab.",
   "Leak check was not done that day. With only 14 dB of pads the leak could be up to about 15 dB above the &minus;31 dBm seen with 29 dB (test 25b), so this power reading may include a few dB of leak."])
t("7", "25 Oct", "13:41", "11.3 m (37 ft)", "Vivaldi &rarr; 3 + 6 + 10 + 10 dB &rarr; SM200B", "whiteboard out, foam off",
  "&minus;20.3 dBm", "Spike", "&asymp; +8.7 dBm at the Vivaldi output",
  ["&ldquo;I'm removing the manual attenuator because that was useless.&rdquo; (13:27)",
   "&ldquo;I have 3 dB and then two 10 dB 8G attenuators going straight to the Vivaldi. [&hellip;] I put 12.15 volts and 4.5 amps right now into the Farino&rdquo; (13:38)",
   "&ldquo;Because I was worried, I made it 3 dB, then 6 dB, and then 2 10 dBs. I'm going to start transmitting now.&rdquo; (13:41) &ldquo;I turned on persistance&rdquo;"],
  ["Foam taken off the radar. 9.4078 GHz. Screenshot: <code>radar_test/spike_screens/step1_no_limiter_foam_off_29dB_pads_11m_rbw3MHz.jpg</code>."],
  ["Vivaldi output = &minus;20.3 + 29 = +8.7 dBm. EIRP (AI, 8 dBi Vivaldi assumed): +73.7 dBm.",
   "11 dB above the leak floor measured later at the same distance (test 25b, &minus;31.2 dBm), so mostly signal; the leak could add up to about 0.3 dB.",
   "Compared with test 4 (foam on, 14 dB): +15 dB more at the antenna with the foam off. Earlier pages called the foam worth 17 dB; with leak in both readings, &ldquo;about 15 dB&rdquo; is the safer figure."])
t("11", "25 Oct", "16:29", "11.3 m (37 ft)", "Vivaldi &rarr; 29 dB &rarr; SM200B", "whiteboard out, foam off",
  "&minus;29.4 dBm", "I/Q", "&asymp; &minus;0.4 dBm at the Vivaldi (unreliable)",
  ["&ldquo;right now I only have the vivaldi to the 10+10+3+6 db attenuators. Turning on the radar&rdquo; (16:24)"],
  ["Same wiring as test 7, three hours later."],
  ["9 dB below test 7 with nothing obviously changed. It sits at the leak floor (25b, &minus;31.2), so it is mostly leak. Cause of the drop not found: antenna or cable position is the likely reason."])
t("15", "25 Oct", "16:49", "3.96 m (13 ft)", "Vivaldi &rarr; 29 dB &rarr; SM200B (limiter removed)", "foam off",
  "&minus;25.9 dBm", "Spike", "not valid (below the leak)",
  ["&ldquo;so I should remove the limiter and just have the vivaldi into the attenuators, right?&rdquo; &ldquo;it is connected. Transmitting now. Spike is closed.&rdquo; (16:48)"],
  ["Limiter taken out of the test 13 wiring."],
  ["Lower than with the limiter in (test 13). A limiter cannot add power, so something other than the antenna dominated: this is what led to the load tests (16 onward)."])
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
