Sorin-Jayaweera/Panthalassa-Clinic-Team/phase_detector_calibration/site/content_pluto_night2.py

"""Pluto tab: second and third sets of overnight blocks. Filled from overnight_summary.json (passed in as N)."""
from content import table, ul, ol, p, h, math, fig, D


def n(v, d=2):
    if v is None or v != v:
        return D
    return f"{v:.{d}f}".replace("-", "&minus;")


def learned_rows(N):
    rows = []
    if "leak" in N:
        rows.append(["LO leakage at low levels", "The LO leakage is about &minus;60 dBm at 0 and 10 dB attenuation whatever the tone scale, &minus;68 dBm at 20 dB, &minus;78 dBm at 30 and 40 dB, then falls 1 dB per dB. "
                     "With a small tone scale it is close to the tone: at 0 dB attenuation and scale 0.02 the tone is &minus;28 dBm and the LO leakage only 31 dB under it.",
                     "To get a low level, raise the attenuation and keep the tone scale at 0.2 to 0.5. Do not use a small tone scale at low attenuation."])
    if "if_band" in N:
        b = N["if_band"]
        rows.append(["IF band table", f"1000 to 1200 MHz in 1 MHz steps, attenuation 0 to 40 dB in 2 dB steps ({b['n']} readings). At 0 dB the output is {n(b['att0'][0])} to {n(b['att0'][1])} dBm. "
                     f"It changes by at most {n(b['largest_change_per_mhz'])} dB from one MHz to the next.",
                     "Use <code>pluto_if_band_table.csv</code> to turn a setting into dBm for any IF-band test."])
    if "tune" in N:
        rows.append(["Tuning step", "A request for 5 Hz more moves the tone by about 5 to 7 Hz; 1 kHz more moves it 1001 Hz. During the test the tone was also drifting by 2 to 8 Hz per second.",
                     "Frequency can be set to a few Hz. Drift, not step size, limits how well the frequency is known."])
    if "close_in" in N:
        rows.append(["Noise close to the tone", "30 to 45 kHz from the tone the noise is about &minus;96 dBc/Hz, and 300 to 450 kHz away about &minus;107 dBc/Hz. One pair of lines 1.4 kHz either side of the 1000 MHz tone, 59 dB under it; none at 1100 or 1200 MHz.",
                     "This is near what the spectrum analyzer itself contributes, so the Pluto is at least this good. It is not a limit for the planned tests."])
    if "pulse_peak" in N:
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
