Sorin-Jayaweera/Panthalassa-Clinic-Team/(commit log)

2026-10-13 JACON bench tests, data, scripts and engineering notes site
    Phase detector and VCO calibration, VCO step response, LO buffer amp test,
    Pluto TX characterisation (in progress), instrument drivers, simulations,
    documentation, and the engineering notes website (source in
    phase_detector_calibration/site, built copy in docs/ for GitHub Pages).
2026-10-13 Pluto first run complete: tab on the site, calibration table, LO buffer compression corrected; overnight run started
2026-10-15 Look up tables: name every quantity and unit on the plots and tables; mixer table sorted by voltage with slope in MHz/mV
2026-10-25 Radar: power and timing tables (CSV) on the Radar tab
2026-10-25 Add clinic files outside the repo: Furuno characterization CSVs, phase detector and VCO test CSVs, foam enclosure CAD, MATLAB plot script, colloquium presentation, racon draft drawing
2026-10-25 Radar: foam-off reading (-20.3 dBm through 29 dB) added to the power table; Spike screenshot saved
2026-10-27 Radar tab: power readings by test (load vs antenna, by chain, Sorin's numbers + hidden AI analysis); new Limiter tab (HLM-20PSM); LNA over-the-air results; test log times fixed
2026-10-27 ADF5355: register calculator (port of ADI no-OS driver) and notes on the AliExpress box
2026-10-27 ADF5355 box: power-up spectrum on the SM200B, serial format probe (no response)
2026-10-27 Envelope detector and comparator tabs: ADL5511 CW curve at 1.1 GHz, ADCMP604 specs and plan
    - New Envelope detector tab: specs (ADL5511 datasheet Rev. E), expected levels in the
    JACON (-27 to +14 dBm at the detector), test plan, results of 26 Oct: VENV gain
    1.47-1.51 V/V at 1.1 GHz, floor -30 dBm, VENV and VRMS agree, comparator threshold
    lookup, warm-up drift. Pluto level through the detector (0.0 dBm at tone scale 0.7,
    Soapy) marked under question against the Pluto tab.
    - New Comparator tab: the board on hand is the ADCMP604 (LVDS, no hysteresis), not the
    ADCMP600 in the drawing; specs, expected behavior, test plan.
    - Schematic: envelope detector partial, comparator ADCMP604 on h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
2026-10-31 VNA: 3 dB pad remeasured with better cable, 3.6-3.9 dB at 9.4 GHz
2026-10-31 LO chain: 8.3 GHz through buffer, splitter shows 22 dB excess loss
2026-10-31 LO chain: ZX10-2-1252-S+ reads 20.4 dB below no-splitter level
2026-10-31 LO chain: buffer was off in low readings; splitter drop is 5 dB with it on
2026-10-31 Record test 30b: same chain at ref -20
2026-10-31 Record test 32: load on limiter reads above the antenna, so leak
2026-10-31 Correct test 34: no PLL or mixer in the chain
2026-10-31 Record test 39b: SSA3021X retake with traces and screens
2026-10-31 Correct detector drive for the resistive splitter; add P103LN plan
2026-11-01 Record test 41: phase detector calibration with the Pluto, 1.0 to 1.2 GHz
2026-11-01 Note hand-held antenna in test 45
2026-11-01 Record test 47: detector voltage over the Pluto range to 2890 MHz
2026-11-02 Add power and frequency map, first level
2026-11-02 Update power and frequency map
2026-11-02 Power map as one curve per level
2026-11-02 Power and frequency map finished on the P103 chain
2026-11-02 Record tests 48 to 50: power dependence and the four P162 chain
2026-11-02 Add top power levels and repeatability of the four amp chain
2026-11-02 Add zoom of the four amp power curves from the 890 MHz minimum
2026-11-02 Show part test status, add look up tables with wiring, remove instrument nicknames
2026-11-02 Envelope detector 1 Nov: band edges, pulse response, ripple source, CGR-201 input accuracy
    - Envelope detector tab: ADL5511 flat across 1.0/1.1/1.2 GHz within 0.1 dB (ratio of its
    two outputs); pulse height at 10 and 100 us equals CW within 1-3 %, every pulse seen;
    VENV ripple is a 400 kHz line from the Pluto (4 x the tone offset), and the 10 us
    shortfall is the Pluto's ripple and filter ringing, not the detector. Three new plots.
    - Flagged: CGR-201 input B (VRMS) absolute accuracy (1.4-1.7 % low, offset drifting a few
    mV; rises used); the -3f spur mechanism still marked unverified.
    - A different Pluto unit was used on 1 Nov (0.4 dB lower at 1.1 GHz): calibration is per
    unit; the 2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
2026-11-02 Add 1 MHz sweeps at six levels and wiring on the older Pluto and radar plots
2026-11-03 Radar tab: time signal of every pulse in a beam pass, stacked, with raw samples
2026-11-03 Radar tab: every raw I/Q sample, unprocessed
2026-11-06 Look up tables: frequency error from power uncertainty, -40 to -33 dBm
